henriharmaala1-source/Assembly-grapher/airframe/README.md

# Kipinä 485: twin-boom micro FPV pusher

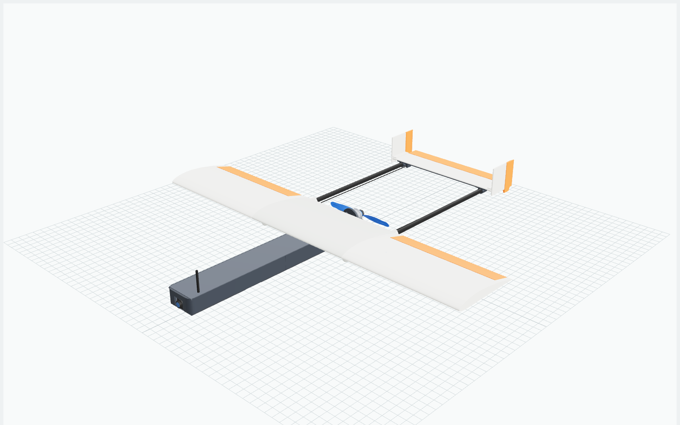
[picture p1: airframe/preview/hero.png]
Kipinä 485


A 3D-printed twin-boom pusher. A short pod carries the FPV camera in its nose,
the flight controller, battery and ESC behind it, and the motor on its back
wall. Two plain round carbon tubes, 140 mm apart, run from sockets under the
wing centre back to an H-tail, and the 4" prop turns between them. The camera
therefore has a clear view ahead, with no prop disc in front of it. It is a
hobby FPV airframe only. There is no payload bay or release mechanism, just a
pod for the flight battery and the FPV electronics.

The plane started as a Molniya-style twin-tube tractor, with the two tubes
40 mm apart under the pod and the motor on the nose. That put the camera
behind the prop. The tubes are now spread into tail booms far enough apart for
the prop to turn between them. See [Why a pusher](#why-a-pusher).

Four **SG90** servos give full three-axis control: one per aileron, one for the
elevator and one for the twin rudders. The brief was "as small as possible",
so the size comes from a sweep, not a guess. See [Why 485 mm](#why-485-mm).

| | |
|---|---|
| Wingspan | 485 mm, chord 97 mm, NACA 4412 at 2° incidence |
| Length | 504 mm (nose to elevator trailing edge) |
| Tail booms | 2 × carbon tube 6×5 mm, 298 mm long, 140 mm apart |
| Prop clearance | 16.2 mm from the blade tips to each boom, 10.7 mm to each pushrod |
| Controls | ailerons, elevator, twin rudders: 4 × SG90 |
| Flight controller, ESC | Matek F405-WMN (12 outputs, 2–6S), Hobbywing XRotor Micro 30A (2–4S) |
| All-up weight | ~223 g (printed parts ~98 g) |
| Wing loading | 47 g/dm² |
| Stall / cruise | ~8.9 / ~13 m/s |
| Top speed | ~19 m/s (69 km/h) level, estimated; prop pitch speed 86 km/h |
| Endurance | ~10 min on 2S 450 mAh (rough estimate) |
| CG | 199.6 mm behind the nose = 27.2 mm behind the wing LE (28 % chord) |
| Static margin | ~13 % (neutral point at ~41 % chord) |
| Printer | every part fits a Bambu Lab A1 mini (180 × 180 × 180 mm) |

All numbers are first-order estimates from `design.py` and the CAD volumes.
Nothing here has been flight-tested yet. [REPORT.md](REPORT.md) has the full
mass breakdown, the print list, the sizing check and the interference check,
regenerated on every build.

| Prop between the booms | Pod, cut open |
|---|---|
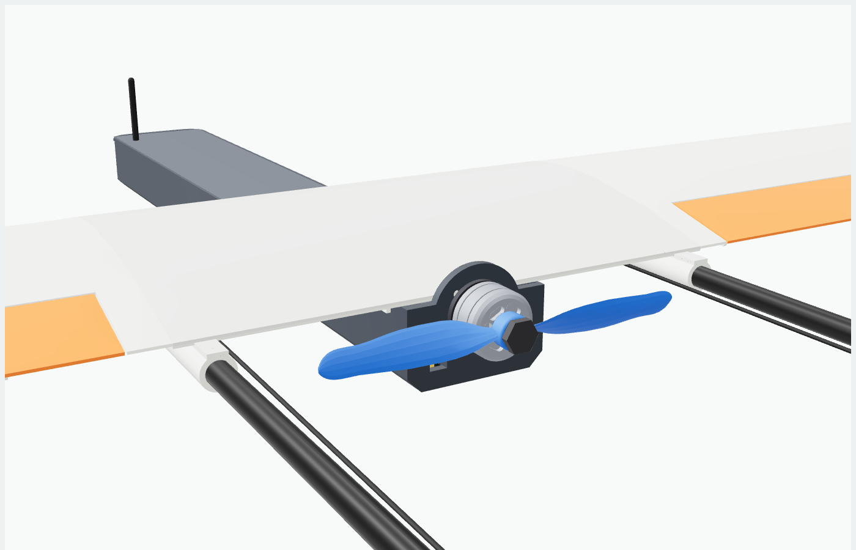
[picture p2: airframe/preview/prop.png]
Prop
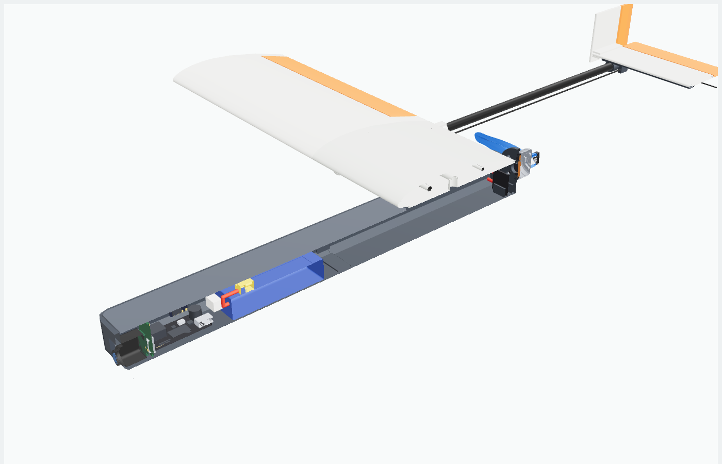
[picture p3: airframe/preview/pod.png]
Pod
|  |  |

| Rudder linkage, from below | Rounded nose with the camera |
|---|---|
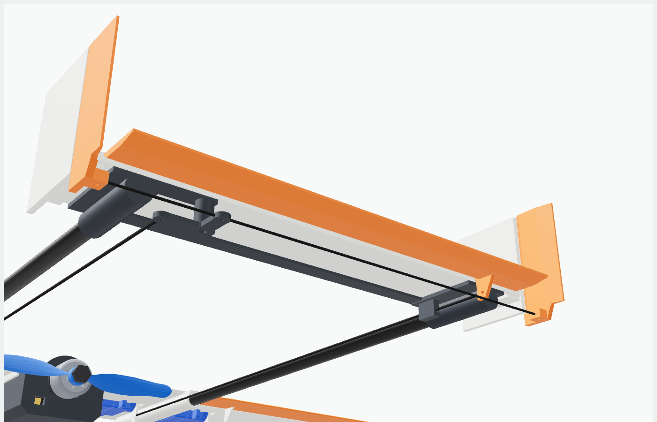
[picture p4: airframe/preview/tail.png]
Tail
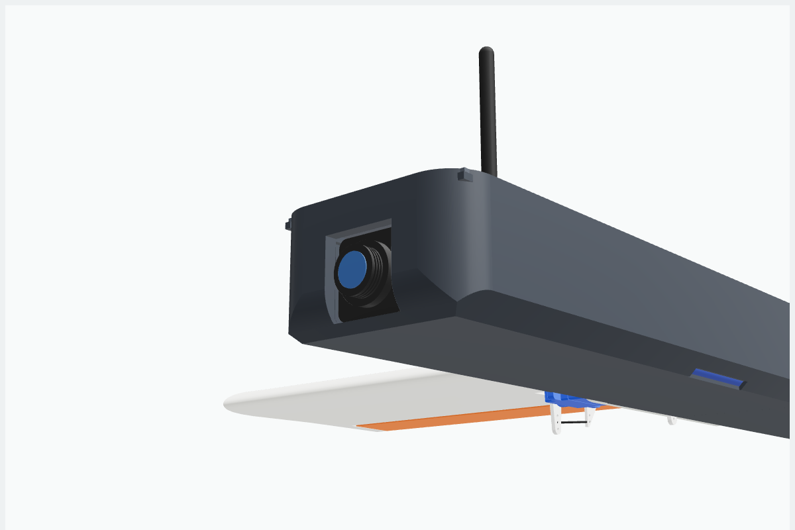
[picture p5: airframe/preview/nose.png]
Nose
|  |  |

| Front bay: camera, VTX, F405-WMN, receiver | ESC by the back wall |
|---|---|
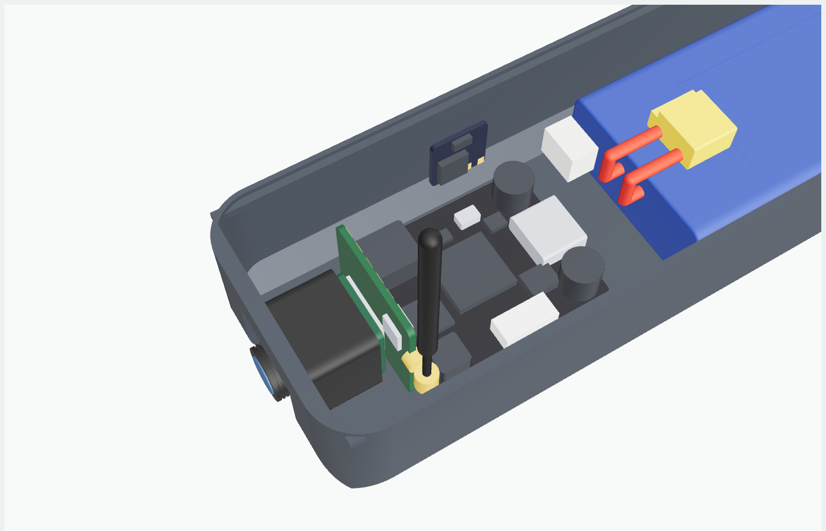
[picture p6: airframe/preview/bay.png]
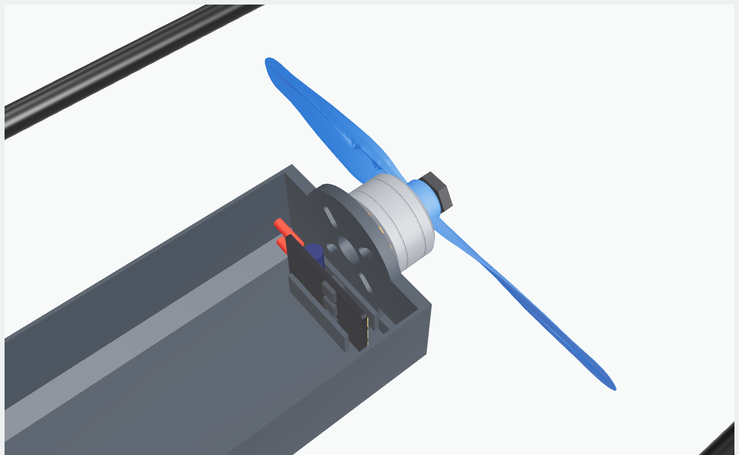
[picture p7: airframe/preview/esc.png]
|  |  |

| Aileron SG90 under the wing | |
|---|---|
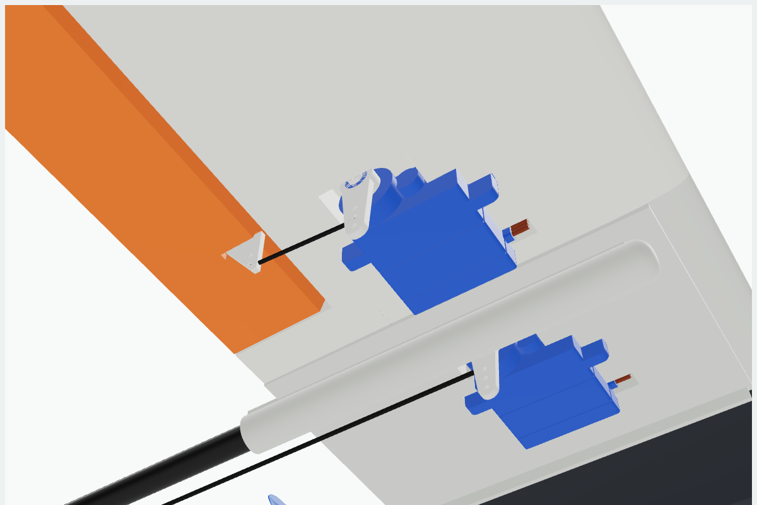
[picture p8: airframe/preview/servo.png]
Aileron servo
|  | |

## Why a pusher

In the tractor layout the camera sat 18 mm from the prop axis, well inside
the 101.6 mm prop disc, so a blade crossed the lens about 18 % of the time.
Moving the prop behind the pod fixes that. The catch is that the prop has to
turn somewhere: the old tubes were 40 mm apart, and a 4" prop is 101.6 mm
across.

So the tubes became tail booms:

- **Booms.** The booms start in two sockets under the wing centre and are
  140 mm apart (±70 mm). The blade tips pass 16.2 mm inside each boom.
- **Motor.** It is turned round and screwed to the pod's back wall, just
  behind the wing's trailing edge. The prop turns 18 mm behind the wing,
  on the boom centre-line.
- **Pushrods.** They run along the inside of the booms, 62 mm from the
  centre-line, 10.7 mm outside the blade tips. Tape them to the booms
  so they cannot bow into the disc.
- **Servos.** The elevator and rudder servos moved out of the pod into the
  wing centre, one on each side of the pod, with their horns on the pushrod
  lines.
- **Pod.** The pod no longer carries the tubes. It hangs under the wing
  centre, with the camera in its nose. The CG still has to sit at 28 % of the
  chord, and the motor now sits behind the wing, so the pod needs about
  170 mm of nose ahead of the wing. That makes it about 272 mm long,
  which is too long for the 180 mm bed. It prints in two halves joined by an
  8 mm tongue.

The cost is weight and span. The pusher is about 17 g heavier than
the tractor was (a longer pod, the boom sockets, a wider tail mount and longer
booms), and to stay under the 9 m/s stall limit the wing grew from 465 mm to
485 mm.

## Build process and DFMA

`process.py` turns the model into a **bill of process** ([BOP.md](BOP.md)) and a
**DFMA analysis** ([DFMA.md](DFMA.md)). The same data drives the viewer's
**Assemble** button and the video [preview/assembly.mp4](preview/assembly.mp4).

- **30 operations** in five groups:
  - 5 print jobs on the A1 mini;
  - 7 prep steps (cut carbon, make linkages, finish prints);
  - 16 assembly steps;
  - 2 setup steps.

  Each has its predecessors, tools, consumables and a time.
- **Print times are real slicer output.** They come from PrusaSlicer 2.7 on an
  A1-mini-like profile (`tools/a1mini.ini`): 8 h 38 min in total and
  97 g of filament. The wing centre takes 2 h 30 min and each wing panel
  1 h 24 min, because LW-PLA prints slowly.
- **Hand times are estimates.** They use Boothroyd–Dewhurst handling and
  insertion values plus shop times for gluing, soldering, taping and bending.
  Hands-on time is 1 h 46 min, including 32 min of INAV setup. Soldering is
  the biggest single item: the F405-WMN's servo, ESC and power connections are
  pads, so a full wiring pass is about 32 joints.
- **Schedule.** One builder works while one printer runs. That gives a lead
  time of **10 h 09 min**, and the critical path runs through the five
  prints in series.

| DFMA | |
|---|---|
| Parts and fasteners | 54 (theoretical minimum 26) |
| Manual assembly time | 42 min (7 min handling and insertion) |
| Design efficiency | 3% (19% counting handling and insertion only) |
| With the redesign suggestions | 46 parts, 32 min, 4% |
| Printability | no part needs support |
| Cost | about 170 EUR per airframe; the whole printed airframe is only 97 g of filament (about 4 EUR), but a first build also buys an LW-PLA and a PETG spool (about 65 EUR), so about 235 EUR up front |

Most of the assembly time goes into joints (solder, epoxy, CA, tape), not into
handling parts. The suggestions that save the most are:

- an FC with a built-in receiver;
- a camera with an integrated VTX;
- printed hinges;
- printing the tail as one piece.

DFMA.md lists each one with its trade-off.

## Why 485 mm

A printed plane does not scale down evenly. The electronics weigh the same at
any size, and a printed skin can't get thinner than one nozzle line. So as the
span drops, the wing loading and the stall speed climb.

`design.py` rebuilds the layout at each span, re-balances it (tail volumes, CG,
battery station) and estimates the weight. A span passes when:

- the stall speed is at most 9 m/s at CLmax 0.95, which keeps hand launches and
  FPV landings comfortable, and
- an SG90's 32.3 mm mounting tabs fit between the two wing spars. That needs a
  chord of at least about 80 mm.

| span | AUW | stall |
|---|---|---|
| 300 mm | 172 g | 12.7 m/s |
| 380 mm | 191 g | 10.6 m/s |
| 440 mm | 207 g | 9.5 m/s |
| 460 mm | 213 g | 9.2 m/s |
| **480 mm** | **219 g** (estimate) | **8.95 m/s (first to pass the quick estimate)** |
| 480 mm | 221 g (CAD) | 9.00 m/s (exactly on the limit) |
| **485 mm** | **223 g (CAD)** | **8.94 m/s (built)** |

The quick estimate is a couple of grams light. With the CAD weights, which
include the printed detail and the wiring, 480 mm lands exactly on the limit,
so the build takes the next 5 mm step, which keeps a little margin.

Yaw control costs about 11 g: a fourth SG90, two printed rudders and the
linkage. Without rudders (`Params.rudders = False`) the sweep lands at
460 mm. The four SG90s are the heaviest part of the kit after the
battery; a 4 g servo such as the Emax ES9051 would bring the span down, but it
needs new pockets. Change `Kit` and `Params` in `design.py` and rerun to try
other parts.

## Yaw control

Each fin carries a rudder aft of the elevator hinge line, about a third of
the fin area, hinged with tape on the outboard face.

- **Servo.** The rudder SG90 lies on its side in the wing centre, left of the
  pod, with its shaft pointing left. Its horn hangs below the wing, 62 mm left
  of the centre-line.
- **Pushrod.** A 1 mm carbon rod runs from the servo horn back along the
  inside of the left boom to the tail.
- **Bellcrank.** A printed 90° bellcrank pivots on an M2 screw under the tail
  mount, 49 mm left of the centre-line. The pushrod drives its outer arm, and
  its rear arm moves side to side.
- **Joiners.** Two 0.8 mm steel wires run from the bellcrank's rear arm to a
  horn tab under each rudder, below the fins and the tail mount, so both
  rudders always move together.

The elevator servo is the mirror image on the right. Its pushrod runs along
the inside of the right boom, through a guide on the tail mount, to the
printed elevator horn.

## Parts

### Printed (`stl/`, already in print orientation)

| file | material | on the bed, mm | orientation |
|---|---|---|---|
| `pod_front.stl` | PLA/PETG | 138 × 41 × 22 | Upright, open top up. 2 walls, 15 % infill |
| `pod_rear.stl` | PLA/PETG | 142 × 41 × 31 | Upright, open top up, tongue forward. 2 walls, 15 % infill |
| `lid.stl` | PLA/PETG | 177 × 39 × 1 | Flat |
| `wing_centre.stl` | LW-PLA | 105 × 22 × 155 | On its side. 0.5 mm walls, 5 % infill |
| `wing_R.stl`, `wing_L.stl` | LW-PLA | 97 × 12 × 165 | Standing on the root rib, brim. 1 wall, 0 % infill |
| `aileron_R.stl`, `aileron_L.stl` | LW-PLA | 24 × 148 × 7 | Flat. 1 wall, 0 % infill |
| `tail_mount.stl` | PLA/PETG | 31 × 156 × 9 | Pads face down |
| `stab.stl` | LW-PLA | 31 × 174 × 2 | Flat. 2 top / 2 bottom layers, 15 % infill |
| `elevator.stl` | LW-PLA | 17 × 163 × 10 | Top face down, horn up |
| `fin_R.stl`, `fin_L.stl` | LW-PLA | 30 × 39 × 9 | Outer face down |
| `rudder_R.stl`, `rudder_L.stl` | PLA/PETG | 17 × 44 × 6 | Outer face down, wire flange up |
| `bellcrank.stl` | PLA/PETG | 16 × 19 × 2 | Flat, solid |

Every wing piece is a printed NACA 4412 section: a closed one-wall LW-PLA shell
with the spar holes, servo pockets and hinge gap built in.

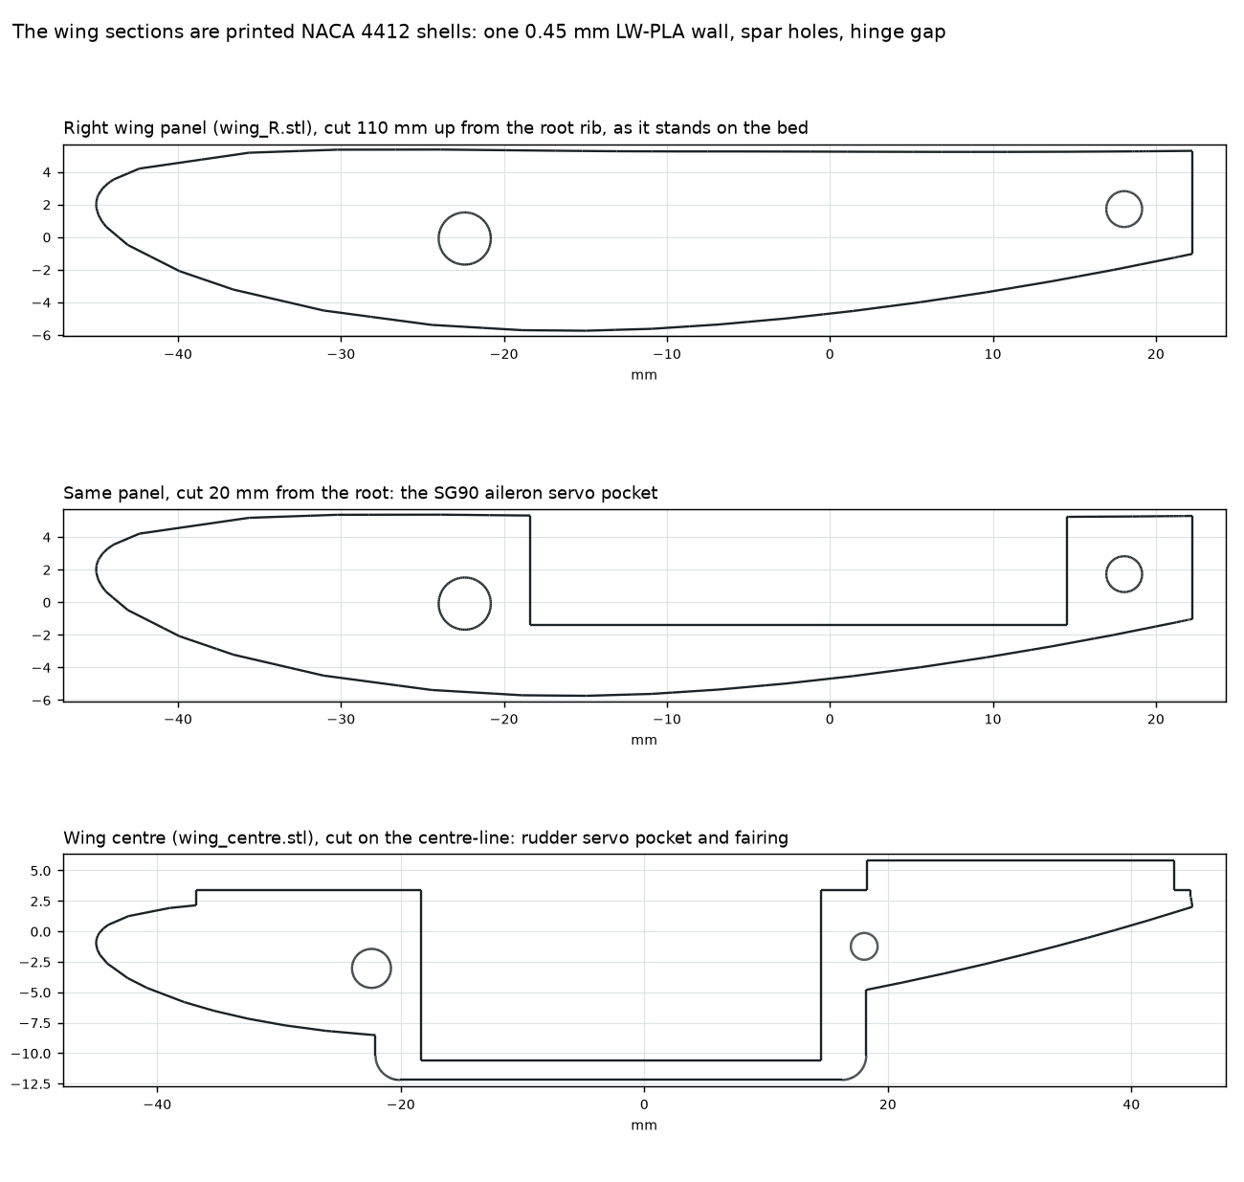
[picture p9: airframe/preview/wing_sections.png]
Wing sections cut from the STLs


The masses assume LW-PLA foamed to about 0.75 g/cm³. Plain PLA works, but it
adds roughly 25 g to the wing and tail. The pod, rudders and bellcrank are
plain PLA or PETG because they take the motor and linkage loads.

### Printing on a Bambu Lab A1 mini

Everything fits the A1 mini's 180 × 180 × 180 mm volume. `Params.bed` holds
the build volume, and the model adapts to it:

- the stabiliser's span is capped at the bed width, with its chord widened to
  keep the same area;
- the pod is split into two halves, each shorter than the bed.

Every build checks each part against the volume (see the print list in
REPORT.md).

Five plates cover the whole airframe:

| plate | parts | material |
|---|---|---|
| 1 | both pod halves, lid, tail mount, both rudders, bellcrank | PETG or PLA |
| 2 | wing centre, both fins | LW-PLA |
| 3 | stabiliser, elevator, both ailerons | LW-PLA |
| 4 | right wing panel | LW-PLA |
| 5 | left wing panel | LW-PLA |

Plates 1, 2 and 3 mix different wall and infill settings, so set them per
object in Bambu Studio.

- **Tall wing panels.** The A1 mini moves its bed front to back, which shakes
  tall, thin parts. Turn each panel so its chord runs front to back, add an
  8–10 mm brim, and print at reduced speed (Silent mode).
- **LW-PLA** is not a Bambu filament, so make a custom filament profile. A
  starting point: about 240 °C with the flow at 55–60 %, little or no
  retraction. Print a test cube, weigh it and adjust the flow until the density
  is near 0.75 g/cm³. The hotend reaches these temperatures without upgrades.
- **Plain PLA** prints with the stock profile if you want to skip LW-PLA for a
  first test airframe.

### Electronics

Everything below is modelled in `cad/airframe.step` (the `electronics` and
`hardware` groups) and in the CG calculation. The pod bays are sized for these
dimensions, so check sizes before substituting parts.

| part | spec | requirements | g |
|---|---|---|---|
| Servos | 4 × Tower Pro SG90: 4.8–6 V, ~1.8 kg·cm, 0.1 s/60° | 22.8 × 12.2 × 22.7 mm body, 32.3 mm across the tabs | 36 |
| Motor | 1404 outrunner, 3000–3800 KV | Rated for 2S; ≥ 223 g static thrust on a 4" prop (1:1). 9×9, 12 or 16 mm mounting | 9 |
| Prop | 4" two-blade, 2.4–2.5" pitch (Gemfan 4024 class) | Hub to match the motor shaft; see the pusher note below | 2 |
| ESC | **Hobbywing XRotor Micro 30A**: BLHeli_S, 2–4S, 30 A continuous / 40 A burst, no BEC | 23.8 × 14.5 × 5.8 mm, 20 AWG input wires, solder tabs for the motor. Full-throttle draw is about 8 A, so it runs at about a quarter of its rating | 6 |
| Flight controller | **Matek F405-WMN**, INAV or ArduPilot | 31 × 26 mm on four 2 mm holes, 22 × 22 mm pattern; the vendor quotes 16.5 mm height, which the pod reserves. 2–6S input, 12 outputs, 5 A servo BEC (5 or 6 V), 1.5 A logic BEC, 132 A current sensor, analog OSD, 5 UARTs, barometer, USB-C. Battery, servo and ESC connections are pads on the underside | 10 |
| Receiver | ExpressLRS 2.4 GHz nano | CRSF to an FC UART | 1.5 |
| Camera | analog nano, 14 mm (Caddx Ant / RunCam Nano class) | 14 × 14 mm body, ≤ 12 mm deep | 3.3 |
| VTX | 5.8 GHz analog, 25–200 mW | ≤ 20 × 19 × 3 mm, MMCX antenna socket; the F405-WMN has no 9 V supply, so it runs from the switched battery output (2S) or the 5 V BEC. Whip antenna coax through the lid | 4.2 |
| Battery | 2S 450 mAh LiPo, ≥ 30C, XT30 | ≤ 58 × 31 × 13 mm | 27 |

**Pusher prop.** The motor faces backwards, so the prop must still push air
aft. Either mount a normal prop with its lettered face towards the nose and
reverse the motor direction in the ESC (or swap two motor wires), or use the
reverse-rotation version of the same prop. Check on the bench, without the
prop first and then with it held down, that the air blows backwards. Use a
nyloc prop nut: a reversed motor can loosen a self-tightening one.

Some electrical numbers from the model (`design.py`), all first-order:

- **Cruise:** about 2.1 A, which gives about 10 minutes on the
  450 mAh pack with 20 % held in reserve.
- **Full throttle:** about 8 A at 1:1 thrust. That is about 18C from the pack
  and a quarter of the ESC's 30 A rating.
- **Servo supply:** four SG90s can together draw well over an amp when they
  stall or buzz. The F405-WMN's 5 A servo supply covers that; leave it at 5 V.

GPS is not included. An M10 module adds about 5 g, which raises the stall
speed by about 0.1 m/s, just past the sizing limit. That is fine once you know
the plane; otherwise build the wing 10 mm wider.

### Electronics that carry over to a bigger wing

The F405-WMN and the XRotor Micro 30A were picked so the same boards can move
to a larger plane later:

| | in this plane | in a bigger wing |
|---|---|---|
| Flight controller | motor + 4 servos, 2S | 12 outputs, 2–6S input, 5 A servo supply: room for 5 or 6 small servos, or 3 or 4 larger ones, plus GPS and a compass on the spare UARTs |
| ESC | about 8 A on 2S | 30 A continuous on 2–4S: fine for a motor that draws up to about 25 A |
| Limit | | The ESC stops at 4S. A 6S plane needs a bigger ESC, and the FC can stay |

### How detailed the bought-part models are

`components.py` builds every bought part as a recognisable solid, in its own
colour group so the viewer and the STEP file can show and move them
separately. The outer sizes come from datasheets or retailer listings. The
detail inside those envelopes is representative, not a copy of a drawing.

- **SG90:** case seams, a label recess, rounded mounting tabs with keyhole
  slots, a lead grommet with three wires, and a horn with a rounded tip and a
  centre screw.
- **Motor 1404:** a black base with the 9 × 9 mm screw holes, a copper 12-tooth
  stator visible in the gap, a chamfered bell with six vent slots and two
  grooves, the shaft and a hex prop nut.
- **Prop 4 × 2.5:** twisted, cambered blades lofted through ten stations. The
  pitch angle follows the local radius and the roots are narrow, so the blades
  clear the motor bell. In the pusher it is the mirror image of the tractor
  prop.
- **Camera:** rounded housing, threaded lens barrel with a glass disc, and a
  PCB with three pads.
- **VTX:** a 20 × 19 mm card with a shield on each side, a row of pads and an
  MMCX socket. The whip's gold plug clips on the socket and its coax passes
  through a 2 mm hole in the lid.
- **Matek F405-WMN:** the F405, IMU, barometer, OSD chip and flash, two BEC
  inductors, two capacitors, a USB-C socket, the DFU button, a JST-SH port and
  the pads on the underside. The vendor's 16.5 mm height is kept as a clearance
  envelope for the interference check; the modelled parts are lower.
- **XRotor Micro 30A:** MOSFETs on both sides, a low-profile capacitor lying
  across the top, battery and motor pads and two short red and black input
  wires. The card stands on edge between two printed ribs.
- **Battery:** a label recess, red and black leads that fold over the top to a
  keyed XT30 with pin holes, and a JST-XH balance plug.

### Also needed

| item | spec | g |
|---|---|---|
| Tail booms | 2 × carbon tube 6×5 mm, cut to 298 mm (6×0.5 aluminium also fits, heavier) | 8.0 |
| Wing spars | carbon rod 3 mm and 2 mm, 475 mm each | 7.5 |
| Pushrods | 2 × 1 mm carbon rod (~265 mm) with wire Z-bend ends: elevator and rudder | 1 |
| Wire | 0.8 mm steel: 2 aileron links, 2 rudder joiners | ~1 |
| Small parts | 2 micro control horns, M2 screws (4 for the motor, 4 for the FC, one for the bellcrank), hinge tape, 10 mm velcro strap | ~2 |

## Assembly

1. **Check the fits.** Boom holes are 6.2 mm and spar holes 3.2/2.2 mm for
   glued joints. Ream any tight hole with a drill bit by hand.
2. **Glue the pod halves.** Slide the rear half's U-shaped tongue 8 mm into
   the front half, check that the floor and top edges line up, and glue with
   CA.
3. **Fit out the pod.**
   - Screw the motor to the back wall with M2 screws from inside the pod. The
     slots take 9×9 mm, 12 mm and 16 mm patterns. The motor wires go straight
     through the slot beside the shaft, so the stock wire length is enough.
   - Glue the camera behind the window in the nose and stand the VTX board
     right behind it. The whip antenna goes up through the hole in the lid.
   - Solder the FC's wires first: its battery, servo and ESC connections are
     pads on the underside. Then screw it to the four posts (22 × 22 mm hole
     pattern, M2 self-tapping screws) with its long edge along the pod. Stick
     the receiver to the right wall, about 3 mm above the floor so it clears
     the belly chamfer.
   - Drop the ESC into the two ribs in front of the back wall, on edge across
     the pod, with its motor tabs to the left and its battery wires to the
     right.
4. **Fit the elevator and rudder SG90s** in the wing centre before it goes on
   the pod.
   - Press each one into its pocket from below: tabs between the spars, shaft
     pointing outboard, the elevator servo on the right and the rudder servo
     on the left.
   - Point each horn straight down, below the wing. The horns are used full
     length; hook the pushrod into the hole about 8 mm from the shaft, which
     keeps the pushrod level with the booms.
5. **Join the frame.** Glue the pod under the wing centre between the two
   locating rails. Push the booms into their sockets from behind until they
   bottom out, and glue everything with epoxy or thick CA.
6. **Build the wing.**
   - Slide the 3 mm and 2 mm rods through the centre section and glue both
     panels on.
   - Each aileron SG90 lies on its side in the pocket under its panel: tabs
     between the spars, shaft pointing at the tip, horn hanging down. About
     3 mm of the servo stands proud of the lower surface.
   - All servo leads run through the wire channel and down into the pod.
7. **Hinge and link the ailerons.**
   - Tape the hinge along the top surface. The bevel under the hinge line gives
     about 25° of up travel.
   - Glue a micro control horn into the slot under each aileron.
   - Link it to the servo horn (11.5 mm hole) with 0.8 mm Z-bend wire.
8. **Build the tail.**
   - Glue the stabiliser onto the tail mount and push the fins' jaws onto the
     stabiliser tips.
   - Hinge the elevator with tape on top.
   - Hinge each rudder to the back of its fin with tape on the outboard face.
     The horn tab goes at the bottom.
   - Screw the bellcrank loosely under the tail mount with an M2 screw, so it
     turns freely.
   - Push the tail mount onto the boom ends. Sight from behind to get it square
     to the wing, then glue.
9. **Fit the pushrods.**
   - Elevator: from the right servo horn, along the inside of the right boom
     and through the tail mount guide, to the printed elevator horn.
   - Rudder: from the left servo horn, along the inside of the left boom, to
     the bellcrank's outer arm.
   - Tape each pushrod loosely to its boom in two places, as a guide. They
     pass only 10.7 mm outside the prop disc and must not bow into it.
   - Bend both joiner wires with an L at each end. Drop one end into the
     bellcrank's rear arm and the other into the flange under each rudder, and
     adjust them so both rudders sit straight with the servo centred.
10. **Balance.** Strap the battery through the floor slots and slide it until
    the plane balances 27.2 mm behind the wing LE (199.6 mm from the nose).
    The nominal battery centre is 91 mm from the nose, and the travel is
    83–99 mm. The XT30 folds back over the top of the pack.

The hatch lid sits flush on two ledges and runs from the nose to just under
the wing's leading edge. Hook its back edge under the wing, press the front
down, and hold it with tape or two 3 mm magnets.

## First flights

- **Throws:** ailerons ±12°, elevator ±15°, rudders ±20° (set with the servo
  endpoints), 30 % expo.
- **INAV setup:** use the Airplane mixer with a rudder output, and fly angle
  mode for the first launch. Set the motor direction as described in the
  pusher note above.
- **Launch:** the prop is behind your hand. Hold the pod ahead of the wing
  from below, keep your fingers well forward of the trailing edge, and throw
  firmly and level at about 70 % throttle. A launch glove is a good idea.
- **Landing:** the prop disc reaches about 33 mm below the pod's belly. Cut the
  throttle before touchdown and land on grass, or use a prop saver.
- **Rudder:** use it to coordinate turns and hold heading in crosswinds. Check
  the rudder direction on the bench, and reverse the servo in INAV if needed.

## Regenerating

```sh
pip install cadquery trimesh
python3 airframe/design.py      # sizing sweep and layout, no CAD needed
python3 airframe/build.py       # STLs, STEP, GLB, REPORT.md, sizing + interference checks
python3 airframe/build.py --variant optimized   # the optimized variant in variants/optimized/ (--step for its STEP)
python3 airframe/build.py --variant single-boom # the single-boom variant in variants/single-boom/
python3 aero/extreme.py                         # the extreme-aero design study (aero/study/EXTREME.md)
python3 airframe/build.py --variant extreme     # what it picks, in variants/extreme/
python3 airframe/mini.py                        # the 1:2 desk model of the single boom, in variants/single-boom-mini/

python3 airframe/process.py     # BOP.md, DFMA.md, viewer/process.json (slices with prusa-slicer if installed)
python3 airframe/process.py --variant single-boom   # the same for variants/single-boom/
python3 airframe/tools/make_single_viewer.py         # variants/single-boom/viewer/index.html from the twin's page
python3 airframe/tools/make_single_viewer.py --variant extreme   # and variants/extreme/viewer/index.html

# optional: PNG previews and the assembly video from the three.js viewer (headless Chromium)
npm install three@0.169.0 playwright
node airframe/tools/render.mjs
node airframe/tools/render.mjs --video --ffmpeg /path/to/ffmpeg
node airframe/tools/render.mjs --variant single-boom [--video]   # into variants/single-boom/preview/
node airframe/tools/render.mjs --variant extreme                  # into variants/extreme/preview/
node airframe/tools/render.mjs --variant single-boom-mini         # the desk model's previews
node airframe/tools/shoot-variants.mjs   # the comparison page's figures (after aero/variants.py)
```

The code is split into four files:

- `design.py` holds every dimension (`Params`), the electronics (`Kit`) and the
  SG90 datasheet dimensions (`Servo`).
- `build.py` makes the printed parts.
- `components.py` models the bought parts in detail (see above).
- `geom.py` holds the shared solid helpers.

Each build:

- moves the wing along the pod until the battery balances the plane in the
  middle of its travel, using the CAD masses,
- checks the stall speed with the CAD weight,
- checks every bought part against every other body for overlaps, and
- checks every printed part against the printer's build volume.

- `cad/airframe.step` is the full assembly in flight position, in three groups:
  `printed`, `hardware` and `electronics`. Open it in Fusion, FreeCAD or
  SolidWorks.
- `viewer/index.html` is an interactive 3D viewer. Serve the `viewer/` folder
  over HTTP, for example with `npx http-server airframe/viewer`.

The coordinates are millimetres. x runs aft from the pod's nose, y towards the
right wing tip and z up, with z = 0 on the boom centre-line.

## Drag

[`aero/`](../aero/README.md) has a simple air-resistance optimizer that runs on
this design (`python3 aero/optimize.py airframe`). With the span held at the
brief's smallest passing size, the rest of the sizing is pinned by the stall
limit, the SG90 tabs and the bed. It finds about 20 % less drag from small
changes to the details: a rounded top front edge on the pod, sleeves on the
rudder joiners, horn fairings, a tapered pod rear and a laid-back antenna.
See [aero/REPORT_airframe.md](../aero/REPORT_airframe.md).

The efficiency study (`python3 aero/efficiency.py`) goes further on the wing.
It reshapes the NACA 4412 with NeuralFoil for the plane's own lift and
Reynolds numbers, keeping the spars, the servo, the printable trailing edge
and the stall. That cuts the wing's profile drag by about 20 % at cruise.
Together with the detail changes, the flight time at 13 m/s rises from 13.3
to 16.9 min at the same weight. The charts are in
[aero/study/index.html](../aero/study/index.html) and the airfoil in
[aero/study/kipina-opt.dat](../aero/study/kipina-opt.dat).

## The optimized variant

`python3 airframe/build.py --variant optimized` builds the plane with the
study's airfoil and every detail change, into `variants/optimized/` (STLs,
GLB, REPORT.md). Each change is drawn as a part you can print:

| Change | In the CAD | Weight |
|---|---|---|
| Airfoil | kipina-opt (11.1 % thick) instead of the NACA 4412 (12.2 %). The spars, servos and hinge still fit | −1.1 g |
| Hood | an 8 mm radius on the pod's top front edge, over the camera. The lid starts behind it | −0.3 g |
| Tapered pod tail | the last 30 mm step in at 12° on the sides and 9° under the belly (the motor boss sets the belly). The ESC bay moves 30 mm forward | −1.1 g |
| Antenna | the VTX whip bent back 60° where it leaves the lid | 0 |
| Servo fairings | single-wall blisters over the four servo horns (cut short) and the aileron servo bumps. They print on the bed and glue on | +3.8 g |
| Joiner sleeves | streamlined sleeves glued on the two rudder joiner wires under the tail. They slide with the wire | +1.2 g |

The optimized plane weighs 225.8 g against 223.2 g. The ESC moves forward
and the fairings sit behind the centre of gravity, so the balance puts the
wing 3 mm further aft. The build's interference check passes for both.

`python3 aero/variants.py` flies the planes at their CAD weights. The 2.6 g
cost 0.06 W at cruise, against the 2.56 W the aerodynamics save, and the
flight time at 13 m/s goes from 13.3 to 16.8 min. The stall stays under the
9 m/s limit. The page [variants/index.html](variants/index.html) shows any
two of the three builds side by side, with each change highlighted, next to
the weight and flight charts. Serve `airframe/` over HTTP and open
`/variants/index.html`. The numbers are in
[variants/COMPARE.md](variants/COMPARE.md).

Each picture has the as-built plane on the left and the optimized one on the
right:

| Three-quarter view | Side view |
|---|---|
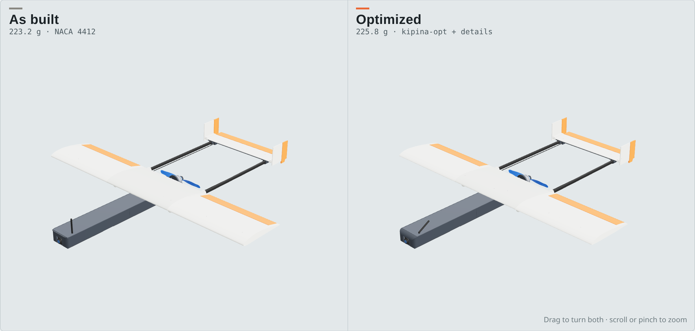
[picture p10: airframe/variants/figures/models.png]
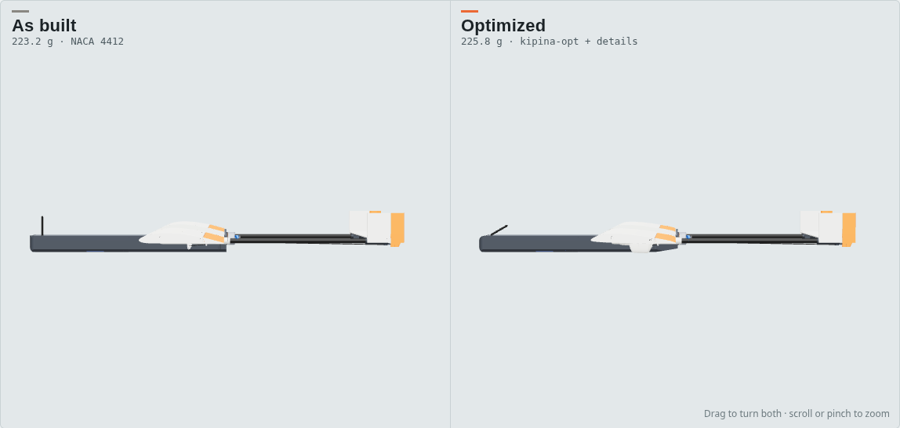
[picture p11: airframe/variants/figures/models-side.png]
Side view
|  |  |
| **Tapered pod tail** | **Servo fairings, from below** |
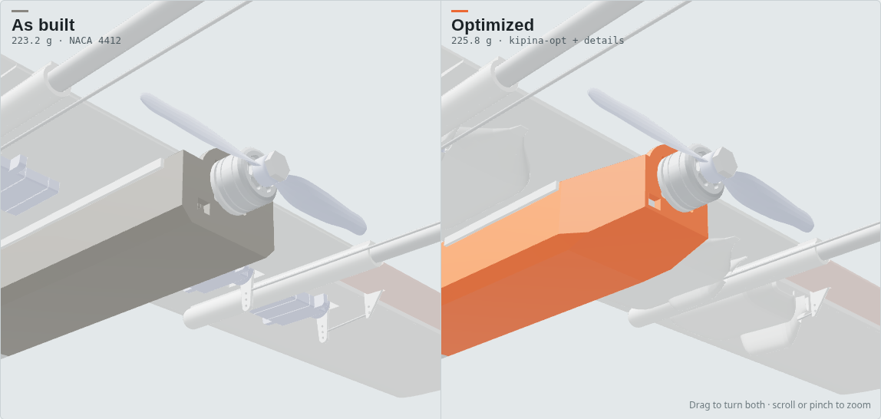
[picture p12: airframe/variants/figures/models-boattail.png]
Tapered tail
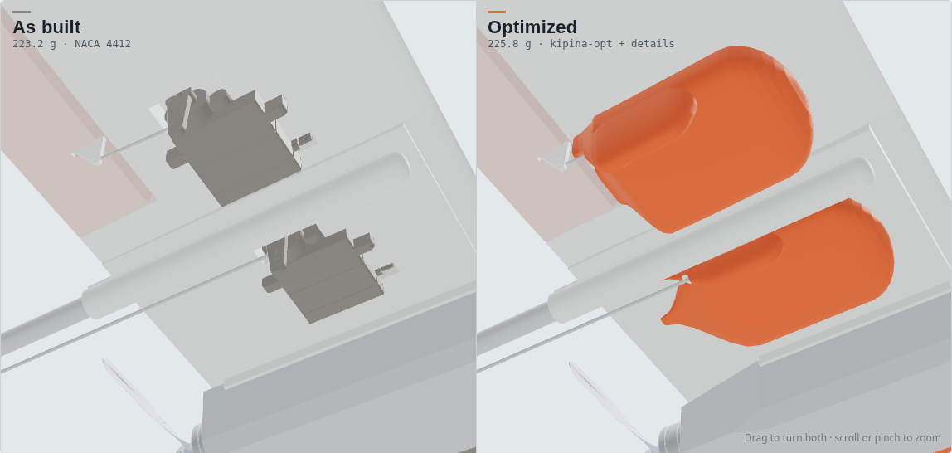
[picture p13: airframe/variants/figures/models-fairings.png]
Fairings
|  |  |

## The single-boom variant

`python3 airframe/build.py --variant single-boom` rebuilds the optimized plane
round one carbon tube, into `variants/single-boom/` (STLs, GLB, REPORT.md).
It keeps the optimized airfoil, the nose hood, the laid-back antenna and the
aileron servo fairings. Everything behind the battery changes:

| Change | In the CAD |
|---|---|
| One boom | a 10 x 9 mm roll-wrapped carbon tube, 320 mm long. It starts in the fuselage behind the servos and ends behind the tail. 79 mm of it sits in a socket along the fuselage's top |
| Fuselage | 38.4 mm wide, with a flat top and its top edges rounded to 8 mm. The section comes from `aero/section.py` (below). A 48 mm cone narrows the tail onto the boom; there is no blunt back wall |
| Lid | it wraps round the rounded edges. It covers the nose to the servo bay and is held by tape or two magnets |
| Servos | the elevator and rudder SG90s lie on their sides in the fuselage behind the battery, screwed to posts. Their pushrods run in PTFE sleeves inside the boom and leave it just ahead of the tail |
| Wing centre | no boom sockets and no servo pockets. It is 135 mm wide (the narrowest that still lets a panel stand on the bed); the panels are 10 mm longer each |
| Tail | one 79 mm fin with the area of both twin fins, in a socket on the tail mount. The stabiliser hangs on two wedge-nosed pylons, its top 11.7 mm under the boom's centre-line, so the elevator can swing 20 degrees up past the boom. No bellcrank, joiner wires or sleeves |
| Motor | on a printed cap at the boom's end, 3 mm behind the tail's trailing edge. A 16 degree cone runs from the boom up to the motor plate. The ESC lies flat under the boom's mouth and the motor wires run inside the boom |

The build's interference check passes, with every wire run modelled too (see [Wiring](#wiring)), and every part fits the A1 mini.

**The boom.** One tube carries the tail, the motor and the prop: 27 g on its
end, 246 mm from the socket. The aim was to keep the first bending mode near
the twin booms' (about 49 Hz with the tail alone) and far below the motor's
377 rev/s. The 10 x 9 mm tube does that for less weight than the two
booms it replaces (REPORT.md has the table):

| tube, mm | g | first bending mode | end bends in a 30 g landing |
|---|---|---|---|
| 8 x 7 | 5.9 | 32 Hz | 6.8 mm |
| **10 x 9** | **7.5** | **46 Hz** | **3.4 mm** |
| 10 x 8 | 14.1 | 59 Hz | 2.0 mm |
| 12 x 11 | 9.0 | 61 Hz | 1.9 mm |
| twin booms, 2 x 6 x 5 | 8.0 | about 49 Hz | |

Use roll-wrapped carbon. A pultruded tube is stiffer in bending, but weak in
twist (the fin and the prop's torque twist the boom) and it splits in a
crash. Running the tube on to the nose would add about 4 g and block the
battery and FC bays, so it stops behind the servos.

**The fuselage section.** `python3 aero/section.py` writes
[variants/single-boom/SECTION.md](variants/single-boom/SECTION.md). It finds the
smallest outline of each shape family that holds what goes inside: the
battery with its strap slots, the FC, both servos on their sides, the boom
socket and the ESC. Skin friction follows the perimeter:

| Outline | Perimeter | Frontal area | Flat top for the wing |
|---|---|---|---|
| Flat-topped box, top edges rounded | 114 mm | 8.7 cm² | 19 mm |
| Superellipse, n 4 | 120 mm (+6 %) | 10.7 cm² | 20 mm |
| Ellipse | 120 mm (+6 %) | 11.4 cm² | 7 mm |
| Circle | 122 mm (+8 %) | 11.9 cm² | 7 mm |

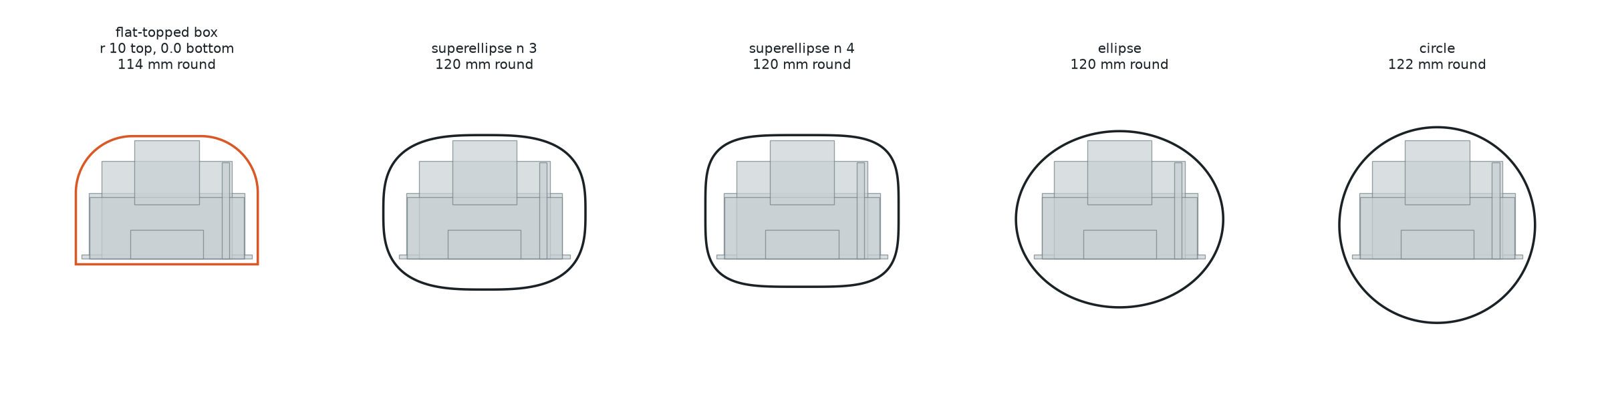
[picture p14: airframe/variants/single-boom/section.png]
Section outlines


Round is the worst fit, because the contents are flat boxes. The best
section rounds off the top corners, which the boom socket and the FC leave
empty. A square-cornered box would be as poor as round. The whole difference
is worth about 1 % of the plane's drag. The flat top also gives the wing a
seat without a saddle. In side view the tail cone matters more than the
section: it removes the blunt base.

**Weight.** 227.3 g against 225.8 g for the optimized twin-boom:

- **Heavier:** the fuselage and lid (+5.7 g), because they carry the boom socket and close their own top. The pushrods in their sleeves add 1.9 g, the motor wires the length of the boom 1.5 g, and the motor mount 2.5 g.
- **Lighter:** the wing centre (−5.5 g), the boom (−0.5 g) and the tail mount (−1.0 g). The fairings, sleeves, joiners and bellcrank that are no longer needed save another 3.8 g.

The motor moves 249 mm aft. The servos move 76 mm (elevator) and 41 mm
(rudder) forward. So the balance puts the wing 13 mm further aft than on the
optimized plane. The tail moves with
the wing, so the tail arm and the tail volumes stay the same.

**Flight.** From `aero/variants.py`, at 13 m/s:

| | Optimized | Single boom |
|---|---|---|
| Weight | 225.8 g | 227.3 g |
| Drag | 0.247 N | 0.232 N (−6.4 %) |
| Power | 9.53 W | 9.02 W |
| Flight time | 16.8 min | 17.7 min |
| Best glide ratio | 9.2 | 9.7 |
| Stall | 8.92 m/s | 8.95 m/s |

Three things account for nearly all the saving:

- no blunt pod base;
- one boom instead of two, with no boom sockets;
- no bellcrank, joiner wires or horns on the elevator and rudder servos.

The tail mount's pylons give some back. The extra 1.5 g costs 0.03 W.
The single boom could weigh 247 g before it needed the optimized plane's
power, but the 9 m/s stall limit stops it at 230 g first.

**What the numbers leave out:**
- **Launch:** the tail is no longer in the prop's slipstream, so the elevator
  and rudder have less grip at the start of a hand launch. Throw it a little
  harder and level.
- **Motor on the boom:** the motor and prop sit on the end of a 246 mm tube.
  Balance the prop well, and check the tail for buzz at full throttle.
- **Landing:** the prop reaches 33 mm below the belly, as on the twin booms,
  but at the tail it touches first in a nose-high landing. Cut the throttle,
  or use a folding prop.
- **Prop efficiency:** the prop works in cleaner air than behind the pod and
  wing. The model holds the efficiency the same, so this gain is not counted.

| Optimized (left) and single boom (right) | Side view |
|---|---|
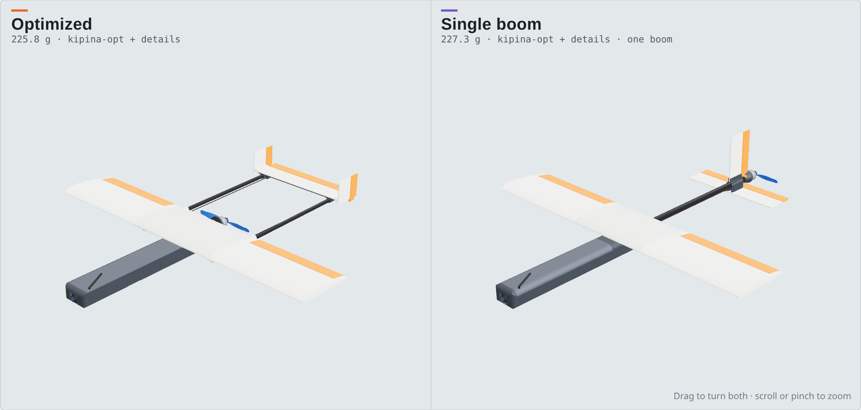
[picture p15: airframe/variants/figures/single-models.png]
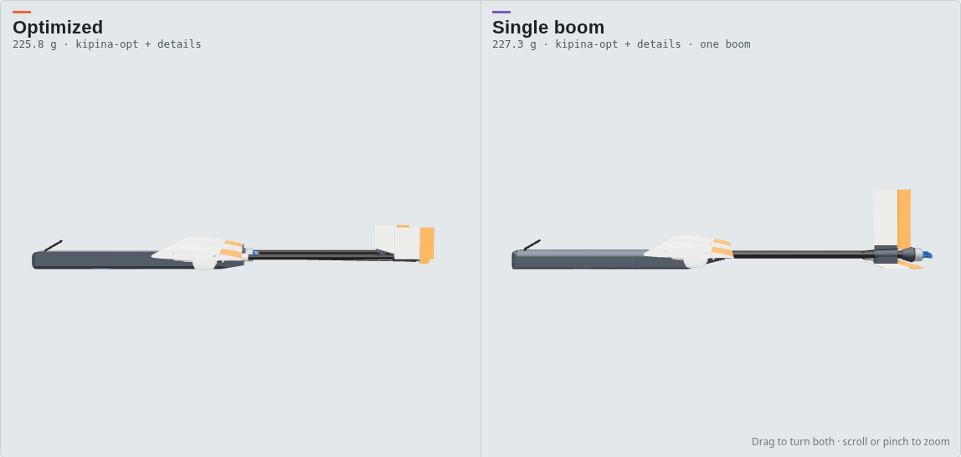
[picture p16: airframe/variants/figures/single-models-side.png]
Side view
|  |  |
| **Servos and pushrods inside, from above** | **The tail** |
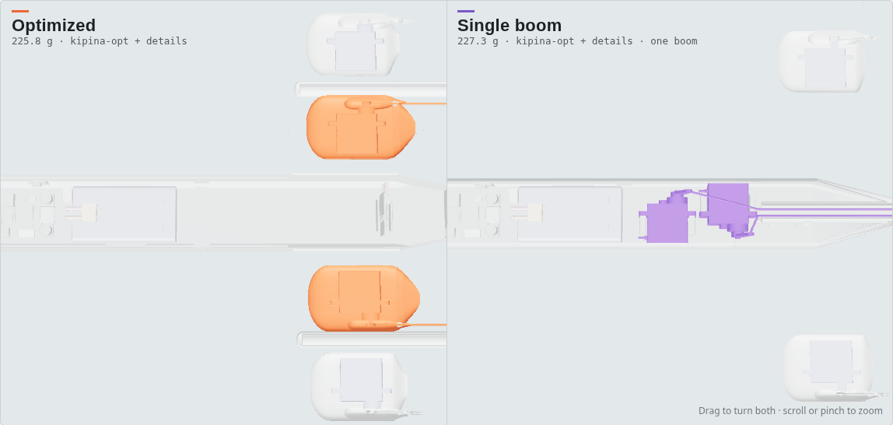
[picture p17: airframe/variants/figures/single-models-servos.png]
Servos
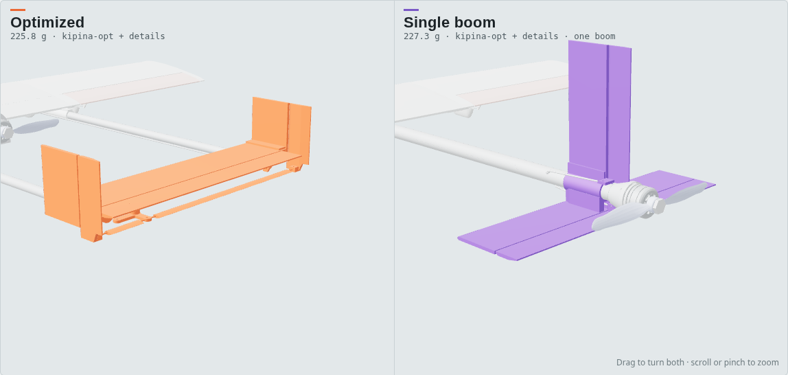
[picture p18: airframe/variants/figures/single-models-tail.png]
Tail
|  |  |

### Building the single boom

`python3 airframe/process.py --variant single-boom` writes its bill of process
([variants/single-boom/BOP.md](variants/single-boom/BOP.md)) and DFMA analysis
([variants/single-boom/DFMA.md](variants/single-boom/DFMA.md)). It slices every
part with the same PrusaSlicer profile as the twin. The operations are in
`process_single.py`. The viewer, [variants/single-boom/viewer/](variants/single-boom/viewer/index.html),
has the same **Assemble** button, and the video is
[variants/single-boom/preview/assembly.mp4](variants/single-boom/preview/assembly.mp4).

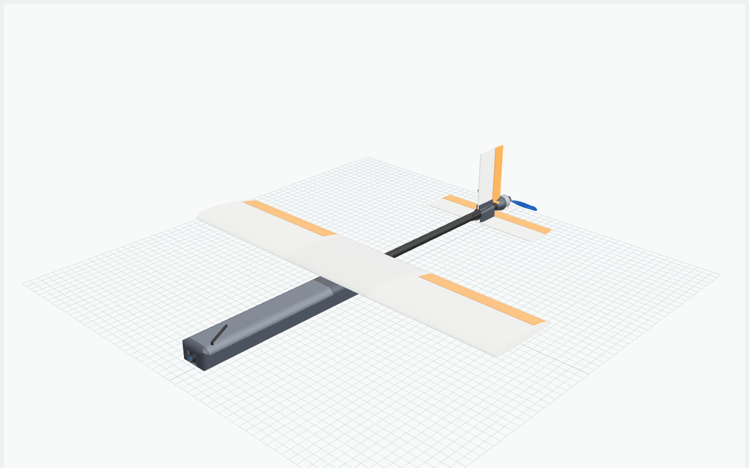
[picture p19: airframe/variants/single-boom/preview/hero.png]
Single boom


The build order changes behind the battery:

1. The tail servos screw to their posts in the fuselage before anything closes it in.
2. The tail is glued up off the plane: stabiliser under the pylons, fin in its
   socket, then the elevator and rudder hinged.
3. It slides onto the boom and is squared and glued. The boom was already
   drilled for the pushrod exits and threaded with the two PTFE sleeves and
   the motor wires.
4. The motor cap goes on the boom's end, with the motor on the cap.
5. The whole boom slides into the fuselage socket and is squared to it, and
   the pushrods go in through their sleeves.
6. The wing is built separately and glued onto the fuselage's flat top.

| | Twin boom | Single boom |
|---|---|---|
| Parts and fasteners | 54 (minimum 26) | 50 (minimum 23) |
| Manual assembly time | 42 min | 48 min |
| Design efficiency | 3 % | 2.4 % |
| Printing | 8 h 38 min, 97 g | 9 h 53 min, 100 g |
| Hands-on | 1 h 46 min | 2 h 01 min |
| Epoxy cure waits | 45 min | 1 h 15 min |
| Lead time | 10 h 09 min | 11 h 26 min |
| Cost per airframe | about 170 EUR | about 177 EUR |

- **Fewer parts, more joints.** The single boom drops the bellcrank, the
  joiner wires, one boom and a fin. But it adds five epoxy joints: the tail on
  the boom, the motor cap, the boom in the fuselage, the wing panels and the
  wing on the fuselage. It also adds boom preparation (exit holes, sleeves,
  motor wires).
- **Lead time.** The prints still set it: the five plates run in series, and
  the standing fuselage rear makes plate 1 longer (1 h 29 min on its own). The
  critical path ends in the wing, which can only go on once the last panel has
  printed.
- **Two parts need support.** The lid and the aileron servo fairings each have
  a 32 mm overhang. The lid's lips wrap round the fuselage's rounded top edges;
  the fairing closes a shallow dome. The twin boom has neither problem. A
  flatter lid lip, and a fairing printed into the wing panel (one of the
  redesign suggestions), would remove both.
- **Redesign suggestions** (DFMA.md has each one's trade-off):
  - print the tail mount, fin and motor cap as one PETG part;
  - print the servo fairings into the wing panels;
  - key the boom so the tail squares itself.

  Together with the twin's suggestions (printed horns, an FC with a built-in
  receiver, a camera with an integrated VTX, printed hinges), they bring it to
  42 parts.

### Wiring

Every wire run in the single boom is modelled as a body along its route:
- both aileron leads;
- the elevator and rudder servo leads;
- the motor wires;
- the ESC's battery wires.

The build's interference check covers these runs like any other part, so a
route that's blocked shows up as an overlap. The only contacts allowed are a
wire at its own two ends, and wires against wires, since they bundle. The
check passes, and REPORT.md lists each run's length:

| Run | Route | Length | Note |
|---|---|---:|---|
| Aileron leads | out of the servo into the pocket's lead slot, inboard through the panel and the wing centre, down beside the boom socket into the fuselage's open top, forward over the servos and battery to the FC | 263 mm | needs about 303 mm with slack: **extend each SG90 lead by about 55 mm** |
| Elevator, rudder leads | up from the servo, forward over the battery to the FC | 128, 162 mm | the SG90's 250 mm lead is enough |
| Motor wires | from the ESC's motor tabs up through a 3.2 mm hole under the boom, along the upper right of the bore (clear of both pushrod exits), out through the motor cap's slot | 328 mm | three silicone wires, about 370 mm each |
| ESC power | aft past the ESC, up beside the boom socket, forward over the servos to the battery's XT30 | 165 mm | |

Getting the runs through needed three changes to the CAD:
- **Aileron lead channel.** It now runs at the servo pocket's lead slot,
  where the SG90's lead leaves the case. Before, it ran at 45 % chord, where
  the servo itself was in the way.
- **Lead drop holes.** They now go down each side of the boom socket, into
  the fuselage's open top. The old single hole landed on the closed top of the
  tail cone, on the boom's axis.
- **Motor-wire entry.** There's a new hole through the bottom of the boom
  socket and the tube, right over the ESC's motor tabs. Before, the wires'
  only way into the boom was a 2 mm gap between the rudder servo's tabs and
  the socket.

The servo plugs come off: the F405-WMN has solder pads. The bill of process now
has a step for extending the aileron leads (F4). It also solders the aileron
leads only once the wing is on (A16), and drills the boom's third hole in F3.

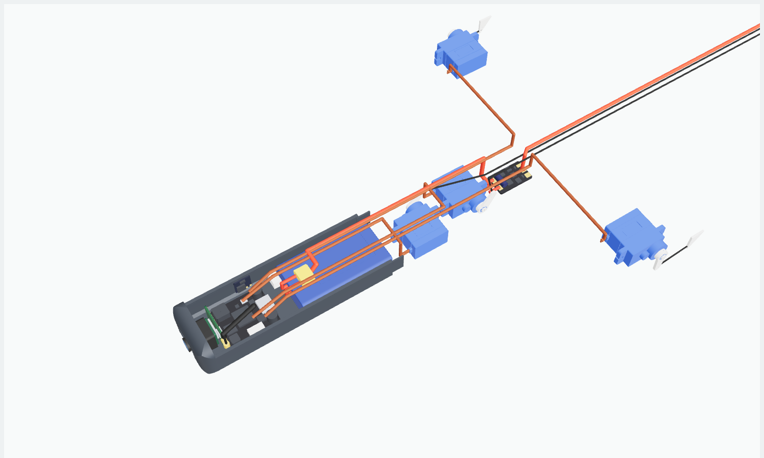
[picture p20: airframe/variants/single-boom/preview/wiring.png]
Wiring


| Fuselage, cut open | Tail servos, lid off | ESC under the boom's mouth |
|---|---|---|
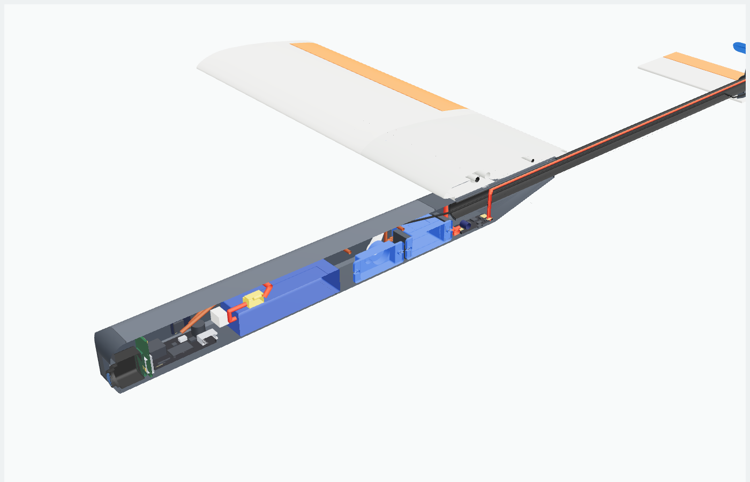
[picture p21: airframe/variants/single-boom/preview/fuselage.png]
Fuselage
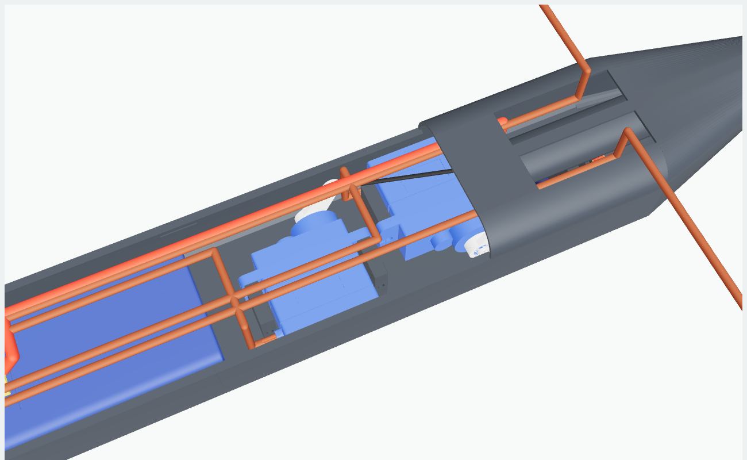
[picture p22: airframe/variants/single-boom/preview/servos.png]
Servos
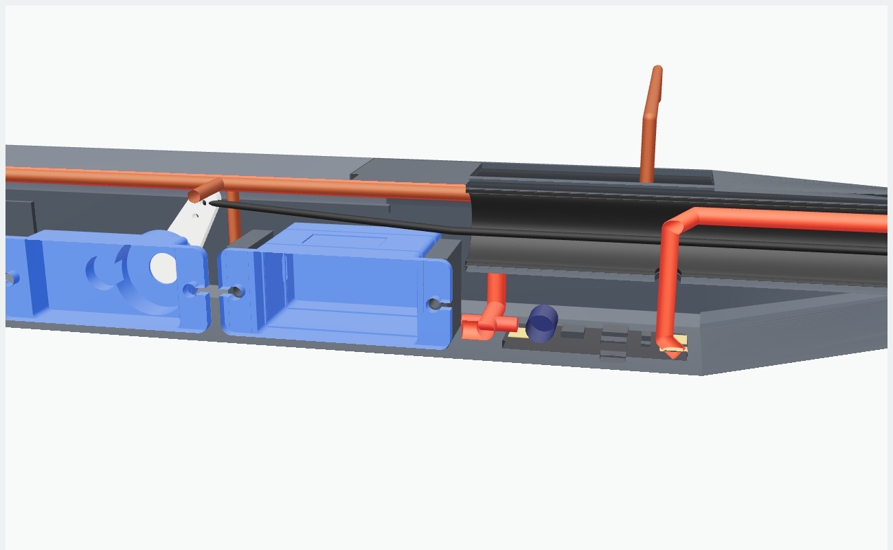
[picture p23: airframe/variants/single-boom/preview/esc.png]
|  |  |  |
| **Tail** | **Motor on the boom** | **Side, cut open** |
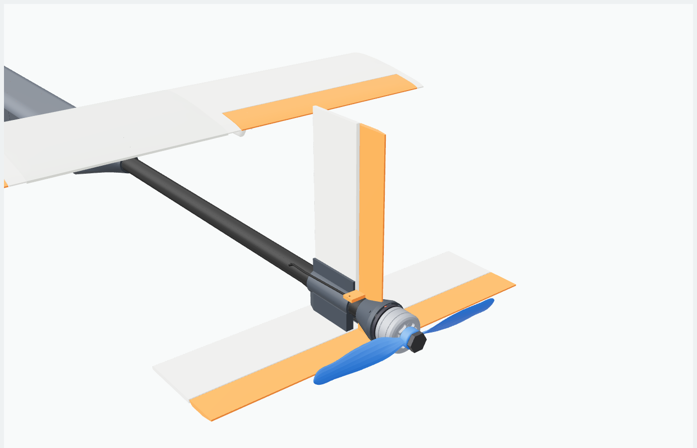
[picture p24: airframe/variants/single-boom/preview/tail.png]
Tail
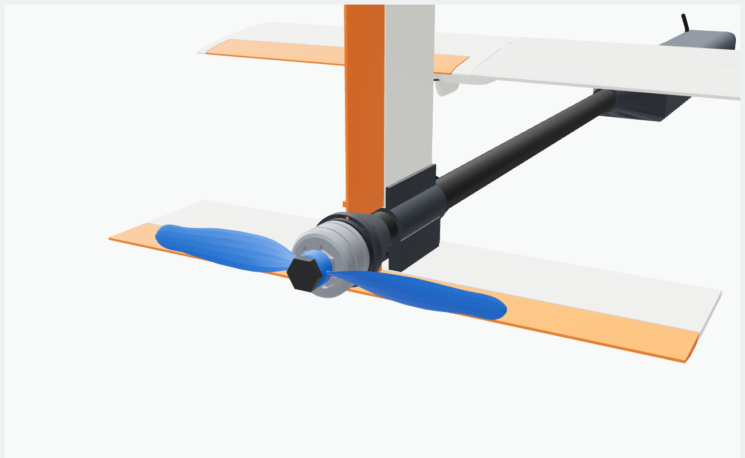
[picture p25: airframe/variants/single-boom/preview/motor.png]
Motor
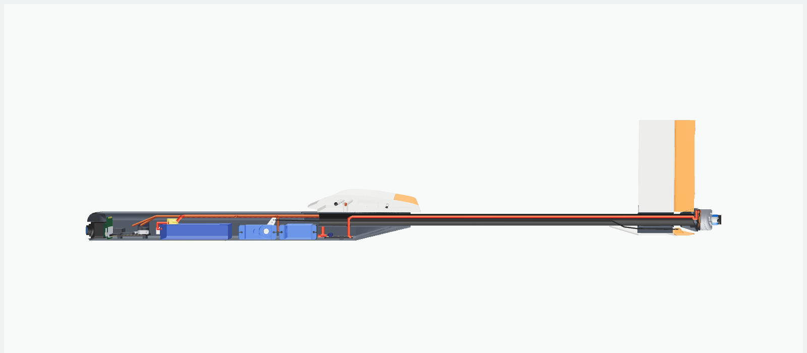
[picture p26: airframe/variants/single-boom/preview/cutaway.png]
Cutaway
|  |  |  |

## The extreme-aero variant

The single boom's drag at 13 m/s is about a third induced drag and a third
the wing's own profile drag. The induced drag depends on the span, not the
area (D_i = W² / (q π e b²)), so a wider wing is the biggest lever left.
`python3 aero/extreme.py` searches for it, and
`python3 airframe/build.py --variant extreme` builds what it picks into
`variants/extreme/` (STLs, GLB, REPORT.md). Everything else stays as on the
single boom: the electronics, motor, prop and battery, the optimized
section, the fuselage, and the printer.

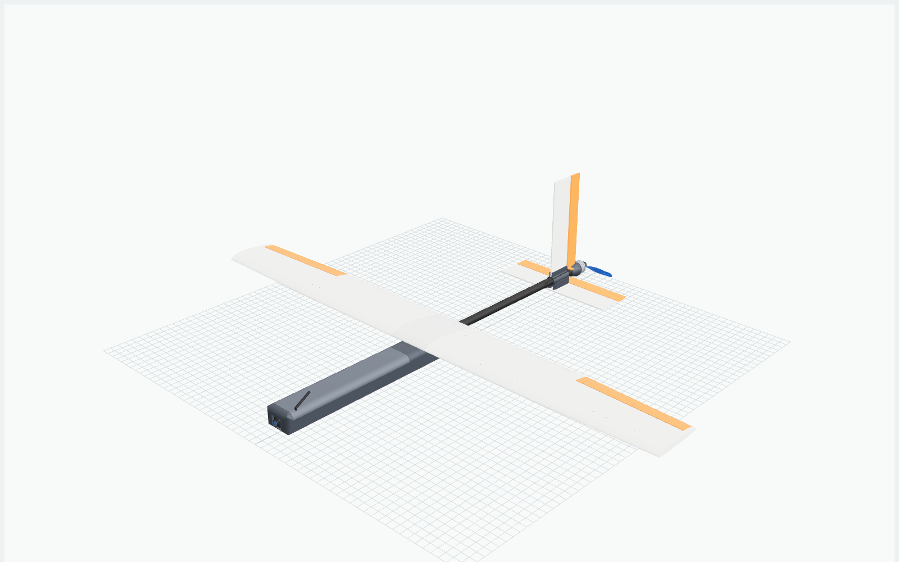
[picture p27: airframe/variants/extreme/preview/hero.png]
Extreme aero


**The search.** [aero/study/EXTREME.md](../aero/study/EXTREME.md) has the
details. It tries span, root chord, taper and tail arm (3,825 designs on a
coarse grid and a fine one) and flies each one at its own weight:

- **Span loading:** a lifting line with the section's own lift slope and the
  twist. An AeroSandbox vortex lattice agrees with it to within 2 % on the
  induced drag.
- **Profile drag:** NeuralFoil strip by strip, at each strip's own lift
  coefficient and Reynolds number.
- **The rest:** the single boom's drag build-up, with the tail, boom and
  fuselage re-sized.
- **Weight:** the single boom's CAD weights re-sized part by part. The wing
  panels are weighed as the CAD weighs them, by wall area, holes included.
  The study's 242.7 g came within 0.1 g of the CAD's 242.8 g.

Each design also has to pass these checks:

| Check | Why |
|---|---|
| Every panel at most 175 mm long | it prints standing on its root rib on the A1 mini |
| Two panels a side, a narrow centre | the inner panels keep the root chord; the outer ones taper and twist |
| The SG90's tabs fit between the spars where the taper has begun | the aileron servo sits at the outer panel's root |
| The lightest carbon spar tube that bends under 1.5 % of the half span at 1 g and fits the tip | this wing on a 3 mm rod would bend about 23 mm at 1 g |
| A boom as stiff as the single boom's (46 Hz first mode with the tail and motor on its end) | a longer tail arm needs a heavier boom |
| The wing still sits down on the fuselage's full section once the plane balances | the bigger tail moves the balance aft; the fuselage can stretch between the servos and the ESC to keep the wing's seat ahead of the tail cone |
| No more power at 13 m/s than the single boom, stall under 9 m/s | it must not get worse where the single boom is good |

It keeps the best glide ratio and, of the designs within 1 % of it, the
lightest. The optimum is flat: the best designs at every span from 680 to
710 mm glide within 1 % of each other. Nothing wider than 710 mm passes. A
stiffer spar no longer fits a tip slim enough to keep the area down, and a
broader tip makes the plane need more power at 13 m/s than the single boom.

| | Single boom | Extreme aero |
|---|---|---|
| Span | 485 mm | **700 mm** |
| Chord | 97 mm, straight | 86 mm root, 69 mm tip; the outer panels taper (0.8) and twist 3° tip-down |
| Wing area, aspect ratio | 4.71 dm², 5.0 | 5.74 dm², 8.5 |
| Panels | 135 mm centre, one 175 mm panel a side | 56 mm centre, two 161 mm panels a side |
| Main spar | 3 mm carbon rod | 5 × 4 mm carbon tube, tip to tip |
| Rear spar | 2 mm rod, tip to tip | 2 mm rod through the centre and inner panels, and one in each outer panel at 70 % of its narrowing chord |
| Ailerons | from the centre section out | on the outer panels; the servo sits at their root, 192 mm out |
| Tail arm | 272 mm | 260 mm (the 10 × 9 mm boom stays as stiff) |
| Stabiliser, fin | 175 × 48 mm, 79 mm tall | 175 × 52 mm, 134 mm tall (the same tail volumes) |
| Fuselage | 277 mm | 282 mm: 5 mm more between the servos and the ESC |

**The twist.** Even untwisted, this wing first reaches its maximum lift at
the root, as the straight wing does. The twist is not needed for a root-first
stall here. It unloads the tips, which costs a little maximum lift and gains a
little glide. The study keeps the 3° that glides best, as long as the stall
still starts inboard of the ailerons.

**In the CAD.** The outer panels are lofted from the root section at the
break to the smaller tip section. Each section is scaled and turned about the
main spar's axis, so the tube runs straight through every panel. Towards the
tip the trailing edge is thickened back to the printable 0.8 mm. The aileron
hinge, the bevel and the rear spar follow the taper. The SG90 pocket checks its
tabs against the section where they sit, and its top against the thinner
section at the pocket's outboard end. The interference check passes with
every wire run modelled, and every part fits the A1 mini. The fuselage's
front half (208 mm) prints across the bed's diagonal. Its halves now meet just
behind the servo bay, in the stretch.

**Weight.** 242.8 g against 227.4 g:

- **Heavier:**
  - the four wing panels (+19.0 g);
  - the spars (+3.5 g);
  - the bigger tail (+3.8 g);
  - the fuselage stretch (+0.8 g).
- **Lighter:**
  - the wing centre (−9.8 g), the only wing part printed with infill;
  - the smaller ailerons (−1.6 g).

The balance puts the wing 9.6 mm further aft. The static margin is 16 %
(13 % on the single boom).

**Flight.** From `aero/variants.py`, at their CAD weights:

| | Single boom | Extreme aero | change |
|---|---|---|---|
| Best glide ratio | 9.7 at 12.2 m/s | **11.6** at 10.2 m/s | +19 % |
| Least sink, motor off | 1.10 m/s | **0.79 m/s** | −28 % |
| Longest flight | 21.0 min at 9.2 m/s | **25.7 min** at 8.8 m/s | +4.7 min |
| Furthest flight | 13.8 km | 14.7 km | +0.8 km |
| Power at 13 m/s | 9.02 W | 8.98 W | the same |
| Stall | 8.95 m/s | 8.41 m/s | −0.54 m/s |
| Best climb | 4.68 m/s | 4.51 m/s | −0.17 m/s (the weight) |
| Top speed | 20.0 m/s | 19.5 m/s | −0.5 m/s |
| Tightest level turn at 13 m/s | 9.3 m | 7.9 m | the lower wing loading |

It is built to fly slow and long. At its best-glide speed, 10.25 m/s, the
induced drag halves (0.069 N against 0.131 N). The wing's extra area gives back
about a quarter of that (0.073 N of profile drag against 0.058 N). At
13 m/s the two planes need the same power. Above that the single boom is
better: 9.9 W against 10.2 W at 14 m/s.

**What the numbers leave out:**

- **Roll:**
  - The ailerons sit further out, but the longer wing also damps the roll more.
  - Expect a slower roll than the single boom's. Give them more throw.
- **Aileron leads:** the servos sit 192 mm out, so each SG90 lead needs about
  180 mm of extension instead of 55.
- **Flex:**
  - The 5 × 4 mm tube is sized to bend 1.5 % of the half span at 1 g, which
    is about 5 mm.
  - The printed shell and the rear spar add stiffness the sizing leaves out.
  - Pull up gently the first time.
- **The fin:**
  - It is 134 mm tall, on a 2 mm plate.
  - It is stiff enough for the loads, but check it for flutter at full speed.
  - A taller fin is also easier to break in a landing.
- **Transport:**
  - The main spar is one 690 mm tube, so the wing does not come apart.
  - Glue only the inner panels to the centre if you want the outer panels to
    slide off the spar.
- **Not built yet:** there is no bill of process, DFMA analysis or assembly
  video for this variant yet. They would follow the single boom's, with two
  more panels and a longer lead extension.

| Top | The wing, from above |
|---|---|
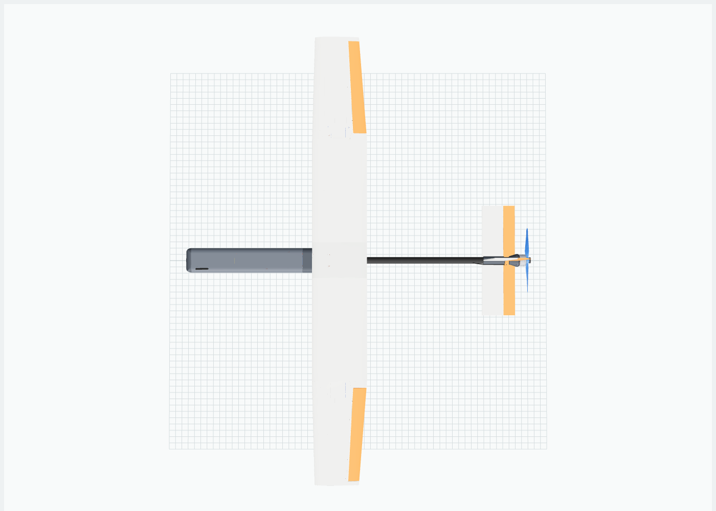
[picture p28: airframe/variants/extreme/preview/top.png]
Top
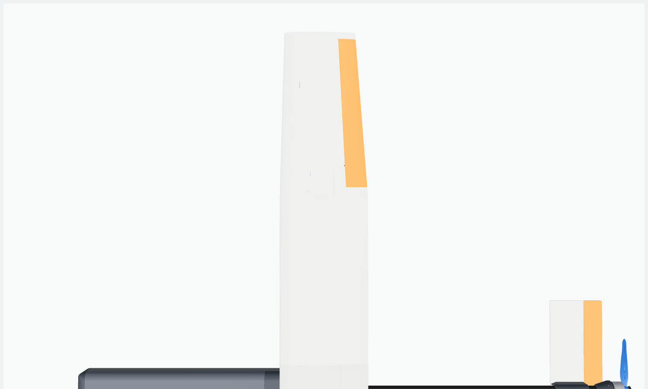
[picture p29: airframe/variants/extreme/preview/wing.png]
Wing
|  |  |
| **Side** | **Aileron servo at the outer panel's root** |
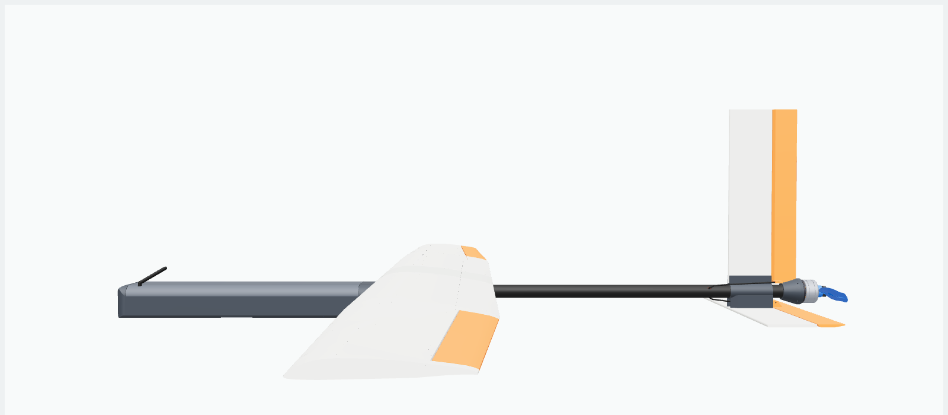
[picture p30: airframe/variants/extreme/preview/side.png]
Side
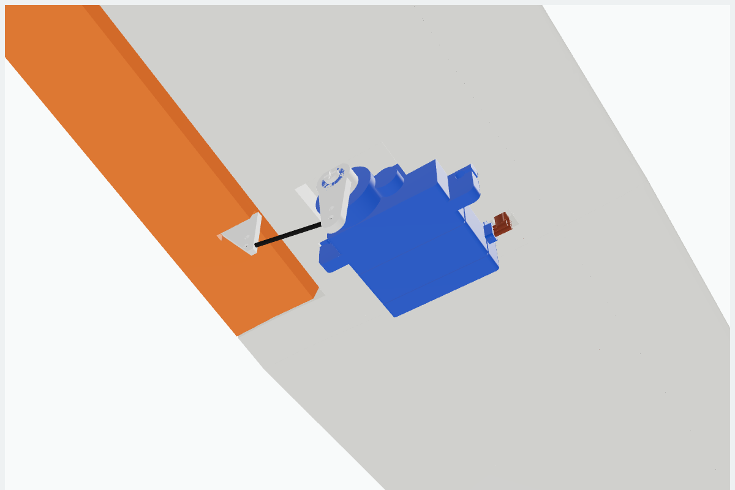
[picture p31: airframe/variants/extreme/preview/aileron.png]
Aileron
|  |  |

The comparison page, [variants/index.html](variants/index.html), shows it
against any of the other three builds.

| Single boom (left) and extreme aero (right) | From above |
|---|---|
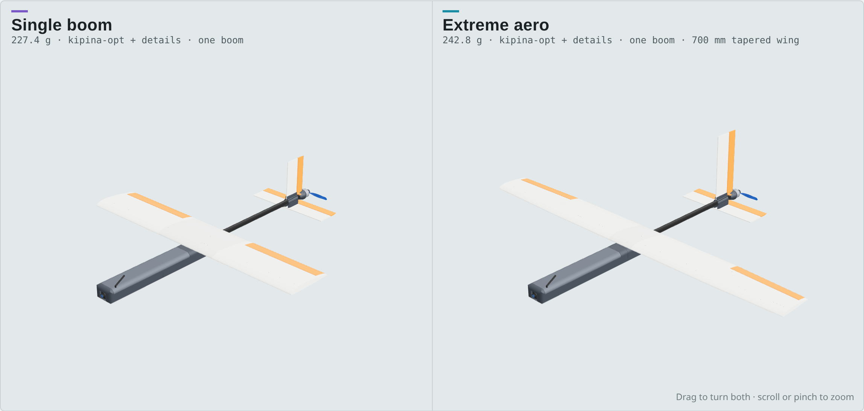
[picture p32: airframe/variants/figures/extreme-models.png]
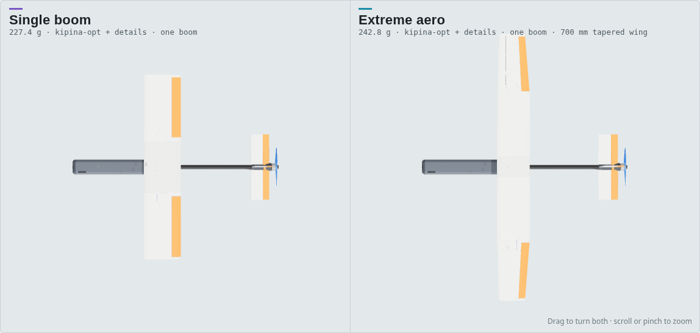
[picture p33: airframe/variants/figures/extreme-models-top.png]
From above
|  |  |

## The 1:2 desk model

`python3 airframe/mini.py` makes a half-size single boom to print, every part
of it on the A1 mini: to check how the parts go together before printing the
full-size plane, and to show it. It doesn't fly. It writes
`variants/single-boom-mini/`: STLs, a STEP and GLB of the model on its stand,
[REPORT.md](variants/single-boom-mini/REPORT.md) and a viewer page with an
exploded view.

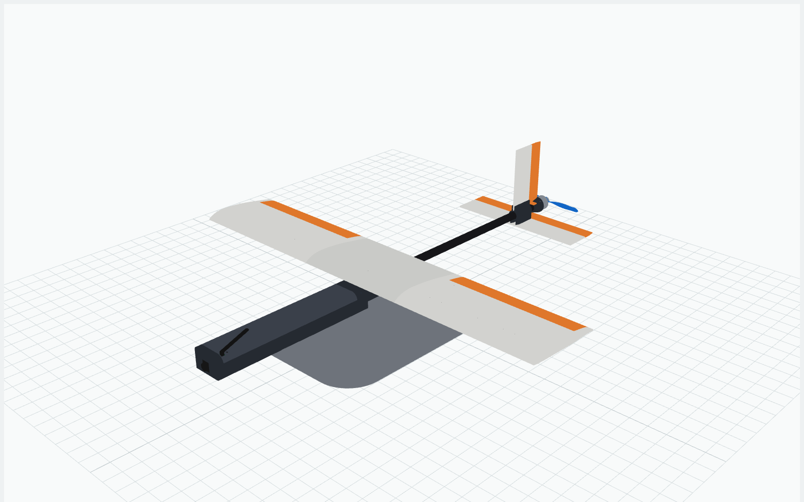
[picture p34: airframe/variants/single-boom-mini/preview/hero.png]
Desk model


- **Same parts, same split.** The 16 printed parts are the full-size plane's,
  scaled. The wing and the battery stay where the full-size plane has them.
- **Thick enough to print.** At half size the thin features would be 0.2 to
  0.6 mm. So before scaling, these are rebuilt to 0.8 mm (two lines) at half
  size:
  - inwards: the fuselage walls, the trailing edges and the servo fairings'
    shells;
  - outwards: the boom sleeves and the tail mount's collar and fin socket.

  The tail plates come out at 1 mm. Sliced solid in PrusaSlicer, every part
  fills at least 98 % of its volume, so nothing is too thin to print.
- **Printed rods.** The carbon boom and spars are printed too, solid, lying on
  a small flat:

  | Rod | Full size | Model | Hole | Thinnest wall round it |
  |---|---|---|---|---|
  | Boom | 10 x 9 mm carbon tube | 4.8 mm, 161 mm long | 5.1 mm | 0.80 mm |
  | Main spar | 3 mm carbon rod | 3.0 mm, two 119 mm halves | 3.3 mm | 1.06 mm |
  | Rear spar | 2 mm carbon rod | 1.8 mm, two 119 mm halves | 2.1 mm | 0.88 mm |

  The spars are as thick as the wing allows with 0.8 mm of wall round the hole,
  so they are stiffer than the scaled carbon would be. Each is two halves that
  meet inside the wing centre, so each half fits the bed. `--stock-rods` uses
  bought 5 mm, 1.5 mm and 1 mm rods instead.
- **Fits cut again for printing.** Scaling halves every full-size clearance,
  so each fit is re-cut for a printed part going into a printed part:
  - rods in their holes: 0.3 mm on the diameter, every hole vertical on the
    bed so it prints round;
  - the lid, the fin and the fuselage halves' joint: 0.25 mm a side;
  - the dummies in their pockets: 0.25 mm a side;
  - the glued joints touch, and nothing overlaps.
- **Print `stl/fit_test.stl` first.** It has each rod's hole at 0.1 mm tighter
  and looser, slots for the tail plates likewise, and a stub of each rod to
  try. If the stubs only go into the loose holes, run
  `python3 airframe/mini.py --fit 0.4 --gap 0.35`.
- **Printed dummies for the bought parts.** The four servos, the motor, prop,
  FC, ESC, receiver, VTX, camera, antenna and battery are one solid each, made
  from the detailed models without their wires and pads, and trimmed to clear
  their pockets. The prop and the antenna are 1.6 times thicker so they print.
- **A stand.** A base, a post and a cradle cut to the fuselage's belly, under
  the balance point, with the name engraved in the base.

Making it found three overlaps in the full-size CAD, fixed now in every
variant, and `build.py` now checks printed parts against each other:
- the single boom's rudder ran into the motor cap's cone; it is notched round
  it;
- the aileron servo fairings ran into the wing centre's flat underside; they
  are cut clear of it;
- the twin's lid corners ran into the pod's rounded nose; they are rounded to
  match.

The 36 files print in about 10 h 35 min (0.12 mm layers, 116 g of PLA), the fit
test included (33 min).
Left off: the wiring, the pushrods and the hinges (glue the control surfaces
at neutral, or hinge them with tape).

| Exploded | Inside the fuselage, lid off |
|---|---|
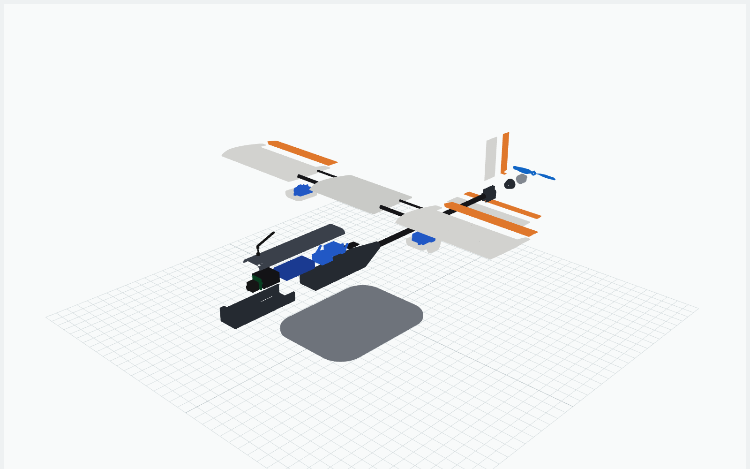
[picture p35: airframe/variants/single-boom-mini/preview/exploded.png]
Exploded
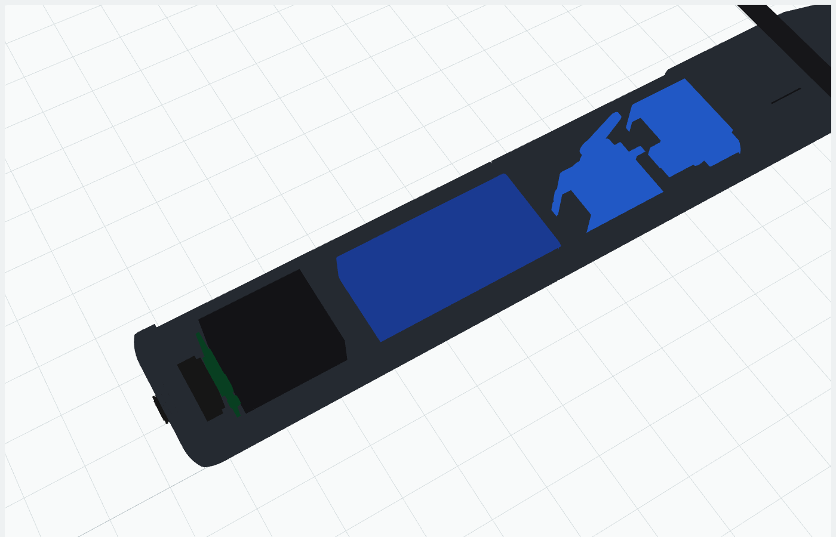
[picture p36: airframe/variants/single-boom-mini/preview/bay.png]
|  |  |
| **On the stand** | **The tail** |
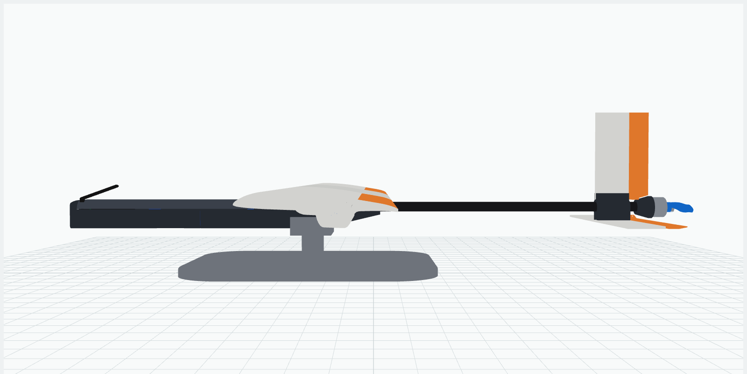
[picture p37: airframe/variants/single-boom-mini/preview/side.png]
Side
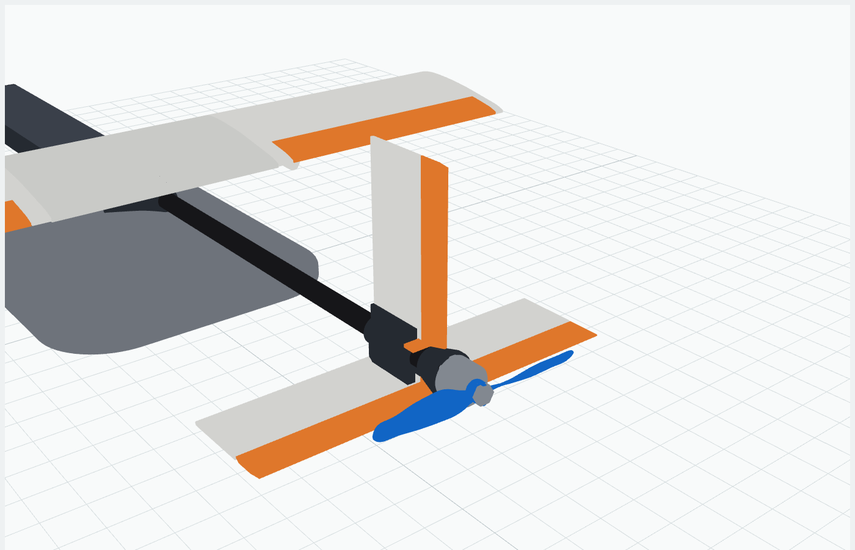
[picture p38: airframe/variants/single-boom-mini/preview/tail.png]
Tail
|  |  |

`--scale`, `--fit`, `--gap`, `--stock-rods` and the rod sizes (`--boom`,
`--spar`, `--rear-spar`) are options.

## Known limitations

- The weights are estimates. LW-PLA density depends heavily on print
  temperature and flow. Weigh your parts and put the real numbers in
  `build.py` (`PRINT`) before trusting the CG.
- The aerodynamics are first-order: Helmbold lift slope, a Gilruth-style pod
  term and CLmax 0.95. Expect to trim.
- The prop works in the wake of the pod and the wing. That usually costs a
  pusher a few percent of thrust and makes it a little louder. The model
  ignores it.
- The SG90 model uses datasheet dimensions. Clones vary by a few tenths of a
  millimetre, so test-fit a servo in the pocket before gluing.
- The drag build-up (top speed, the nose's benefit) uses handbook drag
  coefficients for the pod front. At this size (Reynolds number around 40 000)
  they could be off by ±50 %; the comparison between options is more
  reliable than the absolute numbers.
- The FC and ESC outer sizes come from retailer listings, because the
  makers' drawings were not reachable. Check the FC's 22 × 22 mm hole pattern,
  its height and the pad positions against your board before printing the
  pod. The camera, VTX and receiver sizes are generic.
- The booms are only held by their glued sockets under the wing centre and
  the tail mount. That is enough for the loads of a 200 g plane, but a hard
  cartwheel will load the sockets; check them after crashes.
