henriharmaala1-source/Assembly-grapher/airframe/REPORT.md

# Twin-boom micro FPV pusher: build report

Generated by `build.py` from the CAD volumes. Do not edit by hand.

## Key numbers

| | |
|---|---|
| Wingspan | 485 mm |
| Chord | 97 mm (NACA 4412, 2 deg incidence) |
| Wing area | 4.70 dm^2 (aspect ratio 5.0) |
| Length (nose to elevator TE) | 504 mm |
| Tail booms | 2 x 6x5 mm, 298 mm long, 140 mm apart |
| Prop clearance | 16.2 mm to each boom, 10.7 mm to each pushrod |
| Stabiliser | 175 x 48.0 mm (elevator 17.3 mm) |
| Fins | 2 x 48.0 x 39 mm |
| All-up weight | **223 g** (printed parts 98 g) |
| Wing loading | 47.4 g/dm^2 |
| Stall / cruise | 8.94 / 13.0 m/s |
| Top speed (level, estimate) | 19.1 m/s = 69 km/h (pitch speed 86 km/h, CdA 18.4 cm^2) |
| Endurance (rough) | ~10 min on 2S 450 mAh |
| Current (rough) | cruise ~2.1 A (16 W), full throttle at 1:1 thrust ~9 A |
| Thrust target | >= 223 g static (1:1) |
| Tail volumes | Vh 0.50, Vv 0.045 |
| CG target | 28 % of the chord = **199.6 mm** from the nose (27.2 mm behind the wing's root LE) |
| CG (computed) | x 199.6 mm, z 0.5 mm |
| Neutral point | 41 % chord -> static margin 13 % |
| Battery centre | **91 mm** from the nose (travel 83-99 mm) |

Sizing check with CAD weights: stall 8.94 m/s against the 9.0 m/s limit: **passes**.

Interference check (printed parts against each other, bought parts and wire runs against everything; pushrods in their horns, wires at their own ends and wires against wires excluded): no overlaps.

Analytic structure estimate for comparison: 113 g (CAD printed + rods/tubes: 114 g).

## Mass breakdown

| item | g | x mm |
|---|---|---|
| camera | 3.3 | 8 |
| vtx | 2.7 | 17 |
| antenna | 1.5 | 17 |
| fc | 10.0 | 34 |
| receiver | 1.5 | 42 |
| pod_front | 12.6 | 62 |
| battery | 27.0 | 91 |
| lid | 6.8 | 91 |
| wiring | 6.0 | 136 |
| spar_main | 5.2 | 197 |
| wing_R | 10.8 | 211 |
| wing_L | 10.8 | 211 |
| pod_rear | 14.3 | 215 |
| wing_centre | 21.9 | 215 |
| servo_elev | 9.0 | 219 |
| servo_rud | 9.0 | 219 |
| servo_ail_R | 9.0 | 219 |
| servo_ail_L | 9.0 | 219 |
| pushrod_ail_R | 0.2 | 236 |
| pushrod_ail_L | 0.2 | 236 |
| spar_rear | 2.3 | 240 |
| horn_ail_R | 0.3 | 249 |
| horn_ail_L | 0.3 | 249 |
| hardware | 2.0 | 251 |
| aileron_R | 2.8 | 255 |
| aileron_L | 2.8 | 255 |
| esc | 6.0 | 264 |
| motor | 9.0 | 279 |
| prop | 2.0 | 287 |
| tube_L | 4.0 | 336 |
| tube_R | 4.0 | 336 |
| pushrod_rud | 0.3 | 355 |
| pushrod_elev | 0.3 | 357 |
| tail_mount | 4.9 | 470 |
| fin_L | 1.2 | 472 |
| fin_R | 1.2 | 472 |
| stab | 4.1 | 472 |
| bellcrank | 0.2 | 487 |
| rudder_R | 0.9 | 495 |
| rudder_L | 0.9 | 495 |
| joiner_R | 0.3 | 495 |
| joiner_L | 0.3 | 495 |
| elevator | 2.0 | 495 |

## Bought electronics

Outer sizes are from datasheets or retailer listings; the detail inside them (chips, connectors, wire lengths) is representative.

| part | model | size, mm | g |
|---|---|---|---|
| Servos, 4 | Tower Pro SG90 | 22.8 x 12.2 x 22.7 body, 32.3 over the tabs | 36 |
| Motor | 1404, 3800 KV | 18 dia x 12.2 long (bell) | 9 |
| Prop | 4 x 2.5 two-blade | 101.6 dia | 2 |
| ESC | Hobbywing XRotor Micro 30A (BLHeli_S, 2-4S, 30 A, no BEC) | 23.8 x 14.5 x 5.8 | 6.0 |
| Flight controller | Matek F405-WMN (INAV / ArduPilot, 2-6S, 12 outputs, 5 A servo BEC) | 31 x 26 x 16.5, 22 mm hole pattern | 10 |
| Receiver | ELRS 2.4 GHz nano | 10 x 10 x 3 | 1.5 |
| Camera + VTX | 14 mm nano camera, 5.8 GHz AIO VTX | 14 x 14 x 12 ; 20 x 19 x 3 | 6 |
| Antenna | 5.8 GHz whip | 38 long | 1.5 |
| Battery | 2S 450 mAh LiPo, XT30 | 58 x 31 x 13 | 27 |

## Print list

Build volume checked: 180 x 180 x 180 mm (Bambu Lab A1 mini).

| file | material | est. g | on the bed, mm | fits | orientation |
|---|---|---|---|---|---|
| stl/wing_centre.stl | LW-PLA | 21.9 | 105 x 22 x 155 | yes | On its side, spar holes vertical. 0.5 mm walls, 5 % infill. |
| stl/wing_R.stl | LW-PLA | 10.8 | 97 x 12 x 165 | yes | Standing on the root rib, brim. 1 wall, 0 % infill. |
| stl/wing_L.stl | LW-PLA | 10.8 | 97 x 12 x 165 | yes | Standing on the root rib, brim. 1 wall, 0 % infill. |
| stl/aileron_R.stl | LW-PLA | 2.8 | 24 x 148 x 7 | yes | Flat on the lower surface. 1 wall, 0 % infill. |
| stl/aileron_L.stl | LW-PLA | 2.8 | 24 x 148 x 7 | yes | Flat on the lower surface. 1 wall, 0 % infill. |
| stl/tail_mount.stl | PLA/PETG | 4.9 | 31 x 156 x 9 | yes | Pads face down. |
| stl/stab.stl | LW-PLA | 4.1 | 31 x 174 x 2 | yes | Flat. 2 top / 2 bottom layers, 15 % infill. |
| stl/elevator.stl | LW-PLA | 2.0 | 17 x 163 x 10 | yes | Top face down, horn up. |
| stl/fin_R.stl | LW-PLA | 1.2 | 30 x 39 x 9 | yes | Outer face down, jaws up. |
| stl/fin_L.stl | LW-PLA | 1.2 | 30 x 39 x 9 | yes | Outer face down, jaws up. |
| stl/rudder_R.stl | PLA/PETG | 0.9 | 17 x 44 x 6 | yes | Outer face down, wire flange up. 2 top / 2 bottom layers, 15 % infill. |
| stl/rudder_L.stl | PLA/PETG | 0.9 | 17 x 44 x 6 | yes | Outer face down, wire flange up. 2 top / 2 bottom layers, 15 % infill. |
| stl/bellcrank.stl | PLA/PETG | 0.2 | 16 x 19 x 2 | yes | Flat. Solid. |
| stl/lid.stl | PLA/PETG | 6.8 | 177 x 39 x 1 | yes | Flat. |
| stl/pod_front.stl | PLA/PETG | 12.6 | 138 x 41 x 22 | yes | Upright, open top up. 2 walls, 15 % infill. |
| stl/pod_rear.stl | PLA/PETG | 14.3 | 142 x 41 x 31 | yes | Upright, open top up, tongue forward. 2 walls, 15 % infill. |

## Span sweep (analytic mass model)

Criteria: stall speed <= 9.0 m/s at CLmax 0.95 (comfortable hand launch, FPV-flyable), and the SG90 aileron servo's mounting tabs fit between the spars.

| span mm | chord mm | AUW g | loading g/dm^2 | WCL | stall m/s | servo room mm | Re at stall |
|---|---|---|---|---|---|---|---|
| 300 | 60 | 172 | 95.6 | 71.2 | 12.70 | -8.6 | 52k |
| 320 | 64 | 177 | 86.2 | 60.2 | 12.06 | -6.8 | 53k |
| 340 | 68 | 181 | 78.4 | 51.5 | 11.50 | -5.0 | 54k |
| 360 | 72 | 186 | 71.8 | 44.5 | 11.00 | -3.2 | 54k |
| 380 | 76 | 191 | 66.2 | 38.9 | 10.56 | -1.4 | 55k |
| 400 | 80 | 196 | 61.3 | 34.3 | 10.17 | +0.4 | 56k |
| 420 | 84 | 202 | 57.1 | 30.4 | 9.82 | +2.2 | 56k |
| 440 | 88 | 207 | 53.5 | 27.2 | 9.50 | +4.0 | 57k |
| 460 | 92 | 213 | 50.3 | 24.4 | 9.21 | +5.8 | 58k |
| **480** | 96 | 219 | 47.5 | 22.1 | **8.95** | +7.6 | 59k |
| **500** | 100 | 225 | 45.0 | 20.1 | **8.71** | +9.4 | 60k |
| **520** | 104 | 233 | 43.0 | 18.5 | **8.51** | +11.2 | 61k |
| **540** | 108 | 241 | 41.3 | 17.1 | **8.34** | +13.0 | 62k |
| **560** | 112 | 249 | 39.7 | 15.8 | **8.18** | +14.8 | 63k |

Smallest span meeting the criterion: **480 mm** (design uses 485 mm).
