henriharmaala1-source/Assembly-grapher/aero/REPORT_quad.md

# Optimizer: Typical 5-inch FPV quad, aerodynamics

Generated by `aero/optimize.py quad`. Do not edit by hand.

Objective: **power at cruise**, lower is better, at **60 km/h cruise**. 7 of 7 parameters free, 512 evaluations. The stock quad: 5-inch freestyle frame, 2306 1750 KV, 5.1 x 4.3 x 3 props, 55 A 4-in-1, 6S 1100 mAh LiPo, analog video, 504 g. Every aerodynamic change ends up in this power: the body's drag, the prop wash on the arms and the weight of any printed part. The propulsion stays stock, and the model does not look at top speed.

## Result

| | typical build | optimised | change |
|---|---|---|---|
| Power at cruise | 146.1 W | **128.5 W** | -12.0 % |
| Drag area CdA | 96.07 cm² | 51.12 cm² | -46.8 % |
| Body drag at cruise | 1.63 N | 0.87 N | |
| Flight time at cruise | 8.0 min | 9.1 min | |
| Cruise attitude | discs 18° nose down, body +18° | discs 10° nose down, body -0° | |
| Thrust used at cruise | 13% of full thrust | 13% of full thrust | |
| Prop wash on the arms | 4.5 % of thrust in a hover, 1.9 % at cruise | 2.8 % of thrust in a hover, 0.8 % at cruise | |
| All-up weight | 504 g | 517 g | |
| Hover power / flight time | 121 W / 9.7 min | 122 W / 9.6 min | |
| Thrust-to-weight | 7.8 | 7.8 | |

## Changes in the optimum

| parameter | typical build | optimised | what it is | kind |
|---|---|---|---|---|
| `arm_width` | 14 mm | **13 mm** | arm width | frame choice |
| `arm_sleeves` | none | **fitted** | streamlined printed sleeves on the arms | printed part |
| `motor_tilt` | 0 ° | **10 °** | motors tilted forward on printed wedges | printed part |
| `antenna` | upright lollipop | **stubby** | VTX antenna | part choice |

## One change at a time

Each parameter alone, moved to its best allowed value, everything else typical build. The gains do not simply add up: the combined optimum is above.

| change | from | to | power at cruise | change |
|---|---|---|---|---|
| motors tilted forward on printed wedges | 0 ° | 12 ° | 131.1 W | -10.3 % |
| streamlined printed sleeves on the arms | none | fitted | 140.7 W | -3.7 % |
| body | open frame | full fairing over stack and battery | 140.7 W | -3.7 % |
| arm width | 14 mm | 13 mm | 144.3 W | -1.2 % |
| VTX antenna | upright lollipop | lollipop laid back 45° | 144.5 W | -1.1 % |

No single move of these improves the result by 0.20 % or more without breaking a limit: `battery_mount` (on top), `arm_thickness` (5.0 mm).

## Drag build-up

Drag of the body, arms, motors and antennas at the cruise attitude. The props' own drag is part of the rotor power.

| item | typical build, cm² | share | optimised, cm² | note |
|---|---|---|---|---|
| stack and camera, front | 9.40 | 10 % | 9.90 | open standoffs and camera cage |
| battery, front | 9.27 | 10 % | 9.76 | 35 x 31 mm, on top |
| body, top or bottom face | 13.04 | 14 % | 0.22 | flow reaches it because the body is tilted |
| arms | 27.90 | 29 % | 6.53 | 14 x 5.0 mm → 13 x 5.0 mm, sleeved |
| motors | 21.50 | 22 % | 16.22 | 28 mm bells |
| antennas | 6.22 | 6 % | 3.85 | upright lollipop and receiver → stubby and receiver |
| junctions (10 %) | 8.73 | 9 % | 4.65 |  |

## Parameters and limits

| parameter | range | step | limit | free |
|---|---|---|---|---|
| `body` | open frame to full fairing over stack and battery | - | canopy +10 g; full fairing +35 g, and it has to open for battery changes | yes |
| `battery_mount` | on top to underneath | - | - | yes |
| `arm_width` | 10 mm to 18 mm | 1 mm | arm stiffness up and down and sideways at least 80 % of the stock 14 x 5 mm arms | yes |
| `arm_thickness` | 4.0 mm to 6.0 mm | 0.5 mm | as for the width | yes |
| `arm_sleeves` | none to fitted | - | +12 g | yes |
| `motor_tilt` | 0 ° to 15 ° | 1 ° | the camera's uptilt drops by the same angle; the quad hovers nose-up by it, and 15° keeps that sane | yes |
| `antenna` | upright lollipop to stubby | - | - | yes |

## Method and limits

* **Scope.** The airframe's aerodynamics only. The motors, props and battery stay
  stock (5-inch freestyle frame, 2306 1750 KV, 5.1 x 4.3 x 3 props, 55 A 4-in-1, 6S 1100 mAh LiPo, analog video), so the quad keeps its thrust-to-weight, which must stay
  between 5 and 12 (the band this class flies with), and
  a cruise may use at most 70% of full thrust. The objective is the
  power at a steady cruise. There is no speed or acceleration objective and no
  top-speed estimate.
* **Body drag**: each part's frontal area (times the cosine of the body's
  pitch) and its top or bottom face (times the sine), with handbook drag
  coefficients: open stack and camera cage 1.1, canopy 0.5, battery 0.9,
  flat arms 1.2 (0.6 edge-on with sleeves), motor bells 0.8, a rounded full
  fairing 0.25, antennas as rods. The nose-down pitch comes from the drag
  itself: the rotor discs tilt until thrust balances weight and drag, and
  forward-tilted motors take that much off the body's pitch. 10 % more for
  the junctions.
* **Prop wash on the arms**: the part of each arm under the prop pushes down
  against the wash, about 4.5 % of the thrust for the stock
  14 mm flat arms in a hover, less with sleeves. In forward flight
  the wake sweeps back and misses most of it.
* **Power**: the stock props' rotor power in forward flight (momentum theory
  with Glauert's inflow, the work against drag, profile power growing with the
  advance ratio), motor winding and iron losses, a 95% ESC,
  7 W of avionics and the pack's sag.
* **Arms** must keep at least 80 % of the stock 14 x 5 mm
  arms' stiffness both up and down (width x thickness³) and sideways
  (thickness x width³). Printed parts add their weight: canopy
  10 g, full fairing 35 g, arm sleeves
  12 g, motor wedges 4 g.
* These are handbook numbers, not a wind-tunnel test: perhaps ±30 % on the
  drag of each part. The ranking of changes is more reliable than the totals.
