henriharmaala1-source/Assembly-grapher/aero/REPORT_quad7.md

# Optimizer: Typical 7-inch long-range FPV quad, aerodynamics

Generated by `aero/optimize.py quad7`. Do not edit by hand.

Objective: **power at cruise**, lower is better, at **100 km/h cruise**. 7 of 7 parameters free, 480 evaluations. The stock quad: 7-inch frame with 6 mm arms, 2806.5 1300 KV, 7 x 4 x 3 props, 6S 3000 mAh LiPo, GPS, analog video, 980 g. Every aerodynamic change ends up in this power: the body's drag, the prop wash on the arms and the weight of any printed part. The propulsion stays stock, and the model does not look at top speed.

## Result

| | typical build | optimised | change |
|---|---|---|---|
| Power at cruise | 648.5 W | **300.6 W** | -53.6 % |
| Drag area CdA | 217.12 cm² | 56.78 cm² | -73.8 % |
| Body drag at cruise | 10.26 N | 2.68 N | |
| Flight time at cruise | 4.9 min | 10.6 min | |
| Cruise attitude | discs 47° nose down, body +47° | discs 14° nose down, body -1° | |
| Thrust used at cruise | 23% of full thrust | 17% of full thrust | |
| Prop wash on the arms | 3.7 % of thrust in a hover, 2.9 % at cruise | 2.3 % of thrust in a hover, 0.7 % at cruise | |
| All-up weight | 980 g | 1060 g | |
| Hover power / flight time | 201 W / 15.9 min | 220 W / 14.5 min | |
| Thrust-to-weight | 6.3 | 5.9 | |

## Changes in the optimum

| parameter | typical build | optimised | what it is | kind |
|---|---|---|---|---|
| `body` | open frame | **full fairing over stack and battery** | body | printed part |
| `arm_width` | 16 mm | **15 mm** | arm width | frame choice |
| `arm_sleeves` | none | **fitted** | streamlined printed sleeves on the arms | printed part |
| `motor_tilt` | 0 ° | **15 °** | motors tilted forward on printed wedges | printed part |
| `antenna` | upright lollipop | **stubby** | VTX antenna | part choice |

## One change at a time

Each parameter alone, moved to its best allowed value, everything else typical build. The gains do not simply add up: the combined optimum is above.

| change | from | to | power at cruise | change |
|---|---|---|---|---|
| body | open frame | full fairing over stack and battery | 502.0 W | -22.6 % |
| motors tilted forward on printed wedges | 0 ° | 15 ° | 537.1 W | -17.2 % |
| streamlined printed sleeves on the arms | none | fitted | 554.9 W | -14.4 % |
| arm width | 16 mm | 15 mm | 631.8 W | -2.6 % |
| VTX antenna | upright lollipop | lollipop laid back 45° | 640.8 W | -1.2 % |

No single move of these improves the result by 0.20 % or more without breaking a limit: `battery_mount` (on top), `arm_thickness` (6.0 mm).

## Drag build-up

Drag of the body, arms, motors and antennas at the cruise attitude. The props' own drag is part of the rotor power.

| item | typical build, cm² | share | optimised, cm² | note |
|---|---|---|---|---|
| stack and camera, front | 9.21 | 4 % | 0.00 | open standoffs and camera cage |
| battery, front | 11.37 | 5 % | 0.00 | 44 x 42 mm, on top |
| body, top or bottom face | 49.22 | 23 % | 0.00 | flow reaches it because the body is tilted |
| arms | 83.96 | 39 % | 12.82 | 16 x 6.0 mm → 15 x 6.0 mm, sleeved |
| motors | 34.41 | 16 % | 21.38 | 33 mm bells |
| antennas | 6.22 | 3 % | 3.85 | upright lollipop and receiver → stubby and receiver |
| GPS on a mast | 2.99 | 1 % | 2.99 |  |
| junctions (10 %) | 19.74 | 9 % | 5.16 |  |
| body fairing (stack and battery) | - | - | 10.58 | rounded pod 175 x 51 x 81 mm |

## Parameters and limits

| parameter | range | step | limit | free |
|---|---|---|---|---|
| `body` | open frame to full fairing over stack and battery | - | canopy +15 g; full fairing +60 g, and it has to open for battery changes | yes |
| `battery_mount` | on top to underneath | - | - | yes |
| `arm_width` | 12 mm to 22 mm | 1 mm | arm stiffness up and down and sideways at least 80 % of the stock 16 x 6 mm arms | yes |
| `arm_thickness` | 5.0 mm to 7.0 mm | 0.5 mm | as for the width | yes |
| `arm_sleeves` | none to fitted | - | +20 g | yes |
| `motor_tilt` | 0 ° to 15 ° | 1 ° | the camera's uptilt drops by the same angle; the quad hovers nose-up by it, and 15° keeps that sane | yes |
| `antenna` | upright lollipop to stubby | - | - | yes |

## Method and limits

* **Scope.** The airframe's aerodynamics only. The motors, props and battery stay
  stock (7-inch frame with 6 mm arms, 2806.5 1300 KV, 7 x 4 x 3 props, 6S 3000 mAh LiPo, GPS, analog video), so the quad keeps its thrust-to-weight, which must stay
  between 3 and 8 (the band this class flies with), and
  a cruise may use at most 70% of full thrust. The objective is the
  power at a steady cruise. There is no speed or acceleration objective and no
  top-speed estimate.
* **Body drag**: each part's frontal area (times the cosine of the body's
  pitch) and its top or bottom face (times the sine), with handbook drag
  coefficients: open stack and camera cage 1.1, canopy 0.5, battery 0.9,
  flat arms 1.2 (0.6 edge-on with sleeves), motor bells 0.8, a rounded full
  fairing 0.25, antennas as rods. The nose-down pitch comes from the drag
  itself: the rotor discs tilt until thrust balances weight and drag, and
  forward-tilted motors take that much off the body's pitch. 10 % more for
  the junctions.
* **Prop wash on the arms**: the part of each arm under the prop pushes down
  against the wash, about 3.7 % of the thrust for the stock
  16 mm flat arms in a hover, less with sleeves. In forward flight
  the wake sweeps back and misses most of it.
* **Power**: the stock props' rotor power in forward flight (momentum theory
  with Glauert's inflow, the work against drag, profile power growing with the
  advance ratio), motor winding and iron losses, a 95% ESC,
  8 W of avionics and the pack's sag.
* **Arms** must keep at least 80 % of the stock 16 x 6 mm
  arms' stiffness both up and down (width x thickness³) and sideways
  (thickness x width³). Printed parts add their weight: canopy
  15 g, full fairing 60 g, arm sleeves
  20 g, motor wedges 6 g.
* These are handbook numbers, not a wind-tunnel test: perhaps ±30 % on the
  drag of each part. The ranking of changes is more reliable than the totals.
