henriharmaala1-source/Assembly-grapher/aero/study/REPORT.md

# Drag and efficiency study: Kipinä, baseline against optimized

Generated by `aero/efficiency.py` (NeuralFoil 0.3.3 (large), n_crit 7). Do not edit by hand. The charts are in [index.html](index.html).

## The wing section

| | loiter 10.7 m/s (cl 0.66, Re 71k) | cruise 13 m/s (cl 0.45, Re 86k) | fast 18 m/s (cl 0.23, Re 120k) |
|---|---|---|---|
| NACA 4412 cd | 0.0217 | 0.0178 | 0.0167 |
| Optimized cd | 0.0178 | 0.0143 | 0.0126 |
| change | -18 % | -20 % | -25 % |

| limit | needs | NACA 4412 | optimized |
|---|---|---|---|
| main spar depth, mm | ≥ 4.6 | 11.70 | 10.69 |
| rear spar depth, mm | ≥ 3.6 | 7.50 | 7.19 |
| aileron hinge depth, mm | ≥ 3.0 | 6.56 | 6.17 |
| servo bump below the wing, mm | ≤ 5.16 | 4.91 | 5.16 |
| maximum lift (Re at 9 m/s) | ≥ 1.407 | 1.42 | 1.44 |
| lowest lift past the stall, 9-16° | ≥ 1.220 | 1.25 | 1.22 |
| maximum thickness | ≤ 15% | 12.2% | 11.1% |
| pitching moment at cruise | ≥ -0.124 | -0.104 | -0.085 |

Optimizer starts:

- from NACA4412: weighted cd 0.01499, meets every limit
- from SD7062: weighted cd 0.01499, meets every limit
- from SD7037: weighted cd 0.01499, meets every limit
- from E387: weighted cd 0.01499, meets every limit

Known airfoils against the same limits (cruise cd):

| airfoil | cruise cd | max lift | thickness | servo bump, mm | limits |
|---|---|---|---|---|---|
| NACA4412 | 0.0178 | 1.42 | 12.2% | 4.9 | all met |
| SD7062 | 0.0176 | 1.47 | 14.2% | 4.9 | gentle stall |
| SD7037 | 0.0156 | 1.35 | 9.4% | 7.1 | servo bump, maximum lift, gentle stall |
| E387 | 0.0155 | 1.30 | 9.3% | 7.5 | servo bump, maximum lift, gentle stall |
| S7075 | 0.0181 | 1.38 | 9.3% | 6.7 | servo bump, maximum lift, gentle stall |
| Optimized | 0.0143 | 1.44 | 11.1% | 5.2 | all met |

Cruise cd against transition sensitivity (n_crit 5 rough, 9 smooth): baseline: 5 → 0.0158, 7 → 0.0178, 9 → 0.0214; optimized: 5 → 0.0142, 7 → 0.0143, 9 → 0.0151.

## The whole plane

| | As built | Optimized airfoil | Optimized airfoil + details |
|---|---|---|---|
| Drag at cruise, N | 0.324 | 0.306 | 0.245 |
| Power at cruise, W | 12.0 | 11.4 | 9.5 |
| Flight time at cruise, min | 13.3 | 14.0 | 16.9 |
| Best L/D | 7.4 | 7.7 | 9.2 |
| ... at, m/s | 10.2 | 10.8 | 11.8 |
| Least power, W | 8.4 | 8.3 | 7.6 |
| ... at, m/s | 9.0 | 9.0 | 9.0 |
| Longest flight time, min | 18.9 | 19.3 | 20.9 |
| Stall, m/s | 8.94 | 8.94 | 8.94 |
| Top speed, m/s | 18.2 | 18.5 | 19.5 |
| Weight, g | 223 | 223 | 223 |

The details (from the drag optimizer, `aero/optimize.py airframe`): `nose_top_r` = 8, `boattail` = 30, `antenna_lean` = 60, `fairings` = 1, `joiners_hidden` = 1.
