henriharmaala1-source/Assembly-grapher/airframe/variants/single-boom-mini/REPORT.md

# Kipinä single boom, 1:2 desk model: build report

Generated by `mini.py --scale 0.5 --fit 0.3 --gap 0.25` from the single boom's CAD. Do not edit by hand.

A scale model to print: to check how the parts go together before printing the full-size plane, and to show it. It doesn't fly. The parts are the full-size plane's, split the same way and scaled; the bought parts are printed dummies, and the carbon boom and spars are printed rods.

## Key numbers

| | full size | model |
|---|---|---|
| Scale | 1:1 | **1:2** |
| Wingspan | 485 mm | 242.5 mm |
| Length (nose to prop) | 545 mm | 272.5 mm |
| Height | 104 mm | 51.9 mm (on the stand 71 mm) |
| Fuselage walls | 0.8 mm | 0.80 mm (thickened inwards before scaling) |
| Servo fairing shells | 0.45 mm | 0.80 mm |
| Trailing edges | 0.8 mm | 0.80 mm |
| Tail plates | 2.0 mm | 1.00 mm |
| Tail mount collar and fin socket cheeks | 1.2 mm | 0.80 mm |
| Files to print | | 36: 16 airframe parts, 5 rods, 13 dummies, the stand and the fit test |
| Print time, all of it | | **10 h 35 min**, 116 g of PLA (PrusaSlicer, A1 mini profile) |

The wing sits where it does on the full-size plane (leading edge 188.7 mm from the nose, 94.3 mm on the model) and the battery at its full-size station (91.2 mm, 45.6 mm). The walls, the trailing edges and the servo fairings' shells are thicker inwards, so the outside is the full-size plane's shape; the tail mount's collar and fin socket and the boom sleeves are thicker outwards (0.80 mm instead of 0.65 mm), which lifts the wing seat 0.15 mm.

## Fits and tolerances

Scaling halves every clearance the full-size plane has, and a printed part fits a printed part less well than a carbon rod fits a printed hole. So every fit is cut again for the model:

| fit | where | clearance | how |
|---|---|---|---|
| Rod in its hole | boom in the fuselage, tail mount and motor cap; spars in the wing | **0.3 mm** on the diameter | holes drilled for the rod + 0.3 mm; every hole is vertical on the bed, so it prints round |
| Slip fit | lid in the fuselage, fin in the tail mount, the fuselage halves' joint | **0.25 mm** a side (at least 0.17 mm at edges and corners) | the inner part trimmed where it came closer to the outer one |
| Dummy in its pocket | servos, FC, ESC, receiver, VTX, camera, battery | **0.25 mm** a side (measured: at least 0.14 mm) | each dummy trimmed where it came closer to a printed part |
| Fuselage in the stand's cradle | under the balance point | 0.25 mm | the cradle cut by the fuselage's section grown by the gap |
| Glued joints | wing panels on the centre, stabiliser under the tail mount, wing on the fuselage, fairings under the wing | 0 (faces touch) | as designed; nothing overlaps |

**Print `stl/fit_test.stl` first** (33 min, with the same settings as the model). It has a hole for each rod at 0.2, 0.3 and 0.4 mm (one, two and three dots), slots for the 1 mm tail plates at 0.15, 0.25 and 0.35 mm a side, and a stub of each rod and a tail-plate tab to try in them:

- The stubs and the tab slide into the two-dot holes and slots by hand, without play: print the model as it is.
- They only go into the three-dot ones: run `python3 airframe/mini.py --fit 0.4 --gap 0.35`.
- They are loose even in the one-dot ones: `--fit 0.2 --gap 0.15`.

## Rods

Printed in black PLA, solid, lying flat on a flat 10 % of their diameter deep. The spars are as thick as the wing allows with 0.8 mm of wall round the hole, thicker than the scaled carbon so they hold their shape; each is two halves that meet at the centre line, inside the wing centre, so each half fits the bed. The boom fills its socket's scaled bore less the fit clearance.

| rod | full size | model | files | length | hole | through (thinnest wall round the hole) |
|---|---|---|---|---|---|---|
| Boom | 10 x 9 mm carbon tube | **4.8 mm** printed | `rod_boom.stl` | 161 mm | 5.1 mm | tail_mount (0.80 mm), motor_mount (0.96 mm), fuselage_rear (0.80 mm) |
| Main spar | 3 mm carbon rod | **3 mm** printed | `rod_spar_main_R.stl`, `rod_spar_main_L.stl` | 238 mm | 3.3 mm | wing_centre (1.06 mm), wing_R (1.07 mm), wing_L (1.07 mm) |
| Rear spar | 2 mm carbon rod | **1.8 mm** printed | `rod_spar_rear_R.stl`, `rod_spar_rear_L.stl` | 238 mm | 2.1 mm | wing_centre (0.88 mm), wing_R (0.88 mm), wing_L (0.88 mm) |

Thinnest wall round any rod hole: **0.80 mm** (rays from each rod's axis across its hole's wall, at nine stations along each part and every 15 degrees).

The pushrods, the control horns' screws, the hinge tape and the wiring are left off; glue the control surfaces at neutral, or hinge them with tape.

## Print list

Build volume checked: 180 x 180 x 180 mm (Bambu Lab A1 mini). PLA, 0.4 mm nozzle, 0.12 mm layers, 2 walls, 15 % infill, 5 top and 4 bottom layers; the rods solid; the dummies with supports where the slicer wants them. Leave the slicer's X-Y hole and contour compensation at 0: the fit test sets the clearances.

| file | colour | on the bed, mm | fits | time | g | orientation |
|---|---|---|---|---|---|---|
| stl/wing_centre.stl | white | 48 x 6 x 68 | yes | 1 h 49 min | 18.4 | On its side, spar holes vertical. |
| stl/wing_R.stl | white | 48 x 6 x 88 | yes | 1 h 51 min | 17.0 | Standing on the root rib, brim. |
| stl/wing_L.stl | white | 48 x 6 x 88 | yes | 1 h 48 min | 17.0 | Standing on the root rib, brim. |
| stl/aileron_R.stl | orange | 12 x 79 x 3 | yes | 4 min | 1.9 | Flat on the lower surface. |
| stl/aileron_L.stl | orange | 12 x 79 x 3 | yes | 4 min | 1.9 | Flat on the lower surface. |
| stl/tail_mount.stl | dark grey | 12 x 7 x 15 | yes | 11 min | 0.6 | Front face down. |
| stl/stab.stl | white | 15 x 87 x 1 | yes | 4 min | 1.8 | Flat. |
| stl/elevator.stl | orange | 8 x 87 x 3 | yes | 3 min | 0.9 | Flat. |
| stl/fin.stl | white | 15 x 40 x 1 | yes | 2 min | 0.8 | Flat. |
| stl/rudder.stl | orange | 8 x 39 x 5 | yes | 2 min | 0.4 | Flat, horn up. |
| stl/motor_mount.stl | dark grey | 10 x 10 x 7 | yes | 6 min | 0.3 | Plate down. |
| stl/fairing_ail_R.stl | white | 27 x 19 x 11 | yes | 8 min | 0.9 | Rim down. |
| stl/fairing_ail_L.stl | white | 27 x 19 x 11 | yes | 8 min | 0.9 | Rim down. |
| stl/fuselage_front.stl | dark grey | 59 x 19 x 12 | yes | 11 min | 2.2 | Upright, open top up. |
| stl/fuselage_rear.stl | dark grey | 12 x 19 x 80 | yes | 1 h 02 min | 4.2 | Standing on its front face. |
| stl/lid.stl | grey | 87 x 19 x 4 | yes | 5 min | 2.2 | Flat. |
| stl/rod_boom.stl | black | 161 x 5 x 4 | yes | 10 min | 3.8 | Lying flat on its flat, brim. 100 % infill. |
| stl/rod_spar_main_R.stl | black | 119 x 3 x 3 | yes | 4 min | 1.2 | Lying flat on its flat, brim. 100 % infill. |
| stl/rod_spar_main_L.stl | black | 119 x 3 x 3 | yes | 4 min | 1.2 | Lying flat on its flat, brim. 100 % infill. |
| stl/rod_spar_rear_R.stl | black | 119 x 2 x 2 | yes | 2 min | 0.6 | Lying flat on its flat, brim. 100 % infill. |
| stl/rod_spar_rear_L.stl | black | 119 x 2 x 2 | yes | 2 min | 0.6 | Lying flat on its flat, brim. 100 % infill. |
| stl/dummy_servo_ail_R.stl | as you like | 16 x 15 x 10 | yes | 8 min | 1.2 | Thinnest side down, supports where needed. |
| stl/dummy_servo_ail_L.stl | as you like | 16 x 15 x 10 | yes | 8 min | 1.2 | Thinnest side down, supports where needed. |
| stl/dummy_servo_elev.stl | as you like | 16 x 15 x 9 | yes | 6 min | 0.8 | Thinnest side down, supports where needed. |
| stl/dummy_servo_rud.stl | as you like | 16 x 15 x 9 | yes | 6 min | 0.8 | Thinnest side down, supports where needed. |
| stl/dummy_motor.stl | as you like | 10 x 9 x 9 | yes | 8 min | 0.7 | Thinnest side down, supports where needed. |
| stl/dummy_prop.stl | as you like | 5 x 51 x 4 | yes | 4 min | 0.5 | Thinnest side down, supports where needed. |
| stl/dummy_camera.stl | as you like | 8 x 7 x 7 | yes | 6 min | 0.5 | Thinnest side down, supports where needed. |
| stl/dummy_vtx.stl | as you like | 9 x 11 x 2 | yes | 1 min | 0.1 | Thinnest side down, supports where needed. |
| stl/dummy_antenna.stl | as you like | 18 x 14 x 3 | yes | 2 min | 0.2 | Thinnest side down, supports where needed. |
| stl/dummy_fc.stl | as you like | 16 x 13 x 8 | yes | 6 min | 1.0 | Thinnest side down, supports where needed. |
| stl/dummy_receiver.stl | as you like | 5 x 5 x 1 | yes | 1 min | 0.0 | Thinnest side down, supports where needed. |
| stl/dummy_esc.stl | as you like | 12 x 7 x 1 | yes | 1 min | 0.1 | Thinnest side down, supports where needed. |
| stl/dummy_battery.stl | as you like | 29 x 16 x 9 | yes | 7 min | 1.6 | Thinnest side down, supports where needed. |
| stl/stand.stl | grey | 110 x 84 x 24 | yes | 58 min | 23.1 | Base down. |
| stl/fit_test.stl | any | 80 x 47 x 5 | yes | 33 min | 5.2 | Flat. Print it first. |

## Dummies

One solid each, from the full-size models without their wires and solder pads, scaled, then trimmed wherever it comes within 0.25 mm of a printed part (cut by the part's material near it, moved 0.25 mm in 26 directions), so it drops into its pocket without forcing. The prop is 1.6 times thicker along the shaft (aft of its hub, with a recess for the prop nut) and the antenna 1.6 times thicker (the lid's hole is opened up for it), so they print. A gap of 0 is a face the dummy rests or is glued on, like the motor on its mount.

| dummy | full-size part, mm | trimmed off | gap to the nearest printed part |
|---|---|---|---|
| dummy_servo_ail_R | 32.3 x 30.8 x 20.1 | 5.8 % | 0.14 mm |
| dummy_servo_ail_L | 32.3 x 30.8 x 20.1 | 5.8 % | 0.14 mm |
| dummy_servo_elev | 32.3 x 30.8 x 17.5 | 1.8 % | 0.18 mm |
| dummy_servo_rud | 32.3 x 30.8 x 17.5 | 1.8 % | 0.18 mm |
| dummy_motor | 19.8 x 18 x 18 | 2.9 % | 0.00 mm |
| dummy_prop | 5.6 x 101.6 x 10.6 | 0 % | - |
| dummy_camera | 16.2 x 14 x 14 | 0.5 % | 0.25 mm |
| dummy_vtx | 3 x 21.6 x 19 | 0.3 % | 0.25 mm |
| dummy_antenna | 22.1 x 3.4 x 27 | 0 % | 0.20 mm |
| dummy_fc | 32 x 26 x 16.5 | 0.2 % | 0.17 mm |
| dummy_receiver | 10 x 2.6 x 10 | 0.6 % | 0.18 mm |
| dummy_esc | 23.8 x 14.5 x 2.9 | 2.1 % | 0.25 mm |
| dummy_battery | 58 x 31 x 18 | 2.8 % | 0.18 mm |

## Checks

Interference: no two printed parts overlap, and the dummies, the rods and the stand overlap none of them.

Thin features: printed solid, every part fills at least 98 % of its volume in PrusaSlicer (the lowest is tail_mount), so nothing is too thin to print. Over 100 % is the slicer's lines overlapping a little.

| part | solid fill |
|---|---|
| wing_centre | 106 % |
| wing_R | 111 % |
| wing_L | 111 % |
| aileron_R | 111 % |
| aileron_L | 111 % |
| tail_mount | 98 % |
| stab | 107 % |
| elevator | 119 % |
| fin | 109 % |
| rudder | 119 % |
| motor_mount | 104 % |
| fairing_ail_R | 116 % |
| fairing_ail_L | 116 % |
| fuselage_front | 101 % |
| fuselage_rear | 99 % |
| lid | 117 % |
| rod_boom | 105 % |
| rod_spar_main_R | 108 % |
| rod_spar_main_L | 108 % |
| rod_spar_rear_R | 106 % |
| rod_spar_rear_L | 106 % |

Every file fits the build volume: yes.

## Assembly

In the full-size plane's order ([BOP.md](../single-boom/BOP.md)), with glue in place of the screws and velcro:

1. Glue the two fuselage halves. Slide the boom into its socket and glue it; glue the motor mount on its end and the motor dummy on the mount, then the prop.
2. Slide the tail mount on the boom and glue the stabiliser under it and the fin into its socket. Glue the elevator and the rudder at neutral.
3. Drop the servo, ESC, FC, receiver, VTX and camera dummies into their places in the fuselage; the battery sits in its bay; put on the lid and the antenna.
4. Push the main and rear spar halves in from each wing tip, through the panel into the wing centre, until they meet in the middle. Put the aileron servo dummies in their pockets, glue the fairings over them and the ailerons on.
5. Seat the wing on the fuselage and stand the plane in the stand's cradle.

What it shows: every printed part's fit against its neighbours, the spar and boom paths, the pockets and bays for the bought parts, and the plane's look. What it can't show: the wiring (left off), the pushrods' travel, the full-size print tolerances (the clearances here are re-cut for the model), and the strength.
