henriharmaala1-source/Assembly-grapher/airframe/variants/extreme/REPORT.md

# Single-boom micro FPV pusher: build report (extreme variant)

Generated by `build.py --variant extreme` from the CAD volumes. Do not edit by hand.

## Key numbers

| | |
|---|---|
| Wingspan | 700 mm |
| Chord | 86 mm at the root, 69 mm at the tip, mean 82.4 mm (kipina-opt, 2 deg incidence) |
| Wing | centre 56 mm, then 2 panels of 161 mm a side; the outer ones taper from 189 mm out and twist 3 deg tip-down |
| Spars | main: 5x4 mm carbon tube, tip to tip; rear: 2 mm rod, one through the centre and inner panels, one in each outer panel |
| Wing area | 5.74 dm^2 (aspect ratio 8.5) |
| Length (nose to prop) | 540 mm |
| Boom | 1 x 10x9 mm roll-wrapped carbon, 321 mm long, 84 mm of it in the fuselage's socket |
| Prop clearance | prop 17.8 mm behind the tail's trailing edge |
| Stabiliser | 175 x 52.0 mm (elevator 18.7 mm), 12.2 mm under the boom's axis |
| Fin | 1 x 52.0 x 134 mm on the boom |
| All-up weight | **243 g** (printed parts 112 g) |
| Wing loading | 42.3 g/dm^2 |
| Stall / cruise | 8.41 / 12.2 m/s |
| Top speed (level, estimate) | 19.5 m/s = 70 km/h (pitch speed 86 km/h, CdA 17.8 cm^2) |
| Endurance (rough) | ~10 min on 2S 450 mAh |
| Current (rough) | cruise ~2.2 A (16 W), full throttle at 1:1 thrust ~11 A |
| Thrust target | >= 243 g static (1:1) |
| Tail volumes | Vh 0.50, Vv 0.045 |
| CG target | 28 % of the mean chord = **222.3 mm** from the nose (24.0 mm behind the wing's root LE) |
| CG (computed) | x 222.3 mm, z 0.8 mm |
| Neutral point | 44 % mean chord -> static margin 16 % |
| Battery centre | **91 mm** from the nose (travel 83-99 mm) |

Sizing check with CAD weights: stall 8.41 m/s against the 9.0 m/s limit: **passes**.

Interference check (printed parts against each other, bought parts and wire runs against everything; pushrods in their horns, wires at their own ends and wires against wires excluded): no overlaps.

Analytic structure estimate for comparison: 132 g (CAD printed + rods/tubes: 123 g).

## Mass breakdown

| item | g | x mm |
|---|---|---|
| camera | 3.3 | 8 |
| vtx | 2.7 | 17 |
| antenna | 1.5 | 25 |
| fc | 10.0 | 34 |
| receiver | 1.5 | 42 |
| battery | 27.0 | 91 |
| lid | 8.0 | 96 |
| fuselage_front | 18.3 | 105 |
| wiring | 6.0 | 141 |
| servo_elev | 9.0 | 146 |
| servo_rud | 9.0 | 181 |
| spar_main | 7.6 | 220 |
| esc | 6.0 | 220 |
| wing_outer_L | 8.8 | 231 |
| wing_outer_R | 8.8 | 231 |
| wing_centre | 6.1 | 237 |
| fairing_ail_R | 1.0 | 237 |
| fairing_ail_L | 1.0 | 237 |
| wing_L | 11.9 | 239 |
| wing_R | 11.9 | 239 |
| servo_ail_R | 9.0 | 240 |
| servo_ail_L | 9.0 | 240 |
| fuselage_rear | 12.5 | 243 |
| pushrod_ail_R | 0.2 | 254 |
| pushrod_ail_L | 0.2 | 254 |
| spar_rear_R | 0.8 | 255 |
| spar_rear_L | 0.8 | 255 |
| hardware | 2.0 | 257 |
| spar_rear | 1.8 | 259 |
| horn_ail_R | 0.3 | 265 |
| horn_ail_L | 0.3 | 265 |
| aileron_R | 2.1 | 267 |
| aileron_L | 2.1 | 267 |
| pushrod_elev | 1.3 | 331 |
| pushrod_rud | 1.2 | 345 |
| boom | 7.4 | 359 |
| motor_wires | 1.5 | 365 |
| fin | 3.4 | 483 |
| stab | 4.4 | 484 |
| tail_mount | 4.3 | 484 |
| rudder | 3.0 | 509 |
| elevator | 2.3 | 509 |
| motor_mount | 2.5 | 516 |
| motor | 9.0 | 529 |
| prop | 2.0 | 537 |

## Bought electronics

Outer sizes are from datasheets or retailer listings; the detail inside them (chips, connectors, wire lengths) is representative.

| part | model | size, mm | g |
|---|---|---|---|
| Servos, 4 | Tower Pro SG90 | 22.8 x 12.2 x 22.7 body, 32.3 over the tabs | 36 |
| Motor | 1404, 3800 KV | 18 dia x 12.2 long (bell) | 9 |
| Prop | 4 x 2.5 two-blade | 101.6 dia | 2 |
| ESC | Hobbywing XRotor Micro 30A (BLHeli_S, 2-4S, 30 A, no BEC) | 23.8 x 14.5 x 5.8 | 6.0 |
| Flight controller | Matek F405-WMN (INAV / ArduPilot, 2-6S, 12 outputs, 5 A servo BEC) | 31 x 26 x 16.5, 22 mm hole pattern | 10 |
| Receiver | ELRS 2.4 GHz nano | 10 x 10 x 3 | 1.5 |
| Camera + VTX | 14 mm nano camera, 5.8 GHz AIO VTX | 14 x 14 x 12 ; 20 x 19 x 3 | 6 |
| Antenna | 5.8 GHz whip | 38 long | 1.5 |
| Battery | 2S 450 mAh LiPo, XT30 | 58 x 31 x 13 | 27 |

## Print list

Build volume checked: 180 x 180 x 180 mm (Bambu Lab A1 mini).

| file | material | est. g | on the bed, mm | fits | orientation |
|---|---|---|---|---|---|
| stl/wing_centre.stl | LW-PLA | 6.1 | 86 x 11 x 56 | yes | On its side, spar holes vertical. 0.5 mm walls, 5 % infill. |
| stl/wing_R.stl | LW-PLA | 11.9 | 86 x 11 x 161 | yes | Standing on the root rib, brim. 1 wall, 0 % infill. |
| stl/wing_L.stl | LW-PLA | 11.9 | 86 x 11 x 161 | yes | Standing on the root rib, brim. 1 wall, 0 % infill. |
| stl/wing_outer_R.stl | LW-PLA | 8.8 | 86 x 11 x 161 | yes | Standing on the root rib, brim. 1 wall, 0 % infill. |
| stl/wing_outer_L.stl | LW-PLA | 8.8 | 86 x 11 x 161 | yes | Standing on the root rib, brim. 1 wall, 0 % infill. |
| stl/aileron_R.stl | LW-PLA | 2.1 | 29 x 144 x 7 | yes | Flat on the lower surface. 1 wall, 0 % infill. |
| stl/aileron_L.stl | LW-PLA | 2.1 | 29 x 144 x 7 | yes | Flat on the lower surface. 1 wall, 0 % infill. |
| stl/tail_mount.stl | PLA/PETG | 4.3 | 25 x 13 x 32 | yes | Pads face down. |
| stl/stab.stl | LW-PLA | 4.4 | 33 x 174 x 2 | yes | Flat. 2 top / 2 bottom layers, 15 % infill. |
| stl/elevator.stl | LW-PLA | 2.3 | 18 x 174 x 7 | yes | Top face down, horn up. |
| stl/fin.stl | LW-PLA | 3.4 | 33 x 134 x 2 | yes | Flat. 2 top / 2 bottom layers, 15 % infill. Root into the tail mount's socket. |
| stl/rudder.stl | PLA/PETG | 3.0 | 18 x 133 x 10 | yes | Flat, horn up. 2 top / 2 bottom layers, 15 % infill. |
| stl/motor_mount.stl | PLA/PETG | 2.5 | 20 x 20 x 14 | yes | Plate down. 4 walls, 40 % infill. Glue on the boom's end. |
| stl/fairing_ail_R.stl | LW-PLA | 1.0 | 50 x 36 x 22 | yes | Rim down on the bed, brim. 1 wall, 0 % infill. Glue under the wing over the servo. |
| stl/fairing_ail_L.stl | LW-PLA | 1.0 | 50 x 36 x 22 | yes | Rim down on the bed, brim. 1 wall, 0 % infill. Glue under the wing over the servo. |
| stl/fuselage_front.stl | PLA/PETG | 18.3 | 208 x 38 x 24 | yes | Upright, open top up, wall strips aft. 2 walls, 15 % infill. Across the bed's diagonal. |
| stl/fuselage_rear.stl | PLA/PETG | 12.5 | 24 x 38 x 82 | yes | Standing on its front face. 2 walls, 15 % infill. |
| stl/lid.stl | PLA/PETG | 8.0 | 175 x 38 x 8 | yes | Flat. |

## The boom

One carbon tube carries the tail, the motor and the prop (31 g on its end), 240 mm out from the fuselage's socket. The first bending mode should stay near the twin booms' (about 49 Hz with the tail alone) and far below the motor (377 rev/s at full throttle). Roll-wrapped carbon (E 70 GPa); a pultruded tube is stiffer in bending but weak in twist and splits in a crash.

| tube, mm | g | EI, N m^2 | first bending mode | end bends in a 30 g landing |
|---|---|---|---|---|
| 6x5 | 4.3 | 2.3 | 20 Hz | 18.1 mm |
| 8x7 | 5.9 | 5.8 | 32 Hz | 7.2 mm |
| 8x6 | 10.9 | 9.6 | 40 Hz | 4.3 mm |
| **10x9** | 7.4 | 11.8 | 45 Hz | 3.5 mm |
| 10x8 | 14.1 | 20.3 | 58 Hz | 2.1 mm |
| 12x11 | 9.0 | 20.9 | 60 Hz | 2.0 mm |

## Span sweep (analytic mass model)

Criteria: stall speed <= 9.0 m/s at CLmax 0.957 (comfortable hand launch, FPV-flyable), and the SG90 aileron servo's mounting tabs fit between the spars.

| span mm | chord mm | AUW g | loading g/dm^2 | WCL | stall m/s | servo room mm | Re at stall |
|---|---|---|---|---|---|---|---|
| 300 | 86 | 197 | 79.7 | 50.6 | 11.55 | +2.1 | 68k |
| 320 | 86 | 199 | 75.5 | 46.4 | 11.24 | +2.1 | 66k |
| 340 | 86 | 201 | 71.8 | 42.9 | 10.97 | +2.1 | 65k |
| 360 | 86 | 203 | 68.6 | 39.8 | 10.71 | +2.1 | 63k |
| 380 | 86 | 205 | 65.7 | 37.1 | 10.48 | +2.1 | 62k |
| 400 | 86 | 208 | 63.1 | 34.7 | 10.27 | +2.1 | 61k |
| 420 | 86 | 210 | 60.7 | 32.6 | 10.08 | +2.1 | 59k |
| 440 | 86 | 212 | 58.5 | 30.7 | 9.90 | +2.1 | 58k |
| 460 | 86 | 214 | 56.6 | 29.1 | 9.73 | +2.1 | 57k |
| 480 | 86 | 216 | 54.8 | 27.5 | 9.57 | +2.1 | 56k |
| 500 | 86 | 218 | 53.1 | 26.2 | 9.43 | +2.1 | 56k |
| 520 | 86 | 221 | 51.6 | 24.9 | 9.29 | +2.1 | 55k |
| 540 | 86 | 223 | 50.2 | 23.8 | 9.17 | +2.1 | 54k |
| 560 | 86 | 225 | 48.9 | 22.8 | 9.05 | +2.1 | 53k |

Smallest span meeting the criterion: **570 mm** (design uses 700 mm).

## Wiring

Every wire run is modelled as a body along its route and goes through the interference check above, so a run that is blocked shows up there. Lengths are along the route, plus 20 mm at each end for slack and soldering. An SG90's own lead is about 250 mm.

| Run | Route length | Needs | Extension |
|---|---:|---:|---|
| aileron servo R to FC | 389 mm | 429 mm | 179 mm |
| aileron servo L to FC | 389 mm | 429 mm | 179 mm |
| elevator servo to FC | 128 mm | 168 mm | none |
| rudder servo to FC | 162 mm | 202 mm | none |
| ESC to motor, inside the boom | 322 mm | 362 mm | own wire |
| ESC to battery XT30 | 165 mm | 205 mm | own wire |
