henriharmaala1-source/Assembly-grapher/airframe/variants/optimized/REPORT.md

# Twin-boom micro FPV pusher: build report (optimized variant)

Generated by `build.py --variant optimized` from the CAD volumes. Do not edit by hand.

## Key numbers

| | |
|---|---|
| Wingspan | 485 mm |
| Chord | 97 mm (kipina-opt, 2 deg incidence) |
| Wing area | 4.70 dm^2 (aspect ratio 5.0) |
| Length (nose to elevator TE) | 507 mm |
| Tail booms | 2 x 6x5 mm, 298 mm long, 140 mm apart |
| Prop clearance | 16.2 mm to each boom, 10.7 mm to each pushrod |
| Stabiliser | 175 x 48.0 mm (elevator 17.3 mm) |
| Fins | 2 x 48.0 x 39 mm |
| All-up weight | **226 g** (printed parts 101 g) |
| Wing loading | 48.0 g/dm^2 |
| Stall / cruise | 8.92 / 12.9 m/s |
| Top speed (level, estimate) | 19.1 m/s = 69 km/h (pitch speed 86 km/h, CdA 18.4 cm^2) |
| Endurance (rough) | ~10 min on 2S 450 mAh |
| Current (rough) | cruise ~2.1 A (16 W), full throttle at 1:1 thrust ~10 A |
| Thrust target | >= 226 g static (1:1) |
| Tail volumes | Vh 0.50, Vv 0.045 |
| CG target | 28 % of the chord = **202.5 mm** from the nose (27.2 mm behind the wing's root LE) |
| CG (computed) | x 202.5 mm, z 0.2 mm |
| Neutral point | 41 % chord -> static margin 13 % |
| Battery centre | **91 mm** from the nose (travel 83-99 mm) |

Sizing check with CAD weights: stall 8.92 m/s against the 9.0 m/s limit: **passes**.

Interference check (printed parts against each other, bought parts and wire runs against everything; pushrods in their horns, wires at their own ends and wires against wires excluded): no overlaps.

Analytic structure estimate for comparison: 114 g (CAD printed + rods/tubes: 116 g).

## Mass breakdown

| item | g | x mm |
|---|---|---|
| camera | 3.3 | 8 |
| vtx | 2.7 | 17 |
| antenna | 1.5 | 27 |
| fc | 10.0 | 34 |
| receiver | 1.5 | 42 |
| pod_front | 12.4 | 63 |
| battery | 27.0 | 91 |
| lid | 6.7 | 95 |
| wiring | 6.0 | 138 |
| spar_main | 5.2 | 200 |
| pod_rear | 13.2 | 210 |
| wing_R | 10.6 | 214 |
| wing_L | 10.6 | 214 |
| wing_centre | 21.4 | 219 |
| fairing_ail_R | 1.0 | 221 |
| fairing_ail_L | 1.0 | 221 |
| servo_ail_R | 9.0 | 222 |
| servo_ail_L | 9.0 | 222 |
| servo_elev | 9.0 | 222 |
| servo_rud | 9.0 | 222 |
| fairing_elev | 0.9 | 223 |
| fairing_rud | 0.9 | 223 |
| esc | 6.0 | 237 |
| pushrod_ail_R | 0.2 | 239 |
| pushrod_ail_L | 0.2 | 239 |
| spar_rear | 2.3 | 243 |
| horn_ail_R | 0.3 | 252 |
| horn_ail_L | 0.3 | 252 |
| hardware | 2.0 | 253 |
| aileron_R | 2.7 | 258 |
| aileron_L | 2.7 | 258 |
| motor | 9.0 | 282 |
| prop | 2.0 | 290 |
| tube_L | 4.0 | 339 |
| tube_R | 4.0 | 339 |
| pushrod_rud | 0.3 | 358 |
| pushrod_elev | 0.3 | 360 |
| tail_mount | 4.9 | 473 |
| fin_R | 1.2 | 474 |
| fin_L | 1.2 | 474 |
| stab | 4.1 | 475 |
| bellcrank | 0.2 | 490 |
| rudder_L | 0.9 | 498 |
| rudder_R | 0.9 | 498 |
| joiner_L | 0.3 | 498 |
| joiner_R | 0.3 | 498 |
| elevator | 2.0 | 498 |
| sleeve_R | 1.0 | 499 |
| sleeve_L | 0.2 | 499 |

## Bought electronics

Outer sizes are from datasheets or retailer listings; the detail inside them (chips, connectors, wire lengths) is representative.

| part | model | size, mm | g |
|---|---|---|---|
| Servos, 4 | Tower Pro SG90 | 22.8 x 12.2 x 22.7 body, 32.3 over the tabs | 36 |
| Motor | 1404, 3800 KV | 18 dia x 12.2 long (bell) | 9 |
| Prop | 4 x 2.5 two-blade | 101.6 dia | 2 |
| ESC | Hobbywing XRotor Micro 30A (BLHeli_S, 2-4S, 30 A, no BEC) | 23.8 x 14.5 x 5.8 | 6.0 |
| Flight controller | Matek F405-WMN (INAV / ArduPilot, 2-6S, 12 outputs, 5 A servo BEC) | 31 x 26 x 16.5, 22 mm hole pattern | 10 |
| Receiver | ELRS 2.4 GHz nano | 10 x 10 x 3 | 1.5 |
| Camera + VTX | 14 mm nano camera, 5.8 GHz AIO VTX | 14 x 14 x 12 ; 20 x 19 x 3 | 6 |
| Antenna | 5.8 GHz whip | 38 long | 1.5 |
| Battery | 2S 450 mAh LiPo, XT30 | 58 x 31 x 13 | 27 |

## Print list

Build volume checked: 180 x 180 x 180 mm (Bambu Lab A1 mini).

| file | material | est. g | on the bed, mm | fits | orientation |
|---|---|---|---|---|---|
| stl/wing_centre.stl | LW-PLA | 21.4 | 105 x 21 x 155 | yes | On its side, spar holes vertical. 0.5 mm walls, 5 % infill. |
| stl/wing_R.stl | LW-PLA | 10.6 | 97 x 12 x 165 | yes | Standing on the root rib, brim. 1 wall, 0 % infill. |
| stl/wing_L.stl | LW-PLA | 10.6 | 97 x 12 x 165 | yes | Standing on the root rib, brim. 1 wall, 0 % infill. |
| stl/aileron_R.stl | LW-PLA | 2.7 | 24 x 148 x 6 | yes | Flat on the lower surface. 1 wall, 0 % infill. |
| stl/aileron_L.stl | LW-PLA | 2.7 | 24 x 148 x 6 | yes | Flat on the lower surface. 1 wall, 0 % infill. |
| stl/tail_mount.stl | PLA/PETG | 4.9 | 31 x 156 x 9 | yes | Pads face down. |
| stl/stab.stl | LW-PLA | 4.1 | 31 x 174 x 2 | yes | Flat. 2 top / 2 bottom layers, 15 % infill. |
| stl/elevator.stl | LW-PLA | 2.0 | 17 x 163 x 10 | yes | Top face down, horn up. |
| stl/fin_R.stl | LW-PLA | 1.2 | 30 x 39 x 9 | yes | Outer face down, jaws up. |
| stl/fin_L.stl | LW-PLA | 1.2 | 30 x 39 x 9 | yes | Outer face down, jaws up. |
| stl/rudder_R.stl | PLA/PETG | 0.9 | 17 x 44 x 6 | yes | Outer face down, wire flange up. 2 top / 2 bottom layers, 15 % infill. |
| stl/rudder_L.stl | PLA/PETG | 0.9 | 17 x 44 x 6 | yes | Outer face down, wire flange up. 2 top / 2 bottom layers, 15 % infill. |
| stl/bellcrank.stl | PLA/PETG | 0.2 | 16 x 19 x 2 | yes | Flat. Solid. |
| stl/lid.stl | PLA/PETG | 6.7 | 174 x 39 x 1 | yes | Flat. |
| stl/fairing_ail_R.stl | LW-PLA | 1.0 | 54 x 36 x 20 | yes | Rim down on the bed, brim. 1 wall, 0 % infill. Glue under the wing over the servo. |
| stl/fairing_ail_L.stl | LW-PLA | 1.0 | 54 x 36 x 20 | yes | Rim down on the bed, brim. 1 wall, 0 % infill. Glue under the wing over the servo. |
| stl/fairing_elev.stl | LW-PLA | 0.9 | 68 x 36 x 12 | yes | Rim down on the bed. 1 wall, 0 % infill. Glue under the wing centre. |
| stl/fairing_rud.stl | LW-PLA | 0.9 | 68 x 36 x 12 | yes | Rim down on the bed. 1 wall, 0 % infill. Glue under the wing centre. |
| stl/sleeve_R.stl | PLA/PETG | 1.0 | 6 x 122 x 2 | yes | Flat. Slide on the joiner wire before the Z-bends and glue. |
| stl/sleeve_L.stl | PLA/PETG | 0.2 | 6 x 24 x 2 | yes | Flat. Slide on the joiner wire before the Z-bends and glue. |
| stl/pod_front.stl | PLA/PETG | 12.4 | 138 x 41 x 22 | yes | Upright, open top up. 2 walls, 15 % infill. |
| stl/pod_rear.stl | PLA/PETG | 13.2 | 145 x 41 x 31 | yes | Upright, open top up, tongue forward. 2 walls, 15 % infill. |

## Span sweep (analytic mass model)

Criteria: stall speed <= 9.0 m/s at CLmax 0.967 (comfortable hand launch, FPV-flyable), and the SG90 aileron servo's mounting tabs fit between the spars.

| span mm | chord mm | AUW g | loading g/dm^2 | WCL | stall m/s | servo room mm | Re at stall |
|---|---|---|---|---|---|---|---|
| 300 | 60 | 171 | 95.3 | 70.9 | 12.56 | -8.6 | 52k |
| 320 | 64 | 176 | 86.0 | 60.1 | 11.94 | -6.8 | 52k |
| 340 | 68 | 181 | 78.2 | 51.4 | 11.38 | -5.0 | 53k |
| 360 | 72 | 186 | 71.7 | 44.5 | 10.89 | -3.2 | 54k |
| 380 | 76 | 191 | 66.1 | 38.8 | 10.46 | -1.4 | 54k |
| 400 | 80 | 196 | 61.2 | 34.2 | 10.07 | +0.4 | 55k |
| 420 | 84 | 201 | 57.1 | 30.3 | 9.72 | +2.2 | 56k |
| 440 | 88 | 207 | 53.4 | 27.1 | 9.41 | +4.0 | 57k |
| 460 | 92 | 213 | 50.2 | 24.4 | 9.12 | +5.8 | 57k |
| **480** | 96 | 219 | 47.4 | 22.1 | **8.86** | +7.6 | 58k |
| **500** | 100 | 225 | 45.0 | 20.1 | **8.63** | +9.4 | 59k |
| **520** | 104 | 232 | 42.9 | 18.4 | **8.43** | +11.2 | 60k |
| **540** | 108 | 240 | 41.2 | 17.0 | **8.26** | +13.0 | 61k |
| **560** | 112 | 249 | 39.7 | 15.8 | **8.10** | +14.8 | 62k |

Smallest span meeting the criterion: **470 mm** (design uses 485 mm).
