henriharmaala1-source/Assembly-grapher/airframe/variants/single-boom/REPORT.md

# Single-boom micro FPV pusher: build report (single-boom variant)

Generated by `build.py --variant single-boom` from the CAD volumes. Do not edit by hand.

## Key numbers

| | |
|---|---|
| Wingspan | 485 mm |
| Chord | 97 mm (kipina-opt, 2 deg incidence) |
| Wing area | 4.70 dm^2 (aspect ratio 5.0) |
| Length (nose to prop) | 541 mm |
| Boom | 1 x 10x9 mm roll-wrapped carbon, 323 mm long, 79 mm of it in the fuselage's socket |
| Prop clearance | prop 17.8 mm behind the tail's trailing edge |
| Stabiliser | 175 x 48.0 mm (elevator 17.3 mm), 11.7 mm under the boom's axis |
| Fin | 1 x 48.0 x 79 mm on the boom |
| All-up weight | **227 g** (printed parts 100 g) |
| Wing loading | 48.3 g/dm^2 |
| Stall / cruise | 8.95 / 13.0 m/s |
| Top speed (level, estimate) | 19.7 m/s = 71 km/h (pitch speed 86 km/h, CdA 15.2 cm^2) |
| Endurance (rough) | ~10 min on 2S 450 mAh |
| Current (rough) | cruise ~2.2 A (16 W), full throttle at 1:1 thrust ~10 A |
| Thrust target | >= 227 g static (1:1) |
| Tail volumes | Vh 0.50, Vv 0.045 |
| CG target | 28 % of the chord = **215.9 mm** from the nose (27.2 mm behind the wing's root LE) |
| CG (computed) | x 215.9 mm, z -0.9 mm |
| Neutral point | 41 % chord -> static margin 13 % |
| Battery centre | **91 mm** from the nose (travel 83-99 mm) |

Sizing check with CAD weights: stall 8.95 m/s against the 9.0 m/s limit: **passes**.

Interference check (printed parts against each other, bought parts and wire runs against everything; pushrods in their horns, wires at their own ends and wires against wires excluded): no overlaps.

Analytic structure estimate for comparison: 119 g (CAD printed + rods/tubes: 108 g).

## Mass breakdown

| item | g | x mm |
|---|---|---|
| camera | 3.3 | 8 |
| vtx | 2.7 | 17 |
| antenna | 1.5 | 25 |
| fc | 10.0 | 34 |
| receiver | 1.5 | 42 |
| fuselage_front | 9.8 | 53 |
| battery | 27.0 | 91 |
| lid | 8.0 | 96 |
| wiring | 6.0 | 139 |
| servo_elev | 9.0 | 146 |
| servo_rud | 9.0 | 181 |
| fuselage_rear | 20.2 | 208 |
| spar_main | 5.2 | 213 |
| esc | 6.0 | 215 |
| wing_R | 11.2 | 228 |
| wing_L | 11.2 | 228 |
| wing_centre | 15.9 | 232 |
| fairing_ail_R | 1.0 | 234 |
| fairing_ail_L | 1.0 | 234 |
| servo_ail_R | 9.0 | 235 |
| servo_ail_L | 9.0 | 235 |
| pushrod_ail_L | 0.2 | 252 |
| pushrod_ail_R | 0.2 | 252 |
| spar_rear | 2.3 | 257 |
| hardware | 2.0 | 260 |
| horn_ail_R | 0.3 | 265 |
| horn_ail_L | 0.3 | 265 |
| aileron_R | 2.9 | 272 |
| aileron_L | 2.9 | 272 |
| pushrod_elev | 1.3 | 332 |
| pushrod_rud | 1.2 | 347 |
| boom | 7.5 | 360 |
| motor_wires | 1.5 | 363 |
| fin | 1.9 | 488 |
| stab | 4.1 | 488 |
| tail_mount | 3.9 | 488 |
| rudder | 1.7 | 511 |
| elevator | 2.1 | 512 |
| motor_mount | 2.5 | 518 |
| motor | 9.0 | 531 |
| prop | 2.0 | 538 |

## Bought electronics

Outer sizes are from datasheets or retailer listings; the detail inside them (chips, connectors, wire lengths) is representative.

| part | model | size, mm | g |
|---|---|---|---|
| Servos, 4 | Tower Pro SG90 | 22.8 x 12.2 x 22.7 body, 32.3 over the tabs | 36 |
| Motor | 1404, 3800 KV | 18 dia x 12.2 long (bell) | 9 |
| Prop | 4 x 2.5 two-blade | 101.6 dia | 2 |
| ESC | Hobbywing XRotor Micro 30A (BLHeli_S, 2-4S, 30 A, no BEC) | 23.8 x 14.5 x 5.8 | 6.0 |
| Flight controller | Matek F405-WMN (INAV / ArduPilot, 2-6S, 12 outputs, 5 A servo BEC) | 31 x 26 x 16.5, 22 mm hole pattern | 10 |
| Receiver | ELRS 2.4 GHz nano | 10 x 10 x 3 | 1.5 |
| Camera + VTX | 14 mm nano camera, 5.8 GHz AIO VTX | 14 x 14 x 12 ; 20 x 19 x 3 | 6 |
| Antenna | 5.8 GHz whip | 38 long | 1.5 |
| Battery | 2S 450 mAh LiPo, XT30 | 58 x 31 x 13 | 27 |

## Print list

Build volume checked: 180 x 180 x 180 mm (Bambu Lab A1 mini).

| file | material | est. g | on the bed, mm | fits | orientation |
|---|---|---|---|---|---|
| stl/wing_centre.stl | LW-PLA | 15.9 | 97 x 12 x 135 | yes | On its side, spar holes vertical. 0.5 mm walls, 5 % infill. |
| stl/wing_R.stl | LW-PLA | 11.2 | 97 x 12 x 175 | yes | Standing on the root rib, brim. 1 wall, 0 % infill. |
| stl/wing_L.stl | LW-PLA | 11.2 | 97 x 12 x 175 | yes | Standing on the root rib, brim. 1 wall, 0 % infill. |
| stl/aileron_R.stl | LW-PLA | 2.9 | 24 x 158 x 6 | yes | Flat on the lower surface. 1 wall, 0 % infill. |
| stl/aileron_L.stl | LW-PLA | 2.9 | 24 x 158 x 6 | yes | Flat on the lower surface. 1 wall, 0 % infill. |
| stl/tail_mount.stl | PLA/PETG | 3.9 | 24 x 13 x 30 | yes | Pads face down. |
| stl/stab.stl | LW-PLA | 4.1 | 31 x 174 x 2 | yes | Flat. 2 top / 2 bottom layers, 15 % infill. |
| stl/elevator.stl | LW-PLA | 2.1 | 17 x 174 x 7 | yes | Top face down, horn up. |
| stl/fin.stl | LW-PLA | 1.9 | 30 x 79 x 2 | yes | Flat. 2 top / 2 bottom layers, 15 % infill. Root into the tail mount's socket. |
| stl/rudder.stl | PLA/PETG | 1.7 | 17 x 78 x 10 | yes | Flat, horn up. 2 top / 2 bottom layers, 15 % infill. |
| stl/motor_mount.stl | PLA/PETG | 2.5 | 20 x 20 x 14 | yes | Plate down. 4 walls, 40 % infill. Glue on the boom's end. |
| stl/fairing_ail_R.stl | LW-PLA | 1.0 | 54 x 36 x 20 | yes | Rim down on the bed, brim. 1 wall, 0 % infill. Glue under the wing over the servo. |
| stl/fairing_ail_L.stl | LW-PLA | 1.0 | 54 x 36 x 20 | yes | Rim down on the bed, brim. 1 wall, 0 % infill. Glue under the wing over the servo. |
| stl/fuselage_front.stl | PLA/PETG | 9.8 | 126 x 38 x 24 | yes | Upright, open top up, wall strips aft. 2 walls, 15 % infill. |
| stl/fuselage_rear.stl | PLA/PETG | 20.2 | 24 x 38 x 159 | yes | Standing on its front face. 2 walls, 15 % infill. |
| stl/lid.stl | PLA/PETG | 8.0 | 175 x 38 x 8 | yes | Flat. |

## The boom

One carbon tube carries the tail, the motor and the prop (27 g on its end), 246 mm out from the fuselage's socket. The first bending mode should stay near the twin booms' (about 49 Hz with the tail alone) and far below the motor (377 rev/s at full throttle). Roll-wrapped carbon (E 70 GPa); a pultruded tube is stiffer in bending but weak in twist and splits in a crash.

| tube, mm | g | EI, N m^2 | first bending mode | end bends in a 30 g landing |
|---|---|---|---|---|
| 6x5 | 4.3 | 2.3 | 20 Hz | 17.3 mm |
| 8x7 | 5.9 | 5.8 | 32 Hz | 6.8 mm |
| 8x6 | 11.0 | 9.6 | 41 Hz | 4.1 mm |
| **10x9** | 7.5 | 11.8 | 46 Hz | 3.4 mm |
| 10x8 | 14.1 | 20.3 | 59 Hz | 2.0 mm |
| 12x11 | 9.0 | 20.9 | 61 Hz | 1.9 mm |

## Span sweep (analytic mass model)

Criteria: stall speed <= 9.0 m/s at CLmax 0.967 (comfortable hand launch, FPV-flyable), and the SG90 aileron servo's mounting tabs fit between the spars.

| span mm | chord mm | AUW g | loading g/dm^2 | WCL | stall m/s | servo room mm | Re at stall |
|---|---|---|---|---|---|---|---|
| 300 | 60 | 184 | 102.3 | 76.2 | 13.02 | -8.6 | 54k |
| 320 | 64 | 188 | 91.7 | 64.0 | 12.32 | -6.8 | 54k |
| 340 | 68 | 192 | 82.8 | 54.4 | 11.71 | -5.0 | 55k |
| 360 | 72 | 195 | 75.4 | 46.8 | 11.17 | -3.2 | 55k |
| 380 | 76 | 199 | 69.1 | 40.6 | 10.69 | -1.4 | 56k |
| 400 | 80 | 204 | 63.6 | 35.5 | 10.27 | +0.4 | 56k |
| 420 | 84 | 209 | 59.2 | 31.5 | 9.90 | +2.2 | 57k |
| 440 | 88 | 214 | 55.4 | 28.1 | 9.58 | +4.0 | 58k |
| 460 | 92 | 221 | 52.1 | 25.3 | 9.29 | +5.8 | 59k |
| 480 | 96 | 227 | 49.2 | 22.9 | 9.03 | +7.6 | 59k |
| **500** | 100 | 233 | 46.7 | 20.9 | **8.79** | +9.4 | 60k |
| **520** | 104 | 240 | 44.5 | 19.1 | **8.58** | +11.2 | 61k |
| **540** | 108 | 248 | 42.5 | 17.6 | **8.39** | +13.0 | 62k |
| **560** | 112 | 255 | 40.7 | 16.2 | **8.21** | +14.8 | 63k |

Smallest span meeting the criterion: **490 mm** (design uses 485 mm).

## Wiring

Every wire run is modelled as a body along its route and goes through the interference check above, so a run that is blocked shows up there. Lengths are along the route, plus 20 mm at each end for slack and soldering. An SG90's own lead is about 250 mm.

| Run | Route length | Needs | Extension |
|---|---:|---:|---|
| aileron servo R to FC | 263 mm | 303 mm | 53 mm |
| aileron servo L to FC | 263 mm | 303 mm | 53 mm |
| elevator servo to FC | 128 mm | 168 mm | none |
| rudder servo to FC | 162 mm | 202 mm | none |
| ESC to motor, inside the boom | 328 mm | 368 mm | own wire |
| ESC to battery XT30 | 166 mm | 206 mm | own wire |
