henriharmaala1-source/Assembly-grapher/airframe/BOP.md

# Kipinä: bill of process

Generated by `process.py` from the CAD model and the slicer. Do not edit by hand.

One builder and one Bambu Lab A1 mini. Print times come from PrusaSlicer 2.7, A1-mini-like profile (tools/a1mini.ini); hand times are Boothroyd-Dewhurst handling and insertion estimates plus shop times for gluing, soldering and bending (see `process.py`).

| | |
|---|---|
| Printer time | 8 h 38 min over 5 plates, 97 g of filament |
| Hands-on time | 1 h 46 min (prep, assembly, setup) |
| Epoxy cure waits | 45 min |
| Lead time | **10 h 09 min** with the builder working while the printer runs |
| Critical path | P1 > P2 > P3 > P4 > P5 > Q5 > A8 > A13 > A14 > A15 > A16 > S1 > S2 |

## Precedence graph

Solid arrows: must finish first. Dashed: the printer queue. Highlighted: critical path.

```mermaid
flowchart TB
  P1["P1 Plate 1 PETG"]
  P2["P2 Plate 2"]
  P3["P3 Plate 3"]
  P4["P4 Plate 4"]
  P5["P5 Plate 5"]
  F1["F1 Cut carbon"]
  F2["F2 Make linkages"]
  Q1["Q1 Finish plate 1"]
  Q2["Q2 Finish plate 2"]
  Q3["Q3 Finish plate 3"]
  Q4["Q4 Finish plate 4"]
  Q5["Q5 Finish plate 5"]
  A1["A1 Pod, motor"]
  A2["A2 Camera, VTX"]
  A3["A3 FC, ESC, RX"]
  A4["A4 Solder"]
  A5["A5 Elevator servo"]
  A6["A6 Rudder servo"]
  A7["A7 Join frame"]
  A8["A8 Wing panels"]
  A9["A9 Aileron servos"]
  A10["A10 Ailerons"]
  A11["A11 Tail glue-up"]
  A12["A12 Tail hinges"]
  A13["A13 Tail on tubes"]
  A14["A14 Linkages"]
  A15["A15 Servo leads"]
  A16["A16 Prop, battery"]
  S1["S1 INAV setup"]
  S2["S2 Balance, checks"]
  P1 --> Q1
  P2 --> Q2
  P3 --> Q3
  P4 --> Q4
  P5 --> Q5
  Q1 --> A1
  A1 --> A2
  A2 --> A3
  A3 --> A4
  Q2 --> A5
  A5 --> A6
  A4 --> A7
  A6 --> A7
  F1 --> A7
  A7 --> A8
  Q4 --> A8
  Q5 --> A8
  F1 --> A8
  A8 --> A9
  A9 --> A10
  Q3 --> A10
  F2 --> A10
  Q1 --> A11
  Q2 --> A11
  Q3 --> A11
  A11 --> A12
  Q1 --> A12
  A12 --> A13
  A8 --> A13
  A13 --> A14
  F2 --> A14
  A14 --> A15
  A10 --> A15
  A9 --> A15
  A15 --> A16
  A16 --> S1
  S1 --> S2
  P1 -. printer queue .-> P2
  P2 -. printer queue .-> P3
  P3 -. printer queue .-> P4
  P4 -. printer queue .-> P5
  classDef crit stroke:#E4601A,stroke-width:2px
  class P1,P2,P3,P4,P5,Q5,A8,A13,A14,A15,A16,S1,S2 crit
```

## Operations

| op | operation | station | resource | time | start | end | needs | tools / consumables |
|---|---|---|---|---|---|---|---|---|
| P1 | Print plate 1: pod halves, lid, tail mount, rudders, bellcrank | Print | printer | 1 h 38 min | 0 min | 1 h 38 min | - |  |
| F1 | Cut the carbon tubes and spars | Prep | builder | 3 min | 0 min | 3 min | - | rotary tool or fine saw, ruler, file |
| F2 | Make the pushrods, aileron links and rudder joiners | Prep | builder | 11 min | 3 min | 14 min | - | wire bender or pliers, cutter, heat gun, CA, heat-shrink |
| P2 | Print plate 2: wing centre, fins | Print | printer | 2 h 51 min | 1 h 38 min | 4 h 34 min | - |  |
| Q1 | Finish plate 1 parts, ream tube and pivot holes | Prep | builder | 3 min | 1 h 38 min | 1 h 41 min | P1 | 6.2 / 1.6 mm drill bits in a pin vice |
| A1 | Glue the pod halves, screw the motor to the back wall | Pod | builder | 1 min | 1 h 41 min | 1 h 42 min | Q1 | 1.5 mm hex driver, CA |
| A2 | Fit the camera and VTX | Pod | builder | 1 min | 1 h 42 min | 1 h 43 min | A1 | CA, foam tape |
| A3 | Screw the FC on its posts, drop the ESC into its ribs, add the receiver | Pod | builder | 1 min | 1 h 43 min | 1 h 44 min | A2 | 1.5 mm hex driver, foam tape |
| A4 | Solder the power, motor, video and receiver wiring | Pod | builder | 17 min | 1 h 44 min | 2 h 01 min | A3 | soldering iron, solder, heat-shrink, silicone wire |
| P3 | Print plate 3: stabiliser, elevator, ailerons | Print | printer | 1 h 18 min | 4 h 34 min | 5 h 52 min | - |  |
| Q2 | Finish the wing centre and fins, ream holes | Prep | builder | 2 min | 4 h 34 min | 4 h 36 min | P2 | 6.2 / 3.2 / 2.2 mm drill bits |
| A5 | Glue the elevator servo into the wing centre, right of the pod | Wing | builder | 1 min | 4 h 36 min | 4 h 37 min | Q2 | hot glue |
| A6 | Glue the rudder servo into the wing centre, left of the pod | Wing | builder | 1 min | 4 h 37 min | 4 h 38 min | A5 | hot glue |
| A7 | Glue the pod under the wing centre, push the booms into their sockets | Frame | builder | 3 min + 15 min cure | 4 h 38 min | 4 h 41 min | A4, A6, F1 | 5-minute epoxy |
| P4 | Print plate 4: right wing panel | Print | printer | 1 h 26 min | 5 h 52 min | 7 h 18 min | - |  |
| Q3 | Finish the tail surfaces and ailerons | Prep | builder | 1 min | 5 h 52 min | 5 h 54 min | P3 |  |
| A11 | Glue the stabiliser to the tail mount and the fins to the tips | Tail | builder | 1 min | 5 h 54 min | 5 h 55 min | Q1, Q2, Q3 | CA |
| A12 | Hinge the elevator and rudders, screw on the bellcrank | Tail | builder | 3 min | 5 h 55 min | 5 h 58 min | A11, Q1 | 1.5 mm hex driver, hinge tape |
| P5 | Print plate 5: left wing panel | Print | printer | 1 h 26 min | 7 h 18 min | 8 h 44 min | - |  |
| Q4 | Remove the brim from the right panel, ream spar holes | Prep | builder | 2 min | 7 h 18 min | 7 h 20 min | P4 |  |
| Q5 | Remove the brim from the left panel, ream spar holes | Prep | builder | 2 min | 8 h 44 min | 8 h 45 min | P5 |  |
| A8 | Slide in the spars and glue on both wing panels | Wing | builder | 2 min + 15 min cure | 8 h 45 min | 8 h 48 min | A7, Q4, Q5, F1 | 5-minute epoxy |
| A9 | Fit the aileron servos and route their leads | Wing | builder | 2 min | 9 h 03 min | 9 h 04 min | A8 | hot glue |
| A10 | Hinge the ailerons, glue the horns, fit the links | Wing | builder | 3 min | 9 h 04 min | 9 h 07 min | A9, Q3, F2 | hinge tape, CA |
| A13 | Slide the tail onto the tubes, square it and glue | Frame | builder | 3 min + 15 min cure | 9 h 07 min | 9 h 10 min | A12, A8 | 5-minute epoxy |
| A14 | Run the pushrods along the booms, connect them and the joiners | Final | builder | 2 min | 9 h 25 min | 9 h 27 min | A13, F2 | tape (pushrod guides on the booms) |
| A15 | Plug in the servo leads and tidy the wiring | Final | builder | 1 min | 9 h 27 min | 9 h 28 min | A14, A10, A9 |  |
| A16 | Fit the prop, battery, antenna and lid | Final | builder | 1 min | 9 h 28 min | 9 h 29 min | A15 | prop wrench |
| S1 | Bind the receiver and set up INAV | Setup | builder | 32 min | 9 h 29 min | 10 h 01 min | A16 | laptop with INAV Configurator |
| S2 | Balance and run the pre-flight checks | Setup | builder | 8 min | 10 h 01 min | 10 h 09 min | S1 | CG balancer or fingertips |

## Parts per operation

- **P1** pod_front, pod_rear, lid, tail_mount, rudder_R, rudder_L, bellcrank
- **P2** wing_centre, fin_R, fin_L
- **P3** stab, elevator, aileron_R, aileron_L
- **P4** wing_R
- **P5** wing_L
- **A1** pod_front, pod_rear, motor, M2 screw (motor)
- **A2** camera, vtx
- **A3** fc, M2 screw (FC), esc, receiver
- **A5** servo_elev, servo horn (elevator), horn screw
- **A6** servo_rud, servo horn (rudder), horn screw
- **A7** wing_centre, tube_L, tube_R
- **A8** spar_main, spar_rear, wing_R, wing_L
- **A9** servo_ail_R, servo_ail_L
- **A10** aileron_R, aileron_L, horn_ail_R, horn_ail_L, pushrod_ail_R, pushrod_ail_L
- **A11** tail_mount, stab, fin_R, fin_L
- **A12** elevator, rudder_R, rudder_L, bellcrank, M2 screw (bellcrank)
- **A13** tail sub-assembly
- **A14** pushrod_elev, pushrod_rud, joiner_R, joiner_L
- **A16** prop, battery, antenna, lid
