henriharmaala1-source/Assembly-grapher/airframe/DFMA.md

# Kipinä: DFMA analysis

Generated by `process.py`. Do not edit by hand.

## Design for assembly (Boothroyd-Dewhurst, manual)

| | |
|---|---|
| Parts and fasteners assembled | 54 |
| Theoretical minimum part count | 26 |
| Handling + insertion time | 408 s |
| Plus separate processes (glue, solder, tape, bend) | 2117 s |
| Total manual assembly time | 2525 s (42 min) |
| Design efficiency, handling + insertion only | 19% |
| Design efficiency, including processes | **3%** |
| After the suggestions below | 46 parts, 1890 s, efficiency 4% |

Design efficiency = 3 s x theoretical minimum parts / actual assembly time. Handling and inserting parts is only a fifth of the assembly time; gluing, soldering, taping and bending take the rest, so the biggest wins remove joints, not just parts.

A part counts toward the theoretical minimum when it moves relative to the parts already assembled, must be a different material, or must be separate for assembly or service.

### Redesign suggestions

| suggestion | parts removed | time saved | trade-off |
|---|---|---|---|
| Print the aileron control horns into the ailerons | 2 | 48 s | PETG ailerons, or a thicker LW-PLA horn; +0.3 g |
| Use an FC with a built-in ELRS receiver | 1 | 147 s | few wing FCs have one (the Matek F405-WTE does, but it is 44 mm long and end-of-life) |
| Use a nano camera with an integrated VTX | 1 | 107 s | fixed VTX power, harder to replace |
| Print the tail mount and fins in one piece with the stabiliser (PETG) | 3 | 75 s | about +3 g in the tail (PETG instead of LW-PLA), needs supports under the fins |
| Replace tape hinges with printed pin hinges | 0 | 100 s | stiffer surfaces, 0.8 mm pins; slightly more drag at the gap |
| Key the tube ends (a flat) so the tail squares itself | 0 | 60 s | a file stroke per tube; no alignment jig needed |
| One U-shaped joiner wire instead of two joiners | 1 | 26 s | must be threaded past the bellcrank |
| Snap-fit tabs for the servos instead of hot glue | 0 | 72 s | SG90 clones vary; needs a test print of the pocket |

### Assembly worksheet

| op | item | qty | handling | insertion | s each | s total | min parts | reason |
|---|---|---|---|---|---|---|---|---|
| A1 | pod_front | 1 | H10 | I00 | 3.00 | 3.00 | 1 | base part |
| A1 | pod_rear | 1 | H10 | I08 | 8.00 | 8.00 | 0 | separate only for the 180 mm bed |
| A1 | motor | 1 | H10 | I06 | 7.00 | 7.00 | 1 | rotates |
| A1 | M2 screw (motor) | 4 | Hs | I38 | 8.50 | 34.00 | 0 | fastener |
| A2 | camera | 1 | H00 | I08 | 7.63 | 7.63 | 1 | separate function, optics |
| A2 | vtx | 1 | H00 | I06 | 6.63 | 6.63 | 0 | could be one camera+VTX module |
| A3 | fc | 1 | H00 | I01 | 3.63 | 3.63 | 1 | separate electronics |
| A3 | M2 screw (FC) | 4 | Hs | I38 | 8.50 | 34.00 | 0 | fastener |
| A3 | esc | 1 | H10 | I01 | 4.00 | 4.00 | 0 | could be integrated in the FC |
| A3 | receiver | 1 | H10 | I06 | 7.00 | 7.00 | 0 | could be integrated in the FC |
| A5 | servo_elev | 1 | H10 | I08 | 8.00 | 8.00 | 1 | moves |
| A5 | servo horn (elevator) | 1 | Hs | I01 | 5.00 | 5.00 | 0 | supplied with the servo |
| A5 | horn screw | 1 | Hs | I38 | 8.50 | 8.50 | 0 | fastener |
| A6 | servo_rud | 1 | H10 | I08 | 8.00 | 8.00 | 1 | moves |
| A6 | servo horn (rudder) | 1 | Hs | I01 | 5.00 | 5.00 | 0 | supplied with the servo |
| A6 | horn screw | 1 | Hs | I38 | 8.50 | 8.50 | 0 | fastener |
| A7 | wing_centre | 1 | H10 | I08 | 8.00 | 8.00 | 1 | different material (LW-PLA) |
| A7 | tube_L | 1 | H2h | I03 | 6.50 | 6.50 | 1 | different material (carbon) |
| A7 | tube_R | 1 | H2h | I03 | 6.50 | 6.50 | 0 | could be one U-frame with tube_L |
| A8 | spar_main | 1 | H2h | I03 | 6.50 | 6.50 | 1 | different material (carbon) |
| A8 | spar_rear | 1 | H2h | I03 | 6.50 | 6.50 | 0 | could merge with the main spar |
| A8 | wing_R | 1 | H2h | I08 | 9.50 | 9.50 | 0 | separate only for the 180 mm bed |
| A8 | wing_L | 1 | H2h | I08 | 9.50 | 9.50 | 0 | separate only for the 180 mm bed |
| A9 | servo_ail_R | 1 | H10 | I08 | 8.00 | 8.00 | 1 | moves |
| A9 | servo_ail_L | 1 | H10 | I08 | 8.00 | 8.00 | 1 | moves |
| A10 | aileron_R | 1 | H10 | I08 | 8.00 | 8.00 | 1 | moves |
| A10 | aileron_L | 1 | H10 | I08 | 8.00 | 8.00 | 1 | moves |
| A10 | horn_ail_R | 1 | Hs | I08 | 9.00 | 9.00 | 0 | could be printed into the aileron |
| A10 | horn_ail_L | 1 | Hs | I08 | 9.00 | 9.00 | 0 | could be printed into the aileron |
| A10 | pushrod_ail_R | 1 | Hf | I03 | 7.50 | 7.50 | 1 | moves |
| A10 | pushrod_ail_L | 1 | Hf | I03 | 7.50 | 7.50 | 1 | moves |
| A11 | tail_mount | 1 | H10 | I00 | 3.00 | 3.00 | 0 | could be printed with the stabiliser |
| A11 | stab | 1 | H10 | I08 | 8.00 | 8.00 | 1 | different material (LW-PLA) |
| A11 | fin_R | 1 | H00 | I31 | 6.13 | 6.13 | 0 | could be printed with the stabiliser |
| A11 | fin_L | 1 | H00 | I31 | 6.13 | 6.13 | 0 | could be printed with the stabiliser |
| A12 | elevator | 1 | H10 | I08 | 8.00 | 8.00 | 1 | moves |
| A12 | rudder_R | 1 | H00 | I08 | 7.63 | 7.63 | 1 | moves |
| A12 | rudder_L | 1 | H00 | I08 | 7.63 | 7.63 | 1 | moves |
| A12 | bellcrank | 1 | Hs | I01 | 5.00 | 5.00 | 1 | moves |
| A12 | M2 screw (bellcrank) | 1 | Hs | I39 | 10.50 | 10.50 | 0 | fastener |
| A13 | tail sub-assembly | 1 | H2h | I08 | 9.50 | 9.50 | 0 | sub-assembly, already counted |
| A14 | pushrod_elev | 1 | Hf | I03 | 7.50 | 7.50 | 1 | moves |
| A14 | pushrod_rud | 1 | Hf | I03 | 7.50 | 7.50 | 1 | moves |
| A14 | joiner_R | 1 | Hf | I08 | 10.50 | 10.50 | 1 | moves |
| A14 | joiner_L | 1 | Hf | I08 | 10.50 | 10.50 | 0 | could be one wire with joiner_R |
| A16 | prop | 1 | H10 | I38 | 7.50 | 7.50 | 1 | rotates, replaced after crashes |
| A16 | battery | 1 | H10 | I06 | 7.00 | 7.00 | 1 | removed for charging |
| A16 | antenna | 1 | Hf | I01 | 6.50 | 6.50 | 0 | part of the VTX |
| A16 | lid | 1 | H00 | I30 | 3.13 | 3.13 | 1 | opened for battery changes |

Handling classes: H00 1.13 s (one hand, easy to grasp, symmetric (alpha+beta < 360 deg)); H10 1.5 s (one hand, alpha+beta 360-540 deg); H20 1.8 s (one hand, alpha+beta 540-720 deg); Hs 2.5 s (small part, fingertips or tweezers (M2 screw, horn)); Hf 4.0 s (flexible or tangles (wire, lead, pushrod)); H2h 3.0 s (long or large, two hands (tube, spar, wing panel)).

Insertion classes: I00 1.5 s (placed, no holding, easy to align); I01 2.5 s (placed, not easy to align); I03 3.5 s (placed, hard to align, resistance); I06 5.5 s (held during the next step, easy to align); I08 6.5 s (held during the next step, hard to align); I30 2.0 s (snap or press fit, easy); I31 5.0 s (press fit with resistance); I38 6.0 s (screwed in immediately, easy); I39 8.0 s (screwed in immediately, awkward access).

Process times: ca 15 s (CA glue joint: apply and hold); epoxy_mix 60 s (mix a batch of 5-minute epoxy); epoxy 20 s (epoxy joint); hotglue 20 s (hot-glue a servo in its pocket); solder 25 s (solder joint, tinned); shrink 15 s (heat-shrink sleeve); tape 10 s (double-sided tape pad); tape_hinge 40 s (tape hinge, top and bottom); strap 20 s (velcro strap); cut_tube 60 s (mark, cut and deburr a carbon tube); cut_rod 30 s (cut a carbon rod or wire); z_bend 30 s (Z-bend in 0.8 mm wire); l_bend 20 s (L-bend in 0.8 mm wire); rod_end 40 s (glue a wire end into a carbon rod, shrink); trim_horn 30 s (trim a servo horn); ream 15 s (ream a hole with a hand drill); unplate 20 s (take a part off the plate, clean edges); brim 60 s (remove a brim); route 30 s (route a servo lead); hook 15 s (hook a pushrod end into a horn); square 60 s (sight and square the tail to the wing); plug 8 s (plug a lead into the FC); plate_swap 120 s (clear the plate, start the next job); bind 120 s (bind the receiver); config 1800 s (INAV setup: mixer, servo directions, endpoints, OSD); balance 180 s (set the battery position for the CG); checks 300 s (control directions, throws, failsafe, range check).

## Design for manufacture (3D printing)

Sliced with PrusaSlicer 2.7, A1-mini-like profile (tools/a1mini.ini). Overhangs: down-facing surfaces steeper than 45 deg from vertical, above the first layer. Regions narrower than 10 mm (hole tops, chamfers) print without support; flat ceilings up to 30 mm are bridges.

| part | material | print time | filament | cost | overhang area | support | notes |
|---|---|---|---|---|---|---|---|
| wing_centre | LW-PLA | 150 min | 22.7 g | 1.25 EUR | 3505 mm^2 | none | tall and thin (height/width 7); brim and slow Y moves on a bed-slinger |
| wing_R | LW-PLA | 84 min | 9.3 g | 0.51 EUR | 408 mm^2 | none | tall and thin (height/width 13); brim and slow Y moves on a bed-slinger |
| wing_L | LW-PLA | 84 min | 9.3 g | 0.51 EUR | 408 mm^2 | none | tall and thin (height/width 13); brim and slow Y moves on a bed-slinger |
| aileron_R | LW-PLA | 17 min | 2.5 g | 0.14 EUR | 12 mm^2 | none | small bed contact (125 mm^2); use a brim or glue stick |
| aileron_L | LW-PLA | 17 min | 2.5 g | 0.14 EUR | 12 mm^2 | none | small bed contact (125 mm^2); use a brim or glue stick |
| tail_mount | PLA/PETG | 14 min | 5.1 g | 0.10 EUR | 277 mm^2 | none | - |
| stab | LW-PLA | 27 min | 4.0 g | 0.22 EUR | 0 mm^2 | none | - |
| elevator | LW-PLA | 16 min | 2.1 g | 0.11 EUR | 1 mm^2 | none | - |
| fin_R | LW-PLA | 9 min | 1.2 g | 0.07 EUR | 0 mm^2 | none | - |
| fin_L | LW-PLA | 9 min | 1.2 g | 0.07 EUR | 0 mm^2 | none | - |
| rudder_R | PLA/PETG | 4 min | 1.2 g | 0.02 EUR | 3 mm^2 | none | - |
| rudder_L | PLA/PETG | 4 min | 1.1 g | 0.02 EUR | 3 mm^2 | none | - |
| bellcrank | PLA/PETG | 1 min | 0.3 g | 0.01 EUR | 0 mm^2 | none | small bed contact (123 mm^2); use a brim or glue stick |
| lid | PLA/PETG | 14 min | 7.0 g | 0.14 EUR | 0 mm^2 | none | - |
| pod_front | PLA/PETG | 24 min | 12.7 g | 0.25 EUR | 401 mm^2 | none | - |
| pod_rear | PLA/PETG | 36 min | 14.6 g | 0.29 EUR | 426 mm^2 | none | - |

Total: 8 h 38 min of printing, 97 g of filament, about 3.85 EUR of material (PETG 20 EUR/kg, LW-PLA 55 EUR/kg).

## Cost

| item | qty | EUR each | EUR |
|---|---|---|---|
| SG90 servo | 4 | 3.00 | 12.00 |
| 1404 motor, 3000-3800 KV | 1 | 15.00 | 15.00 |
| 4x2.5 prop (pair) | 1 | 1.00 | 1.00 |
| Hobbywing XRotor Micro 30A ESC | 1 | 15.00 | 15.00 |
| Matek F405-WMN wing FC | 1 | 55.00 | 55.00 |
| ELRS nano receiver | 1 | 10.00 | 10.00 |
| nano camera 14 mm | 1 | 15.00 | 15.00 |
| VTX 25-200 mW | 1 | 15.00 | 15.00 |
| 5.8 GHz whip antenna | 1 | 3.00 | 3.00 |
| 2S 450 mAh LiPo | 1 | 8.00 | 8.00 |
| carbon tube 6x5 x 500 mm | 2 | 3.00 | 6.00 |
| carbon rod 3 / 2 mm | 2 | 2.00 | 4.00 |
| pushrod rod, wire, horns | 1 | 3.00 | 3.00 |
| screws, tape, velcro, glue | 1 | 4.00 | 4.00 |
| printed parts: filament actually used (97 g: 55 g LW-PLA, 42 g PETG) | 1 | 3.85 | 3.85 |
| **per airframe** | | | **170** |

The whole printed airframe, wing included, is only 97 g of filament: the wing sections are thin one-wall LW-PLA shells (46 g for the centre, both panels and both ailerons). So the filament per airframe is a few euros, but a first build still has to buy the spools:

| first build | EUR |
|---|---|
| bought parts | 166 |
| LW-PLA spool, 750 g | 45 |
| PETG spool, 1 kg | 20 |
| **first build outlay** | **231** |

Budget some LW-PLA for calibration: test cubes to set the flow, and possibly a failed 1.5-hour wing panel. Later airframes from the same spools cost the bought parts plus a few euros of filament.

Prices are rough street prices for comparison only; the flight controller is the biggest item.
