henriharmaala1-source/Assembly-grapher/research_notes/MK4 Knight 10 inch frame/eastern_europe_sources.md

# MK4 Knight 10-inch FPV frame: Ukrainian, Russian and other Eastern European sources

Method note (applies to every section): research done 2026-10-27 using web search summaries only. All direct page fetches were blocked. curl got HTTP 403 from the session proxy on CONNECT to prom.ua, rozetka.com.ua, olx.ua, allegro.pl and fpvkit.com.ua. WebFetch failed with DNS errors (ENOTFOUND) for fpvkit.com.ua, thebravetech.com and rcsearch.ru. So every figure below comes from search-engine snippets and summaries of the cited pages, not from reading the pages myself. Treat them as unverified seller claims until a page can be opened.

Search terms tried: "рама MK4 Knight 10 дюймів", "MK4 Knight", "Mark4 Knight" frame 10 inch, "рама Лицар 10 FPV", "Лицар" рама дрона 10 дюймів карбон, "рама Рыцарь 10 дюймов квадрокоптер", "Knight" рама 10" prom.ua, "Knight 10" рама дрон, Knight рама 10 дюймів (limited to prom.ua, rozetka, olx, epicentrk, thebravetech, modelistam), "Caddx Knight" 10 рама вес толщина лучей, Caddx Knight 10 колісна база 415 мм, caddxfpv Knight 10 inch frame kit, rama "Knight 10" dron FPV Allegro.

## Which Ukrainian or Eastern European shops list an "MK4 Knight" 10" frame?

### Takeaway
No search found a product called "MK4 Knight", "Mark4 Knight", "Лицар" or "Рыцарь" as a 10-inch frame in Ukrainian, Russian or Polish sources. The only "Knight" 10-inch frame in Eastern European shops is the **CADDX Knight 10" V2 (8mm)**. The Ukrainian shop BraveTech sells it, and the Russian aggregator rcsearch.ru lists it. Russian shops also sell a ready-built Caddx Knight 10 drone. "MK4 Knight" is most likely a mix-up of "Mark4" and "Caddx Knight", or a seller's informal name. I found no evidence for that, though.

### Cited Findings
- A search for "MK4 Knight" returned only unrelated items (a watch, a CS2 skin, a military vehicle) and no drone frame — [search result example: mstrwatches MK4 Moon Knight](https://www.mstrwatches.com/products/am278mv-mk4-moon-knight-silver-watch)
- Searches for "рама MK4 Knight 10 дюймів" returned only plain Mark4 10" frames from Ukrainian shops (FlyTeam, UDC, diyshop, fpvkit, FIBERFORM via Alexandron, Azimyth), none named Knight — [FlyTeam Mark 4 10 v2](https://flyteam.com.ua/frame/mark410v2); [UDC Mark4 10](https://www.udc.net.ua/en/products/udc-mark4-10); [fpvkit Mark4 10" v2](https://fpvkit.com.ua/en/products/frame-kit-mark4-10-v2); [FIBERFORM Mark4 10 at Alexandron](https://alexandron.shop/ukrainska-rama-dlia-drona-marko4-10-diuimiv-fiberform-mark4-10/)
- Searches for "Лицар" and "Рыцарь" with рама/10 дюймів returned no matching product, only other 10" frames (FiberForm 10, Mark4 V2 10 at fx-drones, XL10 V6 at BNBFLY, Pilotix, Pumpkin 10) — [FiberForm 10 at Flash Army](https://flasharmy.com.ua/karbonova-rama-fiberform-10-dyujmiv-dlya-fpv-drona); [fx-drones Mark4 V2 10](https://fx-drones.com/rama-readytosky-mark4-v2-10-427mm-karbonova-rama-10-diuimovoho-fpv-drona/)
- The Ukrainian shop **BraveTech** sells "Рама CADDX Knight 10" V2 (8mm)". The listing says 1250 UAH, marked down from 1450 UAH, with delivery in Ukraine within 5 days — [BraveTech CADDX Knight 10" V2 (8mm)](https://thebravetech.com/product/frame-caddx-knight-10-v2-8mm/)
- BraveTech also lists a smaller sibling, "Рама CADDX Knight 08 V2 (8mm)" — [BraveTech CADDX Knight 08 V2 (8mm)](https://thebravetech.com/product/frame-caddx-knight-08-v2-8mm/); [BraveTech frames category](https://thebravetech.com/product-category/fpv/frames/)
- The Russian price aggregator **rcsearch.ru** has a "Caddx Knight 10" frame kit" page in its 10" frames category. The summary reports two shop offers and a price of about ₽5359. Search summaries disagreed on whether the page gives specs — [rcsearch.ru Caddx Knight 10" frame kit](https://rcsearch.ru/-c50479); [rcsearch.ru 10" frames](https://rcsearch.ru/-c6769)
- Russian shops (detsys.ru, fnsmart.ru, copterparts.ru, zarya-russia.ru) sell a **ready-built "Caddx Knight 10"** drone. They give its dry weight without battery and accessories as 786 g. detsys.ru lists it under a "military drones" (военные) catalog category, so it is marketed for military use. No further details are recorded here — [detsys.ru](https://detsys.ru/catalog/drony_i_kvadrokoptery/dron_fpv_caddx_knight_10_na_opticheskom_volokne/); [fnsmart.ru](https://fnsmart.ru/kvadrokopter-fpv-caddx-knight10-1-2-elrs915/); [copterparts.ru](https://copterparts.ru/product/%D0%BA%D0%B2%D0%B0%D0%B4%D1%80%D0%BE%D0%BA%D0%BE%D0%BF%D1%82%D0%B5%D1%80-fpv-caddx-knight-10-vtx-1-2-elrs-915/); [zarya-russia.ru](https://zarya-russia.ru/snabzhenie/bpla/fpv/drone/tproduct/1157356966-803438114552-caddx-knight-10-vtx-12-elrs-915-nochnaya)
- The Ukrainian shop modelistam.com.ua lists a "Квадрокоптер Caddx 10" PNP (without battery)", but I could not get its specs — [modelistam Caddx 10" PNP](https://modelistam.com.ua/ua/kvadrokopter-caddx-pnp-without-battery-p-48065/)
- A search of the CaddxFPV brand found no official Caddx product or spec page for a "Knight 10" frame — [search found only a Pinterest pin and the rcsearch listing](https://in.pinterest.com/pin/caddxfpv-10inch-frame-kit-replacement-for-racing-drone-carbon-fiber-x-7-inches-frame-for-fpv--4592545847708200960/)
- Searches limited to Prom.ua, Rozetka, OLX and Epicentr for "Knight рама 10 дюймів" turned up only the BraveTech Caddx Knight page and unrelated 10" frames: Diatone KN-104 (Prom), Mark4 V2 10 (Rozetka), Axis Flying Manta X 10 at 457 mm (Rozetka) and a textolite 10" frame (Epicentr) — [Prom Diatone KN-104](https://prom.ua/ua/p2246243771-rama-dlya-drona.html); [Rozetka Mark4 V2 10](https://rozetka.com.ua/ua/419120838/p419120838/); [Epicentr textolite 10" frame](https://epicentrk.ua/ua/shop/rama-tekstolitova-dlia-fpv-dronu-10-diuimiv.html)
- An Allegro/Polish-language search found no "Knight 10" frame — [rcdrone.top PL 10" category (only near match)](https://rcdrone.top/pl/collections/10-inch-fpv-frame)
- Not to be confused with **BETAFPV X-Knight**, a 3"/4"/5" toothpick frame (140/160/200 mm wheelbase). It is not a 10" frame — [BETAFPV X-Knight](https://betafpv.com/products/x-knight-4inch-fpv-racing-carbon-fiber-frame-kit)
- **Diatone KN-104** ("KN") is a different 10" frame: about 440 mm diagonal, 2 mm top plate, 1.5 mm bottom plate, 23x25x150 mm carbon beam arms, 19x19 M3 motor holes, 30.5x30.5 stack, 615 g, about 3203–3209 UAH. No source called it "Knight" — [FlyTeam KN-104](https://flyteam.com.ua/frameand/Diatone_KN104); [flymod KN-104](https://flymod.net/en/item/diatone_kn104_frame_kit)

### Inferences
- The user's "MK4 Knight" is probably the CADDX Knight 10" V2 (8 mm arms). It is the only "Knight" 10" frame in Eastern European retail, and its 8 mm arm matches what the user suspects. The "MK4" part may come from its Mark4-like X layout or from a seller's listing title. This is inference, not confirmed.
- The "V2 (8mm)" in the name suggests an earlier V1 with a different arm thickness may exist. No source confirmed one.
- OLX, Prom and Rozetka index poorly in the search tool, so a private OLX listing using "MK4 Knight" cannot be ruled out.

### Gaps
- I could not open any Prom.ua, Rozetka, OLX, Allegro, Epicentr, fpvkit or BraveTech page (proxy 403 or DNS failure), so I could not check listings directly or search inside those sites.
- No Telegram channel mirrors mentioning "MK4 Knight" or "Knight 10" turned up in search results.
- I found no Polish, Baltic or other Eastern European listing for any Knight 10" frame.
- I found no official Caddx product page, so the maker attribution relies on the shop's title "CADDX Knight".

## What arm thickness and material are stated?

### Takeaway
The CADDX Knight 10" V2 is listed with **8 mm carbon-fibre (вуглепластик) arms**. No fibreglass/склотекстоліт version was found. Plain Mark4 10" V2 clones sold in Ukraine use 7.5 mm carbon arms.

### Cited Findings
- CADDX Knight 10" V2 (8mm) specs, as given in search summaries of the listing:
  - frame type X-Type, wheelbase 415 mm, material carbon fibre (вуглепластик)
  - top plate 2 mm, bottom plate 3 mm, arms 8 mm
  - stack mounting 20x20 mm and 30.5x30.5 mm, motor mounting Ф16–19 mm
  - internal height 35 mm, aimed at long-range builds

  [BraveTech](https://thebravetech.com/product/frame-caddx-knight-10-v2-8mm/)
- One search summary said the BraveTech listing was about 224 days old at search time — [BraveTech](https://thebravetech.com/product/frame-caddx-knight-10-v2-8mm/)
- For comparison, the Mark4 10" V2 sold by fpvkit.com.ua is listed as X-type, 427 mm wheelbase, 268.18 x 332.07 mm, 3 mm bottom and middle plates, 2 mm top plate and 7.5 mm arms — [fpvkit Mark4 10" v2](https://fpvkit.com.ua/en/products/frame-kit-mark4-10-v2)
- Other Mark4 V2 10" listings also give 7.5 mm arms and a 427 mm wheelbase — [AliExpress Mark4 V2](https://www.aliexpress.com/item/1005005897270664.html); [Rotorama Readytosky Mark4 10 V2](https://www.rotorama.com/product/readytosky-mark4-10-v2)
- Caddx's different X10 frame is listed with 6 mm arms and 338 x 299 x 34 mm. It is not the Knight — [hobbypark.by Caddx X10](https://hobbypark.by/catalog/kvadrokoptery_professionalnye/kvadrokopter_caddx_x10_komplektatsiya_ir/)

### Inferences
- If the user's frame is the Caddx Knight 10 V2, the suspected 8 mm arm matches the listing.
- No middle-plate thickness was given for the Knight. Its 2 mm top and 3 mm bottom plates fit a two-plate stack with a 35 mm internal height, rather than the three-plate Mark4 V2 (3/3/2 mm). This is inferred from the spec list only.

### Gaps
- Arm width, arm length, arm-bolt count and spacing, and standoff count, diameter and spacing are not given in any snippet found.
- I found no bare-frame weight for the Knight 10 V2. The 786 g figure is for the complete drone without battery.
- I found no camera-mount width or VTX hole pattern for the Knight.

## What wheelbase and outline are stated, and is it a GEPRC-style or V2-style Mark4 derivative?

### Takeaway
The Knight 10" V2 is listed at **415 mm** wheelbase. That fits neither the GEPRC Mark4 10 (428 mm, 303 x 376 mm) nor the Mark4 V2 10 (427 mm, 268 x 332 mm). I found no outline dimensions for it.

### Cited Findings
- Knight 10" V2 wheelbase is 415 mm. BraveTech's catalog has two frames listed at 415 mm, so identify the frame by model name, not wheelbase — [BraveTech Knight 10 V2](https://thebravetech.com/product/frame-caddx-knight-10-v2-8mm/); [BraveTech frames category](https://thebravetech.com/product-category/fpv/frames/)
- GEPRC Mark4 10" reference: 376 x 303 mm, 428 mm motor-to-motor (one listing says 429 mm), 270 g — [RMRC GEPRC Mark4 10](https://www.readymaderc.com/products/details/86588-geprc-mark4-10-multirotor-frame); [TBS GEPRC Mark4 10](https://www.team-blacksheep.com/products/product:7652)
- Mark4 V2 10" reference: 427 mm, 268.18 x 332.07 mm, 7.5 mm arms — [fpvkit Mark4 10" v2](https://fpvkit.com.ua/en/products/frame-kit-mark4-10-v2); [UDC Mark4 10](https://www.udc.net.ua/en/products/udc-mark4-10)
- Readytosky Mark4 10" V2 listing gives conflicting diagonals (473 mm and 427 mm) — [Rotorama](https://www.rotorama.com/product/readytosky-mark4-10-v2)
- Other 10" frames near 415 mm in the region: HGLRC MY10 at 415 mm with 7 mm arms, iFlight Nazgul XL10 V6 at 420 mm with 7 mm arms (8 mm in some clone listings), Pilotix PT10 V2 at 425 mm with 7 mm arms — [fpv24 HGLRC MY10](https://www.fpv24.com/en/hglrc/hglrc-my10-10-inch-heavy-lift-long-range-fpv-frame); [openelab Nazgul XL10 V6 (PL)](https://openelab.io/pl/products/iflight-nazgul-xl10-v6-10); [Amazon XL10 V6 8 mm clone](https://www.amazon.com/BayDe-10inch-Compatible-System-Replacement/dp/B0CPL9PHMS); [Rotorama Pilotix PT10 V2](https://www.rotorama.com/product/pilotix-frame-pilotix-pt10-v2)

### Inferences
- A 415 mm wheelbase points to a separate design, or a shortened X derivative, not a direct copy of either Mark4 variant. Its 415 mm and 8 mm arms are closer to long-range frames like the HGLRC MY10 (415 mm) and the XL10 V6 8 mm clones (420 mm). Whether it is a Mark4 derivative at all is unconfirmed.
- If the user's frame measures about 427–428 mm motor-to-motor, it is probably a Mark4 V2 or GEPRC clone sold under a "Knight" name, not the Caddx Knight 10 V2. A measured motor-to-motor diagonal would settle this.

### Gaps
- I found no outline (length x width) or height-over-plates for the Knight 10 V2.
- I found no published standoff or arm-bolt spacing for any "Knight" 10" frame.

## Are drawings, DXF/STEP files or measured photos available?

### Takeaway
I found no drawings, DXF or STEP files for the Caddx Knight 10 or any "MK4 Knight" in any Eastern European source. Generic Mark4 10" STEP CAD files are available, which helps if the frame turns out to be a Mark4 clone.

### Cited Findings
- A generic "Frame Mark 4 10 inch (.STEP CAD Files)" model is on Cults3D — [Cults3D Mark 4 10 STEP](https://cults3d.com/en/3d-model/gadget/frame-mark-4-10-inch-step-cad-files)
- The BraveTech Knight listing summaries mention only a spec list. No drawings or CAD files were reported — [BraveTech](https://thebravetech.com/product/frame-caddx-knight-10-v2-8mm/)
- A Ukrainian seller warns that Mark4 10 clones sometimes come with holes not fully drilled through — [diyshop Mark4 10](https://diyshop.com.ua/ua/rama-dlya-kvadrokoptera-mark4-10-frame-fpv-karbon-horoshaya-model-dlya-sborki-long-range)

### Inferences
- For CAD work on a Knight 10 V2, measure the user's own frame: plate outlines, standoff positions, and arm-bolt and motor hole positions. The only published figures to check against are the 415 mm wheelbase, 8 mm arms, 2 mm and 3 mm plates, 35 mm internal height, 20x20 and 30.5x30.5 stacks, and 16–19 mm motor holes.

### Gaps
- I could not view product photos, because page fetches were blocked. The listings presumably have photos, but I could not judge whether they show measurements.
- I found no Caddx manual or exploded-view PDF for the Knight 10.
