henriharmaala1-source/Assembly-grapher/research_notes/MK4 Knight 10 inch frame/chinese_sources.md

# MK4 Knight 10-inch FPV frame: Chinese and Asian manufacturer sources

Method note: about 13 web searches in English, Simplified Chinese, Russian and Ukrainian, covering "MK4 Knight", "Mark4 Knight", "骑士 MK4 10寸 机架", "MK4骑士 / 骑士MK4 / Mark4骑士", "骑士 穿越机 机架 10寸", "Knight 10 FPV frame", "MK4 10寸 机架 8mm 机臂 1688", "Knight 10 aliexpress mark4", and Alibaba / Made-in-China OEM queries. Every page fetch failed at DNS (`getaddrinfo ENOTFOUND`) through the proxy: tarotrc.com, aliexpress.com and tyi-model.en.made-in-china.com. So the figures below come from search-engine summaries and snippets, not from pages I read myself. Treat each number as "stated by the listing per search summary" and check it on the live page. Taobao, 1688 product pages and 5iMX threads did not show up as specific results for any "Knight" query.

## Q1. Is there a Chinese or Asian factory or store selling an "MK4 Knight" / "Mark4 Knight" / "骑士 MK4" 10-inch frame, possibly the OEM behind resold versions?

### Takeaway
No Chinese or Asian source turned up that sells a 10-inch frame named "MK4 Knight", "Mark4 Knight" or "骑士" in any language I searched. The name looks like a reseller or regional trade name, not a factory model name. The nearest factory-direct products are generic "Mark4 V2 10寸 427mm" clones. These come from several Chinese CNC shops (Tarot / 温州飞越, Xianning Tyi Model, Shenzhen Jinquanjiu, Readytosky, RJXHobby, Boscam, and others) plus the original GEPRC Mark4 10. Any of them could be the OEM behind a "Knight"-branded resale, but I found nothing that ties a specific factory to the name.

### Cited Findings
- An exact-phrase search for "MK4 Knight" frame returned only unrelated items (Factory Five Mk4 roadster, Code Geass "Knightmare Frame", Ruger Mark IV and others). It returned no FPV frame. — [Factory Five MK4 design](https://www.factoryfive.com/roadster/mk4/design/)
- The Chinese searches "骑士 MK4 10寸 机架" and "MK4骑士 / 骑士MK4 / Mark4骑士 机架" returned only generic MARK4 10寸 listings (1688 picture index, Tarot TL1613, a GEPRC Mark4 build guide). None used the 骑士 name. — [1688 picture index](https://tw.1688.com/pic/-3134BBFABCDCCDBCC6AC.html); [Zhihu GEPRC Mark4 build guide](https://zhuanlan.zhihu.com/p/138535933)
- The only "骑士 / Knight" FPV frames in Chinese results are small and unrelated: 虫骑士 (Bug Knight), an open-source 2-inch frame with about 96.5 mm wheelbase on MakerWorld China, and the "X Knight 猎食者" 3-inch toothpick. — [MakerWorld 虫骑士](https://makerworld.com.cn/zh/models/1279667-chong-qi-shi-chuan-yue-ji-ji-cang?from=search); [17fpv X Knight](https://www.17fpv.com/992.html)
- BetaFPV's "X-Knight" line comes only in 3, 4 and 5 inches (140/160/200 mm wheelbase, T700 carbon). It has no 10-inch model, and its "8 mm" figure is frame height, not arm thickness. — [BetaFPV X-Knight](https://betafpv.com/products/x-knight-4inch-fpv-racing-carbon-fiber-frame-kit); [BetaFPV X-Knight 5" V2](https://betafpv.com/products/x-knight-carbon-fiber-5-frame-v2-kit)
- AliExpress results for "Knight 10 mark4" were all plain "Mark4 V2" listings, none named Knight. For example: "Mark4 V2 ... 8inch 367mm 9inch 387mm with 6mm Arm / 10inch 427mm w/ 7.5mm Arm". — [AliExpress 1005005897270664](https://www.aliexpress.com/item/1005005897270664.html); [AliExpress Mark4 V2 PRO 7/8/9/10](https://www.aliexpress.us/item/3256810165795102.html?gatewayAdapt=glo2usa4itemAdapt)
- Ukrainian and Russian queries ("рама Knight 10", "рама Лицар 10 дюймів") found only generic Mark4 V2 10" listings (Prom.ua, OLX, dron-shop, fpvkit, flyteam). No "Knight" or "Лицар" brand appeared. — [Prom.ua 10" frames](https://prom.ua/ua/Rama-10-dyujmov.html); [dron-shop Mark4 V2 10](https://dron-shop.com.ua/fpv/frame/frame-mark4-v210inch-427mm)
- Chinese factory-direct Mark4 10" makers found:
  - Tarot / 温州飞越航空科技 "MARK4-10 TL1613" — [Tarot TL1613](http://www.tarotrc.com/Product/Detail.aspx?Lang=zh&Id=56801373-f309-4c85-b175-436961af57b2)
  - Xianning Tyi Model Technology (Hubei) on Made-in-China, which lists 5000 pcs/year capacity and 11–50 staff — [Made-in-China Tyi](https://tyi-model.en.made-in-china.com/product/qxvRtirPgwpX/China-Mark4-10-Inch-Fpv-Drone-Frame-Carbon-Fiber-Uav-Frame-Kit-Drone-RC-Arm-Thickness-7mm-Accessory.html)
  - Shenzhen Jinquanjiu Electronics on Alibaba (OEM-branded Mark4 V2 10") — [Alibaba Mark4 V2 10 guide](https://electronics.alibaba.com/product/mark-4-v2-10-inch-quadcopter-frame)
- An accio.ai (Alibaba sourcing) page lists Mark4 V2 10" 427 mm kits from several Chinese suppliers, with MOQ 1–10 pcs and prices of about US$8.91–12.70 to US$23. I could not confirm which suppliers these are. — [accio.ai drone frame kit](https://www.accio.ai/find-product/drone-frame-kit-empty)
- 飞雄科技 (airv3.com) sells an "FPV-10 / MK4-10". The summary gives 396 mm wheelbase, H-type quick-release, 680 g empty, 5 kg max load, and T300 carbon. The maker's marketing describes it with military-grade strength wording. I recorded frame data only. — [飞雄科技 FPV-10](https://airv3.com/FPV-10/)

### Inferences
- "MK4 Knight" is probably a name given by a reseller or regional distributor (possibly Ukrainian or European), not a Chinese factory SKU. That would explain why no Chinese-language listing uses 骑士 for a 10" frame. It could also be a shop's own name for a private-label Mark4 V2 cut by one of the CNC shops above.
- The most common OEM base for 10" "Mark4" resales is the 427 mm Mark4 V2 pattern. The suspected 8 mm arm points away from the stock 7.5 mm Mark4 V2 and toward a reinforced variant or a custom cut.

### Gaps
- No primary listing for "MK4 Knight" was found anywhere. To pin down the OEM, I would need the user's own seller link, the packaging or plate engravings, or a photo.
- Taobao, 1688 product pages, Global Sources and 5iMX did not return specific results for any Knight or 骑士 query, and their pages could not be fetched.

## Q2. What arm thickness (8 mm suspected), wheelbase and plate thicknesses do Chinese sources state for MK4 10" frames?

### Takeaway
No Chinese MK4 10" listing in the results states an 8 mm arm. Chinese sources state 7–7.5 mm arms, a 427–429 mm wheelbase (some listings 450–473 mm), 2–3 mm top plates and 2.5–3 mm bottom plates. The 10" kits weigh about 227–270 g.

### Cited Findings
- Tarot MARK4-10 TL1613 (温州飞越) per search summaries:
  - 3K twill carbon, H-type, 427 mm wheelbase, 331×269 mm outline, 238 g
  - 7.5 mm arms, 3 mm bottom plate, 3 mm top plate
  - FC/VTX holes 30.5 mm and 20 mm
  - Price ¥205 RMB (data about three years old)

  — [Tarot TL1613](http://www.tarotrc.com/Product/Detail.aspx?Lang=zh&Id=56801373-f309-4c85-b175-436961af57b2)
- Xianning Tyi Model (Made-in-China) per summary: titled "Arm Thickness 7mm", roof (top) 2 mm, floor (bottom) 2.5 mm. — [Made-in-China Tyi](https://tyi-model.en.made-in-china.com/product/qxvRtirPgwpX/China-Mark4-10-Inch-Fpv-Drone-Frame-Carbon-Fiber-Uav-Frame-Kit-Drone-RC-Arm-Thickness-7mm-Accessory.html)
- Shenzhen Jinquanjiu (Alibaba) per summary: 7.5 mm arms, 3 mm bottom plate, 427 mm wheelbase. — [Alibaba Mark4 V2 10 guide](https://electronics.alibaba.com/product/mark-4-v2-10-inch-quadcopter-frame)
- Readytosky Mark4 10" V2: 427 mm motor diagonal, 270 g, 7.5 mm arm (Rotorama, in Russian). Another listing gives 473 mm diagonal. — [Rotorama Readytosky Mark4 10 V2](https://www.rotorama.com/product/readytosky-mark4-10-v2); [Flyteam Mark4 10 HD](https://flyteam.com.ua/index.php?path=103&product_id=141&route=product%2Fproduct)
- CaptainRC Mark4 V2 10": about 227 g, 3 mm bottom, 2 mm top, and a "6 mm" arm figure (the summary is ambiguous about whether this means the camera plates or the arms). — [CaptainRC Mark4 V2](https://captainrc.com/products/3k-carbon-fiber-frame-mark4-v2-8inch-367mm-9inch-387mm-10inch-427mm-wheelbase-rc-fpv-freestyle-racing-drone-frame-kit)
- GEPRC GEP-Mark4-10 (Shenzhen brand): 7 mm arm plate, 2.5 mm side plate, 3 mm base plate, 270 g, about 428–429 mm motor-to-motor, 30.5×30.5 mm M3 FC mount. TBS's text also mentions a "3.7 mm arm structure", which is inconsistent. — [RMRC GEPRC Mark4 10](https://www.readymaderc.com/products/details/86588-geprc-mark4-10-multirotor-frame); [GetFPV GEPRC Mark4 10](https://www.getfpv.com/geprc-mark4-10-frame-kit.html); [TBS GEPRC Mark4 10](https://www.team-blacksheep.com/products/product:7652)
- 1688 search summary: the visible MK4 10寸 carbon-frame listings did not show arm thickness in snippets. One generic Mark4 5–8" listing gives 5 mm arms. — [1688 机架 market](https://www.1688.com/market/-BBFABCDC.html)
- The original GEPRC Mark4 (smaller sizes, Chinese review) has a 2 mm top plate, 3 mm bottom plate, 5 mm arms and aluminium standoffs. — [Zhihu Mark4 guide](https://zhuanlan.zhihu.com/p/138535933)
- The Ukrainian retail price for generic Mark4 V2 10" frames is about 975–1395 UAH. — [Prom.ua](https://prom.ua/ua/Rama-10-dyujmov.html); [fpvkit](https://fpvkit.com.ua/en/products/frame-kit-mark4-10-v2)

### Inferences
- If the user's "Knight" frame really has 8 mm arms, it is not stock Mark4 V2 (7.5 mm) or GEPRC (7 mm). A caliper reading of about 7.5 mm on a stock Mark4 V2 arm could be rounded up to "8 mm".

### Gaps
- None of the snippets gave standoff count, height or diameter, the VTX hole pattern, or the motor-mount pattern for these Chinese 10" listings. The usual Mark4 V2 10" motor mount (16×16/19×19 M3 is common for 2810–3115 class motors) could not be confirmed because the pages were blocked.
- No 8 mm arm statement was found in any Chinese source.

## Q3. Does any factory offer custom arm thicknesses (for example 7 or 8 mm) or OEM cutting?

### Takeaway
Yes, in general. Chinese Mark4 10" suppliers advertise OEM branding and a choice of arm thickness, but the stated options are 6.0, 7 and 7.5 mm. None of the sources found explicitly offers an 8 mm option.

### Cited Findings
- The Boscam Mark4 V2 10" is described as having a 427 mm wheelbase with a "customizable arm thickness of 7.5 mm or 6.0 mm". — [rcdrone.top Boscam Mark4 V2](https://rcdrone.top/products/boscam-mark-4-v2-10-inch-427mm-carbon-fiber-fpv-frame-kit)
- Shenzhen Jinquanjiu sells the Mark4 V2 10" as OEM-branded on Alibaba. — [Alibaba Mark4 V2 10 guide](https://electronics.alibaba.com/product/mark-4-v2-10-inch-quadcopter-frame)
- Xianning Tyi Model offers a 7 mm arm version on Made-in-China at a stated capacity of 5000 pcs/year. — [Made-in-China Tyi](https://tyi-model.en.made-in-china.com/product/qxvRtirPgwpX/China-Mark4-10-Inch-Fpv-Drone-Frame-Carbon-Fiber-Uav-Frame-Kit-Drone-RC-Arm-Thickness-7mm-Accessory.html)
- 1688 listings describe MK4 10寸 carbon frames as "CNC加工配件批发" (CNC-machined parts, wholesale). This implies job-shop cutting. — [1688 picture index](https://tw.1688.com/pic/-BBFABCDCBCFECDBCC6AC.html?beginPage=2)

### Inferences
- Chinese carbon CNC shops commonly cut 3K plate in 1 mm steps (often up to 8–10 mm). An 8 mm arm is therefore probably available on request from these OEMs, but this is inference and no source states it.

### Gaps
- I could not confirm explicit 8 mm options, MOQ for custom cuts, or custom-cut pricing, because supplier pages were not fetchable.

## Q4. Are drawings or CAD downloads available?

### Takeaway
No CAD exists for any "Knight" 10" frame. CAD and printable files exist only for the GEPRC Mark4 and its accessories.

### Cited Findings
- Cults3D hosts GEPRC MK4 10in STEP and MK4 V2 10in STL files. — [Cults3D GEPRC MK4 10in](https://cults3d.com/en/3d-model/gadget/geprc-mk4-10in); [Cults3D GEPRC MK4 V2 10in](https://cults3d.com/en/3d-model/gadget/geprc-mk4-v2-10in-fpv-frame)
- MakerWorld China hosts GEPRC Mark4 printed accessories (整机打印件). — [MakerWorld GEPRC Mark4](https://makerworld.com.cn/zh/models/702948-ge-pu-geprc-mark4ji-jia-zheng-ji-da-yin-jian)
- 17fpv.com hosts a GPS long-range Mark4 kit with 3D-print file downloads. — [17fpv Mark4 GPS](https://www.17fpv.com/606.html)
- IndiaMART hosts a seller PDF datasheet for a "MARK4 V2 10 Inch Carbon Fiber Long Range FPV Drone Frame" (not read). — [imimg PDF](https://5.imimg.com/data5/SELLER/Doc/2026/2/580489223/UR/CK/IE/75360989/mark4-10-inch-carbon-fiber-long-range-fpv-drone-frame.pdf)

### Gaps
- No factory DXF or plate drawings for Chinese Mark4 V2 10" clones were found, and none for anything named Knight.
