henriharmaala1-source/Assembly-grapher/research_notes/Mark4 10 inch frames 8mm arms/other_brands.md

# Non-Mark4-branded 10-inch (9-10" long range) FPV frames with 8 mm carbon arms, and how Mark4-like each is

> **Method note (read first).** In this session, direct page fetching (WebFetch/curl) was blocked by the sandbox egress proxy. getfpv.com, hglrc.com, shop.iflight.com, rcdrone.top, oscarliang.com and rotorama.com all failed with "ENOTFOUND" or "CONNECT 403". So every finding below comes from the **WebSearch result summaries and snippets** for the URLs shown, not from a full read of each page. Where a summary quoted spec-line text (for example "Arm Thickness: 8mm"), I give it as quoted. Treat figures as "as listed in search snippets" and check them on the page before relying on them. Prices and stock dates are what the search snippets reported in October 2026.
>
> **Scope.** Only standard hobby FPV frames are covered. No weaponised or payload-drop frames were found or included.

---

## Which 10" frames list 8 mm arms?

### Takeaway
Only a few current non-Mark4 10" quad frames clearly list 8 mm arms:
- **iFlight Helion 10** (418 mm). The 8 mm figure is consistent across sources and matches iFlight's own spec line.
- **HGLRC / Rekon FPV Rekon10 Pro**: V1 is 455 mm, V2 is 474 mm. Both list 8 mm front and rear arms.
- **iFlight XL10 V6** (420 mm). The arm figure is disputed: 8 mm on rcdrone.top, Banggood, ReadyMadeRC and Made-in-China listings, 7 mm on GetFPV, NextFPV and the iFlight shop page.

Most other 10" frames checked list 7 mm arms (Foxeer Aura 10, Axisflying MANTA10, GEPRC Pulsar LR10, DarwinFPV X10, JeeFly XL10 V7, QWinOut LX10 V2) or 6 mm (iFlight Chimera CX10, QWinOut APEX EVO 10). For the other brands searched, no 10" model with 8 mm arms turned up.

### Cited Findings

**Summary table.** "?" means not found. "Layout" is my reading of the listed plate stack (see the Mark4 question below).

| Frame | Arm (as listed) | Wheelbase | Plates (as listed) | Stack / FC mount | Standoffs | Price seen (Oct 2026) | Status |
|---|---|---|---|---|---|---|---|
| iFlight Helion 10 (O4 ver.) | "Arm Thickness: 8mm" | 418 mm | Bottom 4 mm, Upper 4 mm (v1.1; earlier 3 mm) | 30.5×30.5 (M3); max stack 21 mm (O4) / 25 mm (O3) | ? | $299.99 iFlight; $359.99 RDQ | In production |
| HGLRC Rekon10 Pro (V1, Rekon FPV) | 8 mm front and rear arms, "8mm carbon cut plate arms" | 455 mm (476×298 mm) | Top 3 mm, Middle 2 mm, Bottom 3 mm; top–middle space 20 mm | FC 30.5×30.5; camera 20×20 | 2× M3×30, 4× M3×20, 2× M3×18 aluminium | ? | Out of stock at GetFPV and Rekon FPV; effectively replaced by V2 |
| HGLRC Rekon10 Pro V2 (O4) | "Arm Thickness: 8mm" | 474 mm (498×327 mm) | Top 2 mm, Middle 3 mm, Bottom 3 mm | FC 30.5×30.5 M3 / 20×20 M3; VTX 25.5/20/30.5 | ? | $109.99 HGLRC (out of stock); $129.49 RDQ; €121.90 fpv24 | Current |
| iFlight XL10 V6 / "Nazgul XL10 V6" | **Disputed: 8 mm vs 7 mm** | 420 mm (297×297×35 mm) | Top 3, Upper 3, Bottom 3 mm; side plates 1.5 mm | 30.5×30.5 and 20×20; max stack 19 mm | 4× 25 mm + 4× 35 mm | $143.89 rcdrone.top (sold out) | Sold out at some resellers; no discontinuation notice found |
| Generic "Helion10-fit" clone (EcDwk on Amazon) | "8mm Arm" in title | ? | ? | ? | ? | ? | Marketplace clone |
| iFlight Taurus X8 V3 / X8 Pro | "Arm Thickness: 8mm" | 400 mm (also listed as 320 or 450 mm) | 3 mm plates | ? | ? | ? | **8" X8 cinelifter, not a 10" quad. Out of scope; listed only because it came up.** |

**iFlight Helion 10**
- Spec line "Arm Thickness: 8mm". Wheelbase 418 mm. Frame L324×W264×H63 mm. Motor mount 19×19 mm (Φ3). Weight 540±20 g. Max flight stack height 25 mm (O3 ver.) / 21 mm (O4 ver.). VTX mount 25.5×25.5. iFlight states a ±0.2 mm thickness tolerance. — [iFlight shop](https://shop.iflight.com/Helion-10-10inch-Frame-Kit-Pro2093); [GetFPV](https://www.getfpv.com/iflight-helion-10-frame-kit.html); [MyFPV](https://www.myfpvstore.com/quadcopter-frames/iflight-helion-10-o4-pro-10-frame-kit/)
- Changelog: in July 2024 the bottom plate, upper plate, screw package and CNC camera side plate went to v1.1, and the bottom and upper plates got thicker (most listings now say 4 mm). In April 2025 the kit was "upgraded from O3 version to O4 version". — [iFlight shop](https://shop.iflight.com/Helion-10-10inch-Frame-Kit-Pro2093)
- Defiance RC lists 3 mm bottom and upper plates, probably the pre-v1.1 figure. The yourfpv.co.uk spare-parts listing is titled "3mm Upper/Bottom Plate, 8mm Arm". — [Defiance RC](https://www.defiancerc.com/products/iflight-and-2raw-helion-10-inch-frame-kit); [yourfpv](https://yourfpv.co.uk/product/helion-10-replacement-parts/)
- Seller listings give FC mount "30.5×30.5 mm with a 3 mm hole". One retailer describes an "A-Frame design" that "minimises vibrations as well as torsion". — [RaceDayQuads](https://www.racedayquads.com/products/iflight-helion-10-frame-kit); [Amazon listing](https://www.amazon.com/Helion-Unit-Frame-10inch-Parts/dp/B0GW5N4G9G)
- Price: $299.99 on the iFlight shop (in stock) and $359.99 at RaceDayQuads (in stock). The Helion **Pro** kit is a different, higher-end product ($579.99 at Kiwiquads, out of stock). — [iFlight shop](https://shop.iflight.com/Helion-10-10inch-Frame-Kit-Pro2093); [RaceDayQuads](https://www.racedayquads.com/products/iflight-helion-10-frame-kit); [Kiwiquads](https://kiwiquads.co.nz/product/iflight-helion-pro-10-frame-kit/)

**HGLRC / Rekon FPV Rekon10 Pro (V1)**
- Wheelbase 455 mm, size 476×298 mm, 8 mm front and rear arms. Plates: top 3 mm, middle 2 mm, bottom 3 mm. "Top and middle plate space: 20mm". Weight about 396.7 g. FC 30.5×30.5. Camera 20×20. Motor 19×19. — [GetFPV](https://www.getfpv.com/rekon-fpv-rekon10-pro-long-range-frame-kit-10.html); [Rising Sun FPV](https://risingsunfpv.com/products/rekon10-pro-long-range-frame-kit-10-inch-for-fpv-racing-drone); [NextFPV](https://www.nextfpv.com/products/hglrc-rekon10-pro-10-inch-long-range-frame-kit-1)
- Arm wording on retailer pages: arms "considerably beefed-up" and "cut out of 8mm carbon plates". Another listing: "8mm carbon fiber arms are reinforced with bracelets on both sides". — [GetFPV](https://www.getfpv.com/rekon-fpv-rekon10-pro-long-range-frame-kit-10.html); [hobbygoat](https://hobbygoat.com/products/hglrc-rekon10-pro-long-range-frame-kit)
- Standoff hardware in the kit: "2x M3x30mm black mesh aluminum column, 4x M3x20mm black mesh aluminum column, 2x M3x18mm black mesh aluminum pillar". That is 8 standoffs of mixed heights. — [search summary of retailer listings, e.g. Rising Sun FPV](https://risingsunfpv.com/products/rekon10-pro-long-range-frame-kit-10-inch-for-fpv-racing-drone)
- One listing says the frame "can accommodate 20x20mm flight stacks", which conflicts with the 30.5 FC spec. — [diyfpv](https://www.diyfpv.com/catalog/rekon-fpv-rekon10-pro-long-range-frame-kit-10)
- Status: the Rekon FPV-store version (455 mm) shows as out of stock. — [GetFPV](https://www.getfpv.com/rekon-fpv-rekon10-pro-long-range-frame-kit-10.html); [Rekon FPV](https://rekonfpv.com/)

**HGLRC Rekon10 Pro V2 (O4-ready)**
- "Top Plate Thickness: 2mm, Middle Plate Thickness: 3mm, Bottom Plate Thickness: 3mm, Arm Thickness: 8mm, Wheelbase: 474mm". Overall 498×327 mm. FC holes "30.5mm x 30.5mm, M3 / 20mm x 20mm, M3". VTX holes "25.5mm x 25.5mm, M2 / 20mm x 20mm, M2 / 30.5mm x 30.5mm, M3". HGLRC describes a "unique triangular reinforcement structure". — [HGLRC](https://www.hglrc.com/products/hglrc-rekon10-pro-v2-10-inch-long-range-frame-compatible-with-o4); [fpv24](https://www.fpv24.com/en/hglrc/hglrc-rekon10-pro-v2-long-range-frame-10-inch-o4-ready); [RaceDayQuads](https://www.racedayquads.com/products/hglrc-rekon10-pro-v2-10-lr-frame-kit-o4)
- Separate front and rear V2 spare arms are sold, so the arms are discrete parts, not a unibody. — [RDQ front arm V2](https://www.racedayquads.com/products/hglrc-rekon10-pro-front-arm-v2); [RDQ rear arm V2](https://www.racedayquads.com/products/hglrc-rekon10-pro-rear-arm-v2)
- Prices: $109.99 at HGLRC (out of stock), $129.49 at RaceDayQuads (in stock), €121.90 at fpv24 (in stock), €199 at Fruugo NL, ₹9,499 at Quadkart. — [HGLRC](https://www.hglrc.com/products/hglrc-rekon10-pro-v2-10-inch-long-range-frame-compatible-with-o4); [RDQ](https://www.racedayquads.com/products/hglrc-rekon10-pro-v2-10-lr-frame-kit-o4); [fpv24](https://www.fpv24.com/en/hglrc/hglrc-rekon10-pro-v2-long-range-frame-10-inch-o4-ready); [Fruugo](https://www.fruugo.nl/hglrc-rekon10-pro-v2-474mm-wheelbase-3k-carbon-fiber-10-inch-long-range-frame-kit-for-rc-fpv-drone/p-334029138-736261596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); [Quadkart](https://www.quadkart.in/rekon10-pro-long-range-10-frame-kit/)

**iFlight XL10 V6 (sold as "XL10 V6" and "Nazgul XL10 V6")**
- Arms listed as **8 mm**: rcdrone.top ("iFlight XL10 V6 420mm 10 inch FPV Frame Kit with 8mm arm"), Banggood SEA ("IFlight XL10 V6 420mm Wheelbase 8mm Arm Thickness Full 3K Carbon Fiber 10 Inch Frame Kit Support DJI O3 Air Unit…"), ReadyMadeRC, and a Made-in-China listing ("Iflight XL10 V6 Fpv Frame with 8mm Arm"). — [rcdrone.top](https://rcdrone.top/products/iflight-xl10-v6-420mm-10inch-fpv-frame-kit); [Banggood](https://sea.banggood.com/IFlight-XL10-V6-420mm-Wheelbase-8mm-Arm-Thickness-Full-3K-Carbon-Fiber-10-Inch-Frame-Kit-Support-DJI-O3-Air-Unit-CADDX-Vista-HD-for-RC-Drone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); [ReadyMadeRC](https://www.readymaderc.com/products/details/86869-iflight-nazgul-xl10-v6-10-inch-frame-kit); [Made-in-China](https://m.made-in-china.com/product/Iflight-XL10-V6-Fpv-Frame-with-8mm-Arm-Fpv-System-2011319242.html)
- Arms listed as **7 mm**: GetFPV, NextFPV, and (per the search summary) the iFlight shop page for the "Nazgul XL10 V6". An Amazon clone is titled "XL10 V6 420mm 10inch FPV Frame Kit With 7mm Arm". — [GetFPV](https://www.getfpv.com/iflight-nazgul-xl10-v6-10-frame-kit.html); [NextFPV](https://www.nextfpv.com/products/iflight-nazgul-xl10-v6-10-inch-frame-kit); [iFlight shop](https://shop.iflight.com/xl10-v6-10-inch-fpv-frame-Pro1967); [Amazon](https://www.amazon.com/420mm-10inch-Frame-Drone-Parts/dp/B0H69QVB27)
- Specs the sources agree on: wheelbase 420 mm; 297×297×35 mm; **top, upper and bottom plates 3 mm**; 30.5×30.5 and 20×20 stack; max flight-stack height 19 mm; max VTX height 29 mm; motor 16×16 / 19×19; True-X; about 343–345 g. One source lists 1.5 mm vertical side plates and standoffs "25mm (4pcs) and 35mm (4pcs)". — [GetFPV](https://www.getfpv.com/iflight-nazgul-xl10-v6-10-frame-kit.html); [NextFPV](https://www.nextfpv.com/products/iflight-nazgul-xl10-v6-10-inch-frame-kit); [unmannedtechshop](https://www.unmannedtechshop.co.uk/products/iflight-xl10-v6-10-fpv-frame); [Pyrodrone](https://pyrodrone.com/products/iflight-nazgul-xl10-v6-10-frame-kit)
- iFlight support says XL10 V6 and XL10 V5 frame parts are not compatible. — [iFlight shop](https://shop.iflight.com/xl10-v6-10-inch-fpv-frame-Pro1967)
- Price $143.89 at rcdrone.top (sold out); the Nazgul-labelled listing is $149.39 (sold out). I found no discontinuation notice. — [rcdrone.top](https://rcdrone.top/products/iflight-xl10-v6-420mm-10inch-fpv-frame-kit)

**Candidates checked that do NOT have 8 mm arms (10"/9-10")**
- iFlight Chimera CX10: "Arm Thickness: 6mm", 452 mm. Chimera9 ECO: 6 mm. — [RaceDayQuads CX10](https://www.racedayquads.com/products/iflight-chimera-cx10-10-frame-kit); [iFlight Chimera9 ECO](https://shop.iflight.com/Chimera9-ECO-Frame-Kit-Pro2080)
- Axisflying MANTA10 / MANTA10 Lite (True X): 402 mm (one Alibaba title says 440 mm), 272±5 g, T700. The arm figure is "7mm", and only the Alibaba attribute table gives it; Axisflying's own page snippet shows no arm thickness. — [Axisflying](https://www.axisflying.com/products/axisflying-manta-10-inch-frame-ture-x-frame-kit-for-10inch-fpv-freestyle-quadcopter-drone-diy-part); [Alibaba](https://www.alibaba.com/product-detail/Axisflying-MANTA-10-Lite-10inch-FPV_1601128820465.html)
- Foxeer Aura 10" LR: 440 mm. Its packing list says "7mm arm with 19mm mounting" ×4, with 3 mm top, middle and bottom plates. — [Foxeer](https://www.foxeer.com/foxeer-aura-10-lr-frame-analog-o3-hdzero-vista-g-526); [Pyrodrone](https://pyrodrone.com/products/foxeer-aura-10-long-range-frame-analog-o3-hdzero-vista)
- GEPRC Pulsar LR10: 435 mm. Most sheets say a 7.0 mm arm plate plus a 3 mm arm splint; GetFPV says a "3.7mm thick arm" (conflict). Top and bottom 3 mm. — [GetFPV](https://www.getfpv.com/geprc-pulsar-lr10-frame-kit.html); [rcdrone.top](https://rcdrone.top/products/geprc-gep-pulsar-lr10-435mm-wheelbase-10-inch-fpv-drone-frame)
- DarwinFPV X10 (folding): 410 mm; "reinforced 7mm arms"; top 2, middle 3, bottom 3 mm; 293.9 g. Darwin X9: 6 mm. — [qwinout](https://qwinout.com/products/darwinfpv-fpv-x10-frame-long-range-folding-frame-kit-10-inch-410mm-wheelbase-for-drone-quadcopter-parts); [DarwinFPV X10](https://darwinfpv.com/products/darwinfpv-x10-long-range-fpv-drone-frame); [DarwinFPV X9](https://darwinfpv.com/products/darwin-x9-quadcopter-frame)
- JeeFly XL10 V7 and QWinOut LX10 V2: 7 mm (retailer listings). QWinOut APEX EVO 10: 410 mm, 6 mm arm plate. — [ohiodronellc roundup](https://www.ohiodronellc.com/best-10-inch-fpv-frames-for-cinematic-builds/); [Amazon QWinOut APEX EVO](https://www.amazon.com/QWinOut-Inches-Carbon-Racing-10inch/dp/B0CR1C7Y87)
- TBS Source One: 5" arms 4 mm, 7" arms 6 mm, V5 6 mm. No 10" Source One or "Source LR" was found. — [Oscar Liang S1 V5 review](https://oscarliang.com/source-one-v5/); [GetFPV S1 HD](https://www.getfpv.com/tbs-source-one-hd-5-frame-kit.html)
- SpeedyBee: Mario 8 Fold is 7 mm and Mario 5 / Master 5 V2 are 5–6 mm. No 10" SpeedyBee was found. — [Rotorama Mario 8](https://www.rotorama.com/product/speedy-bee-mario-8-foldable); [Speedybee Mario 5](https://www.speedybee.com/speedybee-mario-5-frame/)
- Diatone Roma: F5 5 mm, F6 6 mm, F7 6 mm. No Roma 10" was found. — [alexnld Roma F7](https://alexnld.com/product/diatone-roma-f7-290mm-wheelbase-7-inch-t300-3k-frame-kit-6mm-frame-arm-30-530-5-2020mm-for-fpv-racing-drone/); [Diatone F6](https://www.diatone.us/products/roma-f6-6-inch-frame-kit)
- Flywoo Explorer: only the 4" Explorer LR exists, with 3 mm arms. No 10" was found. — [Oscar Liang Explorer LR review](https://oscarliang.com/flywoo-explorer-lr/)
- Lumenier: QAV-RXL 2 (8") has 6 mm arms and QAV-X has 4 mm. The 8 mm-arm QAV-S 2 JohnnyFPV SE is a **5"** frame. — [GetFPV QAV-RXL 2](https://www.getfpv.com/lumenier-qav-rxl-2-8-fpv-quadcopter-frame.html); [Pyrodrone 7-inch frames](https://pyrodrone.com/collections/7-inch-frames)
- Shendrones Thicc 2.1: 8 mm carbon arms, but it is a 390 mm 7–8" X8 cinelifter (2.5 mm main plates, 3 mm bottom). Not a 10" quad. — [Pyrodrone (search summary)](https://pyrodrone.com/collections/7-inch-frames)

**Mark4 baseline (for comparison only; these frames are Mark4-branded):** the GEPRC Mark4 10" lists a 7 mm arm plate plus a "3mm Arm Bar" vertical reinforcement. Top 2 mm, bottom 3 mm, mid 3 mm, side 2.5 mm. FC 30.5×30.5 (M3). 30 mm aluminium standoffs. 429 mm diagonal. About 270 g. — [GetFPV](https://www.getfpv.com/geprc-mark4-10-frame-kit.html); [ReadyMadeRC](https://www.readymaderc.com/products/details/86588-geprc-mark4-10-multirotor-frame). A generic "MARK4 V2 10-inch" frame lists "Arm Thickness | 5mm". — [The FPV Project](https://thefpvproject.com/product/mark10-v2-10-inch-carbon-fiber-fpv-frame/)

### Inferences
- If the requirement is a genuine 8 mm-arm 10" frame from a reputable brand that is in stock in 2026, the realistic shortlist is the **Helion 10** and the **Rekon10 Pro V2**. The **XL10 V6** qualifies only if a seller confirms 8 mm. The split on its arm figure (8 mm on "iFlight XL10 V6" listings, 7 mm on "Nazgul XL10 V6" listings) suggests either a mid-life change or a copy-paste error. Measure it or ask the seller.
- The standard thickness for big 10" quads is 7 mm (Mark4 10, Foxeer Aura 10, Pulsar LR10, Manta10, DarwinFPV X10, JeeFly). 8 mm is the heavy-duty exception.

### Gaps
- No full manufacturer page could be read (network block). Exact verbatim spec blocks, manuals and exploded views were not verified directly.
- No 10" model with 8 mm arms turned up for Lumenier, ImpulseRC, Five33, Shendrones, T-Motor, Holybro, Emax, BetaFPV, Hobbywing, JMT, ZMR, XILO, Sub250 or Dalrc. Searches showed their catalogues but no matching spec. This is "not found", not "confirmed none".
- Search found no GEPRC "MOZ" or "Crocodile" 10" frame with 8 mm arms; no MOZ/Crocodile listing appeared.
- X-class frames (giant racing class): no 8 mm-arm X-class spec was found in the searches.

---

## Exact arm-spec wording: maker's page vs resellers

### Takeaway
For the **Helion 10**, iFlight's own spec line ("Arm Thickness: 8mm") and the resellers agree. For the **Rekon10 Pro V2**, HGLRC's page and the resellers agree on "Arm Thickness: 8mm". For the **XL10 V6**, the wording conflicts: only resellers and marketplaces say 8 mm, while the iFlight shop page, GetFPV and NextFPV say 7 mm.

### Cited Findings
- Helion 10: iFlight's shop page lists "Arm Thickness: 8mm" with the ±0.2 mm tolerance note. MyFPV describes the arms as "massive, 8mm thick". eBay and Amazon titles say "Wheelbase 418mm 8mm Arm". — [iFlight](https://shop.iflight.com/Helion-10-10inch-Frame-Kit-Pro2093); [MyFPV](https://www.myfpvstore.com/quadcopter-frames/iflight-helion-10-o4-pro-10-frame-kit/); [eBay](https://www.ebay.com/itm/388714315393)
- Rekon10 Pro V1: Rekon FPV retailer pages say "8mm carbon cut plate arms" and that the arms are "cut out of 8mm carbon plates". hobbygoat says "reinforced with bracelets on both sides". — [GetFPV](https://www.getfpv.com/rekon-fpv-rekon10-pro-long-range-frame-kit-10.html); [hobbygoat](https://hobbygoat.com/products/hglrc-rekon10-pro-long-range-frame-kit)
- Rekon10 Pro V2: "Arm Thickness: 8mm" alongside "Wheelbase: 474mm". — [HGLRC](https://www.hglrc.com/products/hglrc-rekon10-pro-v2-10-inch-long-range-frame-compatible-with-o4); [fpv24](https://www.fpv24.com/en/hglrc/hglrc-rekon10-pro-v2-long-range-frame-10-inch-o4-ready)
- XL10 V6: Banggood's title is "…420mm Wheelbase 8mm Arm Thickness…" and rcdrone.top's title is "…with 8mm arm compatible wi[th DJI O3]…". GetFPV and NextFPV spec lists say 7 mm. The search summary of the iFlight shop page also reports 7 mm. — [Banggood](https://sea.banggood.com/IFlight-XL10-V6-420mm-Wheelbase-8mm-Arm-Thickness-Full-3K-Carbon-Fiber-10-Inch-Frame-Kit-Support-DJI-O3-Air-Unit-CADDX-Vista-HD-for-RC-Drone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); [rcdrone.top](https://rcdrone.top/products/iflight-xl10-v6-420mm-10inch-fpv-frame-kit); [GetFPV](https://www.getfpv.com/iflight-nazgul-xl10-v6-10-frame-kit.html); [NextFPV](https://www.nextfpv.com/products/iflight-nazgul-xl10-v6-10-inch-frame-kit); [iFlight](https://shop.iflight.com/xl10-v6-10-inch-fpv-frame-Pro1967)
- A 2023-era build blog's comparison table lists "iFlight Helion 10 8mm | HGLRC Rekon10 8mm | GEPRC Pulsar LR10 7mm | AOS UL10 V5 3.5mm" and Foxeer Aura 10 as "N/A". — [makerme.blog](https://makerme.blog/posts/10inch-long-range/)

### Inferences
- The XL10 V6 7-vs-8 mm conflict cannot be settled from listings. The manufacturer-side evidence (iFlight shop, per the search summary) leans to 7 mm. The 8 mm claim is mostly on Chinese marketplace and reseller titles.

### Gaps
- I could not open the iFlight XL10 V6 page directly to confirm its exact spec line, and I found no caliper measurement or teardown.

---

## Which have a Mark4-like layout vs a different one?

### Takeaway
None of the 8 mm candidates is a straight Mark4 copy, but **Rekon10 Pro (V1/V2)** and **XL10 V6** are the closest structurally. Both are listed with a three-plate stack (bottom, middle/"upper", top) that sandwiches separate arms, use a 30.5×30.5 FC mount, and use eight aluminium standoffs. Their geometry differs: Rekon is stretched (455–474 mm, separate front and rear arm shapes, 20 mm top-to-middle gap), and the XL10 is True-X with 25 mm and 35 mm standoffs. **Helion 10** is the least Mark4-like. It is listed with only bottom and upper plates (4 mm), CNC camera side plates and an "A-Frame" body, so it is a heavier, enclosed design.

### Cited Findings
- Rekon10 Pro V1: three plates (top 3 / middle 2 / bottom 3 mm), "top and middle plate space: 20mm", FC 30.5×30.5, and eight aluminium standoffs (2× 30 mm, 4× 20 mm, 2× 18 mm). — [GetFPV](https://www.getfpv.com/rekon-fpv-rekon10-pro-long-range-frame-kit-10.html); [Rising Sun FPV](https://risingsunfpv.com/products/rekon10-pro-long-range-frame-kit-10-inch-for-fpv-racing-drone)
- Rekon10 Pro V2: three plates (top 2 / middle 3 / bottom 3 mm), separate front and rear V2 arm spares, FC 30.5 or 20×20 M3, and a "triangular reinforcement structure". — [HGLRC](https://www.hglrc.com/products/hglrc-rekon10-pro-v2-10-inch-long-range-frame-compatible-with-o4); [RDQ front arm V2](https://www.racedayquads.com/products/hglrc-rekon10-pro-front-arm-v2)
- XL10 V6: bottom, upper and top plates all 3 mm, 1.5 mm side plates, standoffs 4× 25 mm + 4× 35 mm, 30.5 and 20×20 stack, max stack 19 mm, True-X. — [unmannedtechshop](https://www.unmannedtechshop.co.uk/products/iflight-xl10-v6-10-fpv-frame); [GetFPV](https://www.getfpv.com/iflight-nazgul-xl10-v6-10-frame-kit.html)
- Helion 10: bottom plate and upper plate (4 mm in v1.1), CNC camera side plate, 30.5×30.5 FC, max stack 21–25 mm, frame height 63 mm, 540 g, "A-Frame design". — [iFlight](https://shop.iflight.com/Helion-10-10inch-Frame-Kit-Pro2093); [RaceDayQuads](https://www.racedayquads.com/products/iflight-helion-10-frame-kit)
- Mark4 10 reference: top 2 / mid 3 / bottom 3 mm, 7 mm arms with a 3 mm arm bar, 30 mm aluminium standoffs, FC 30.5. — [GetFPV](https://www.getfpv.com/geprc-mark4-10-frame-kit.html)

**Mark4-likeness rating** (my judgement from the listed plate stacks; arm clamping was not confirmed from drawings):

| Frame | Arm attachment (inferred) | Stack | Standoffs | Mark4-likeness |
|---|---|---|---|---|
| Rekon10 Pro V1 (455 mm) | Separate front and rear arms between bottom and middle plates (three-plate stack) | 30.5 | 8 aluminium, mixed 18/20/30 mm | **High–medium**: same three-plate logic and thickness pattern as Mark4 (3/2-3/2-3), but stretched-X geometry, asymmetric arms and mixed standoff heights |
| Rekon10 Pro V2 (474 mm) | Same idea; separate front and rear arms; triangular bracing | 30.5 or 20 | ? | **Medium**: even longer body; plate thicknesses (2/3/3) match Mark4 10 exactly (top 2, mid 3, bottom 3) |
| iFlight XL10 V6 (420 mm) | Arms between bottom and "upper" plate, with standoffs up to the top plate; side plates | 30.5 / 20 | 8 (4× 25 + 4× 35 mm) | **Medium–high**: closest wheelbase to Mark4 10 (420 vs 429 mm) and True-X like Mark4; the 8 mm arms are unconfirmed |
| iFlight Helion 10 (418 mm) | Arms between bottom and upper plates; CNC side plates, A-frame enclosure | 30.5 | ? | **Low–medium**: similar size, but a heavier enclosed body (540 g, 63 mm tall) and thick 4 mm plates |

### Inferences
- The "three plates + separate arms + 30.5 stack + 8 standoffs" pattern listed for Rekon10 Pro and XL10 V6 matches the Mark4 arm-sandwich concept. This is inferred from plate names and counts, not from an exploded drawing.
- None of the 8 mm frames I found is a unibody or a single-bottom-plate bolt-on design, based on the plate counts and the separate arm spares.

### Gaps
- **Standoff diameter (Ø6 vs Ø5 or smaller) was not found** for any candidate. Listings give lengths only (Rekon V1, XL10 V6).
- Exact standoff positions and spacing (four pairs, as on Mark4) were not confirmed for any candidate. An exploded view or manual is needed.
- Whether each frame's arms are clamped by the bottom plate plus a separate arm/middle plate (Mark4-style), or bolt to the bottom plate with the middle plate higher up, was not confirmed from drawings. Remaining needs: the Rekon10 Pro manual or RotorBuilds photos ([RotorBuilds 33696](https://rotorbuilds.com/build/33696/), [RotorBuilds 33765](https://rotorbuilds.com/build/33765)) and the iFlight Helion 10 and XL10 V6 manuals.
- Standoff counts and lengths for the Helion 10 and Rekon10 Pro V2 were not found.
