henriharmaala1-source/Assembly-grapher/research_notes/Mark4 10 inch frames 8mm arms/community_cad.md

# Mark4 10" frames with 8 mm arms: community knowledge, CAD files and hole-spacing identification

Research method note (applies to every section): WebSearch worked. Every WebFetch and curl attempt failed: WebFetch returned DNS errors (ENOTFOUND) for ecogalactics.cz, cults3d.com, 5.imimg.com, jinjiuyi.net, fpvkit.com.ua, rjxhobby.com and thingiverse.com, and the session egress proxy returned 403 to curl for the same hosts. So everything below comes from search-result snippets and the search engine's summaries of them, not from full page reads. No CAD file could be downloaded or measured. Treat each spec as "what the listing says", and look again wherever a note says so.

## 1. Do forums, reviews or hobby communities mention a Mark4 10" with 8 mm arms?

### Takeaway
None of the English, Russian, Ukrainian or Chinese searches found a forum thread, review or video about a Mark4 10" with 8 mm arms. Two shop listings name 8 mm: a Czech shop's "Mark4 V2 10 inch 8mm arm" frame, and a Ukrainian Rozetka listing for a pair of 8 mm **fiberglass (склотекстоліт)** replacement arms for the "Mark4 10" V2 427 mm". Every other listing for a 10" Mark4 gives 5, 6, 7 or 7.5 mm arms.

### Cited Findings
- A Czech shop (EcoGalactics) has a product titled "Drone frame Mark4 V2 10 inch 8mm arm". The snippet gives a 427 mm motor-to-motor distance. The search engine noted that the page also carries unrelated, spammy text, so the listing is of doubtful reliability. The page could not be fetched (DNS failure). — [ecogalactics.cz](https://www.ecogalactics.cz/en/drone-frame-mark4-v2-10-inch-8mm-arm/)
- Rozetka (Ukraine) lists "Промені до рами FPV Mark4 10 дюймів V2 427мм (склотекстоліт) нефарбовані 2шт" (arms for a Mark4 10" V2 427 mm frame, fiberglass laminate, unpainted, 2 pcs). The snippet gives the arm thickness as 8 mm and the material as склотекстоліт (FR4/G10-type fiberglass, not carbon). — [rozetka.com.ua](https://rozetka.com.ua/ua/459333884/p459333884/)
- Arm thickness given for the "Mark4 V2 10 / 427 mm" frame elsewhere (all from shop snippets):
  - 7.5 mm: AliExpress ("10inch 427mm w/ 7.5mm Arm", with 8"/9" at 6 mm) — [AliExpress](https://www.aliexpress.com/item/1005005897270664.html)
  - 7.5 mm: Readytosky, 427 mm, frame weight 270 g — [Rotorama](https://www.rotorama.com/product/readytosky-mark4-10-v2)
  - 7.5 mm: RJX — [rcdrone.top RJX listing](https://rcdrone.top/ru/products/rjxhobby-mark4-v2-10-inch-fpv-frame-kit-ru)
  - 7.5 mm: Tarot MARK4-10 (TL1613), H-frame, 427 mm, 331 × 269 mm, 238 g, 3 mm bottom and top plates — [tarotrc.com](http://www.tarotrc.com/Product/Detail.aspx?Lang=zh&Id=56801373-f309-4c85-b175-436961af57b2)
  - 7.5 mm: Axisflying-branded "3K MARK4 V2 10", 427 mm — [copterparts.ru](https://copterparts.ru/product/%D1%80%D0%B0%D0%BC%D0%B0-3k-mark4-v2-10/)
  - 7 mm: Zbotic, 424 mm, 235 g, 3.0 mm bottom/middle, 2.0 mm top, 2.5 mm side plates; it says the 10" is the only V2 size with 7 mm arms — [Zbotic](https://zbotic.in/product/mark4-v2-10-inch-carbon-fiber-fpv-frame-424mm-wheelbase/)
  - 7 mm: DRONE-BUD, 427 mm, 227 g — [drone-bud.com.ua](https://drone-bud.com.ua/ru/frames/MARK4-10-V2)
  - 7 mm: Alibaba ("427mm ... with 7mm Arm") — [Alibaba](https://www.alibaba.com/product-detail/MARK4-V2-10inch-427mm-Carbon-Fiber_1601044225730.html)
  - 6 mm: Quadkart ("Arm thickness: 6mm") — [Quadkart](https://www.quadkart.in/mark4-10-v2-frame-kit/)
  - 6 mm: Captain RC ("camera arm" 6 mm, 427 mm) — [Captain RC](https://captainrc.com/products/3k-carbon-fiber-frame-mark4-v2-8inch-367mm-9inch-387mm-10inch-427mm-wheelbase-rc-fpv-freestyle-racing-drone-frame-kit)
  - 6 mm: a T700 carbon version — [Anubis RC](https://anubisrc.com/product/mark4-10inch-v2-frame-kit-t700-toray-cf/)
  - 5 mm: The FPV Project, 450 mm diagonal — [thefpvproject.com](https://thefpvproject.com/product/mark10-v2-10-inch-carbon-fiber-fpv-frame/)
  - Drobonation gives a range of 5.0–7.5 mm arms and 427–473 mm wheelbase across its listings — [drobonation](https://drobonation1.odoo.com/shop/mark4-v2-10-inch-frame-90)
- GEPRC's own GEP-Mark4-10 has a 7 mm arm plate, a 3 mm mid plate (the plate that ties the arms together), a 3 mm base, a 2 mm top, 2.5 mm sides, 428–429 mm motor to motor, 376 × 303 mm overall, 30 mm aluminium standoffs and a 270 g weight. Shops also mention a "vertical-shaped reinforce arm". — [RMRC](https://www.readymaderc.com/products/details/86588-geprc-mark4-10-multirotor-frame); [Team BlackSheep](https://www.team-blacksheep.com/products/product:7652); [MyDrone.ru](https://mydrone.ru/rama-geprc-gep-mark4-10/)
- Ukrainian-made and Ukrainian-market Mark4 10" frames:
  - UDC Mark4 10: 7 mm 3K twill arms, 3 mm bottom plate, plates 2–3 mm, about 305 × 370 mm, about 250 g — [udc.net.ua](https://www.udc.net.ua/en/products/udc-mark4-10)
  - FIBERFORM Mark4 10": advertised as "reinforced" 7 mm arms — [alexandron.shop](https://alexandron.shop/ukrainska-rama-dlia-drona-marko4-10-diuimiv-fiberform-mark4-10/)
  - Readytosky / generic "Mark4 10 473 mm": 5 mm arms, 2.5 mm top and bottom plates — [detali.org.ua](https://detali.org.ua/ru/272588-karbonovaya-rama-mark4-dlya-fpv-drona-10-dyuymov-473-mm.html); [diyshop.com.ua](https://diyshop.com.ua/ua/rama-dlya-kvadrokoptera-mark4-10-frame-fpv-karbon-horoshaya-model-dlya-sborki-long-range)
- Where 8 mm arms do come up in 10" frame roundups, they belong to other frames: the iFlight XL10 V6 (8 mm variant, 420 mm) and an HGLRC 10" (415 mm). — [ohiodronellc roundup](https://www.ohiodronellc.com/best-10-inch-fpv-frames-for-cinematic-builds/)
- The searches found nothing on Reddit, RCGroups or IntoFPV about 8 mm arms on a Mark4 10". An AliExpress "wiki" review of the Mark4 V2 10" kit reads as promotional and gives no arm detail. — [AliExpress article](https://www.aliexpress.com/s/wiki-ssr/article/Mark4-V2-10in-FPV-drone-kit)

### Inferences
- Of the shop listings that give a thickness, the 427 mm "V2" family most often lists 7.5 mm, with 7 mm and 6 mm next. 8 mm is not a mainstream factory option for any Mark4 10" found.
- An 8 mm arm on the user's frame is most likely one of these:
  - a misread 7.5 mm arm (7.5 mm can measure about 7.7–8 mm with the weave and coating);
  - an aftermarket or locally cut arm, such as the 8 mm fiberglass arms on Rozetka;
  - a small-shop variant like the EcoGalactics listing.
- If the arm is a matte or grey-green laminate rather than twill carbon, fiberglass (склотекстоліт, FR4/G10) is plausible. Fiberglass arms are often cut thicker than carbon to make up for lower stiffness.
- The UDC Mark4 10 outline (305 × 370 mm) is close to the GEPRC Mark4 10 outline (303 × 376 mm). That suggests UDC follows the original GEPRC geometry rather than the 427 mm "V2" outline (268 × 332 mm). This is an inference from outline size only.

### Gaps
- The EcoGalactics and Rozetka pages could not be opened, so their full specs could not be read: arm-bolt spacing, whether the arm is one-piece or a pair of plates, and the photos.
- No forum, Discord or YouTube source discussing 8 mm Mark4 10" arms was found in any language searched.

## 2. STEP/DXF/STL files for Mark4 10" variants: what hole spacings and arm thicknesses do they show?

### Takeaway
Several community STEP models of Mark4 10" frames exist, on GrabCAD, Cults3D, CGTrader, Marathon-OS and Thingiverse. One GrabCAD "GEPRC MK4 V2 10in" upload claims better hole placement than an earlier one. GEPRC's own downloads page has no 3D or DXF files for the Mark4 10. No published DXF was found. No hole spacings could be read from these files, because none could be downloaded in this session.

### Cited Findings
- GrabCAD:
  - A "GEPRC Mark 4 Frame" model in 5–10" sizes. Its update note (8-13-24) says 5, 6, 7, 8, 9 and 10" models were added and that each file now holds the whole frame, not just the arms.
  - A separate "GEPRC MK4 V2 10in" model. Its uploader says it is "more accurate when it comes to hole..." placement than an existing upload.
  - Both were seen only via a user's likes page. — [GrabCAD likes page](https://grabcad.com/andy.lo-15/likes)
- Marathon-OS mirrors a "Geprc Mk4 V2 10In" STEP CAD model, with the native file listed as free (probably the same GrabCAD model). — [marathon-os.com](https://marathon-os.com/library/geprc-mk4-v2-10in-standard-mechanical-680dbef84366ea6baf6e9070)
- Cults3D:
  - "Frame Mark 4 10 inch (.STEP CAD Files)" by FlareFly: a ZIP of STEP parts including a "Carbon Fiber" part, 16 downloads at the time of the snippet — [Cults3D](https://cults3d.com/en/3d-model/gadget/frame-mark-4-10-inch-step-cad-files)
  - "FPV frame Mark4 v2 10inch": 3MF and STEP, stated wheelbase 427 mm, size 268.18 × 332.07 mm (matches the RJX/Readytosky V2 outline) — [Cults3D](https://cults3d.com/en/3d-model/gadget/fpv-frame-mark4-v2-10inch-deffinition)
  - "GEPRC MK4 10in" STEP by FPV_Lab — [Cults3D](https://cults3d.com/en/3d-model/gadget/geprc-mk4-10in)
  - "GEPRC Mark 4" clone-frame STEP in 5–10" sizes — [Cults3D](https://cults3d.com/en/3d-model/gadget/geprc-mark-4)
  - A "GEPRC Mark4 V2 10 inch Stack cover" STL — [Cults3D](https://cults3d.com/en/3d-model/gadget/geprc-mark4-v2-10-inch-stack-cover)
  - A "GEPRC mark4 V2 10 inch 7 inch SMA GPS mount" STL — [Cults3D](https://cults3d.com/en/3d-model/gadget/geprc-mark4-v2-10-inch-sma-gps-adaptor)
- CGTrader:
  - An "FPV frame Mark4 v2 10inch" 3D model — [CGTrader](https://www.cgtrader.com/3d-models/aircraft/other/fpv-frame-mark4-v2-10inch)
  - A printable "GEPRC MARK4 V2 10 INCH 7plusMM ARM PROTECTOR CLIP". The title implies the V2 10" arm is over 7 mm thick, which fits a 7.5 mm arm. — [CGTrader](https://www.cgtrader.com/3d-print-models/hobby-diy/robotics/geprc-mark4-v2-10-inch-7plusmm-arm-protector-clip-only-no-bolts)
- Thingiverse:
  - "GEPRC Mark 4 3D CAD model" by Al3x3 — [Thingiverse 4973650](https://www.thingiverse.com/thing:4973650)
  - A "GEPRC MARK4 V2 10 inch drone camera gimble" — [Thingiverse 6915348](https://www.thingiverse.com/thing:6915348)
  - A "GEPRC Mark 4 Arm Guard (16mm x 19mm screw holes)", which shows the arms take both 16 × 16 and 19 × 19 motor patterns — [Thingiverse 5325573](https://www.thingiverse.com/thing:5325573)
- MakerWorld has "Mark 4 V2 10" FPV side plates and mounts" (free) and a "Geprc Mark IV" collection. — [MakerWorld model](https://makerworld.com/en/models/1544024-mark-4-v2-10-fpv-side-plates-and-mounts); [MakerWorld collection](https://makerworld.com/en/collections/8473906-geprc-mark-iv)
- Polyzon indexes Mark 4 V2 10" mounts, including a GrabCAD dual-camera holder by Jan Okénka. It advises confirming hole spacing and arm/plate thickness before attaching parts. — [polyzon.org](https://polyzon.org/en/m/mark-4-v2-10-inch)
- GEPRC's "Mark4 Series" download page holds only flight-controller manuals and firmware text files for the Mark4 HD5, Mark4 and Mark4 Vista, and is marked as under improvement. It has no frame CAD. — [GEPRC Mark4 Series downloads](https://geprc.com/downloads/mark4-series/); [GEPRC Downloads](https://geprc.com/downloads/)
- A seller spec PDF for the "MARK4 V2 10 Inch Carbon Fiber Long Range FPV Drone Frame" is hosted on IndiaMART's image CDN. It could not be fetched. — [imimg.com PDF](https://5.imimg.com/data5/SELLER/Doc/2026/2/580489223/UR/CK/IE/75360989/mark4-10-inch-carbon-fiber-long-range-fpv-drone-frame.pdf)
- vmasshtabe.ru has a page on reworking a Mark4 10" FPV frame to fit a Caddx GM3 gimbal, under its "drawings, 3D models" section. It was not opened. — [vmasshtabe.ru](https://vmasshtabe.ru/diy/rama-fpv-10-dyujmov-dorabotka-pod-ustanovku-podvesa-caddx-gm3.html)
- Common published hole patterns for the 427 mm Mark4 V2 10":
  - flight controller 30.5 × 30.5 or 20 × 20 mm
  - motors 16 × 16 or 19 × 19 mm
  - 19 mm camera
  - 35 mm inner height, with 8 × M3 × 35 × D6 standoffs
  - outline about 268 × 332 mm
  - Sources: [Amazon](https://www.amazon.com/Mark4-8inch-367mm-10inch-Carbon/dp/B0G5GRZ31C); [vegadrones.in](https://vegadrones.in/product/mark4-v2-10-inch-frame/); [Zbotic](https://zbotic.in/product/mark4-v2-10-inch-carbon-fiber-fpv-frame-424mm-wheelbase/)
- Published hole patterns for the GEPRC Mark4 10":
  - flight controller 30.5 × 30.5 mm (M3)
  - VTX 30.5 × 30.5 mm (M3), 25.5 × 25.5 mm (M2) or 20 × 20 mm (M2)
  - camera 19 × 19 mm (M2)
  - motors 19 × 19 mm (M3)
  - Sources: [GEPRC](https://geprc.com/product/gep-mark4-frame/); [Team BlackSheep](https://www.team-blacksheep.com/products/product:7652)

### Inferences
- At least two geometry families have STEP files:
  - the original GEPRC Mark4 10 (about 376 × 303 mm, 428 mm, 7 mm arm plate), via GrabCAD, Cults3D and Thingiverse;
  - the "Mark4 V2" 427 mm family (about 268 × 332 mm, mostly 7.5 mm arms), via the Cults3D V2 model, CGTrader and probably the GrabCAD "GEPRC MK4 V2 10in" upload.

  The "GEPRC" label on V2 models is likely loose naming. Most 427 mm V2 frames are sold under the RJX, Readytosky, HSKRC, Tarot or Axisflying names, and none of the listings found was a GEPRC-branded "V2" 10".
- The fastest way to match the user's frame is to download the GrabCAD "GEPRC MK4 V2 10in" model and the Cults3D "FPV frame Mark4 v2 10inch" model, then measure their standoff pairs and arm-bolt spacing against the user's numbers (19–20 / 20 / wide front, inner arm holes about 24 mm). This could not be done here.

### Gaps
- No standoff-pair or arm-bolt spacings were found as text in any source. They exist only inside the CAD files, which could not be downloaded.
- No manufacturer DXF or dimensioned drawing was found for any Mark4 10".

## 3. Which Mark4 versions have 20 mm-wide middle standoff pairs (like GEPRC) vs 24 mm (like RJX)? Which have 24 mm arm-bolt spacing?

### Takeaway
No source gives standoff-pair or arm-bolt spacings in text. The only measured comparisons are the two STEP files the user already has: GEPRC 7" 31.4 / 20 / 20 / 19 mm with inner arm holes 20 and 36 mm, and RJX V2 10" 31.4 / 24 / 24 / 19 mm. Outline dimensions do let frames be sorted into the GEPRC-geometry family or the 427 mm V2 family, which is a first step.

### Cited Findings
- GEPRC-geometry 10" outline is about 376 × 303 mm with 428 mm motor to motor — [RMRC](https://www.readymaderc.com/products/details/86588-geprc-mark4-10-multirotor-frame). UDC Mark4 10 is about 305 × 370 mm — [udc.net.ua](https://www.udc.net.ua/en/products/udc-mark4-10).
- V2-family 10" outline is about 268 × 332 mm with 427 mm wheelbase. This is shared by RJX — [rjxhobby.com](https://www.rjxhobby.com/rjx-mark4-v2-10inch-427mm-carbon-fiber-twill-matte-frame-kit-for-rc-fpv-racing-drone) — and Tarot at 331 × 269 mm — [tarotrc.com](http://www.tarotrc.com/Product/Detail.aspx?Lang=zh&Id=56801373-f309-4c85-b175-436961af57b2).
- Some listings sell the "473 mm" Mark4 10 as a distinct frame with 5 mm arms — [detali.org.ua](https://detali.org.ua/ru/272588-karbonovaya-rama-mark4-dlya-fpv-drona-10-dyuymov-473-mm.html). Other "473 mm" labels appear on 427 mm V2 listings and look like labelling errors; Anubis RC's 473 mm listing says 427 mm in its key features — [Anubis RC](https://anubisrc.com/product/mark4-10inch-v2-frame-kit-t700-toray-cf/); [dronehub.in.ua](https://dronehub.in.ua/product/mark4-v2-10inch/).
- GEPRC sells replacement arms for the original Mark4 in 7", 8" and 10" — [Rotorama](https://www.rotorama.com/product/geprc-mark4-dily). Some shops list GEPRC Mark4 spares only in 5", 6" and 7" — [Unmanned Tech](https://www.unmannedtechshop.co.uk/fr/products/geprc-mark-4-spare-arm-5-6-7-inch).

### Inferences
- The user's layout has rear pair 19–20 mm, second pair 20 mm and a wide front pair. A 20 mm middle pair matches the GEPRC pattern (…/20/20/19) better than RJX V2 10" (…/24/24/19).
- The 24 mm inner arm-hole spacing matches neither reference: GEPRC 7" has 20 and 36 mm. This points to a third geometry. Candidates are a GEPRC-style 10" (GEPRC Mark4 10, UDC or other Ukrainian clones), whose arm-bolt pattern may differ from the 7" because the 10" arm is wider; a hybrid clone; or an aftermarket arm cut with its own hole pattern.
- Measuring the outline (about 303–305 × 370–376 mm versus 268 × 332 mm) and motor-to-motor distance (428 versus 427 versus 473 mm) should place the frame in a family quickly. Exact standoff matching still needs the GrabCAD or Cults3D STEP files.

### Gaps
- Arm-bolt spacing for the GEPRC Mark4 10", UDC, FIBERFORM, Tarot, HSKRC and Readytosky frames is not published in any source found.
- Without reading the CAD files, it cannot be confirmed which versions use 20 mm and which use 24 mm middle standoff pairs.

## 4. Are there aftermarket 8 mm replacement arms for Mark4 10" frames?

### Takeaway
Yes, but only one was found. A Ukrainian listing on Rozetka sells a pair of unpainted 8 mm fiberglass (склотекстоліт) arms for the "Mark4 10" V2 427 mm". No 8 mm carbon replacement arm for a Mark4 10" was found from GEPRC or any major clone maker.

### Cited Findings
- Rozetka listing: a pair of arms for the Mark4 10" V2 427 mm frame, fiberglass, unpainted, 8 mm thick, in stock at the time of the snippet — [rozetka.com.ua](https://rozetka.com.ua/ua/459333884/p459333884/)
- GEPRC sells original Mark4 replacement arms (7", 8", 10"), but their thickness and hole patterns were not given in the snippet — [Rotorama](https://www.rotorama.com/product/geprc-mark4-dily)
- A Mark4 7" replacement arm is listed at 5 mm thick — [brookealvinston.com listing](https://brookealvinston.com/products/mark4-7inch-arm-thickness-295mm-5mm-replaceable-accessories/216412196/)
- An 8 mm replacement arm does exist for the Kayou Kayouloin 7", which is not a Mark4 — [Pyrodrone](https://pyrodrone.com/products/kayou-frames-kayouloin-7-inches-replacement-arm-99)
- Ukrainian searches for 8 mm carbon Mark4 10" arms ("промені 8мм карбон", "посилені промені 8мм") found only complete frames with 5–7.5 mm arms — [flyteam.com.ua](https://flyteam.com.ua/frame/mark410v2); [fx-drones.com](https://fx-drones.com/rama-readytosky-mark4-v2-10-427mm-karbonova-rama-10-diuimovoho-fpv-drona/); [ukrob.com.ua](https://ukrob.com.ua/catalog/category-e3af6452/mark4_frame_10ichv2/)

### Inferences
- The Rozetka arms are sold for the "V2 427 mm" frame, so they presumably copy the RJX/Readytosky V2 arm-bolt pattern. If the user's frame has 8 mm fiberglass arms, comparing its arm-bolt spacing with the RJX V2 STEP is a reasonable check. The user's 20 mm middle standoff pair does not match the RJX V2's 24 mm, though, so the arms may be on a different body.
- Other local shops in Ukraine and Eastern Europe may sell similar fiberglass or 8 mm arms that the search engine did not index.

### Gaps
- The Rozetka listing could not be opened, so its arm-bolt spacing, arm length, photos and seller name are unknown.
- No 8 mm carbon aftermarket arm for any Mark4 10" was found.
