henriharmaala1-source/Assembly-grapher/research_notes/Mark4 10 inch frames 8mm arms/branded_mark4.md

# Branded Mark4 (MK4) family 10-inch frames: arm thickness, and whether any use 8 mm arms

Research method note: direct page fetches (WebFetch and curl) were refused by this session's egress proxy (`connect_rejected` / DNS failure for getfpv.com, rotorama.com, readymaderc.com, unmannedtechshop.co.uk). Every figure below therefore comes from search-engine result summaries of the cited pages, not from reading the full pages myself. Quotes marked "quoted" are the wording the search summaries attributed to the page. Spot-check the 8 mm listings in a browser before relying on them. As of 2026-10-27.

## Which makers sell a Mark4 / MK4-layout 10" frame, and what do they list?

### Takeaway
No branded true Mark4-layout 10" frame was found that lists 8 mm arms on the maker's own spec sheet or on a mainstream reseller page. GEPRC GEP-Mark4-10, GEPRC Mark4 LR10, Tarot TL1613 and Aocoda list 7 mm. The generic or Readytosky/RJX "Mark4 V2 10" (427 mm) lists 7.5 mm. The only 10" "8 mm arm" listings found are reseller or marketplace listings of the **iFlight XL10 V6**, which is not a Mark4, and iFlight's own shop says 7 mm. The Rekon10 PRO (not a Mark4) also lists 8 mm arms.

### Per-frame table

| Frame (maker) | Arm thickness (quoted) | Wheelbase | Plates | Standoff / internal height | Stack | Price seen | Source of figure | 8 mm? |
|---|---|---|---|---|---|---|---|---|
| GEPRC GEP-Mark4-10 | "Arm plate: 7mm", "Armbar: 3mm"; feature bullet also says "3.7mm Thickness Arm Structure" (inconsistent) | 428 mm (GetFPV), 429 mm (rcdrone.top) | Side 2.5, base 3, top 2, mid 3 mm | 30 mm aluminum standoffs (UAV Garage); one listing says 25 mm stack mounting height | FC 30.5x30.5 M3; VTX 30.5/25.5/20 | $66.43 RMRC (in stock); $76.99 Pyrodrone (out of stock); $95 rcdrone.top; INR 6,499-6,999 | Resellers (GetFPV, RMRC, TBS, Pyrodrone, rcdrone.top). geprc.com page exists but its specs were not retrieved | No |
| GEPRC Mark4 LR10 (BNF / frame) | "Arm thickness: 7mm", "Brace thickness: 3mm" (Rotorama); "Arm thickness: 7mm ... Stiffener bar thickness: 3mm" (rcdrone.top) | not retrieved | not retrieved | not retrieved | not retrieved | not retrieved | Resellers | No |
| Readytosky Mark4 10" V2 | "Arm thickness: 7.5mm" | Key features say "Motor diagonal distance: 427mm"; same page's text says 473 mm (conflict) | Top 2, bottom 3 mm | not retrieved | 30.5x30.5 (generic V2 listings) | not retrieved | Reseller (Rotorama); no official Readytosky spec sheet found | No |
| RJX(HOBBY) Mark4 V2 10" | "arms 7.5 mm thick" (rcdrone.top, Japanese) | 427 mm | not retrieved | not retrieved | not retrieved | not retrieved | Reseller; rjxhobby.com not retrieved | No |
| Generic / unbranded "Mark4 V2 10 inch 427mm" (incl. TCMMRC-style listings on AliExpress, Amazon, Walmart) | 7.5 mm most common; also 7 mm, 6 mm, 5 mm on some listings | 427 mm (most); also 424, 425, 450, 473 mm | Top 2-2.5, bottom 2-3, mid 3 mm | 35 mm internal (fpvdroneframe.com) | 30.5x30.5 M3 and 20x20 M2 | varies | Marketplace listings | No |
| Unmanned Tech "Mark4 10 V2 Long Range - 7.5mm Carbon Beast" | 7.5 mm (in product title/URL) | not retrieved | not retrieved | not retrieved | not retrieved | not retrieved | Reseller | No |
| Anubis RC Mark4 10" V2 T700 Toray | "Arm thickness: 6mm" | 473 mm | not retrieved | not retrieved | not retrieved | not retrieved | Reseller | No |
| The FPV Project Mark4 V2 10" | "Arm Thickness \| 5mm" | 450 mm | not retrieved | not retrieved | not retrieved | not retrieved | Reseller (looks like a different, lighter cut, about 155 g) | No |
| Tarot TL1613 (Mark4-10 copy) | "Arm thickness: 7mm" | not retrieved | Bottom 3, top 3 mm | not retrieved | not retrieved | not retrieved | Reseller (Flying Tech UK); tarot-rc.com lists the product but no specs retrieved | No |
| Aocoda Mark 4 10inch 420mm | "Arm Thickness 7mm" (in title) | 420 mm | not retrieved | not retrieved | not retrieved | not retrieved | Maker's own shop (aocoda-rc.com) | No |
| FlyfishRC Mark4 10" | 7 mm | not retrieved | not retrieved | not retrieved | not retrieved | not retrieved | Reseller (Rotorama) | No |
| iFlight Nazgul XL10 V6 (not Mark4: unibody-style, 420 mm) | Official: "Arm Thickness: 7mm" | 420 mm; frame L297*W297*H35 mm | Top, upper, bottom 3 mm | 35 mm frame height; max stack 19 mm, max VTX 29 mm | 30.5x30.5 and 20x20 | not retrieved | **Maker (shop.iflight.com)** = 7 mm | **8 mm on resellers only** (see below) |
| Rekon FPV Rekon10 PRO (not Mark4) | 8 mm front and rear arms | 455 mm | Top 3, bottom 3 mm | not retrieved | not retrieved | not retrieved | Resellers (GetFPV, Rising Sun FPV) | **Yes** (not a Mark4) |
| DarwinFPV X10 (folding, not Mark4) | 7 mm | 410 mm (title) | Top 2 mm | 35 mm internal | not retrieved | not retrieved | Reseller (QWinOut) | No |

### Cited Findings
- GEPRC Mark4 10 spec list: "Side plate: 2.5mm, Base plate: 3mm, Arm plate: 7mm, Top plate: 2mm, Midplate: 3mm, Armbar: 3mm", plus a feature bullet "Vertical-Shaped Reinforced Arms - 3.7mm Thickness Arm Structure", motor-to-motor 428 mm, 270 g — [GetFPV](https://www.getfpv.com/geprc-mark4-10-frame-kit.html)
- The same frame is listed at a 429 mm wheelbase — [rcdrone.top](https://rcdrone.top/products/geprc-gep-mark4-10-429mm-wheelbase-10-inch-fpv-drone-frame)
- "Arm Plate Thickness: 7mm" and "Vertical Arm Reinforcement: 3mm Arm Bar"; $66.43, in stock — [RMRC](https://www.readymaderc.com/products/details/86588-geprc-mark4-10-multirotor-frame)
- TBS lists a 7 mm arm plate and also repeats the 3.7 mm bullet — [Team BlackSheep](https://www.team-blacksheep.com/products/product:7652)
- 376x303 mm footprint, $76.99, out of stock — [Pyrodrone](https://pyrodrone.com/products/geprc-gep-mark4-10-fpv-10-long-range-frame-kit)
- FC hole 30.5x30.5 M3; VTX 30.5/25.5/20 mm — [DiyFPV](https://www.diyfpv.com/product/geprc-gep-mark4-10-fpv-10-long-range-frame-kit)
- 30 mm aluminum standoffs — [UAV Garage](https://uavgarage.com/shop/geprc-gep-mark4-10-frame-kit-for-fpv-drone/); a "25mm stack mounting height" is claimed on a third-party compatible-parts listing — [Amazon](https://www.amazon.com/Compatible-GEP-Mark4-10-Racing-Quadcopter-Accessories/dp/B0GKZGFV55)
- About 270 g, rated 3 kg payload — [Unmanned Times](https://www.unmannedtimes.com/products/air-frames/geprc/20-11-gep-mark4-10-frame); [Quad Junkie](https://www.quadjunkie.co.nz/product/geprc-mark4-10-inch-frame/)
- GEPRC's own GEP-Mark4 product page exists (specs not retrieved) — [geprc.com](https://geprc.com/product/gep-mark4-frame/)
- GEPRC Mark4 LR10: "Arm thickness: 7mm", "Brace thickness: 3mm" — [Rotorama](https://www.rotorama.com/product/geprc-geprc-mark4-lr10-6s-elrs-915mhz); "Arm thickness: 7mm ... Stiffener bar thickness: 3mm" — [rcdrone.top](https://rcdrone.top/products/geprc-mark4-lr10-5-8g-1-6w-long-range-fpv)
- Readytosky Mark4 10" V2: "Arm thickness: 7.5mm", "Motor diagonal distance: 427mm" (the description text says 473 mm), top 2 mm, bottom 3 mm, 270 g — [Rotorama](https://www.rotorama.com/product/readytosky-mark4-10-v2)
- RJXHOBBY Mark4 V2 10": arms 7.5 mm — [rcdrone.top](https://rcdrone.top/ja/products/rjxhobby-mark4-v2-10-inch-fpv-frame-kit-ja)
- Generic Mark4 V2 10" with a 427 mm wheelbase and a 7.5 mm arm — [AliExpress](https://www.aliexpress.com/item/1005005897270664.html); [fpvdroneframe.com](https://fpvdroneframe.com/product/mark4-v2-10-inch-long-range-fpv-frame/) (also gives 35 mm internal height); [rcshopbd](https://www.rcshopbd.com/product/mark4-v2-10-carbon-fiber-long-range-fpv-frame/); [Amazon CxzHtv](https://www.amazon.com/Mark4-10inch-Carbon-Quadcopter-Freestyle/dp/B0FJFLSK7H); [Amazon](https://www.amazon.com/10inch-427mm-Carbon-Fiber-Frame/dp/B0GWP9SJCN)
- Zbotic says the 10" is the only V2 size with 7 mm arms (other sizes use 6 mm), with a 424 mm wheelbase — [Zbotic](https://zbotic.in/product/mark4-v2-10-inch-carbon-fiber-fpv-frame-424mm-wheelbase/)
- Other variants list 7 mm and 425 mm — [Amazon](https://www.amazon.com/10inch-Carbon-Compatible-Propeller-Freestyle/dp/B0DP7CGFCQ); 6 mm and 473 mm on a T700 kit — [Anubis RC](https://anubisrc.com/product/mark4-10inch-v2-frame-kit-t700-toray-cf/); 6 mm — [Quadkart](https://www.quadkart.in/mark4-10-v2-frame-kit/); 5 mm and 450 mm — [The FPV Project](https://thefpvproject.com/product/mark10-v2-10-inch-carbon-fiber-fpv-frame/)
- "7.5mm Carbon Beast" Mark4 10 V2 — [Unmanned Tech](https://www.unmannedtechshop.co.uk/de/products/mark4-10-v2-long-range-fpv-frame-7-5mm-carbon-beast)
- Tarot TL1613: "Arm thickness: 7mm", bottom 3 mm, top 3 mm — [Flying Tech](https://www.flyingtech.co.uk/product/tarot-10-inch-drone-frame-tl1613/); the product is listed on [tarot-rc.com](https://www.tarot-rc.com/all-products.html)
- "Mark 4 10inch 420mm Arm Thickness 7mm" — [Aocoda-RC](https://www.aocoda-rc.com/products/72)
- FlyfishRC Mark4 10": 7 mm arms — [Rotorama](https://www.rotorama.com/product/flyfish-mark4-10)
- DarwinFPV X10: 7 mm arms, 2 mm top, 35 mm internal height — [QWinOut](https://qwinout.com/products/darwinfpv-fpv-x10-frame-long-range-folding-frame-kit-10-inch-410mm-wheelbase-for-drone-quadcopter-parts)

### Inferences
- The "3.7 mm" GEPRC figure is almost certainly a copy error repeated across resellers, since the same spec lists give a 7 mm arm plate plus a 3 mm vertical arm bar.
- The 7.5 mm figure belongs to the Readytosky/RJX/generic Mark4 V2 10" cut (427 mm), which looks like one factory design sold under many labels.
- The 473 mm figure that appears on Rotorama's Readytosky page and Anubis RC is probably a different (stretched) cut or a typo. It conflicts with the 427 mm figure on the same Rotorama page.

### Gaps
- Fetching pages was blocked, so I could not read full spec tables, manuals or DXF/STEP files. I have no standoff hole spacing or arm-clamp hole pattern for any frame.
- No official manufacturer spec was retrieved for GEPRC (beyond the page's existence), Readytosky, RJX or Tarot.
- Search turned up no 10" Mark4-layout spec data from Axisflying, Foxeer, Diatone, Shendrones, JMT or Lumenier. I could not determine whether these brands sell a true Mark4 10" at all.
- I found no "Mark4 V3" or "Mark 4 V4" 10" listing. One search summary mentioned an 8 mm arm on a generic "Mark4 V3 Pro" 13"/15" frame, which is outside the 10" scope, and no URL was given for it.
- The price and stock status of most entries were not retrieved.

## Does any version list 8 mm arms in the 10" size? Maker or reseller?

### Takeaway
Within the true Mark4 family, no. The 8 mm listings in the 10" class are for the iFlight XL10 V6 and the Rekon10 PRO, neither of which is a Mark4. For the XL10 V6, the 8 mm figure comes **only from resellers and marketplaces**, and iFlight's own shop lists 7 mm. For the Rekon10 PRO, 8 mm comes from resellers (GetFPV, Rising Sun); the maker's page was not checked.

### Cited Findings
- iFlight official XL10 V6: "Wheelbase: 420mm, Frame Dimension: L297*W297*H35mm, Arm Thickness: 7mm", plates 3 mm, 343±5 g; max stack height 19 mm, max VTX 29 mm; XL10 V5 and V6 parts are not compatible — [iFlight shop](https://shop.iflight.com/xl10-v6-10-inch-fpv-frame-Pro1967); [iFlight XL10 V6 parts](https://shop.iflight.com/drone-frame-cat346/XL10-V6-Replacement-Parts-Pro2044)
- 7 mm also on resellers — [Pyrodrone](https://pyrodrone.com/products/iflight-nazgul-xl10-v6-10-frame-kit); [NextFPV](https://www.nextfpv.com/products/iflight-nazgul-xl10-v6-10-inch-frame-kit); [GetFPV](https://www.getfpv.com/iflight-nazgul-xl10-v6-10-frame-kit.html); [Openelab](https://openelab.io/products/iflight-nazgul-xl10-v6-10); [rcdrone.top "with 7mm arm"](https://rcdrone.top/products/iflight-xl10-v6-420mm-10inch-fpv-frame-kit-with-7mm-arm-compatible-with-dji-o3-air-unit-caddx-vista-hd-system-for-fpv-drone)
- **8 mm (reseller) listings:** ReadyMadeRC says "ultra-rigid 8mm carbon fiber arms" and its package list includes "4x 8mm Carbon Fiber Arms" — [RMRC](https://www.readymaderc.com/products/details/86869-iflight-nazgul-xl10-v6-10-inch-frame-kit); "Arm Thickness: 8mm" — [rcdrone.top](https://rcdrone.top/products/iflight-xl10-v6-420mm-10inch-fpv-frame-kit); eBay title "iFlight XL10 V6 10" FPV Frame Kit 420mm, 8mm arm", though its spec table reportedly says 7 mm — [eBay](https://www.ebay.com/itm/176102071321); Made-in-China lists "with 8mm Arm" in one listing and 7 mm/8 mm in conflicting tables in another — [Made-in-China](https://m.made-in-china.com/product/Iflight-XL10-V6-Fpv-Frame-with-8mm-Arm-Fpv-System-2011319242.html); [Made-in-China (Dongying Youjia)](https://dongyingyoujia.en.made-in-china.com/product/pJTRyqrljGYE/China-Iflight-XL10-V6-5-8g-Image-Transmission-10-Inch-Fpv-Drone-Frame.html)
- Rekon10 PRO: 8 mm front and rear arms, 455 mm wheelbase, about 397 g, 3 mm top and bottom plates — [GetFPV](https://www.getfpv.com/rekon-fpv-rekon10-pro-long-range-frame-kit-10.html); [Rising Sun FPV](https://risingsunfpv.com/products/rekon10-pro-long-range-frame-kit-10-inch-for-fpv-racing-drone)
- Clones such as "XL10 V7" (TrueX, 420 mm) and XL10 V6 copies on Amazon list 7 mm arms — [Amazon XL10 V7](https://www.amazon.com/Carbon-Wheelbase-Thickness-10Frame-Accessories/dp/B0GG9L7KFH); [Amazon XL10 V6 clone](https://www.amazon.com/420mm-10inch-Frame-Drone-Parts/dp/B0H69QVB27)

### Inferences
- The XL10 V6 "8 mm" figure is most likely a reseller error that spread across marketplaces, or possibly an unannounced revision. The maker says 7 mm, and RMRC's and rcdrone.top's own sibling listings say 7 mm.
- If the parent project needs a true 8 mm-arm 10" Mark4, it probably does not exist as a catalogue item. The closest options are a 7.5 mm Mark4 V2 10" or a custom 8 mm arm cut.

### Gaps
- I could not view the RMRC XL10 V6 page directly to confirm the exact wording, or check whether RMRC's spec table itself says 8 mm.
- Rekon FPV's own spec page was not checked.
- iFlight XL10 V5 arm thickness was not found.
- No 2024-2026 "reinforced" or "heavy" Mark4 10" edition with 8 mm arms turned up in search. The only "reinforced" 10" found was the LX10 V2 (a folding frame with 7 mm arms) — [Amazon](https://www.amazon.com/Reinforced-Foldable-Carbon-Frame-Wheelbase/dp/B0GPNJPSWB)

## Wheelbase and standoff spacing of each

### Takeaway
Wheelbases: GEPRC Mark4 10 is 428/429 mm, the Mark4 V2 10" is 427 mm (with outliers of 424, 425, 450 and 473 mm), Aocoda is 420 mm, the iFlight XL10 V6 is 420 mm and the Rekon10 PRO is 455 mm. Standoff heights come from sellers only: 30 mm for GEPRC, and 35 mm internal height for the generic V2 and DarwinFPV X10. No source gave standoff hole spacing or a drawing.

### Cited Findings
- GEPRC: 428 mm — [GetFPV](https://www.getfpv.com/geprc-mark4-10-frame-kit.html); 429 mm — [rcdrone.top](https://rcdrone.top/products/geprc-gep-mark4-10-429mm-wheelbase-10-inch-fpv-drone-frame); 30 mm standoffs — [UAV Garage](https://uavgarage.com/shop/geprc-gep-mark4-10-frame-kit-for-fpv-drone/)
- Mark4 V2 10": 427 mm with 35 mm internal height — [fpvdroneframe.com](https://fpvdroneframe.com/product/mark4-v2-10-inch-long-range-fpv-frame/); 427 mm and 473 mm both appear on the same page — [Rotorama](https://www.rotorama.com/product/readytosky-mark4-10-v2)
- iFlight XL10 V6: 420 mm, height 35 mm — [iFlight shop](https://shop.iflight.com/xl10-v6-10-inch-fpv-frame-Pro1967)

### Inferences
- A 427 mm Mark4 V2 10" has 7.5 mm arms and a stack area that carries over from the smaller Mark4 V2 sizes. That makes it the closest catalogue part to an "8 mm Mark4 10"" spec.

### Gaps
- No source gave standoff hole spacing (the X/Y between the Ø6 standoffs) or the arm-clamp bolt pattern for any frame. That needs the makers' DXF/STEP files or manuals, which could not be fetched in this session.
