henriharmaala1-source/Assembly-grapher/research_notes/Mark4 10 inch frames 8mm arms/marketplaces.md

# Marketplace and clone listings: Mark4-style 10" frames with 8 mm arms

Method note (applies to every section): research ran on 2026-10-27 using web-search results only. Direct page fetches (WebFetch and curl) to aliexpress.com, amazon.com, ebay.com, rotorama.com and rcdrone.top all failed in this environment (DNS failure or proxy 403 on CONNECT). So every spec below comes from the search engine's snippet or summary of the listing, not from a page I read myself. Before anyone buys, each figure should be checked against the live page. I could not check stock, sold-out status or current price on any listing. The exceptions are a few prices the search snippets showed. About 15 searches were run, in English and Chinese, covering AliExpress, Amazon, eBay (.com/.de), Banggood, Temu, Walmart, Taobao/1688 and the reseller and store sites they led to.

## Do the general marketplaces (AliExpress, Amazon, Banggood, eBay, Temu, Walmart, Taobao, 1688, JD) list a "Mark4 10 inch 8mm arm" frame?

### Takeaway
I found no marketplace listing for a Mark4-style 10" frame (V2, V3 or V4) that states 8 mm arms, explicitly or by implication. Across all the platforms I could see, the 10" Mark4 clones state 7.5 mm arms (most often), 7 mm (GEPRC original and some clones), 6 mm or 5 mm. In the Mark4 family, 8 mm arms show up only on the larger Readytosky Mark4 V3 Pro 13" (570 mm) and 15" (680 mm) frames. The only 10" frame with 8 mm arms in the results is a non-Mark4 design, the iFlight XL10 V6.

### Cited Findings
**AliExpress**
- "Mark4 V2 Mark 4 8inch 367mm 9inch 387mm with 6mm Arm / 10inch 427mm w/ 7.5mm Arm FPV Racing Drone Quadcopter Freestyle Frame Kit". Item 1005005897270664 (US mirror 3256805710955912). The title says 7.5 mm, so the figure is title-stated, not 8 mm. Store name and price were not visible in the snippets. — [AliExpress](https://www.aliexpress.com/item/1005005897270664.html); [AliExpress US mirror](https://www.aliexpress.us/item/3256805710955912.html?gatewayAdapt=deu2usa4itemAdapt)
- AliExpress category and search pages list other 10" Mark4 kits, such as "MAK4 V2 MARK4 FPV Drone Carbon Fiber Frame KIT 8inch 367mm 9inch 387mm 10inch 427mm" and "Mark4 V2 Mark 4 7inch 295mm / 8inch 367mm / 9inch 387mm / 10inch 427mm 3K Full Carbon Fiber TrueX Frame". The snippets gave no arm thickness, and none said 8 mm. On the same AliExpress search pages, the only 10" frame with 8 mm arms was "IFlight XL10 V6 10' FPV Frame Kit 420mm 8mm Arm", which is not a Mark4 design. — [AliExpress 10 inch frame kit carbon](https://www.aliexpress.com/w/wholesale-10-inch-frame-kit-carbon.html); [AliExpress 10 inch drone frame](https://www.aliexpress.us/w/wholesale-10-inch-drone-frame.html)

**Amazon (US; no other region turned up in search)**
- "Mark4 V2 7/8/9/10-inch Carbon Fiber Drone Frame (8-Inch)", B0F92W1GP1. No arm thickness in the snippet. — [Amazon](https://www.amazon.com/Mark4-10-inch-Carbon-Fiber-8-Inch/dp/B0F92W1GP1)
- "Mark4 V2 3K Carbon Fiber TrueX Frame ... 10 Inch 427mm (Mark4 V2 10inch)", B0DRS9M859. The snippet gives a plate size of "268.18mm*332.07mm" and no arm thickness. — [Amazon](https://www.amazon.com/Carbon-Compatible-Camera-Available-10inch/dp/B0DRS9M859)
- "For MARK4 V2 3K Carbon Fiber Frame 8inch 367mm 9inch 387mm 10inch 427mm WheelBase", B0DZP2KKQW. — [Amazon](https://www.amazon.com/Carbon-10inch-WheelBase-Freestyle-Racing/dp/B0DZP2KKQW)
- "CxzHtv Mark4 10inch V2 427mm 3K Carbon Fiber Frame", B0FJFLSK7H. — [Amazon](https://www.amazon.com/Mark4-10inch-Carbon-Quadcopter-Freestyle/dp/B0FJFLSK7H)
- "Mark4 V2 Carbon Fiber Frame, 7 8 9 10 Inch Drone Kit", B0H865FKZ8. — [Amazon](https://www.amazon.com/Carbon-quadcopter-airframe-freestyle-racing/dp/B0H865FKZ8)
- "CUIPPWRJ MARK4 V2 Drone Frame 8/9/10inch 367/387/427mm", B0DNF9KFQR. No arm thickness per size. — [Amazon](https://www.amazon.com/clp/B0DNF9KFQR)
- "Replacement for MARK4 V2 10inch Frame 425mm 1PC Carbon Fiber Frame ... Compatible with 3115 Motor 1050 Propeller", B0GGMDRL9F. The search summary says this 3TVol-branded listing gives 7.0 mm arms. It is a whole frame (gives a 425 mm wheelbase), not spare arms. — [Amazon](https://www.amazon.com/Replacement-10inch-Freestyle-Compatible-Propeller/dp/B0GGMDRL9F)
- None of the Amazon listings above mentioned 8 mm in any snippet.

**eBay**
- "MARK4 V2 7/8/9/10" Carbon Fiber Drone Frame 6mm Arm for RC FPV Racing Drone", US $34.57, seller given as Chengzhi RC Parts. The arm figure is title-stated: 6 mm. — [eBay 395595061304](https://www.ebay.com/itm/395595061304)
- "MAK4 V2 MARK4 FPV Drone Frame Kit 10inch 427mm Carbon Fiber For Remote PVAF". No arm thickness in the snippet. — [eBay 406077607758](https://www.ebay.com/itm/406077607758)
- eBay.de "Mark4/MAK4 V2 8/9/10 Zoll Kohlefaser Drohnen Rack FPV" (two listings). No arm thickness in the snippets. — [eBay.de 335552173755](https://www.ebay.de/itm/335552173755); [eBay.de 266780320871](https://www.ebay.de/itm/266780320871)

**Banggood**
- The Banggood results were mostly 8" Mark4 frames with 5 mm arms. I found no 10" Mark4 frame with 8 mm arms there. — [Banggood 9 fpv frame](https://www.banggood.com/buy/9-fpv-frame.html)

**Temu / Walmart**
- No Temu result came back. The Walmart results were picture frames, except for a "Drones Frames" category page that showed a Mark4 V2 8" (367 mm) frame with no arm spec. — [Walmart drones frames](https://www.walmart.com/c/kp/drones-frames)

**Taobao / 1688 / JD (Chinese searches: "MK4 10寸 机架 8mm 机臂", "Mark4 十寸 机架 8mm 碳纤维 机臂", "淘宝 MARK4 10寸 机架 机臂厚度 8mm 427轴距")**
- No Taobao, 1688 or JD product page came back in any search. The closest Chinese-language source was the Tarot manufacturer page for "TAROT 穿越机/FPV赛级竞速/10寸碳纤机架/MARK4-10 TL1613". It lists 轴距 427mm, 重量 238g and "机臂厚度：7.5mm", with 3 mm top and bottom plates and an H-frame layout. — [Tarot TL1613 (zh)](http://tarotrc.com/Product/Detail.aspx?Lang=zh-cn&Id=56801373-f309-4c85-b175-436961af57b2); [Tarot TL1613 (es)](http://www.tarotrc.com/Product/Detail.aspx?Lang=es-co&Id=56801373-f309-4c85-b175-436961af57b2)

**Where 8 mm does appear in the Mark4 family (not 10")**
- Readytosky Mark4 13" V3 Pro: "diagonal motor spacing of 570mm and arms made of 8mm thick carbon". — [Rotorama Mark4 V3 Pro 13](https://rotorama.com/product/mark4-v3-pro-13)
- Readytosky Mark4 15" V3 Pro: motor-to-motor diagonal 680 mm, "8mm thick carbon arms". — [Rotorama Mark4 V3 Pro 15](https://www.rotorama.com/product/mark4-v3-pro-15)
- An aggregator also lists a "MARK4 V3 Pro 13inch 570mm carbon fiber frame kit with 8mm arm". — [accio.ai (login-gated aggregator)](https://www.accio.ai/find-product/mark-4-frame-assembly)

### Inferences
- An "8 mm arm Mark4 10-inch" frame looks like it is not a standard catalogue item on the marketplaces I could search. The common 10" clone (427 mm, Tarot/Readytosky-pattern H-frame) is sold with 7.5 mm arms, and the GEPRC-pattern original uses 7 mm.
- If someone has seen an "8 mm" 10" Mark4, it is likely one of three things: a rounded 7.5 mm figure, a V3 Pro 13"/15" arm confused with a 10", or a small custom CNC shop job. I could not confirm any of these.

### Gaps
- I could not open any marketplace page, so I could not verify store names, prices, variant drop-downs, stock or sold-out status, or caliper photos.
- Taobao, 1688 and JD were not reachable through the search engine. These platforms need a logged-in search or a Chinese search engine, so an 8 mm 10" listing there can't be ruled out.
- Amazon regions other than .com (UK, DE, JP and others) did not come back in any search.
- I found no "Mark4 V3 10 inch" or "Mark4 V4 10 inch" listing at all. The V3 name only appeared for the 13" and 15" Pro frames.

## Which stores sell a 10" Mark4 variant, and what wheelbase and specs do they give?

### Takeaway
None of the stores I found gives 8 mm arms for a 10" Mark4. Below are the 10" Mark4 specs the stores state, so the report writer can compare thickness, wheelbase, plates and hole patterns. Wheelbase is usually 427 mm. GEPRC-pattern frames give 428 or 429 mm. Some listings give 450 mm or 473 mm, the last apparently a Readytosky text inconsistency.

### Cited Findings
| Listing / store | Arm thickness (as stated) | Wheelbase | Plates | Hole patterns | Price / status | Source |
|---|---|---|---|---|---|---|
| Readytosky Mark4 10" V2 (via Rotorama) | "Arm thickness: 7.5mm" (explicit spec) | Description says 473 mm diagonal; key features say "Motor diagonal distance: 427mm" (internal conflict) | Top 2 mm, bottom 3 mm | FC/VTX 30.5x30.5 M3 or 20x20 M2; motors 16 mm or 19 mm M3; micro 19 mm camera; weight 270 g | not seen | [Rotorama](https://www.rotorama.com/product/readytosky-mark4-10-v2) |
| FlyfishRC Mark4 10" (via Rotorama) | not given in snippet | not given | not given | weight 240 g | not seen | [Rotorama](https://www.rotorama.com/product/flyfish-mark4-10) |
| Tarot MARK4-10 TL1613 (manufacturer) | "机臂厚度：7.5mm" (explicit) | 427 mm | top and bottom 3 mm | not given | not seen | [Tarot](http://tarotrc.com/Product/Detail.aspx?Lang=zh-cn&Id=56801373-f309-4c85-b175-436961af57b2) |
| GEPRC Mark4 10" (RMRC) | "massive 7mm arm thickness" | not given in snippet | not given | payload rated to 3 kg | not seen | [RMRC](https://www.readymaderc.com/products/details/86588-geprc-mark4-10-multirotor-frame) |
| GEPRC Mark4 10" (GetFPV) | "arm plate: 7mm" | 428 mm motor-to-motor | not given | not given | not seen | [GetFPV](https://www.getfpv.com/geprc-mark4-10-frame-kit.html) |
| GEPRC GEP-Mark4-10 (rcdrone.top) | "3.7mm Thickness Arm Structure"; the Dutch page lists a 7 mm arm plate plus a 3 mm arm bar, so the arm appears to be layered | 429 mm | not given | not given | not seen | [rcdrone.top](https://rcdrone.top/ar/products/geprc-gep-mark4-10-429mm-wheelbase-10-inch-fpv-drone-frame); [NL](https://rcdrone.top/nl/products/geprc-gep-mark4-10-429mm-wheelbase-10-inch-fpv-drone-frame) |
| RJX Mark4 10" (rcdrone.top) | 7.0 mm | not given | not given | not given | $358.39, shown as **sold out** | [rcdrone.top 10 inch collection](https://rcdrone.top/collections/10-inch-fpv-frame) |
| Mark4 V2 10" (AliExpress 1005005897270664) | "10inch 427mm w/ 7.5mm Arm" (title) | 427 mm | not given | not given | not seen | [AliExpress](https://www.aliexpress.com/item/1005005897270664.html) |
| Mark4 V2 10" (fpvdroneframe.com) | "427mm Carbon Fiber (7.5mm Arms)" (title + spec) | 427 mm | not given | not given | not seen | [fpvdroneframe.com](https://fpvdroneframe.com/product/mark4-v2-10-inch-long-range-fpv-frame/) |
| Mark4 V2 10" supplier PDF (IndiaMART-hosted) | "Arm Thickness \| 7.5 mm" | not given | not given | frame weight 220–270 g | not seen | [PDF](https://5.imimg.com/data5/SELLER/Doc/2026/2/580489223/UR/CK/IE/75360989/mark4-10-inch-carbon-fiber-long-range-fpv-drone-frame.pdf) |
| Mark4 V2 10" (CaptainRC) | "Thickness of camera arm: 6mm" (wording ambiguous: may mean camera side plate, not main arm) | 427 mm | bottom plate 3.0 mm, top 2.0 mm | weight about 227 g | not seen | [CaptainRC](https://captainrc.com/products/3k-carbon-fiber-frame-mark4-v2-8inch-367mm-9inch-387mm-10inch-427mm-wheelbase-rc-fpv-freestyle-racing-drone-frame-kit) |
| Mark4 V2 10" (Jinjiuyi factory, CN) | "Camera Arm Thickness: 6mm" | 427 mm | not given | not given | not seen | [Jinjiuyi](https://www.jinjiuyi.net/fpv-drone-frame-cutting/mark4-v2-10inch-427mm-carbon-fiber-drone-frame-kit.html) |
| MARK4 V2 10" (The FPV Project) | "Arm Thickness 5mm" | 450 mm | not given | quick-swap arms | not seen | [The FPV Project](https://thefpvproject.com/product/mark10-v2-10-inch-carbon-fiber-fpv-frame/) |
| Mark4 V2 10" (drobonation odoo shop) | "5.0 mm to 7.5 mm" (range across variants) | "427 mm to 473 mm" | not given | not given | not seen | [drobonation](https://drobonation1.odoo.com/shop/mark4-v2-10-inch-frame-90) |
| Mark4 V2 10" (skelbiu.lt classified, Lithuania) | 7.5 mm | 427 mm | bottom and middle 3 mm | not given | not seen | [skelbiu.lt](https://m.skelbiu.lt/73948655.html) |
| Other 10" Mark4 V2 resellers with no thickness in the snippet: RC Shop BD, carbonfiberglobal.com, RCDrone "Mark4 V2" kit, RJXHobby Mark4 V2 10 | not given | 427 mm where given | not given | not given | not seen | [RC Shop BD](https://www.rcshopbd.com/product/mark4-v2-10-carbon-fiber-long-range-fpv-frame/); [carbonfiberglobal](https://www.carbonfiberglobal.com/FPV-Drone-Frame-Cutting/MARK4-V2-Carbon-Fiber-FPV-Drone-Frame-Kit-8-9-10-inch.html); [RCDrone](https://rcdrone.top/products/rcdrone-mark4-v2-fpv-frame-kit); [RJX JA](https://rcdrone.top/ja/products/rjxhobby-mark4-v2-10-inch-fpv-frame-kit-ja) |

- TCMMRC, FPVKing, Kingkong/LDARC, RCmall, Usmile, Feichao, HSKRC and JHEMCU did not come back in any search for a 10" Mark4 listing, with or without 8 mm. (No source; this is an absence of results across the searches above.)

### Inferences
- 427 mm is the de facto wheelbase of the 10" Mark4 V2 clone (the Tarot/Readytosky pattern), and 428–429 mm is the GEPRC original. A figure of 473 mm on Readytosky's text likely comes from transposed digits, since the same listing also says 427 mm. 435 mm did not appear anywhere.
- The "6 mm camera arm" wording on CaptainRC and Jinjiuyi probably comes from a translated spec template. It may describe a camera side plate rather than the motor arms, so do not treat it as an arm-thickness figure without checking.

### Gaps
- Standoff height did not appear in any snippet for any 10" listing.
- Plate thicknesses were given only for Readytosky (2/3 mm), Tarot (3/3 mm), CaptainRC (2/3 mm) and skelbiu.lt (3 mm).
- I could not confirm a store name or price for most AliExpress and Amazon listings.

## Do any listings offer arm-thickness options (e.g., 7 mm / 8 mm selectable)?

### Takeaway
No. None of the listings I found lets the buyer choose arm thickness for the 10" size. The variant selectors are frame size (7/8/9/10"), and the arm thickness follows from the size. The typical pairing is 6 mm arms for 8" and 9" and 7.5 mm arms for 10".

### Cited Findings
- The AliExpress multi-size listing ties thickness to size: "8inch 367mm 9inch 387mm with 6mm Arm / 10inch 427mm w/ 7.5mm Arm". — [AliExpress](https://www.aliexpress.com/item/1005005897270664.html)
- The eBay multi-size listing "MARK4 V2 7/8/9/10" ... 6mm Arm" offers one thickness across all sizes. — [eBay 395595061304](https://www.ebay.com/itm/395595061304)
- The drobonation listing shows a 5.0–7.5 mm arm range and a 427–473 mm wheelbase range across its variants. It does not offer 8 mm. — [drobonation](https://drobonation1.odoo.com/shop/mark4-v2-10-inch-frame-90)

### Inferences
- Listings sold by size can quietly change arm thickness between sizes. A multi-size listing's headline thickness (for example eBay's "6mm Arm") may not hold for the 10" option.

### Gaps
- I could not inspect the variant drop-downs on AliExpress, Amazon or eBay, because the pages were unreachable.

## Are there replacement 8 mm arms for Mark4 10" frames sold separately?

### Takeaway
I found no 8 mm replacement arm for a 10" Mark4. Separate 10" Mark4 arms do exist, at 7 mm (AOCODA) and as GEPRC Mark4 10" spares (Rotorama). The 8 mm arms I found belong to the 13"/15" V3 Pro frames, which are larger.

### Cited Findings
- AOCODA-RC: "Mark 4 10inch 420mm Arm Thickness 7mm for Mark4 FPV Racing Drone Quadcopter Freestyle Frame Kit", listed in stock. Hole pattern not given in the snippet. — [AOCODA-RC](https://www.aocoda-rc.com/products/72)
- Rotorama: "GEPRC Mark4 - replacement arms" in 7", 8" and 10" sizes, €7.79 per piece, listed in stock. These fit the GEPRC original, which has 7 mm arms. — [Rotorama](https://www.rotorama.com/product/geprc-mark4-dily)
- Pyrodrone: GEP-RC Mark4 replacement 7" arm (1 pc). This is the wrong size for a 10". — [Pyrodrone](https://pyrodrone.com/products/gep-rc-mark4-replacement-7-arm-1-pc)
- A Mark4 7" 295 mm arm, 5 mm thick, is listed as a replaceable accessory (wrong size, and the site is of doubtful standing). — [brookealvinston.com](https://brookealvinston.com/products/mark4-7inch-arm-thickness-295mm-5mm-replaceable-accessories/216412196/)
- The Amazon "Replacement for MARK4 V2 10inch Frame 425mm 1PC" is a complete frame, not separate arms. The search summary gives 7.0 mm arms. — [Amazon B0GGMDRL9F](https://www.amazon.com/Replacement-10inch-Freestyle-Compatible-Propeller/dp/B0GGMDRL9F)

### Inferences
- A builder who wants 8 mm arms on a 10" Mark4 would probably have to get them custom cut from the open Mark4 10" CAD/STEP files, or adapt V3 Pro arms. I found no evidence that either is sold. — CAD reference: [Cults3D Mark 4 10 inch STEP files](https://cults3d.com/en/3d-model/gadget/frame-mark-4-10-inch-step-cad-files)

### Gaps
- No arm-mounting hole pattern was given in any snippet for the 10" replacement arms (AOCODA, Rotorama).
- None of the arm listings' stock status or prices could be checked live.
