henriharmaala1-source/Assembly-grapher/aero/study/EXTREME.md

# Kipinä, extreme aero: the design study

Generated by `aero/extreme.py`. Do not edit by hand. Same electronics, motor, prop and battery as the single boom, the same optimized section (kipina-opt), every part on a 180 mm bed.

## The planform it picks

| | Single boom | Extreme aero |
|---|---|---|
| Span | 485 mm | 700 mm |
| Chord | 97 mm, straight | 86 mm root, 69 mm tip (taper 0.80 on the outer panels) |
| Wing area | 4.71 dm² | 5.74 dm² |
| Aspect ratio | 5.0 | 8.5 |
| Panels | centre 135 mm, one 175 mm panel a side | centre 56 mm, two 161 mm panels a side, the taper from 189 mm out |
| Washout | none | 3° on the outer panels |
| Span efficiency (lifting line) | 0.963 | 0.955 |
| Main spar | 3 mm carbon rod | 5x4 mm carbon tube |
| Tail arm | 272 mm | 260 mm |
| Stabiliser | 175 x 48 mm | 175 x 52 mm |
| Fin | 79 x 48 mm | 134 x 52 mm |
| Boom | 10x9 mm, 323 mm, 46 Hz | 10x9 mm, 317 mm, 46 Hz |

## How it flies (study model)

| | Single boom | Extreme aero | change |
|---|---|---|---|
| Weight, g | 227.4 | 242.7 | +15.3 |
| Maximum lift (3D) | 0.967 | 0.957 | -0.0094 |
| Stall, m/s | 8.95 | 8.41 | -0.541 |
| Drag at 13 m/s, N | 0.234 | 0.230 | -0.0034 |
| Power at 13 m/s, W | 9.09 | 8.98 | -0.112 |
| Flight time at 13 m/s, min | 17.6 | 17.8 | +0.22 |
| Best glide ratio | 9.64 | 11.63 | +2 |
| ... at, m/s | 12.25 | 10.25 | -2 |
| Least power, W | 7.67 | 6.27 | -1.4 |
| ... at, m/s | 9.50 | 9.00 | -0.5 |
| Longest flight, min | 20.8 | 25.5 | +4.67 |
| Least sink, motor off, m/s | 1.107 | 0.801 | -0.306 |
| Top speed, m/s | 19.9 | 19.5 | -0.492 |

Where the weight goes, grams against the single boom:

| | g |
|---|---|
| wing panels | +18.8 |
| wing centre | -10.7 |
| ailerons | -1.5 |
| main spar | +2.4 |
| rear spar | +1.1 |
| tail plates | +3.5 |
| boom | -0.2 |
| pushrods, motor wires | -0.1 |
| fuselage | +0.9 |
| aileron lead extensions | +1.2 |

## Drag, item by item

At 13 m/s and at the extreme plane's best glide (10.25 m/s), newtons.

| | single, 13 m/s | extreme, 13 m/s | single, best glide speed | extreme, best glide speed |
|---|---|---|---|---|
| wing profile | 0.0682 | 0.0937 | 0.0578 | 0.0730 |
| tail plates, skin friction | 0.0221 | 0.0281 | 0.0150 | 0.0191 |
| fuselage front (pressure) | 0.0029 | 0.0029 | 0.0018 | 0.0018 |
| fuselage, skin friction | 0.0187 | 0.0190 | 0.0123 | 0.0125 |
| motor on the boom's end (base) | 0.0037 | 0.0037 | 0.0023 | 0.0023 |
| boom, skin friction | 0.0043 | 0.0040 | 0.0028 | 0.0027 |
| tail mount: collar, stabiliser pylons, fin socket | 0.0075 | 0.0076 | 0.0047 | 0.0047 |
| aileron servo horns and bumps | 0.0034 | 0.0034 | 0.0021 | 0.0021 |
| aileron horns and links | 0.0037 | 0.0037 | 0.0023 | 0.0023 |
| elevator and rudder horns, pushrod ends | 0.0042 | 0.0042 | 0.0026 | 0.0026 |
| VTX antenna | 0.0010 | 0.0010 | 0.0006 | 0.0006 |
| junctions | 0.0127 | 0.0159 | 0.0097 | 0.0116 |
| induced | 0.0813 | 0.0430 | 0.1308 | 0.0693 |
| **total** | **0.2336** | **0.2302** | **0.2448** | **0.2046** |

## The search

2700 designs on a coarse grid (span 560-840 mm, root chord 82-104 mm, taper 0.5-1.0, tail arm 240-420 mm) and 1125 on a fine one round the best. 1627 could be built and were flown; 208 passed. Dropped:

- no spar fits the tip: 1732
- more power at 13 m/s than the single boom: 1419
- the SG90's tabs do not fit between the spars: 406
- no boom keeps the tail as stiff as the single boom's: 37
- fin taller than the bed: 20
- the wing does not balance over the fuselage: 3

The best design at each span:

| span | root chord | taper | tail arm | weight g | stall | power at 13 m/s | best glide | least power W | least sink |
|---|---|---|---|---|---|---|---|---|---|
| 560 | 94 | 0.70 | 300 | 240.5 | 8.88 | 8.90 | 10.65 | 7.18 | 0.963 |
| 580 | 90 | 0.70 | 300 | 240.0 | 8.95 | 8.80 | 10.85 | 7.01 | 0.936 |
| 600 | 90 | 0.70 | 300 | 242.5 | 8.85 | 8.83 | 11.02 | 6.93 | 0.912 |
| 620 | 90 | 0.70 | 300 | 245.2 | 8.75 | 8.88 | 11.18 | 6.81 | 0.883 |
| 640 | 90 | 0.70 | 300 | 247.8 | 8.65 | 8.93 | 11.33 | 6.74 | 0.863 |
| 660 | 90 | 0.70 | 300 | 250.6 | 8.56 | 8.99 | 11.48 | 6.65 | 0.838 |
| 680 | 88 | 0.70 | 300 | 251.3 | 8.56 | 8.98 | 11.63 | 6.56 | 0.820 |
| 690 | 88 | 0.70 | 300 | 252.6 | 8.52 | 9.02 | 11.70 | 6.53 | 0.812 |
| 700 | 88 | 0.70 | 280 | 252.5 | 8.46 | 9.05 | 11.74 | 6.48 | 0.804 |
| 710 | 88 | 0.70 | 260 | 244.1 | 8.25 | 9.00 | 11.72 | 6.19 | 0.784 |

Nothing wider than 710 mm passed. A wider wing needs a stiffer spar, and the stiffer tube no longer fits the depth of a tip that is narrow enough to keep the area down; with a broader tip the area, the weight and the tail grow, and the plane needs more power at 13 m/s than the single boom.

## Washout

The search flies every planform with 2° of twist on the outer panels. The chosen one, at its weight, with the twist from 0 to 4° (tip nose-down), and where along the half span the first section reaches its maximum lift (the outer panels start at 189 mm):

| washout | maximum lift | stall | stall starts at | best glide | power at 13 m/s |
|---|---|---|---|---|---|
| 0° | 0.987 | 8.28 | 0 mm (inboard) | 11.54 | 9.00 |
| 0.5° | 0.982 | 8.30 | 0 mm (inboard) | 11.57 | 8.99 |
| 1° | 0.977 | 8.32 | 0 mm (inboard) | 11.59 | 8.97 |
| 1.5° | 0.972 | 8.34 | 0 mm (inboard) | 11.61 | 8.97 |
| 2° | 0.967 | 8.36 | 0 mm (inboard) | 11.62 | 8.97 |
| 2.5° | 0.962 | 8.39 | 0 mm (inboard) | 11.63 | 8.97 |
| **3°** | 0.957 | 8.41 | 0 mm (inboard) | 11.63 | 8.98 |
| 4° | 0.948 | 8.45 | 0 mm (inboard) | 11.62 | 9.02 |

Even untwisted, this planform reaches its maximum lift first at the root (the inner panels keep the full chord, and the tips fly at a lower Reynolds number, where the section's maximum lift is lower), as the single boom's straight wing does. So the twist is not needed for a root-first stall here; it unloads the tips, which costs a little maximum lift and gains a little glide. The design keeps the twist that glides best while the stall still starts inboard of the ailerons, so they keep working: 3°.

## The lifting line against a vortex lattice

Both wings alone in AeroSandbox's vortex lattice (24 panels across each half, 8 along the chord, the twist included), at each plane's lift coefficient at 13 m/s and at its best glide. Both methods are inviscid, so the induced drag compares like for like:

| | lift coefficient | induced drag, lifting line | vortex lattice | span efficiency, lifting line | vortex lattice |
|---|---|---|---|---|---|
| Single boom, 13 m/s | 0.458 | 0.01387 | 0.01368 | 0.963 | 0.976 |
| Single boom, best glide | 0.516 | 0.01759 | 0.01735 | 0.963 | 0.976 |
| Extreme aero, 13 m/s | 0.400 | 0.00601 | 0.00606 | 0.995 | 0.986 |
| Extreme aero, best glide | 0.644 | 0.01558 | 0.01579 | 0.994 | 0.980 |

The design's induced drag scales these by the same factor for both planes (the 0.8 span efficiency it takes for the straight wing with the fuselage), so what matters is the ratio between them. At 13 m/s the extreme wing has 0.434 of the single boom's induced drag on the lifting line and 0.443 on the vortex lattice: the lifting line is 2 % kinder on the extreme wing, which is 0.0010 N, 0.4 % of its drag.

## Method and limits

- Span loading: Glauert's lifting line, 40 terms, the section's own lift slope (capped at 2π), with the twist. Its span efficiency scales the design's 0.8 at the rectangular AR 5 wing (factor 0.831), so the fuselage's and the viscous share stay as before.
- Profile drag: NeuralFoil on kipina-opt at each of 40 stations' own lift coefficient and Reynolds number (n_crit 7.0).
- Maximum lift: the single boom's 0.967, scaled by the lift the planform carries when its first section reaches its maximum, against the rectangular wing's.
- Everything else: the single boom's drag build-up (aero/models/airframe.py), tail plates and boom re-sized.
- Spar: the lightest carbon tube that keeps the 1 g bending under 1.5 % of the half span (E 70 GPa, even load) and fits the tip's depth with both skins.
- Boom: the lightest roll-wrapped tube whose first bending mode, with the tail, motor and prop on its end, is no lower than the single boom's 46 Hz.
- Weight: the single boom's CAD weight, with each re-sized part at the CAD's own grams per mm² or per mm. `build.py --variant extreme` then builds it and weighs the real parts.
- Handbook uncertainty is the same as the drag optimizer's (perhaps ±30 % on absolute drag); the differences between the two planes are more trustworthy than either number.
