henriharmaala1-source/Assembly-grapher/airframe/variants/COMPARE.md

# Kipinä: four CAD builds compared

Generated by `aero/variants.py` from the four CAD builds (`airframe/viewer/spec.json` and `airframe/variants/{optimized,single-boom,extreme}/viewer/spec.json`). Do not edit by hand.

## The designs

| | As built | Optimized | Single boom | Extreme aero |
|---|---|---|---|---|
| Layout | twin booms, motor behind the pod | twin booms, motor behind the pod | one carbon boom, motor behind the tail | one carbon boom, motor behind the tail |
| Airfoil | NACA 4412 | kipina-opt | kipina-opt | kipina-opt |
| Wing | 485 mm span, 97 mm chord | 485 mm span, 97 mm chord | 485 mm span, 97 mm chord | 700 mm span, 86 mm root to 69 mm tip, 3° washout |
| Wing area, aspect ratio | 4.70 dm², 5.0 | 4.70 dm², 5.0 | 4.70 dm², 5.0 | 5.74 dm², 8.5 |
| Details | none | nose_top_r 8, boattail 30, antenna_lean 60, fairings, joiner_sleeves | nose_top_r 8, antenna_lean 60, fairings | nose_top_r 8, antenna_lean 60, fairings |
| Weight (CAD) | 223.2 g | 225.8 g | 227.4 g | 242.8 g |
| Printed parts | 98 g | 101 g | 100 g | 112 g |
| Wing leading edge from the nose (balanced) | 172.4 mm | 175.4 mm | 188.8 mm | 198.4 mm |
| CG | 199.6 mm | 202.6 mm | 216.0 mm | 222.4 mm |

## Where the weight changed

Parts that differ between the builds, grams.

| part | As built | Optimized | Single boom | Extreme aero |
|---|---|---|---|---|
| wing_centre | 21.9 | 21.4 | 15.9 | 6.1 |
| fuselage_rear | – | – | 20.2 | 12.5 |
| fuselage_front | – | – | 9.8 | 18.3 |
| pod_rear | 14.3 | 13.2 | – | – |
| pod_front | 12.6 | 12.4 | – | – |
| wing_L | 10.8 | 10.6 | 11.2 | 11.9 |
| wing_R | 10.8 | 10.6 | 11.2 | 11.9 |
| wing_outer_L | – | – | – | 8.8 |
| wing_outer_R | – | – | – | 8.8 |
| lid | 6.8 | 6.7 | 8.0 | 8.0 |
| spar_main | 5.2 | 5.2 | 5.2 | 7.6 |
| boom | – | – | 7.5 | 7.4 |
| tail_mount | 4.9 | 4.9 | 3.9 | 4.3 |
| stab | 4.1 | 4.1 | 4.1 | 4.4 |
| tube_R | 4.0 | 4.0 | – | – |
| tube_L | 4.0 | 4.0 | – | – |
| fin | – | – | 1.9 | 3.4 |
| rudder | – | – | 1.7 | 3.1 |
| aileron_R | 2.8 | 2.7 | 2.9 | 2.1 |
| aileron_L | 2.8 | 2.7 | 2.9 | 2.1 |
| motor_mount | – | – | 2.5 | 2.5 |
| spar_rear | 2.3 | 2.3 | 2.3 | 1.8 |
| elevator | 2.0 | 2.0 | 2.1 | 2.3 |
| motor_wires | – | – | 1.5 | 1.5 |
| pushrod_elev | 0.3 | 0.3 | 1.3 | 1.3 |
| fin_R | 1.2 | 1.2 | – | – |
| fin_L | 1.2 | 1.2 | – | – |
| pushrod_rud | 0.3 | 0.3 | 1.2 | 1.2 |
| fairing_ail_L | – | 1.0 | 1.0 | 1.0 |
| fairing_ail_R | – | 1.0 | 1.0 | 1.0 |
| sleeve_R | – | 1.0 | – | – |
| fairing_rud | – | 0.9 | – | – |
| rudder_L | 0.9 | 0.9 | – | – |
| rudder_R | 0.9 | 0.9 | – | – |
| fairing_elev | – | 0.9 | – | – |
| spar_rear_L | – | – | – | 0.8 |
| spar_rear_R | – | – | – | 0.8 |
| joiner_L | 0.3 | 0.3 | – | – |
| joiner_R | 0.3 | 0.3 | – | – |
| sleeve_L | – | 0.2 | – | – |
| bellcrank | 0.2 | 0.2 | – | – |

## How they fly

Thrust: the same motor and prop, 2.19 N static (1:1 for the as-built plane), falling to zero at the 23.9 m/s pitch speed.

| | As built | Optimized | Single boom | Extreme aero |
|---|---|---|---|---|
| Weight, g | 223.2 | 225.8 | 227.4 | 242.8 |
| Wing loading, g/dm² | 47.4 | 48.0 | 48.3 | 42.3 |
| Maximum lift (3D) | 0.950 | 0.967 | 0.967 | 0.957 |
| Stall, m/s | 8.94 | 8.92 | 8.95 | 8.41 |
| Drag at 13 m/s, N | 0.324 | 0.247 | 0.232 | 0.230 |
| Power at 13 m/s, W | 12.03 | 9.53 | 9.02 | 8.98 |
| Current at 13 m/s, A | 1.63 | 1.29 | 1.22 | 1.21 |
| Flight time at 13 m/s, min | 13.3 | 16.8 | 17.7 | 17.8 |
| Distance at 13 m/s, km | 10.4 | 13.1 | 13.8 | 13.9 |
| Longest flight, min | 18.7 | 20.6 | 21.0 | 25.7 |
| ... at, m/s | 9.2 | 9.2 | 9.2 | 8.8 |
| Furthest flight, km | 10.8 | 13.2 | 13.8 | 14.7 |
| ... at, m/s | 11.0 | 12.2 | 12.8 | 11.0 |
| Best glide ratio | 7.36 | 9.16 | 9.74 | 11.63 |
| ... at, m/s | 10.5 | 11.8 | 12.2 | 10.2 |
| Least sink, motor off, m/s | 1.288 | 1.130 | 1.097 | 0.793 |
| Best climb, m/s | 4.47 | 4.66 | 4.68 | 4.51 |
| Top speed, m/s | 18.4 | 19.7 | 20.0 | 19.5 |
| Tightest level turn at 13 m/s, bank ° | 61.8 | 61.9 | 61.7 | 65.3 |
| ... radius, m | 9.30 | 9.20 | 9.30 | 7.90 |

### Optimized against as built: aerodynamics and weight

The middle column is the optimized plane's aerodynamics at the as built weight (223.2 g against 225.8 g).

| | As built | Optimized: its aerodynamics, as built weight | Optimized | change | of which aerodynamics | of which weight |
|---|---|---|---|---|---|---|
| Weight, g | 223.2 | 223.2 | 225.8 | +2.6 | +0 | +2.6 |
| Wing loading, g/dm² | 47.4 | 47.4 | 48.0 | +0.6 | +0 | +0.6 |
| Maximum lift (3D) | 0.950 | 0.967 | 0.967 | +0.017 | +0.017 | +0 |
| Stall, m/s | 8.94 | 8.87 | 8.92 | -0.02 | -0.07 | +0.05 |
| Drag at 13 m/s, N | 0.324 | 0.245 | 0.247 | -0.0769 | -0.0788 | +0.0019 |
| Power at 13 m/s, W | 12.03 | 9.47 | 9.53 | -2.5 | -2.56 | +0.06 |
| Current at 13 m/s, A | 1.63 | 1.28 | 1.29 | -0.34 | -0.35 | +0.01 |
| Flight time at 13 m/s, min | 13.3 | 16.9 | 16.8 | +3.5 | +3.6 | -0.1 |
| Distance at 13 m/s, km | 10.4 | 13.2 | 13.1 | +2.72 | +2.8 | -0.08 |
| Longest flight, min | 18.7 | 20.9 | 20.6 | +1.9 | +2.2 | -0.3 |
| ... at, m/s | 9.2 | 9.2 | 9.2 | +0 | +0 | +0 |
| Furthest flight, km | 10.8 | 13.3 | 13.2 | +2.31 | +2.41 | -0.1 |
| ... at, m/s | 11.0 | 12.2 | 12.2 | +1.25 | +1.25 | +0 |
| Best glide ratio | 7.36 | 9.15 | 9.16 | +1.8 | +1.79 | +0.01 |
| ... at, m/s | 10.5 | 11.8 | 11.8 | +1.25 | +1.25 | +0 |
| Least sink, motor off, m/s | 1.288 | 1.125 | 1.130 | -0.158 | -0.163 | +0.005 |
| Best climb, m/s | 4.47 | 4.73 | 4.66 | +0.19 | +0.26 | -0.07 |
| Top speed, m/s | 18.4 | 19.7 | 19.7 | +1.32 | +1.32 | +0 |
| Tightest level turn at 13 m/s, bank ° | 61.8 | 62.3 | 61.9 | +0.1 | +0.5 | -0.4 |
| ... radius, m | 9.30 | 9.10 | 9.20 | -0.1 | -0.2 | +0.1 |

### Single boom against optimized: aerodynamics and weight

The middle column is the single boom plane's aerodynamics at the optimized weight (225.8 g against 227.4 g).

| | Optimized | Single boom: its aerodynamics, optimized weight | Single boom | change | of which aerodynamics | of which weight |
|---|---|---|---|---|---|---|
| Weight, g | 225.8 | 225.8 | 227.4 | +1.6 | +0 | +1.6 |
| Wing loading, g/dm² | 48.0 | 48.0 | 48.3 | +0.3 | +0 | +0.3 |
| Maximum lift (3D) | 0.967 | 0.967 | 0.967 | +0 | +0 | +0 |
| Stall, m/s | 8.92 | 8.92 | 8.95 | +0.03 | +0 | +0.03 |
| Drag at 13 m/s, N | 0.247 | 0.230 | 0.232 | -0.0157 | -0.0168 | +0.0011 |
| Power at 13 m/s, W | 9.53 | 8.99 | 9.02 | -0.51 | -0.54 | +0.03 |
| Current at 13 m/s, A | 1.29 | 1.21 | 1.22 | -0.07 | -0.08 | +0.01 |
| Flight time at 13 m/s, min | 16.8 | 17.8 | 17.7 | +0.9 | +1 | -0.1 |
| Distance at 13 m/s, km | 13.1 | 13.9 | 13.8 | +0.74 | +0.79 | -0.05 |
| Longest flight, min | 20.6 | 21.1 | 21.0 | +0.4 | +0.5 | -0.1 |
| ... at, m/s | 9.2 | 9.2 | 9.2 | +0 | +0 | +0 |
| Furthest flight, km | 13.2 | 13.9 | 13.8 | +0.67 | +0.73 | -0.06 |
| ... at, m/s | 12.2 | 12.8 | 12.8 | +0.5 | +0.5 | +0 |
| Best glide ratio | 9.16 | 9.73 | 9.74 | +0.58 | +0.57 | +0.01 |
| ... at, m/s | 11.8 | 12.0 | 12.2 | +0.5 | +0.25 | +0.25 |
| Least sink, motor off, m/s | 1.130 | 1.094 | 1.097 | -0.033 | -0.036 | +0.003 |
| Best climb, m/s | 4.66 | 4.72 | 4.68 | +0.02 | +0.06 | -0.04 |
| Top speed, m/s | 19.7 | 20.0 | 20.0 | +0.3 | +0.3 | +0 |
| Tightest level turn at 13 m/s, bank ° | 61.9 | 61.9 | 61.7 | -0.2 | +0 | -0.2 |
| ... radius, m | 9.20 | 9.20 | 9.30 | +0.1 | +0 | +0.1 |

### Single boom against as built: aerodynamics and weight

The middle column is the single boom plane's aerodynamics at the as built weight (223.2 g against 227.4 g).

| | As built | Single boom: its aerodynamics, as built weight | Single boom | change | of which aerodynamics | of which weight |
|---|---|---|---|---|---|---|
| Weight, g | 223.2 | 223.2 | 227.4 | +4.2 | +0 | +4.2 |
| Wing loading, g/dm² | 47.4 | 47.4 | 48.3 | +0.9 | +0 | +0.9 |
| Maximum lift (3D) | 0.950 | 0.967 | 0.967 | +0.017 | +0.017 | +0 |
| Stall, m/s | 8.94 | 8.87 | 8.95 | +0.01 | -0.07 | +0.08 |
| Drag at 13 m/s, N | 0.324 | 0.229 | 0.232 | -0.0926 | -0.0956 | +0.003 |
| Power at 13 m/s, W | 12.03 | 8.93 | 9.02 | -3.01 | -3.1 | +0.09 |
| Current at 13 m/s, A | 1.63 | 1.21 | 1.22 | -0.41 | -0.42 | +0.01 |
| Flight time at 13 m/s, min | 13.3 | 17.9 | 17.7 | +4.4 | +4.6 | -0.2 |
| Distance at 13 m/s, km | 10.4 | 14.0 | 13.8 | +3.46 | +3.61 | -0.15 |
| Longest flight, min | 18.7 | 21.4 | 21.0 | +2.3 | +2.7 | -0.4 |
| ... at, m/s | 9.2 | 9.2 | 9.2 | +0 | +0 | +0 |
| Furthest flight, km | 10.8 | 14.0 | 13.8 | +2.98 | +3.15 | -0.17 |
| ... at, m/s | 11.0 | 12.5 | 12.8 | +1.75 | +1.5 | +0.25 |
| Best glide ratio | 7.36 | 9.72 | 9.74 | +2.38 | +2.36 | +0.02 |
| ... at, m/s | 10.5 | 12.0 | 12.2 | +1.75 | +1.5 | +0.25 |
| Least sink, motor off, m/s | 1.288 | 1.089 | 1.097 | -0.191 | -0.199 | +0.008 |
| Best climb, m/s | 4.47 | 4.79 | 4.68 | +0.21 | +0.32 | -0.11 |
| Top speed, m/s | 18.4 | 20.0 | 20.0 | +1.62 | +1.61 | +0.01 |
| Tightest level turn at 13 m/s, bank ° | 61.8 | 62.3 | 61.7 | -0.1 | +0.5 | -0.6 |
| ... radius, m | 9.30 | 9.10 | 9.30 | +0 | -0.2 | +0.2 |

### Extreme aero against single boom: aerodynamics and weight

The middle column is the extreme aero plane's aerodynamics at the single boom weight (227.4 g against 242.8 g).

| | Single boom | Extreme aero: its aerodynamics, single boom weight | Extreme aero | change | of which aerodynamics | of which weight |
|---|---|---|---|---|---|---|
| Weight, g | 227.4 | 227.4 | 242.8 | +15.4 | +0 | +15.4 |
| Wing loading, g/dm² | 48.3 | 39.6 | 42.3 | -6 | -8.7 | +2.7 |
| Maximum lift (3D) | 0.967 | 0.957 | 0.957 | -0.01 | -0.01 | +0 |
| Stall, m/s | 8.95 | 8.14 | 8.41 | -0.54 | -0.81 | +0.27 |
| Drag at 13 m/s, N | 0.232 | 0.226 | 0.230 | -0.0013 | -0.006 | +0.0047 |
| Power at 13 m/s, W | 9.02 | 8.83 | 8.98 | -0.04 | -0.19 | +0.15 |
| Current at 13 m/s, A | 1.22 | 1.19 | 1.21 | -0.01 | -0.03 | +0.02 |
| Flight time at 13 m/s, min | 17.7 | 18.1 | 17.8 | +0.1 | +0.4 | -0.3 |
| Distance at 13 m/s, km | 13.8 | 14.1 | 13.9 | +0.06 | +0.3 | -0.24 |
| Longest flight, min | 21.0 | 27.4 | 25.7 | +4.7 | +6.4 | -1.7 |
| ... at, m/s | 9.2 | 8.5 | 8.8 | -0.5 | -0.75 | +0.25 |
| Furthest flight, km | 13.8 | 15.2 | 14.7 | +0.83 | +1.37 | -0.54 |
| ... at, m/s | 12.8 | 10.5 | 11.0 | -1.75 | -2.25 | +0.5 |
| Best glide ratio | 9.74 | 11.52 | 11.63 | +1.89 | +1.78 | +0.11 |
| ... at, m/s | 12.2 | 9.8 | 10.2 | -2 | -2.5 | +0.5 |
| Least sink, motor off, m/s | 1.097 | 0.775 | 0.793 | -0.304 | -0.322 | +0.018 |
| Best climb, m/s | 4.68 | 4.87 | 4.51 | -0.17 | +0.19 | -0.36 |
| Top speed, m/s | 20.0 | 19.4 | 19.5 | -0.53 | -0.55 | +0.02 |
| Tightest level turn at 13 m/s, bank ° | 61.7 | 66.9 | 65.3 | +3.6 | +5.2 | -1.6 |
| ... radius, m | 9.30 | 7.30 | 7.90 | -1.4 | -2 | +0.6 |

## Every 10 g

| per +10 g | As built | Optimized | Single boom | Extreme aero |
|---|---|---|---|---|
| stall, m/s | +0.198 | +0.196 | +0.196 | +0.178 |
| power at 13 m/s, W | +0.228 | +0.240 | +0.241 | +0.096 |
| flight time at 13 m/s, min | -0.242 | -0.413 | -0.461 | -0.199 |
| longest flight, min | -0.891 | -1.021 | -1.046 | -1.194 |
| best climb, m/s | -0.245 | -0.258 | -0.259 | -0.241 |
| best glide ratio | +0.047 | +0.042 | +0.048 | +0.076 |
| least sink, m/s | +0.020 | +0.021 | +0.020 | +0.012 |

- The optimized plane could weigh 309 g (+83 g on its CAD weight) before it needs as much power at 13 m/s as the as built one.
- The single boom plane could weigh 324 g (+96 g on its CAD weight) before it needs as much power at 13 m/s as the as built one.
- The single boom plane could weigh 247 g (+20 g on its CAD weight) before it needs as much power at 13 m/s as the optimized one.
- The extreme aero plane could weigh 411 g (+168 g on its CAD weight) before it needs as much power at 13 m/s as the as built one.
- The extreme aero plane could weigh 286 g (+43 g on its CAD weight) before it needs as much power at 13 m/s as the optimized one.
- The extreme aero plane could weigh 246 g (+3 g on its CAD weight) before it needs as much power at 13 m/s as the single boom one.

The 9.0 m/s stall limit allows 226 g as built, 230 g optimized, 230 g single boom, 278 g extreme aero.

The tightest level turn at 13 m/s is set by the stall (the maximum lift), not by the motor, which has thrust to spare at that bank.
