henriharmaala1-source/Assembly-grapher/frames/mark4-v2-10/CHECK.md

# Standoff alignment check

Generated by `build.py` from `source/mark4_v2_10in.step`. Coordinates in mm, x to the right,
y forward, from the model's origin.

Each standoff's axis and the hole on that axis in every horizontal part it
passes through or bolts to. *Off* is how far the hole's centre sits from the
standoff's axis.

| Standoff | Axis x | Axis y | Part | Hole x | Hole y | Hole Ø | Off |
|---|---:|---:|---|---:|---:|---:|---:|
| **S1** | 15.70 | 66.40 | Top plate | 15.70 | 66.40 | 3.00 | 0.00 |
| | | | Lower plate | 15.70 | 66.40 | 3.00 | 0.00 |
| | | | Chin plate | 15.70 | 66.40 | 2.80 | 0.00 |
| **S2** | -15.70 | 66.40 | Top plate | -15.70 | 66.40 | 3.00 | 0.00 |
| | | | Lower plate | -15.70 | 66.40 | 3.00 | 0.00 |
| | | | Chin plate | -15.70 | 66.40 | 2.80 | 0.00 |
| **S3** | 12.00 | 16.97 | Top plate | 12.00 | 16.97 | 3.00 | 0.00 |
| | | | Lower plate | 12.00 | 16.94 | 3.00 | 0.03 |
| | | | Belly plate | 12.00 | 16.90 | 3.00 | 0.07 |
| | | | Arm | 12.01 | 16.92 | 3.20 | 0.05 |
| **S4** | -12.00 | 16.97 | Top plate | -12.00 | 16.97 | 3.00 | 0.00 |
| | | | Lower plate | -12.00 | 16.94 | 3.00 | 0.03 |
| | | | Belly plate | -12.00 | 16.90 | 3.00 | 0.07 |
| | | | Arm | -12.04 | 16.92 | 3.20 | 0.07 |
| **S5** | 12.00 | -55.03 | Top plate | 12.00 | -55.06 | 3.00 | 0.03 |
| | | | Lower plate | 12.00 | -55.06 | 3.00 | 0.03 |
| | | | Belly plate | 12.00 | -55.10 | 3.00 | 0.07 |
| | | | Arm | 12.01 | -55.08 | 3.20 | 0.05 |
| **S6** | -12.00 | -55.03 | Top plate | -12.00 | -55.06 | 3.00 | 0.03 |
| | | | Lower plate | -12.00 | -55.06 | 3.00 | 0.03 |
| | | | Belly plate | -12.00 | -55.10 | 3.00 | 0.07 |
| | | | Arm | -12.04 | -55.08 | 3.20 | 0.07 |
| **S7** | 9.50 | -117.05 | Top plate | 9.50 | -117.04 | 3.00 | 0.01 |
| | | | Lower plate | 9.50 | -117.04 | 3.00 | 0.01 |
| | | | Tail plate | 9.50 | -117.01 | 2.80 | 0.04 |
| **S8** | -9.50 | -117.05 | Top plate | -9.50 | -117.04 | 3.00 | 0.01 |
| | | | Lower plate | -9.50 | -117.04 | 3.00 | 0.01 |
| | | | Tail plate | -9.50 | -117.01 | 2.80 | 0.04 |

Largest offset of any hole from its standoff's axis: **0.07 mm**. Between the
top plate and the lower plate, the two plates the standoffs join, it is **0.03 mm**.
That is far inside what a CNC cutter (about ±0.1 mm) or a printer (about ±0.2 mm)
holds, so the plates line up as modelled. The offsets come from how the parts were
placed in the model's assembly, a few hundredths of a millimetre apart.

## Model quirks worth knowing

- **Lower plate, rear 30.5 mm pattern is not square or centred.** These holes have no mirror partner across the centreline: H14 (15.50, -69.50), H20 (15.50, -99.50). The other side's holes are at (-15.00, -69.00), (-15.00, -99.50). A true 30.5 × 30.5 pattern on the centreline would put them at x ±15.25. They are drawn as modelled; check them against your VTX or plate before you rely on them.
- **Wheelbase.** The motor centres are at x ±173.36, y 119.42 (front) and y -157.59 (rear): 346.7 mm apart side to side, 277.0 mm front to back, **443.8 mm** diagonally. RJX lists its Mark4 V2 10" at 427 mm and GEPRC its Mark4 10" at 428-429 mm, so the arms in this model are longer than either. The centre plates and standoffs don't depend on it.
- **Thicknesses.** The model has arms 7 mm, lower and belly plates 3 mm, top plate 2 mm, braces 2 mm, camera plates 2.5 mm. RJX lists 7.5 mm arms; measure yours.

## Print bed fit

The smallest square bed each part fits, turned to the best angle (outline only, no brim).

| Part | Longest | Smallest square bed | Turned | Fits 180 x 180 |
|---|---:|---:|---:|---|
| Top plate | 201.3 | 158.1 | 45° | yes |
| Lower plate | 205.3 | 161.4 | 45° | yes |
| Belly plate | 89.7 | 83.2 | 0° | yes |
| Chin plate | 40.8 | 35.5 | 45° | yes |
| Tail plate | 29.2 | 24.4 | 45° | yes |
| Arm | 229.3 | 166.7 | 12° | yes |
| Arm brace | 213.2 | 154.5 | 44° | yes |
| Camera plate | 50.6 | 40.8 | 92° | yes |
