henriharmaala1-source/Assembly-grapher/airframe/variants/single-boom/DFMA.md

# Kipinä, single boom: DFMA analysis

Generated by `process.py`. Do not edit by hand.

## Design for assembly (Boothroyd-Dewhurst, manual)

| | |
|---|---|
| Parts and fasteners assembled | 50 |
| Theoretical minimum part count | 23 |
| Handling + insertion time | 396 s |
| Plus separate processes (glue, solder, tape, bend) | 2505 s |
| Total manual assembly time | 2901 s (48 min) |
| Design efficiency, handling + insertion only | 17% |
| Design efficiency, including processes | **2%** |
| After the suggestions below | 42 parts, 2367 s, efficiency 3% |

Design efficiency = 3 s x theoretical minimum parts / actual assembly time. Handling and inserting parts is only a fifth of the assembly time; gluing, soldering, taping and bending take the rest, so the biggest wins remove joints, not just parts.

A part counts toward the theoretical minimum when it moves relative to the parts already assembled, must be a different material, or must be separate for assembly or service.

### Redesign suggestions

| suggestion | parts removed | time saved | trade-off |
|---|---|---|---|
| Print the aileron control horns into the ailerons | 2 | 48 s | PETG ailerons, or a thicker LW-PLA horn; +0.3 g |
| Use an FC with a built-in ELRS receiver | 1 | 147 s | few wing FCs have one (the Matek F405-WTE does, but it is 44 mm long and end-of-life) |
| Use a nano camera with an integrated VTX | 1 | 107 s | fixed VTX power, harder to replace |
| Print the tail mount, fin and motor cap as one PETG part | 2 | 47 s | the tail and the motor then go on together; about +1 g (PETG fin instead of LW-PLA) |
| Print the aileron servo fairings into the wing panels | 2 | 45 s | the servo goes in from the root rib side; the panel needs a support-free blister |
| Replace tape hinges with printed pin hinges | 0 | 80 s | stiffer surfaces, 0.8 mm pins; slightly more drag at the gap |
| Key the boom (a flat at its front end) so the tail squares itself | 0 | 60 s | a file stroke and a matching flat in the socket; no alignment jig |

### Assembly worksheet

| op | item | qty | handling | insertion | s each | s total | min parts | reason |
|---|---|---|---|---|---|---|---|---|
| A1 | fuselage_front | 1 | H10 | I00 | 3.00 | 3.00 | 1 | base part |
| A1 | fuselage_rear | 1 | H10 | I08 | 8.00 | 8.00 | 0 | separate only for the 180 mm bed |
| A2 | camera | 1 | H00 | I08 | 7.63 | 7.63 | 1 | separate function, optics |
| A2 | vtx | 1 | H00 | I06 | 6.63 | 6.63 | 0 | could be one camera+VTX module |
| A3 | fc | 1 | H00 | I01 | 3.63 | 3.63 | 1 | separate electronics |
| A3 | M2 screw (FC) | 4 | Hs | I38 | 8.50 | 34.00 | 0 | fastener |
| A3 | receiver | 1 | H10 | I06 | 7.00 | 7.00 | 0 | could be integrated in the FC |
| A3 | esc | 1 | H10 | I01 | 4.00 | 4.00 | 0 | could be integrated in the FC |
| A4 | servo_elev | 1 | H10 | I06 | 7.00 | 7.00 | 1 | moves |
| A4 | servo_rud | 1 | H10 | I06 | 7.00 | 7.00 | 1 | moves |
| A4 | servo screw | 4 | Hs | I38 | 8.50 | 34.00 | 0 | fastener |
| A5 | tail_mount | 1 | H10 | I00 | 3.00 | 3.00 | 0 | could be printed with the motor cap |
| A5 | stab | 1 | H10 | I08 | 8.00 | 8.00 | 1 | different material (LW-PLA) |
| A5 | fin | 1 | H00 | I31 | 6.13 | 6.13 | 0 | could be printed with the tail mount |
| A6 | elevator | 1 | H10 | I08 | 8.00 | 8.00 | 1 | moves |
| A6 | rudder | 1 | H00 | I08 | 7.63 | 7.63 | 1 | moves |
| A7 | boom | 1 | H2h | I03 | 6.50 | 6.50 | 1 | different material (carbon) |
| A7 | tail sub-assembly | 1 | H2h | I08 | 9.50 | 9.50 | 0 | sub-assembly, already counted |
| A8 | motor_mount | 1 | H00 | I31 | 6.13 | 6.13 | 0 | could be printed with the tail mount |
| A8 | motor | 1 | H10 | I06 | 7.00 | 7.00 | 1 | rotates |
| A8 | M2 screw (motor) | 4 | Hs | I38 | 8.50 | 34.00 | 0 | fastener |
| A9 | boom sub-assembly | 1 | H2h | I08 | 9.50 | 9.50 | 0 | sub-assembly, already counted |
| A10 | pushrod_elev | 1 | Hf | I03 | 7.50 | 7.50 | 1 | moves |
| A10 | pushrod_rud | 1 | Hf | I03 | 7.50 | 7.50 | 1 | moves |
| A12 | wing_centre | 1 | H10 | I08 | 8.00 | 8.00 | 1 | different material (LW-PLA) |
| A12 | spar_main | 1 | H2h | I03 | 6.50 | 6.50 | 1 | different material (carbon) |
| A12 | spar_rear | 1 | H2h | I03 | 6.50 | 6.50 | 0 | could merge with the main spar |
| A12 | wing_R | 1 | H2h | I08 | 9.50 | 9.50 | 0 | separate only for the 180 mm bed |
| A12 | wing_L | 1 | H2h | I08 | 9.50 | 9.50 | 0 | separate only for the 180 mm bed |
| A13 | wing sub-assembly | 1 | H2h | I08 | 9.50 | 9.50 | 0 | sub-assembly, already counted |
| A14 | servo_ail_R | 1 | H10 | I08 | 8.00 | 8.00 | 1 | moves |
| A14 | servo_ail_L | 1 | H10 | I08 | 8.00 | 8.00 | 1 | moves |
| A14 | fairing_ail_R | 1 | H00 | I08 | 7.63 | 7.63 | 0 | could be printed into the wing panel |
| A14 | fairing_ail_L | 1 | H00 | I08 | 7.63 | 7.63 | 0 | could be printed into the wing panel |
| A15 | aileron_R | 1 | H10 | I08 | 8.00 | 8.00 | 1 | moves |
| A15 | aileron_L | 1 | H10 | I08 | 8.00 | 8.00 | 1 | moves |
| A15 | horn_ail_R | 1 | Hs | I08 | 9.00 | 9.00 | 0 | could be printed into the aileron |
| A15 | horn_ail_L | 1 | Hs | I08 | 9.00 | 9.00 | 0 | could be printed into the aileron |
| A15 | pushrod_ail_R | 1 | Hf | I03 | 7.50 | 7.50 | 1 | moves |
| A15 | pushrod_ail_L | 1 | Hf | I03 | 7.50 | 7.50 | 1 | moves |
| A17 | prop | 1 | H10 | I38 | 7.50 | 7.50 | 1 | rotates, replaced after crashes |
| A17 | battery | 1 | H10 | I06 | 7.00 | 7.00 | 1 | removed for charging |
| A17 | antenna | 1 | Hf | I01 | 6.50 | 6.50 | 0 | part of the VTX |
| A17 | lid | 1 | H00 | I30 | 3.13 | 3.13 | 1 | opened for battery changes |

Handling classes: H00 1.13 s (one hand, easy to grasp, symmetric (alpha+beta < 360 deg)); H10 1.5 s (one hand, alpha+beta 360-540 deg); H20 1.8 s (one hand, alpha+beta 540-720 deg); Hs 2.5 s (small part, fingertips or tweezers (M2 screw, horn)); Hf 4.0 s (flexible or tangles (wire, lead, pushrod)); H2h 3.0 s (long or large, two hands (tube, spar, wing panel)).

Insertion classes: I00 1.5 s (placed, no holding, easy to align); I01 2.5 s (placed, not easy to align); I03 3.5 s (placed, hard to align, resistance); I06 5.5 s (held during the next step, easy to align); I08 6.5 s (held during the next step, hard to align); I30 2.0 s (snap or press fit, easy); I31 5.0 s (press fit with resistance); I38 6.0 s (screwed in immediately, easy); I39 8.0 s (screwed in immediately, awkward access).

Process times: ca 15 s (CA glue joint: apply and hold); epoxy_mix 60 s (mix a batch of 5-minute epoxy); epoxy 20 s (epoxy joint); hotglue 20 s (hot-glue a servo in its pocket); solder 25 s (solder joint, tinned); shrink 15 s (heat-shrink sleeve); tape 10 s (double-sided tape pad); tape_hinge 40 s (tape hinge, top and bottom); strap 20 s (velcro strap); cut_tube 60 s (mark, cut and deburr a carbon tube); cut_rod 30 s (cut a carbon rod or wire); z_bend 30 s (Z-bend in 0.8 mm wire); l_bend 20 s (L-bend in 0.8 mm wire); rod_end 40 s (glue a wire end into a carbon rod, shrink); trim_horn 30 s (trim a servo horn); ream 15 s (ream a hole with a hand drill); unplate 20 s (take a part off the plate, clean edges); brim 60 s (remove a brim); route 30 s (route a servo lead); hook 15 s (hook a pushrod end into a horn); square 60 s (sight and square the tail to the wing); plug 8 s (plug a lead into the FC); plate_swap 120 s (clear the plate, start the next job); bind 120 s (bind the receiver); config 1800 s (INAV setup: mixer, servo directions, endpoints, OSD); balance 180 s (set the battery position for the CG); checks 300 s (control directions, throws, failsafe, range check); cut_ptfe 30 s (cut a PTFE sleeve to length); thread 60 s (thread a sleeve or wires through the boom); drill_exit 60 s (mark and drill a pushrod exit hole in the boom).

## Design for manufacture (3D printing)

Sliced with PrusaSlicer 2.7, A1-mini-like profile (tools/a1mini.ini). Overhangs: down-facing surfaces steeper than 45 deg from vertical, above the first layer. Regions narrower than 10 mm (hole tops, chamfers) print without support; flat ceilings up to 30 mm are bridges.

| part | material | print time | filament | cost | overhang area | support | notes |
|---|---|---|---|---|---|---|---|
| wing_centre | LW-PLA | 112 min | 14.4 g | 0.79 EUR | 36 mm^2 | none | tall and thin (height/width 11); brim and slow Y moves on a bed-slinger |
| wing_R | LW-PLA | 87 min | 9.6 g | 0.53 EUR | 372 mm^2 | none | tall and thin (height/width 15); brim and slow Y moves on a bed-slinger |
| wing_L | LW-PLA | 87 min | 9.6 g | 0.53 EUR | 372 mm^2 | none | tall and thin (height/width 15); brim and slow Y moves on a bed-slinger |
| aileron_R | LW-PLA | 22 min | 4.0 g | 0.22 EUR | 2635 mm^2 | bridge 17 mm | small bed contact (0 mm^2); use a brim or glue stick |
| aileron_L | LW-PLA | 22 min | 4.0 g | 0.22 EUR | 2635 mm^2 | bridge 17 mm | small bed contact (0 mm^2); use a brim or glue stick |
| tail_mount | PLA/PETG | 26 min | 4.3 g | 0.09 EUR | 0 mm^2 | none | small bed contact (58 mm^2); use a brim or glue stick |
| stab | LW-PLA | 27 min | 4.0 g | 0.22 EUR | 0 mm^2 | none | - |
| elevator | LW-PLA | 15 min | 2.3 g | 0.13 EUR | 1 mm^2 | none | - |
| fin | LW-PLA | 12 min | 1.8 g | 0.10 EUR | 0 mm^2 | none | - |
| rudder | PLA/PETG | 6 min | 2.1 g | 0.04 EUR | 5 mm^2 | none | - |
| motor_mount | PLA/PETG | 16 min | 2.6 g | 0.05 EUR | 56 mm^2 | none | - |
| fairing_ail_R | LW-PLA | 11 min | 1.0 g | 0.06 EUR | 1444 mm^2 | support | 1 overhang(s) wider than 10 mm; largest 32 mm; small bed contact (1 mm^2); use a brim or glue stick |
| fairing_ail_L | LW-PLA | 11 min | 1.0 g | 0.06 EUR | 1444 mm^2 | support | 1 overhang(s) wider than 10 mm; largest 32 mm; small bed contact (1 mm^2); use a brim or glue stick |
| fuselage_front | PLA/PETG | 26 min | 10.0 g | 0.20 EUR | 747 mm^2 | none | - |
| fuselage_rear | PLA/PETG | 89 min | 20.3 g | 0.41 EUR | 646 mm^2 | bridge 11 mm | tall and thin (height/width 7); brim and slow Y moves on a bed-slinger; small bed contact (57 mm^2); use a brim or glue stick |
| lid | PLA/PETG | 13 min | 8.8 g | 0.18 EUR | 5787 mm^2 | support | 1 overhang(s) wider than 10 mm; largest 32 mm |

Total: 9 h 53 min of printing, 100 g of filament, about 3.83 EUR of material (PETG 20 EUR/kg, LW-PLA 55 EUR/kg).

## Cost

| item | qty | EUR each | EUR |
|---|---|---|---|
| SG90 servo | 4 | 3.00 | 12.00 |
| 1404 motor, 3000-3800 KV | 1 | 15.00 | 15.00 |
| 4x2.5 prop (pair) | 1 | 1.00 | 1.00 |
| Hobbywing XRotor Micro 30A ESC | 1 | 15.00 | 15.00 |
| Matek F405-WMN wing FC | 1 | 55.00 | 55.00 |
| ELRS nano receiver | 1 | 10.00 | 10.00 |
| nano camera 14 mm | 1 | 15.00 | 15.00 |
| VTX 25-200 mW | 1 | 15.00 | 15.00 |
| 5.8 GHz whip antenna | 1 | 3.00 | 3.00 |
| 2S 450 mAh LiPo | 1 | 8.00 | 8.00 |
| roll-wrapped carbon tube 10x9 x 500 mm | 1 | 9.00 | 9.00 |
| carbon rod 3 / 2 mm | 2 | 2.00 | 4.00 |
| PTFE tube 2/1 mm, 1 m | 1 | 2.00 | 2.00 |
| servo extension wire and silicone wire | 1 | 2.00 | 2.00 |
| pushrod rod, wire, horns | 1 | 3.00 | 3.00 |
| screws, tape, velcro, glue | 1 | 4.00 | 4.00 |
| printed parts: filament actually used (100 g: 52 g LW-PLA, 48 g PETG) | 1 | 3.83 | 3.83 |
| **per airframe** | | | **177** |

The whole printed airframe, wing included, is only 100 g of filament: the wing sections are thin one-wall LW-PLA shells (42 g for the centre, both panels and both ailerons). So the filament per airframe is a few euros, but a first build still has to buy the spools:

| first build | EUR |
|---|---|
| bought parts | 173 |
| LW-PLA spool, 750 g | 45 |
| PETG spool, 1 kg | 20 |
| **first build outlay** | **238** |

Budget some LW-PLA for calibration: test cubes to set the flow, and possibly a failed 1.5-hour wing panel. Later airframes from the same spools cost the bought parts plus a few euros of filament.

Prices are rough street prices for comparison only; the flight controller is the biggest item.
