henriharmaala1-source/Assembly-grapher/airframe/variants/single-boom/SECTION.md

# Fuselage cross-section for the single-boom Kipinä

Generated by `aero/section.py`. Do not edit by hand.

The smallest outline of each family that holds the battery with its strap slots, the flight controller on its standoffs, both SG90s lying on their sides, the boom socket and the ESC, with 0.3 mm clearance and a 0.8 mm wall. Skin friction follows the perimeter; the drag column is the skin friction and form drag of a 300 mm fuselage with that section at 13 m/s (the whole plane has about 0.23 N).

| Outline | Outside, mm | Perimeter | Frontal area | Flat top for the wing | Fuselage drag at 13 m/s |
|---|---|---|---|---|---|
| flat-topped box, r 10 top, 0.0 bottom | 36.2 x 25.5 | 114 mm (+0 %) | 8.7 cm² | 19 mm | 21.9 mN (+0.0) |
| superellipse, n 3 | 40.2 x 30.7 | 120 mm (+5 %) | 10.9 cm² | 15 mm | 23.7 mN (+1.8) |
| superellipse, n 4 | 38.4 x 30.2 | 120 mm (+6 %) | 10.7 cm² | 20 mm | 23.7 mN (+1.8) |
| ellipse | 41.2 x 35.1 | 120 mm (+6 %) | 11.4 cm² | 7 mm | 23.9 mN (+2.0) |
| circle | 38.9 x 38.9 | 122 mm (+8 %) | 11.9 cm² | 7 mm | 24.6 mN (+2.6) |

What goes inside, y across and z up from the floor (mm):

| item | y | z |
|---|---|---|
| battery | -15.5 to 15.5 | 0.0 to 13.0 |
| strap slots | -17.0 to 17.0 | 0.0 to 0.8 |
| flight controller | -13.0 to 13.0 | 0.0 to 19.5 |
| servo on its side | -15.4 to 15.4 | 0.0 to 12.2 |
| servo horn swing | 10.9 to 12.4 | 0.0 to 19.2 |
| boom socket | -6.4 to 6.4 | 10.8 to 23.6 |
| ESC, flat | -7.2 to 7.2 | 0.0 to 5.8 |
