henriharmaala1-source/Assembly-grapher/frames/mark4-v2-10/hardware/hardware.pdf

# Hardware stand-ins (printed)

Pins Ø2.7 in Ø2.7 bores, no threads. For test assembly only

### Scale 2:1

Sheet 1 of 1 Mark4 V2 10" frame, from its STEP model. mm. Print at 100 % (actual size) and check the bar.

50 mm on paper

35

Ø6

Ø2.7 through

# Standoff

6

3

Ø5.5

Ø2.7

# Pin, cap head, 6

8

3

Ø5.5

Ø2.7

# Pin, cap head, 8

10

3

Ø5.5

Ø2.7

# Pin, cap head, 10

12

3

Ø5.5

Ø2.7

# Pin, cap head, 12

18

3

Ø5.5

Ø2.7

# Pin, cap head, 18

Ø8 x 0.8

Ø5.9

3

# Press-nut ring

bore Ø2.7

# Parts list

Qty Part | Goes | Print
8 Standoff Ø6 x 35 | S1-S8, lower plate to top plate | stand on end
8 Pin, cap head, 6 | top plate into the standoffs | lying flat
2 Pin, cap head, 8 | S7, S8: tail plate, from below | lying flat
2 Pin, cap head, 10 | S1, S2: chin plate, from below | lying flat
12 Pin, cap head, 12 | arm bolts (4) from below; braces (8) from above | lying flat
4 Pin, cap head, 18 | S3-S6 from below: belly, arm, lower plate | lying flat
12 Press-nut ring | lower plate's arm-bolt holes (4); under the arms at the braces (8) | flange down
1 Fit gauge | print first: bores 2.4-3.0, notches count 0.1 mm steps | flat

Fit: pins Ø2.7 clear the plates' 3.0-3.2 holes and press into Ø2.7 bores. Bores printed standing come

out about 0.1-0.15 undersize, so this grips. Too tight or loose: print the gauge, then rerun hardware.py --bore.

Print pins lying flat (stronger across the layers), in PETG or PA, 100 % infill. Lengths match the real screws,

measured under the head. Chin and tail plate holes are Ø2.8 in the model: open them to 3.2 for the pins to pass.

The STEP countersinks those holes; with plain holes, cap-head pins go there (hardware.py --countersunk for the other).

The brace fasteners are as the RJX manual shows them (M3 x 12, press nuts); pins sit loose in the Ø5 and Ø4 holes.
