henriharmaala1-source/Assembly-grapher/aero/study/CROSSCHECK.md

# Cross-checks of the efficiency study

Generated by `aero/crosscheck.py` from the sections in `study.json` (n_crit 7). Do not edit by hand. The charts are in [index.html](index.html#crosscheck).

## The wing section: drag at the design points

| tool | section | loiter (cl 0.66, Re 71k) | cruise (cl 0.45, Re 86k) | fast (cl 0.23, Re 120k) | weighted change |
|---|---|---|---|---|---|
| NeuralFoil 0.3.3 (large) | NACA 4412 | 0.0217 | 0.0178 | 0.0167 |  |
|  | optimized | 0.0178 | 0.0143 | 0.0126 | -20.0 % |
| | change | -18 % | -20 % | -25 % | |
| NeuralFoil 0.3.3 (xxxlarge) | NACA 4412 | 0.0212 | 0.0177 | 0.0165 |  |
|  | optimized | 0.0177 | 0.0145 | 0.0129 | -18.2 % |
| | change | -16 % | -18 % | -22 % | |
| XFOIL 6.99 | NACA 4412 | 0.0212 | 0.0177 | 0.0166 |  |
|  | optimized | 0.0177 | 0.0145 | 0.0127 | -18.8 % |
| | change | -17 % | -18 % | -24 % | |
| OpenFOAM simpleFoam, k-omega SST + Langtry-Menter | NACA 4412 | 0.0403 | 0.0253 | 0.0202 |  |
|  | optimized | 0.0278 | 0.0207 | 0.0165 | -23.6 % |
| | change | -31 % | -18 % | -19 % | |
| | compared at cl | 0.56 | 0.40 | 0.22 | |

## Maximum lift at 9 m/s (Re 60k)

| tool | NACA 4412 | optimized |
|---|---|---|
| NeuralFoil (large) | 1.38 at 14° | 1.41 at 10.5° |
| NeuralFoil (xxxlarge) | 1.39 at 14.25° | 1.41 at 10.5° |
| XFOIL | 1.40 at 14.25° | 1.42 at 10.25° |

XFOIL cruise cd against n_crit (5 rough, 9 smooth): NACA 4412: 5 → 0.0156, 7 → 0.0177, 9 → 0.0216; optimized: 5 → 0.0145, 7 → 0.0145, 9 → 0.0152.

## The CFD runs

OpenFOAM simpleFoam, k-omega SST + Langtry-Menter, free-stream turbulence 0.161 % (n_crit 7 by Mack's relation), 66960 cells, y+ under 1, a point-vortex far field. Two angles per point and section; the sections are compared at the same lift, inside the range both runs reached.

| point | compared at cl | NACA 4412 cd | optimized cd | change | runs (angle: cl, cd ± half the swing) |
|---|---|---|---|---|---|
| loiter (design 0.66) | 0.562 | 0.0403 | 0.0278 | -31 % | 4412 2.13°: 0.490, 0.0339 ± 0.0024; 4412 3.77°: 0.562, 0.0403 ± 0.0015; opt 2.07°: 0.527, 0.0271 ± 0.0012; opt 3.36°: 0.638, 0.0294 ± 0.0020 |
| cruise (design 0.45) | 0.399 | 0.0253 | 0.0207 | -18 % | 4412 0.15°: 0.392, 0.0235 ± 0.0051; 4412 0.70°: 0.399, 0.0270 ± 0.0023; opt 0.11°: 0.362, 0.0202 ± 0.0054; opt 0.94°: 0.429, 0.0210 ± 0.0013 |
| fast (design 0.23) | 0.222 | 0.0202 | 0.0165 | -19 % | 4412 -1.87°: 0.127, 0.0243 ± 0.0013; 4412 -0.85°: 0.222, 0.0202 ± 0.0019; opt -1.23°: 0.200, 0.0163 ± 0.0036; opt -0.47°: 0.306, 0.0171 ± 0.0055 |

Set-up check (NACA 4412, Re 1e+06, 4°, n_crit 9): CFD cl 0.905, cd 0.00719; XFOIL cl 0.925, cd 0.00744 (-2.2 % lift, -3.4 % drag).

Grid check (NACA 4412 at cruise, same angle): 29920 cells cd 0.02934, cl 0.2917; 66960 cells cd 0.02348, cl 0.3920 (+24.9 % drag on the coarser grid).

## The whole plane

Span efficiency from the vortex lattice: 0.93 (the study assumes 0.8).

| drag, N | 9.5 m/s | 10 m/s | 11 m/s | 12 m/s | 13 m/s | 14 m/s | 15 m/s | 16 m/s | 17 m/s | 18 m/s | 19 m/s |
|---|---|---|---|---|---|---|---|---|---|---|---|
| handbook, as built | 0.302 | 0.298 | 0.299 | 0.308 | 0.324 | 0.346 | 0.375 | 0.410 | 0.450 | 0.492 | 0.536 |
| handbook with the lattice's induced drag, as built | 0.281 | 0.280 | 0.284 | 0.295 | 0.313 | 0.337 | 0.367 | 0.403 | 0.444 | 0.487 | 0.531 |
| AeroBuildup, as built | 0.251 | 0.239 | 0.226 | 0.222 | 0.223 | 0.229 | 0.239 | 0.253 | 0.272 | 0.294 | 0.317 |
| handbook, optimized airfoil | 0.292 | 0.287 | 0.284 | 0.291 | 0.306 | 0.327 | 0.354 | 0.384 | 0.416 | 0.452 | 0.492 |
| handbook with the lattice's induced drag, optimized airfoil | 0.272 | 0.269 | 0.269 | 0.278 | 0.295 | 0.318 | 0.346 | 0.377 | 0.410 | 0.446 | 0.487 |
| AeroBuildup, optimized airfoil | 0.242 | 0.229 | 0.213 | 0.206 | 0.206 | 0.211 | 0.220 | 0.232 | 0.246 | 0.261 | 0.278 |

At 13 m/s, as built, part by part (N):

| part | handbook | AeroBuildup |
|---|---|---|
| Wing profile | 0.0829 | 0.0862 |
| Tail | 0.0220 | 0.0178 |
| Pod | 0.0590 | 0.0345 |
| Booms, sockets, tail mount | 0.0131 | 0.0065 |
| Horns, wires, antenna | 0.0511 | 0.0000 |
| Junctions | 0.0177 | 0.0000 |
| Induced | 0.0782 | 0.0778 |
| total | 0.3239 | 0.2227 |
