henriharmaala1-source/Assembly-grapher/aero/study/figures/xc-cp-base.png

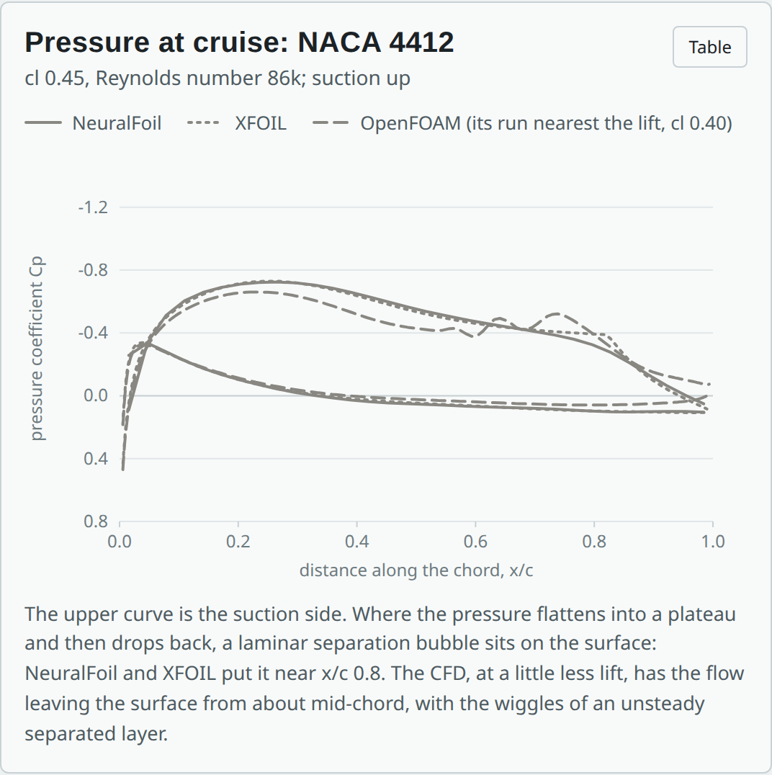
aero/study/figures/xc-cp-base.png
