henriharmaala1-source/Assembly-grapher/aero/study/figures/xc-cp-opt.png

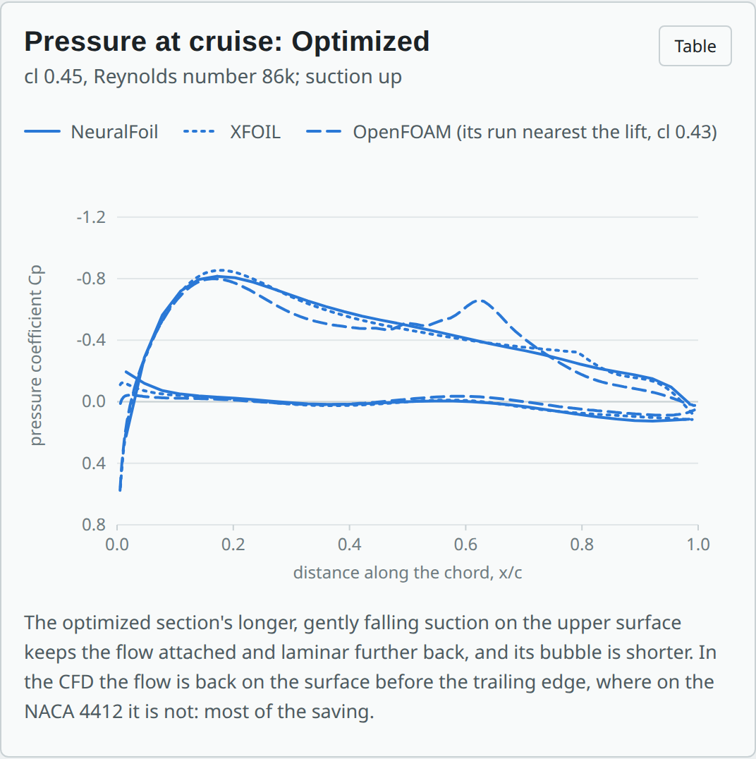
aero/study/figures/xc-cp-opt.png
