henriharmaala1-source/Assembly-grapher/aero/study/figures/xc-ncrit.png

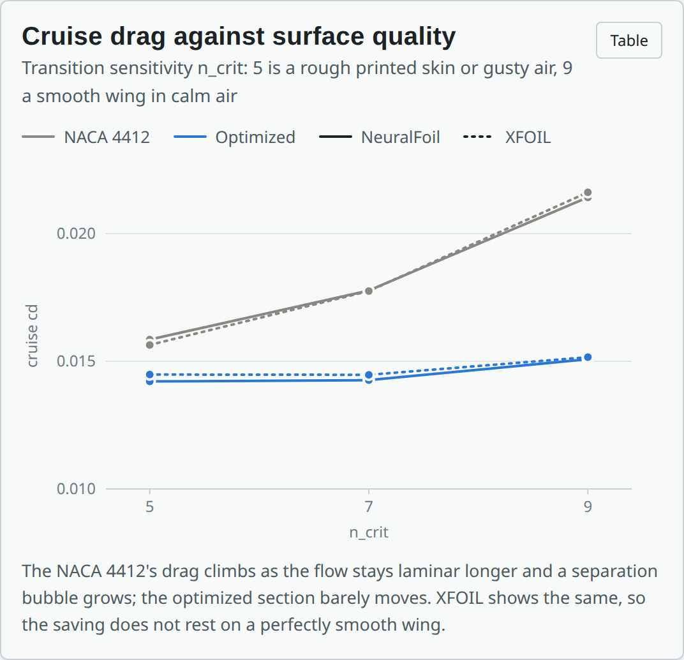
aero/study/figures/xc-ncrit.png
