henriharmaala1-source/Assembly-grapher/aero/study/figures/xc-stall.png

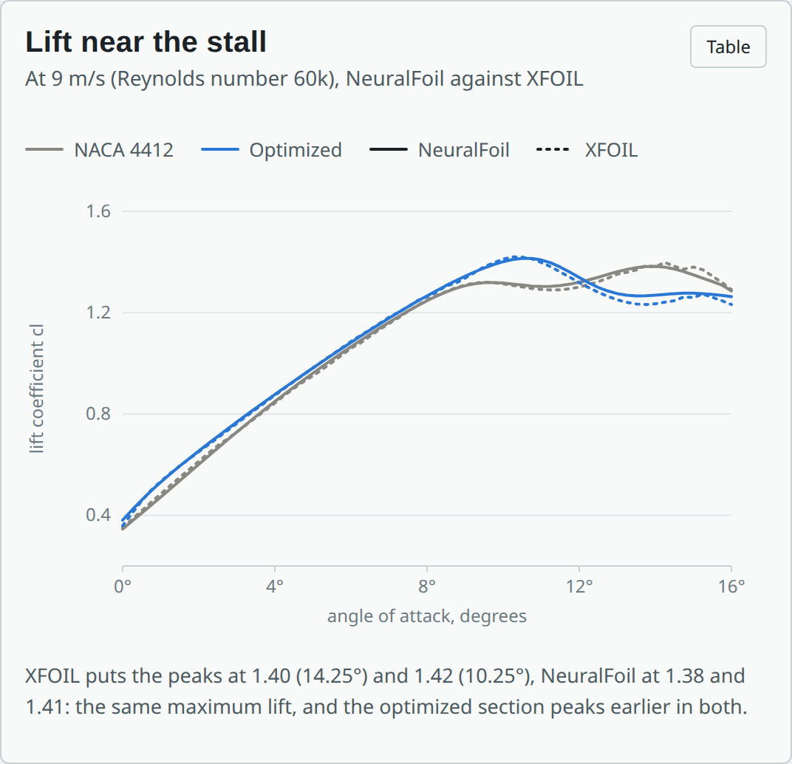
aero/study/figures/xc-stall.png
