henriharmaala1-source/Assembly-grapher/aero/study/figures/xc-tools.png

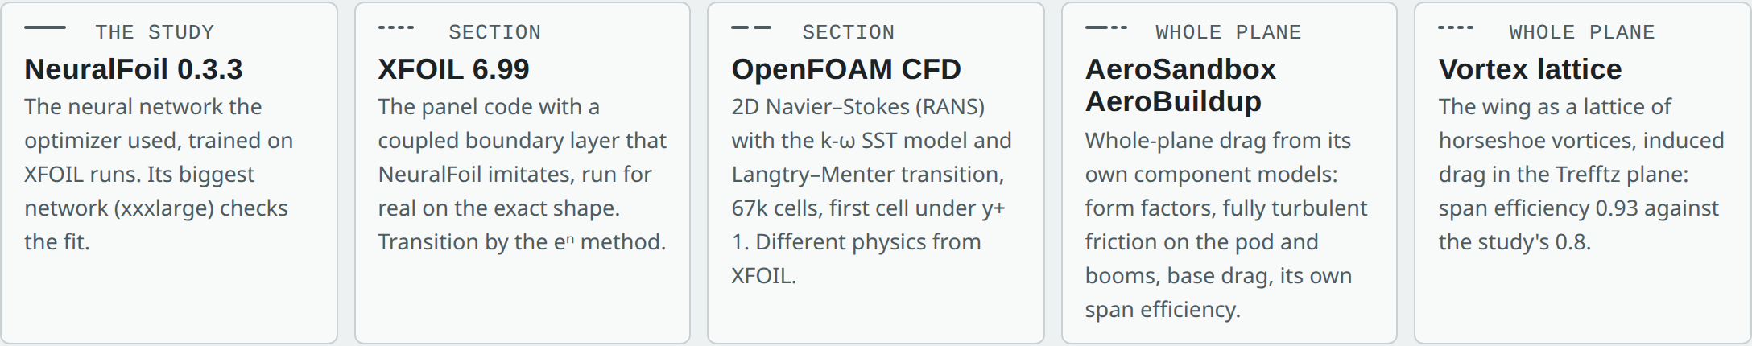
aero/study/figures/xc-tools.png
