henriharmaala1-source/Assembly-grapher/airframe/variants/extreme/preview/cutaway.png

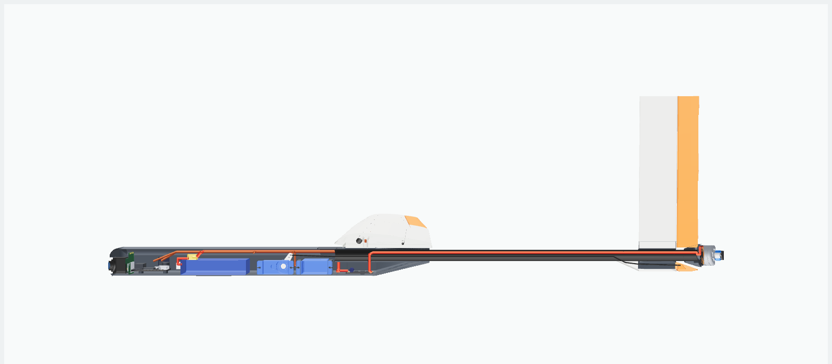
airframe/variants/extreme/preview/cutaway.png
