henriharmaala1-source/Assembly-grapher/airframe/variants/extreme/preview/front.png

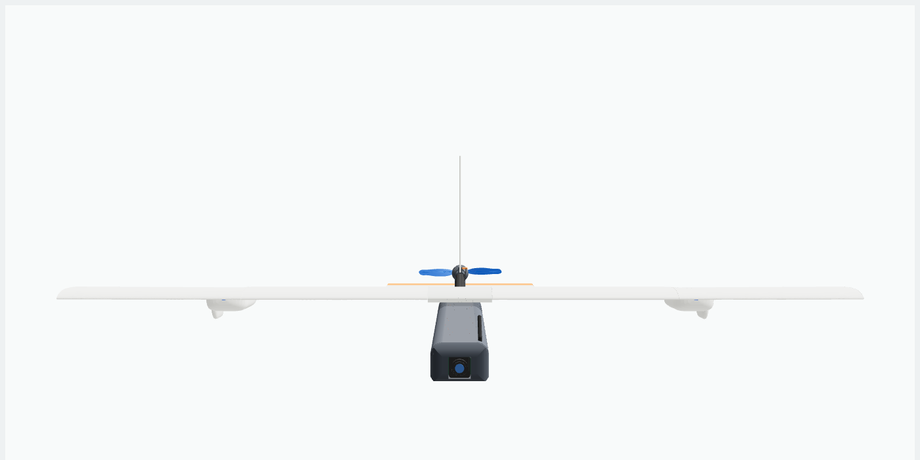
airframe/variants/extreme/preview/front.png
