henriharmaala1-source/Assembly-grapher/airframe/variants/extreme/preview/motor.png

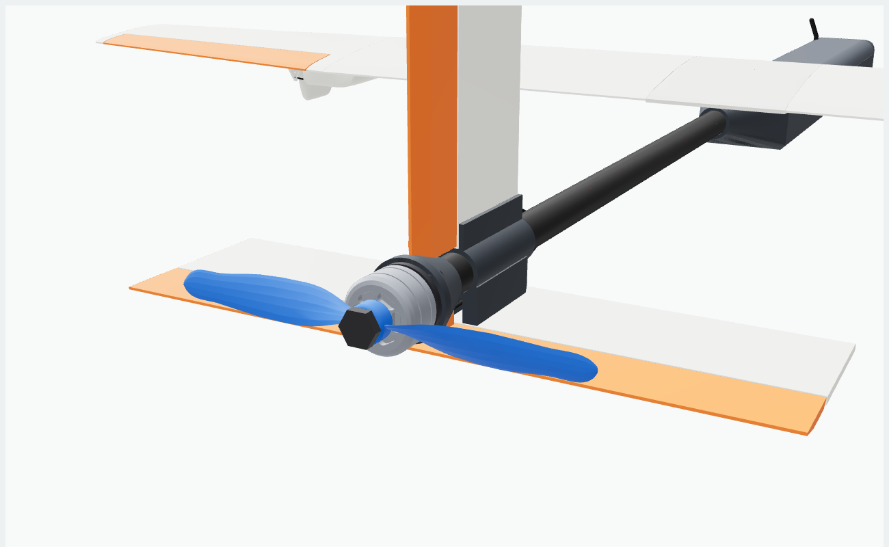
airframe/variants/extreme/preview/motor.png
