henriharmaala1-source/Assembly-grapher/airframe/variants/extreme/preview/nose.png

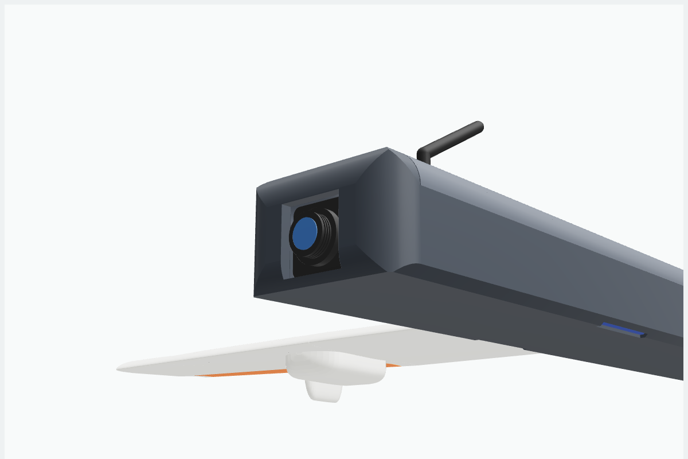
airframe/variants/extreme/preview/nose.png
