henriharmaala1-source/Assembly-grapher/airframe/variants/extreme/preview/servos.png

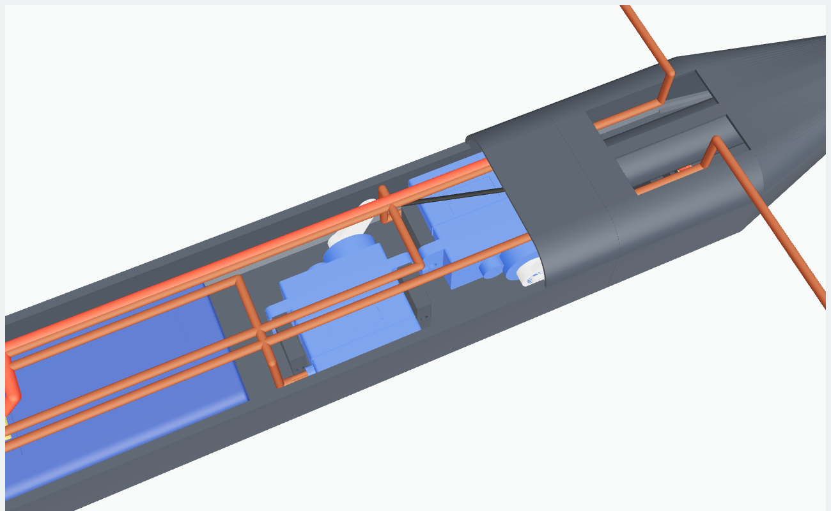
airframe/variants/extreme/preview/servos.png
