henriharmaala1-source/Assembly-grapher/airframe/variants/extreme/preview/tail.png

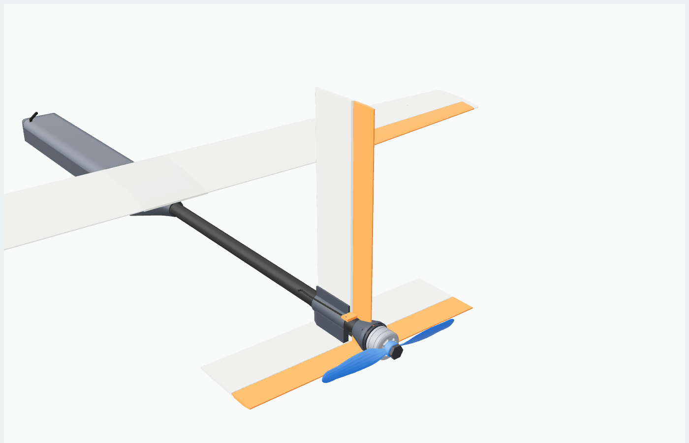
airframe/variants/extreme/preview/tail.png
