henriharmaala1-source/Assembly-grapher/airframe/variants/extreme/preview/under.png

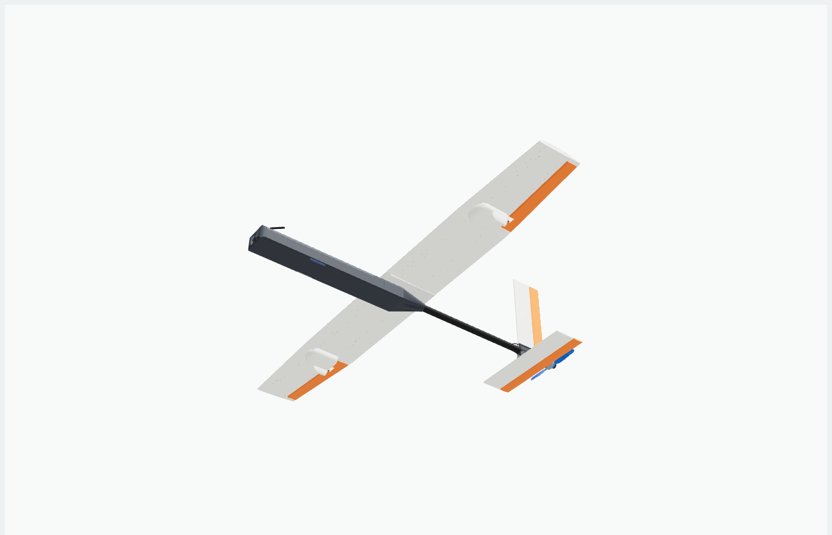
airframe/variants/extreme/preview/under.png
