henriharmaala1-source/Assembly-grapher/airframe/variants/figures/cg.png

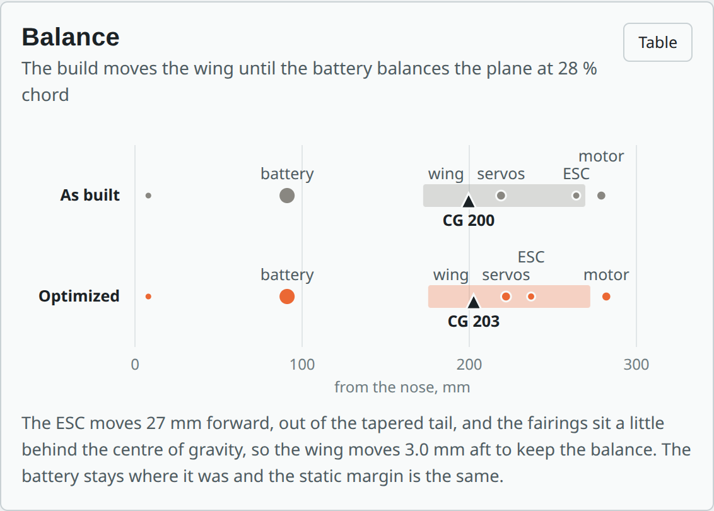
airframe/variants/figures/cg.png
