henriharmaala1-source/Assembly-grapher/airframe/variants/figures/extreme-cg.png

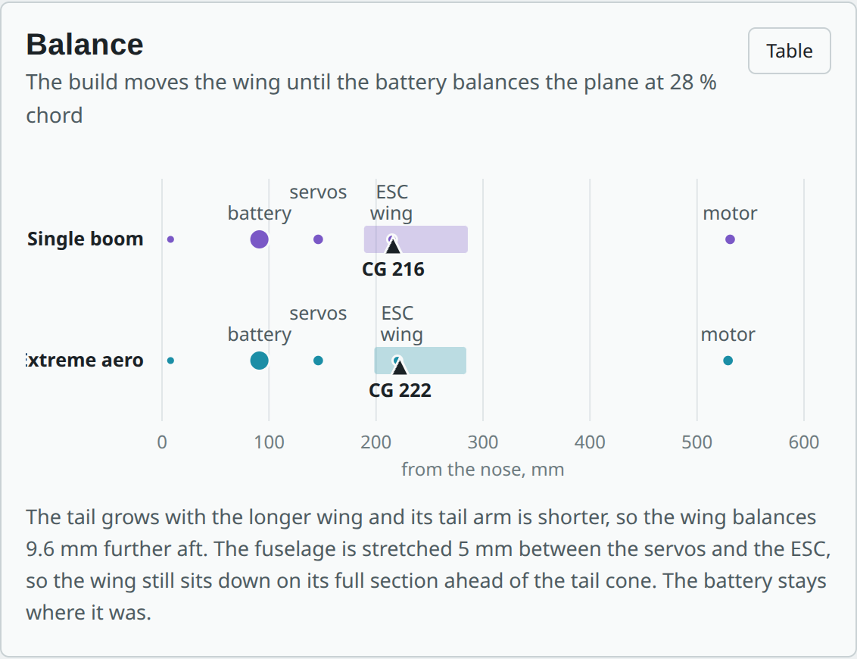
airframe/variants/figures/extreme-cg.png
