henriharmaala1-source/Assembly-grapher/airframe/variants/figures/extreme-mass.png

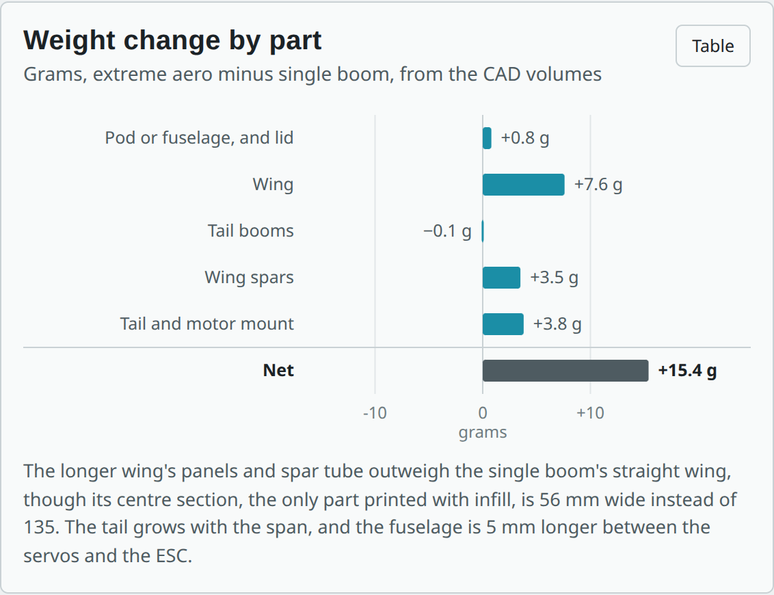
airframe/variants/figures/extreme-mass.png
