henriharmaala1-source/Assembly-grapher/airframe/variants/figures/extreme-models-ailerons.png

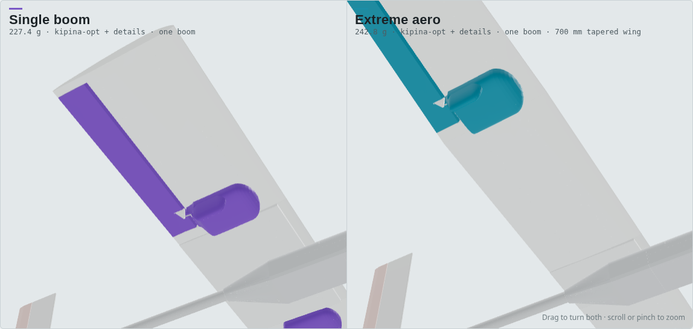
airframe/variants/figures/extreme-models-ailerons.png
