henriharmaala1-source/Assembly-grapher/airframe/variants/figures/extreme-models-fuselage.png

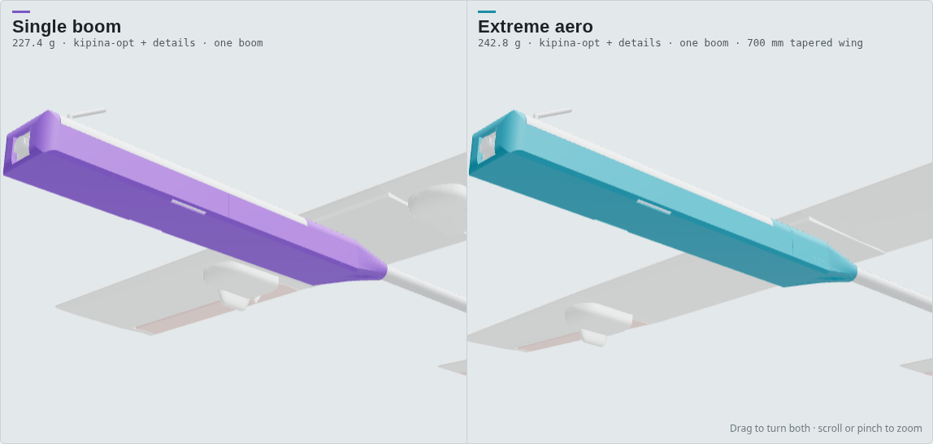
airframe/variants/figures/extreme-models-fuselage.png
