henriharmaala1-source/Assembly-grapher/airframe/variants/figures/extreme-models-side.png

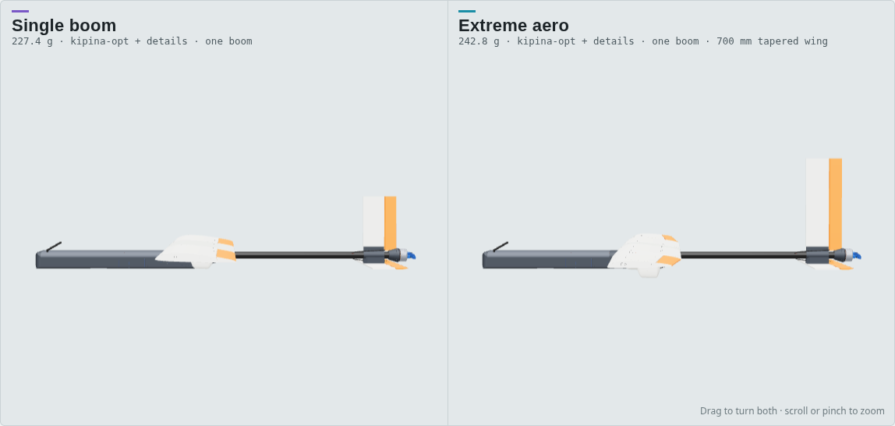
airframe/variants/figures/extreme-models-side.png
