henriharmaala1-source/Assembly-grapher/airframe/variants/figures/extreme-models-spar.png

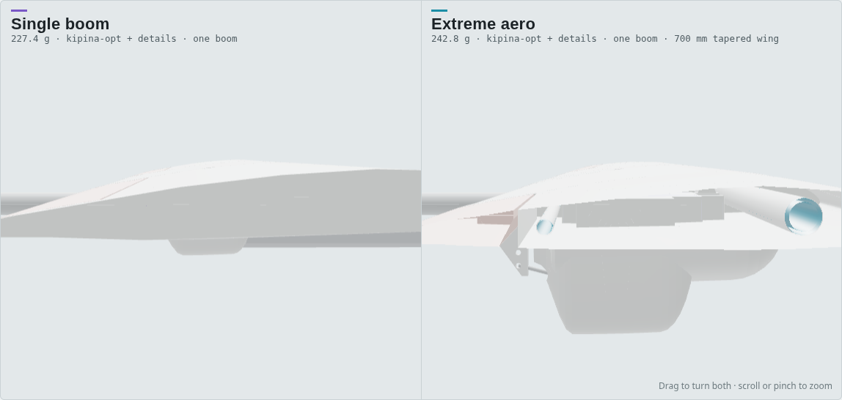
airframe/variants/figures/extreme-models-spar.png
