henriharmaala1-source/Assembly-grapher/airframe/variants/figures/extreme-models-tail.png

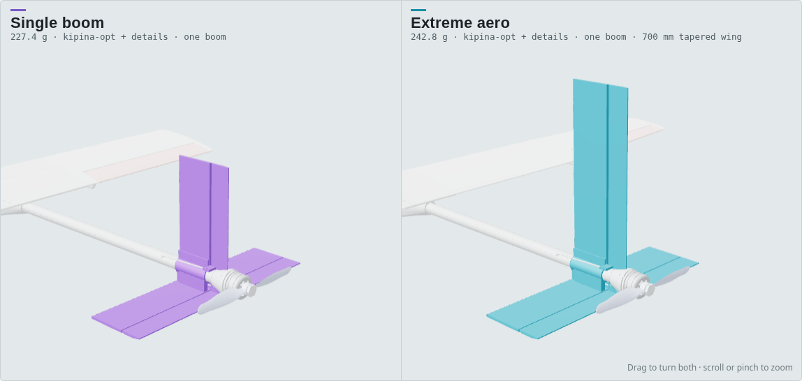
airframe/variants/figures/extreme-models-tail.png
