henriharmaala1-source/Assembly-grapher/airframe/variants/figures/extreme-models-under.png

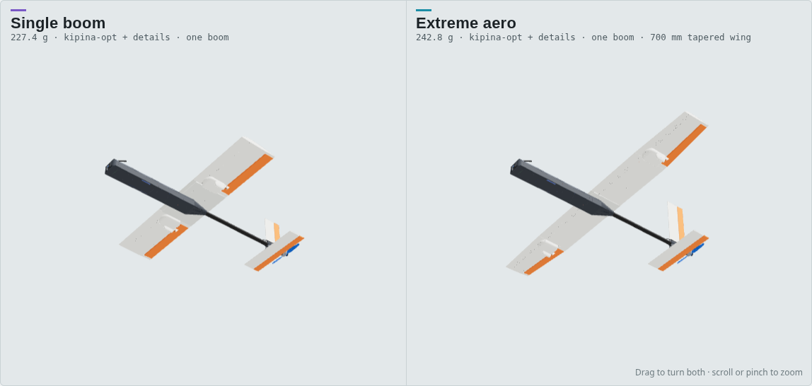
airframe/variants/figures/extreme-models-under.png
