henriharmaala1-source/Assembly-grapher/airframe/variants/figures/extreme-models-wing.png

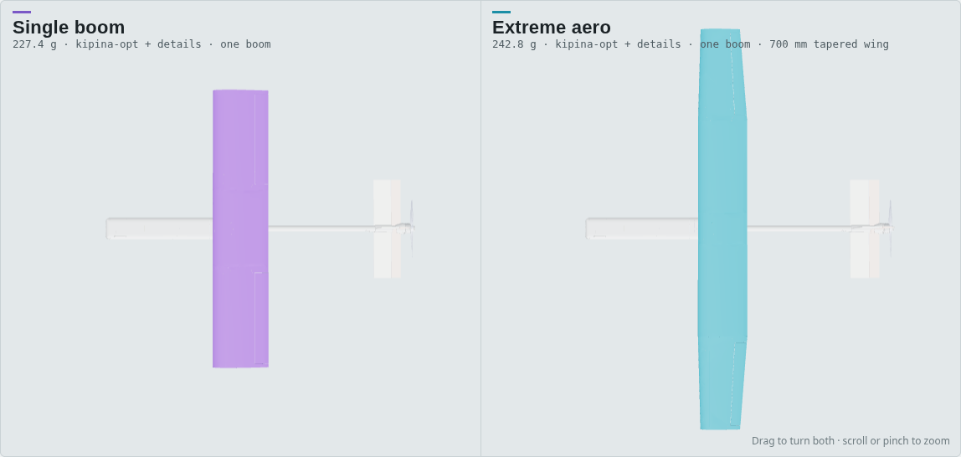
airframe/variants/figures/extreme-models-wing.png
