henriharmaala1-source/Assembly-grapher/airframe/variants/figures/extreme-power.png

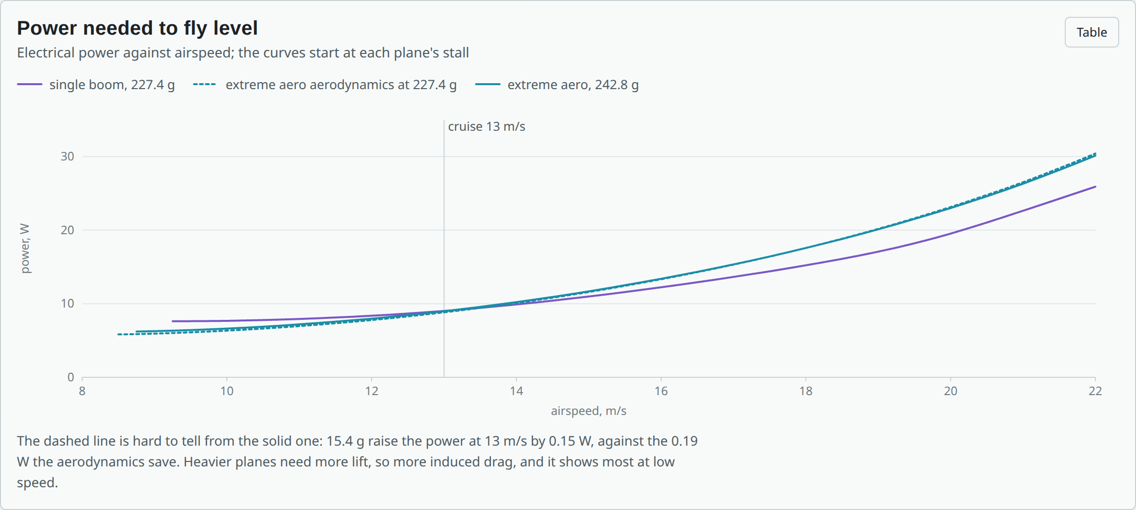
airframe/variants/figures/extreme-power.png
