henriharmaala1-source/Assembly-grapher/airframe/variants/figures/extreme-split.png

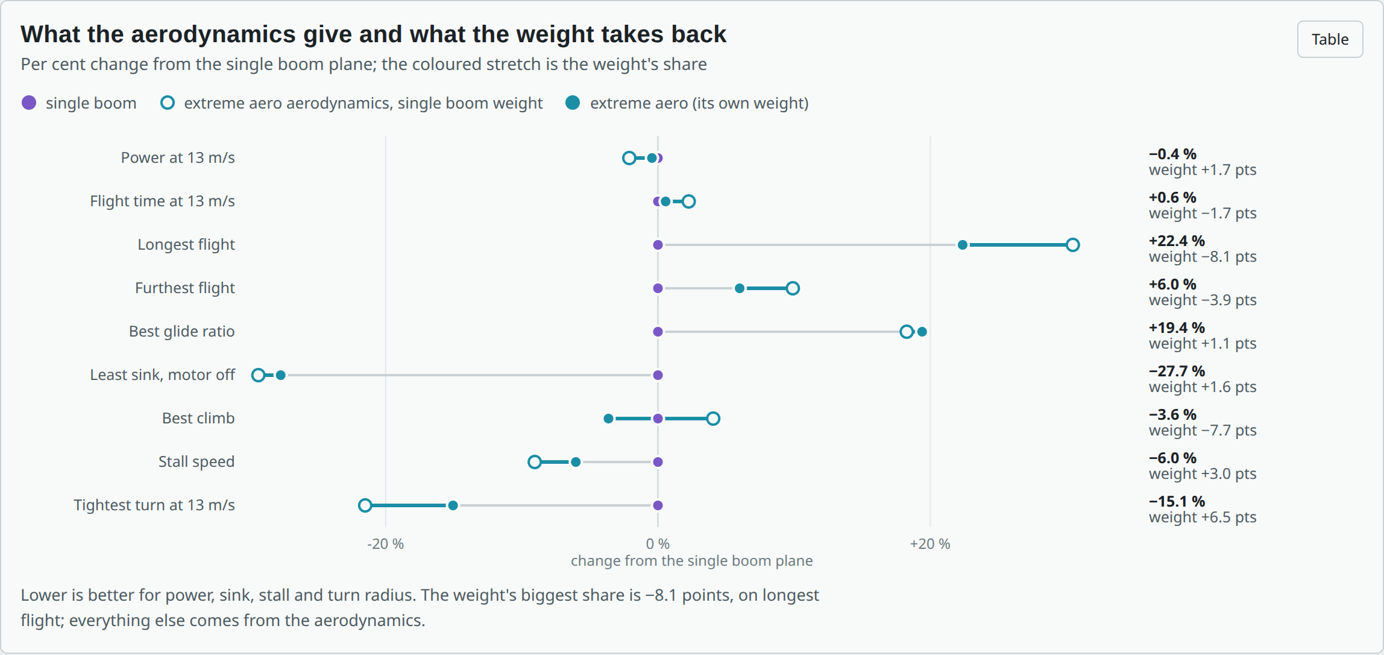
airframe/variants/figures/extreme-split.png
