henriharmaala1-source/Assembly-grapher/airframe/variants/figures/extreme-summary.png

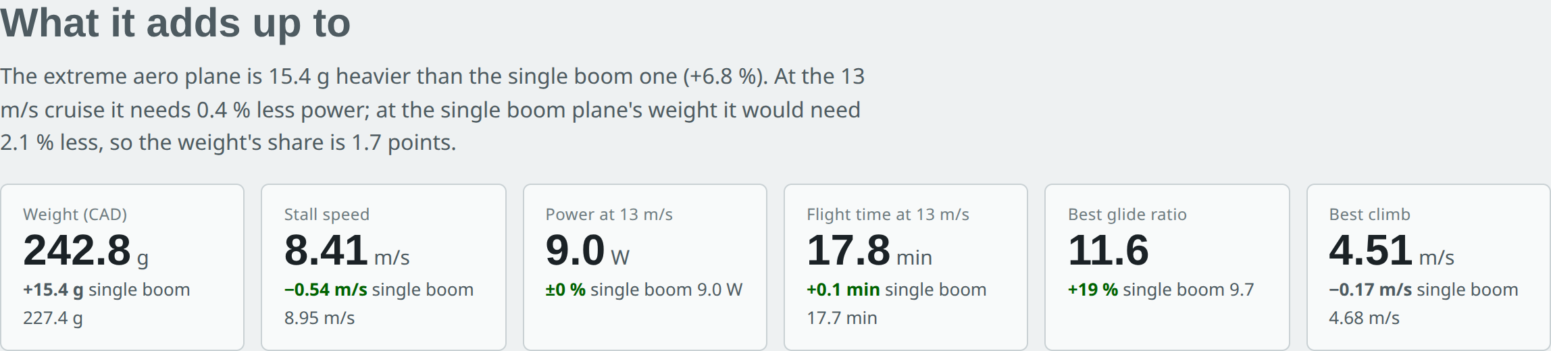
airframe/variants/figures/extreme-summary.png
