henriharmaala1-source/Assembly-grapher/airframe/variants/figures/extreme-sw-climb.png

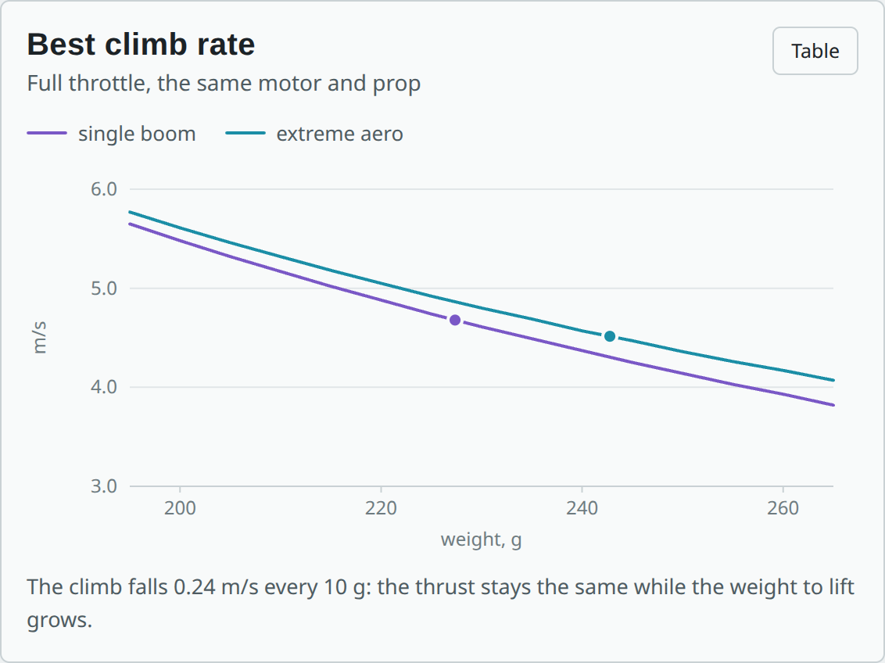
airframe/variants/figures/extreme-sw-climb.png
