henriharmaala1-source/Assembly-grapher/airframe/variants/figures/extreme-sw-long.png

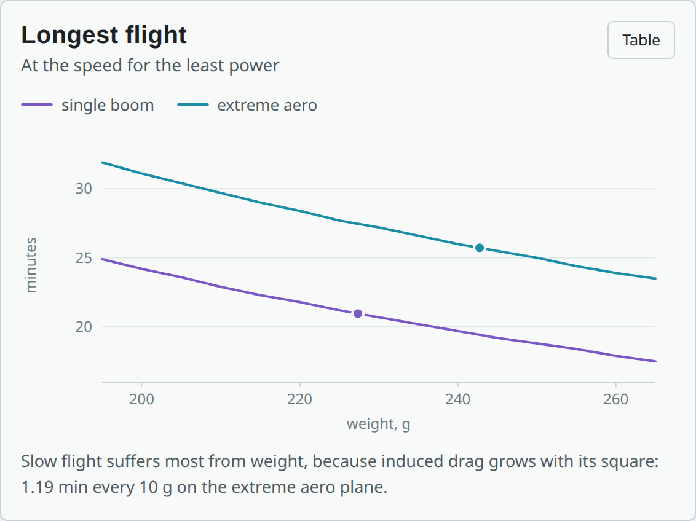
airframe/variants/figures/extreme-sw-long.png
