henriharmaala1-source/Assembly-grapher/airframe/variants/figures/extreme-sw-stall.png

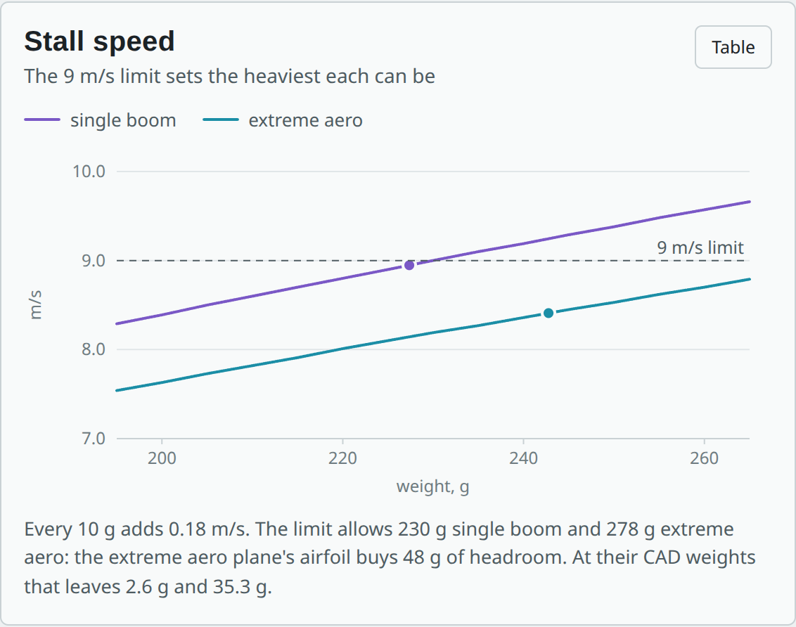
airframe/variants/figures/extreme-sw-stall.png
