henriharmaala1-source/Assembly-grapher/airframe/variants/figures/extreme-sw-time.png

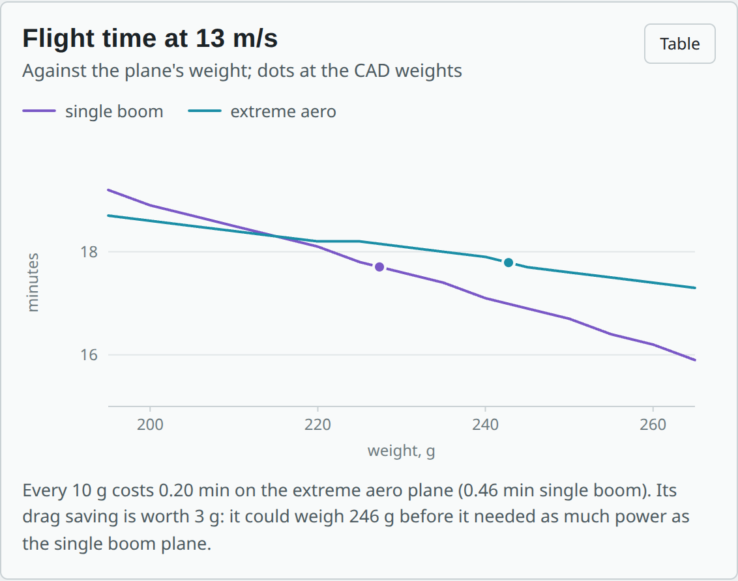
airframe/variants/figures/extreme-sw-time.png
