henriharmaala1-source/Assembly-grapher/airframe/variants/figures/models-airfoil.png

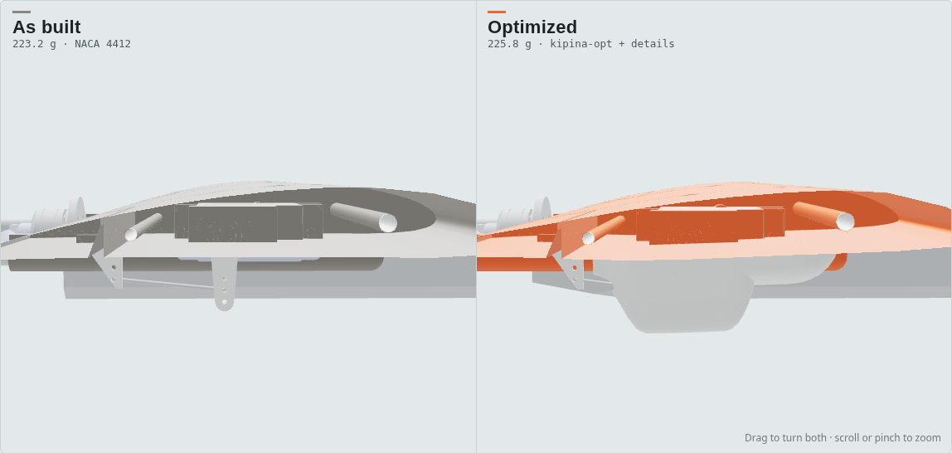
airframe/variants/figures/models-airfoil.png
