henriharmaala1-source/Assembly-grapher/airframe/variants/figures/models-hood.png

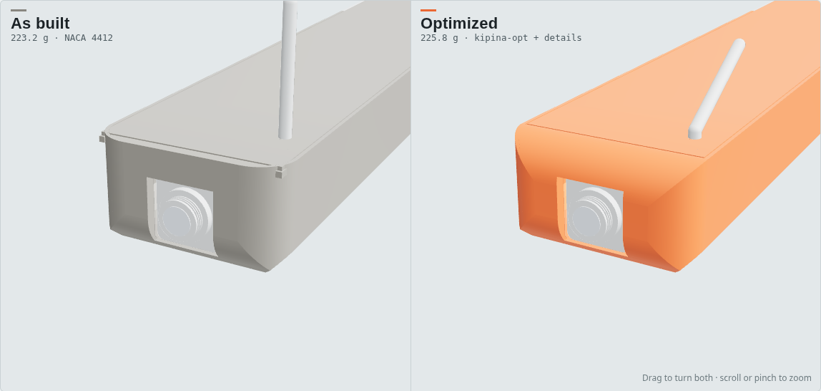
airframe/variants/figures/models-hood.png
