henriharmaala1-source/Assembly-grapher/airframe/variants/figures/models-top.png

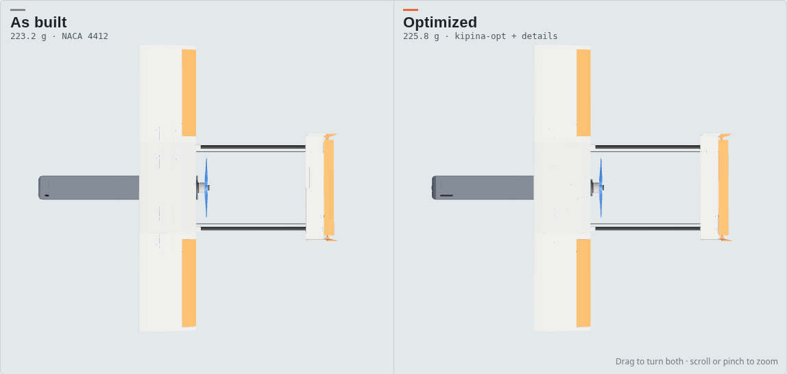
airframe/variants/figures/models-top.png
