henriharmaala1-source/Assembly-grapher/airframe/variants/figures/models-under.png

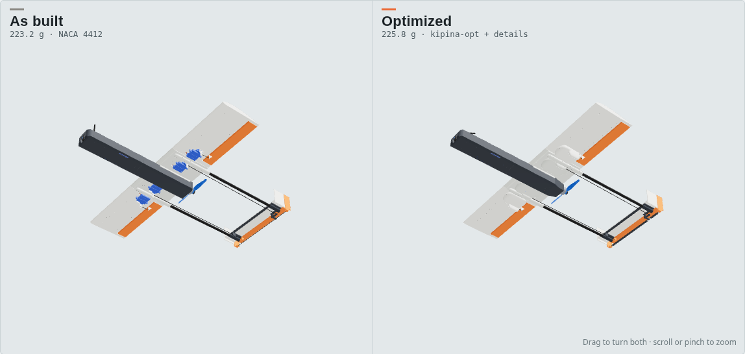
airframe/variants/figures/models-under.png
