henriharmaala1-source/Assembly-grapher/airframe/variants/figures/power.png

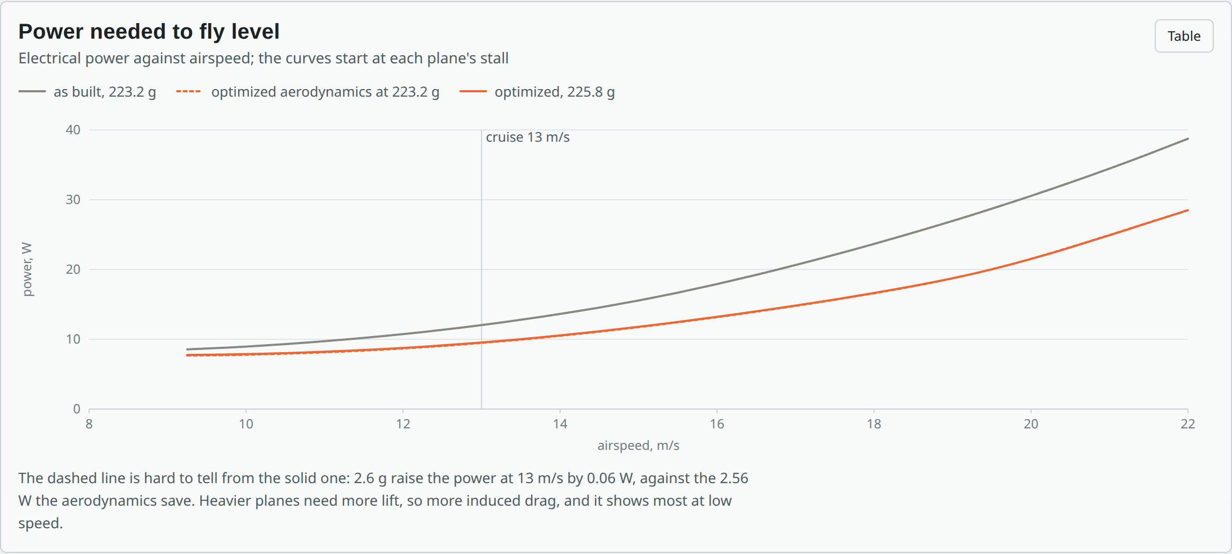
airframe/variants/figures/power.png
