henriharmaala1-source/Assembly-grapher/airframe/variants/figures/single-cg.png

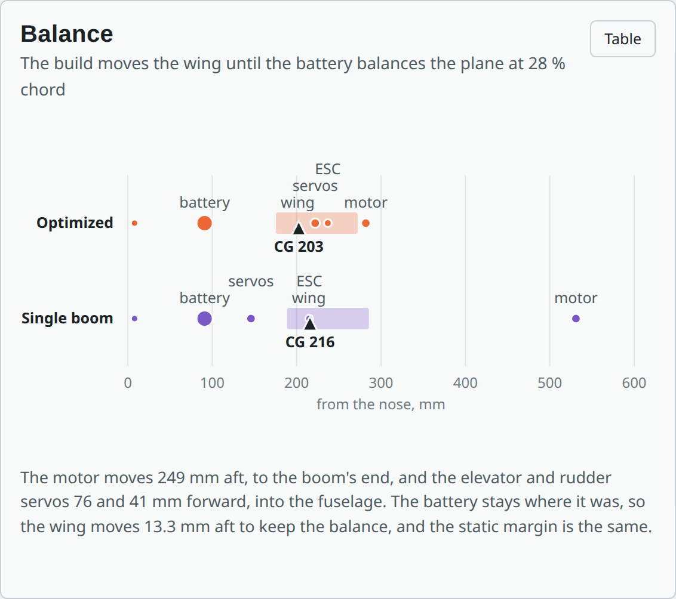
airframe/variants/figures/single-cg.png
