henriharmaala1-source/Assembly-grapher/airframe/variants/figures/single-mass.png

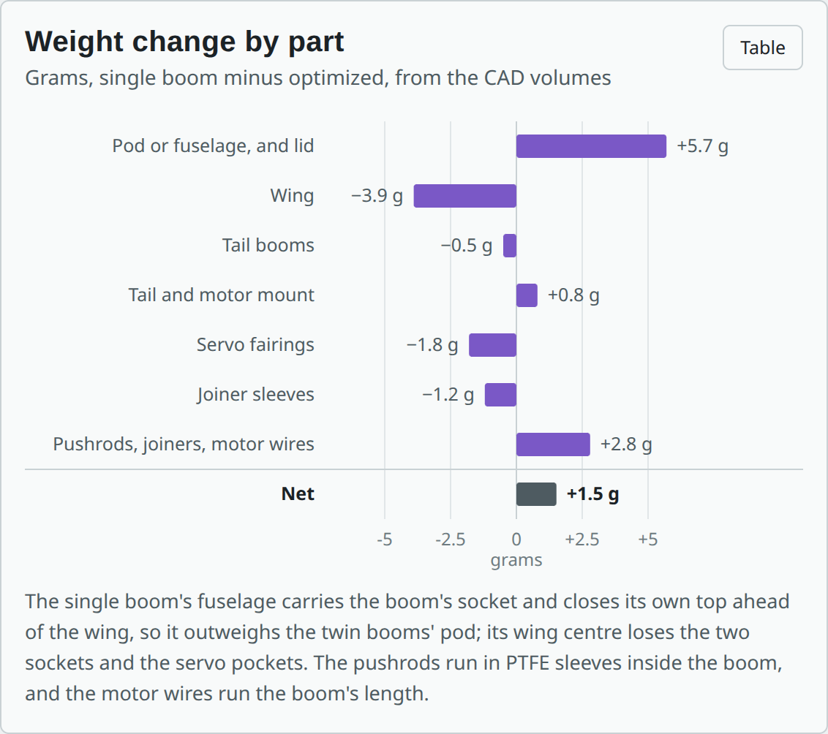
airframe/variants/figures/single-mass.png
