henriharmaala1-source/Assembly-grapher/airframe/variants/figures/single-models-boom.png

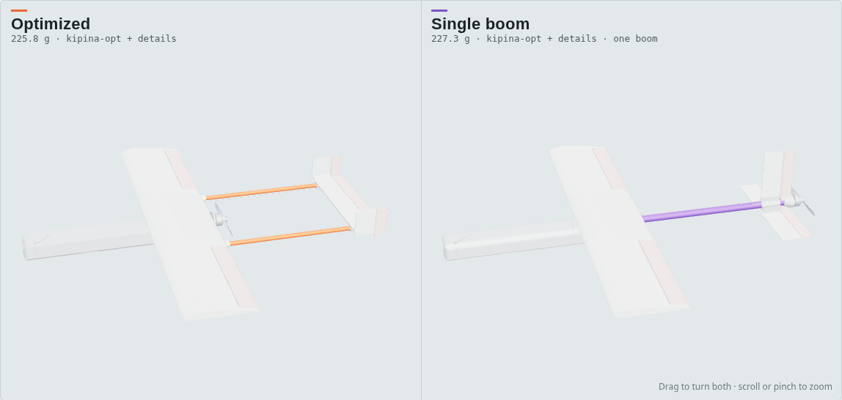
airframe/variants/figures/single-models-boom.png
