henriharmaala1-source/Assembly-grapher/airframe/variants/figures/single-models-centre.png

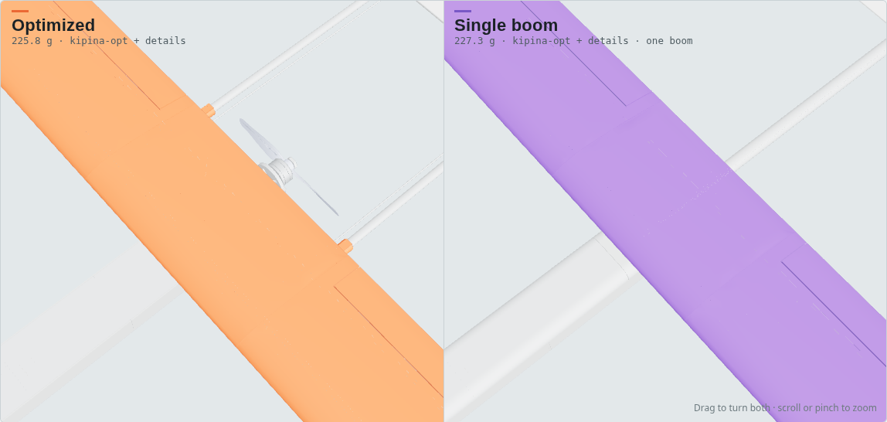
airframe/variants/figures/single-models-centre.png
