henriharmaala1-source/Assembly-grapher/airframe/variants/figures/single-models-fuselage.png

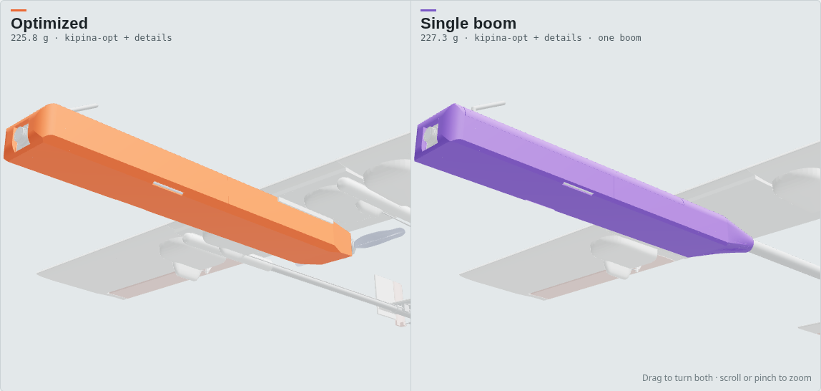
airframe/variants/figures/single-models-fuselage.png
