henriharmaala1-source/Assembly-grapher/airframe/variants/figures/single-models-motor.png

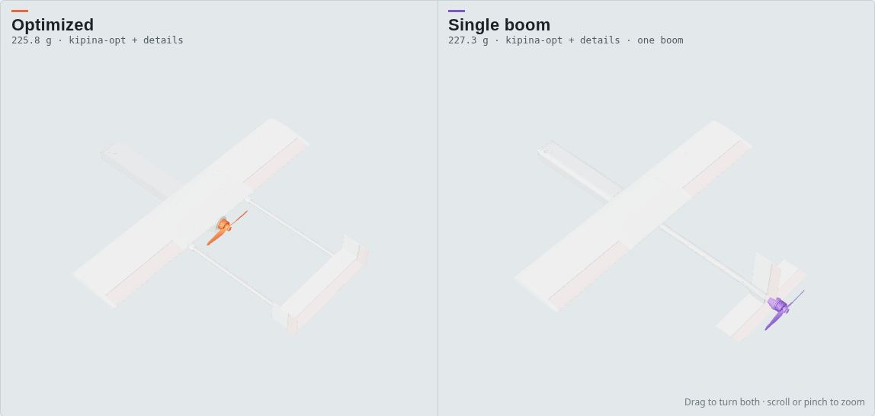
airframe/variants/figures/single-models-motor.png
