henriharmaala1-source/Assembly-grapher/airframe/variants/figures/single-power.png

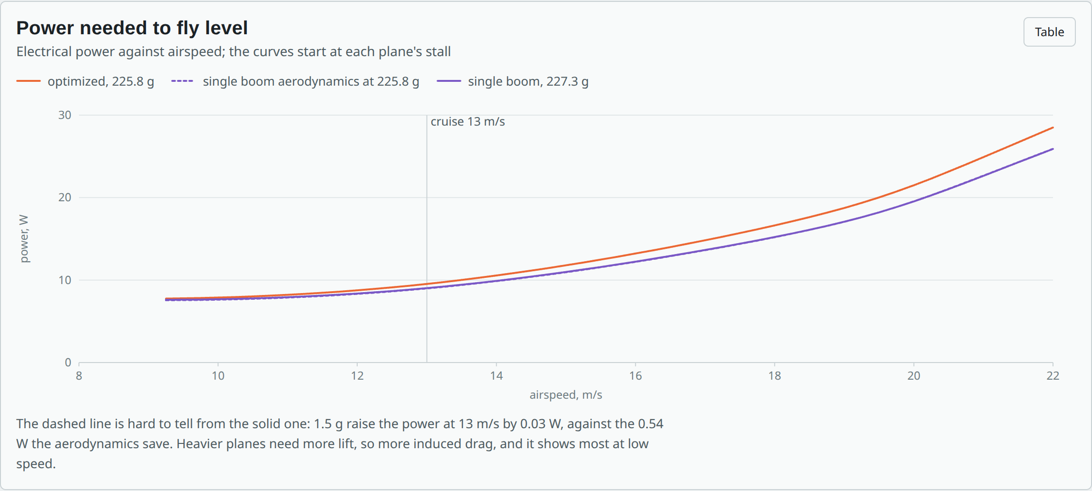
airframe/variants/figures/single-power.png
