henriharmaala1-source/Assembly-grapher/airframe/variants/figures/single-summary.png

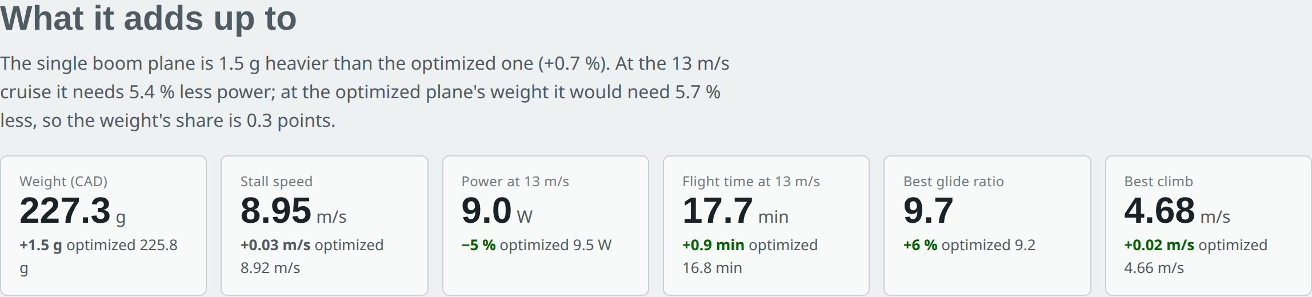
airframe/variants/figures/single-summary.png
