henriharmaala1-source/Assembly-grapher/airframe/variants/figures/single-sw-climb.png

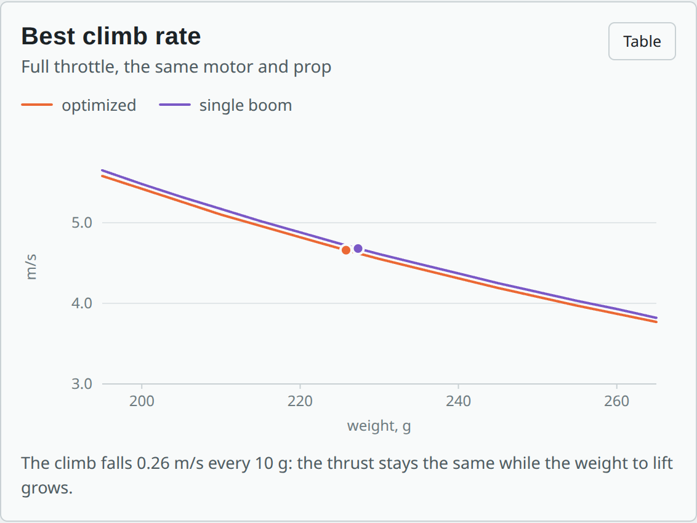
airframe/variants/figures/single-sw-climb.png
