henriharmaala1-source/Assembly-grapher/airframe/variants/figures/single-sw-long.png

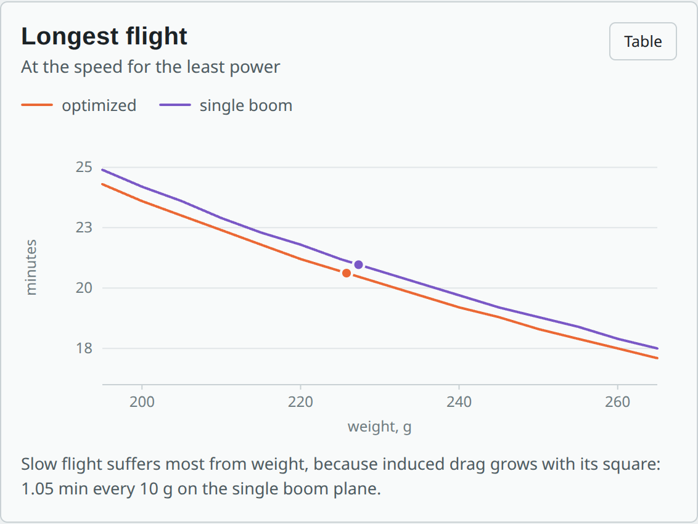
airframe/variants/figures/single-sw-long.png
