henriharmaala1-source/Assembly-grapher/airframe/variants/figures/single-sw-stall.png

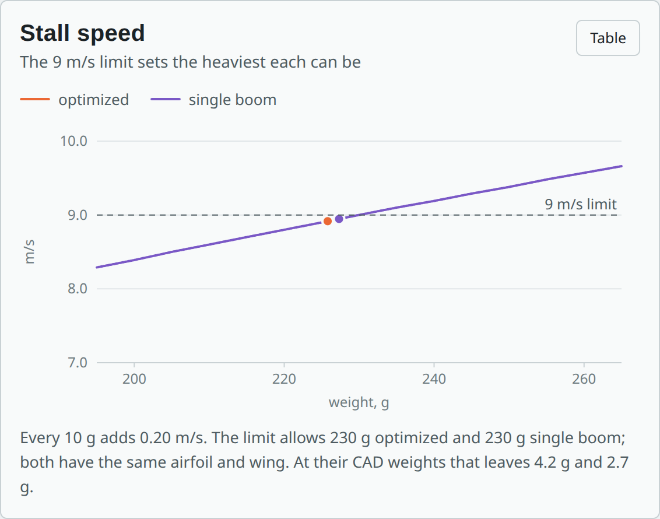
airframe/variants/figures/single-sw-stall.png
