henriharmaala1-source/Assembly-grapher/airframe/variants/figures/single-sw-time.png

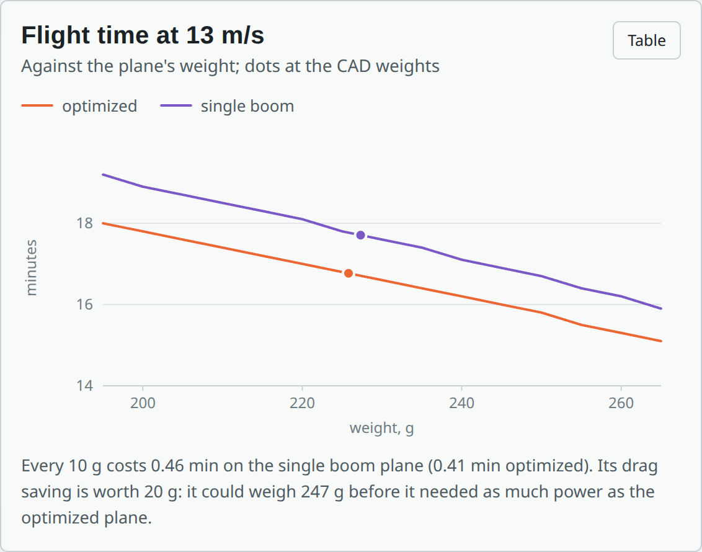
airframe/variants/figures/single-sw-time.png
