henriharmaala1-source/Assembly-grapher/airframe/variants/figures/sw-climb.png

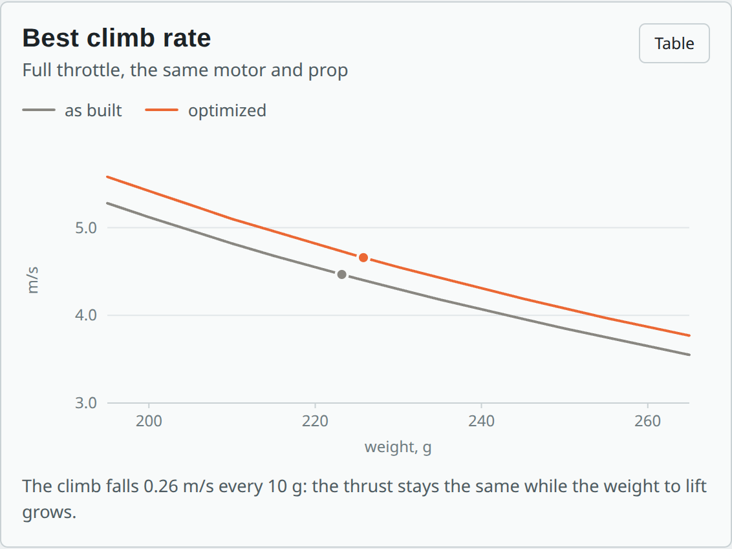
airframe/variants/figures/sw-climb.png
