henriharmaala1-source/Assembly-grapher/airframe/variants/figures/sw-long.png

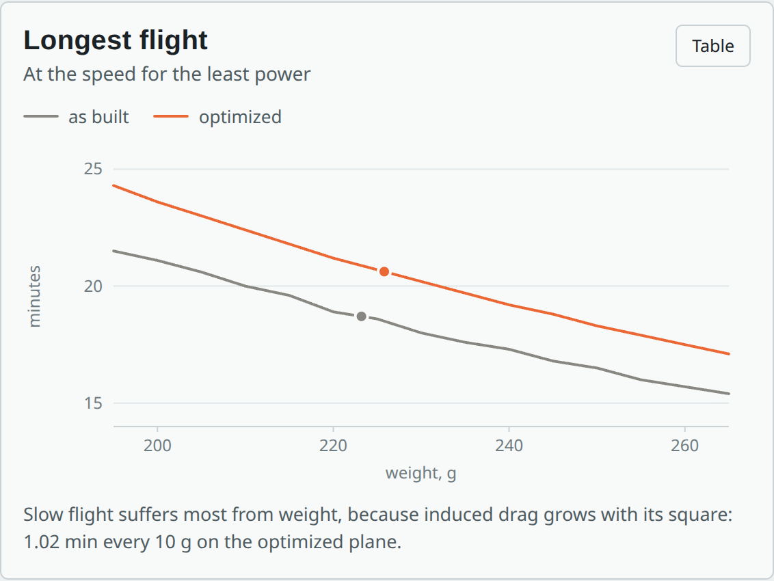
airframe/variants/figures/sw-long.png
