henriharmaala1-source/Assembly-grapher/airframe/variants/figures/sw-stall.png

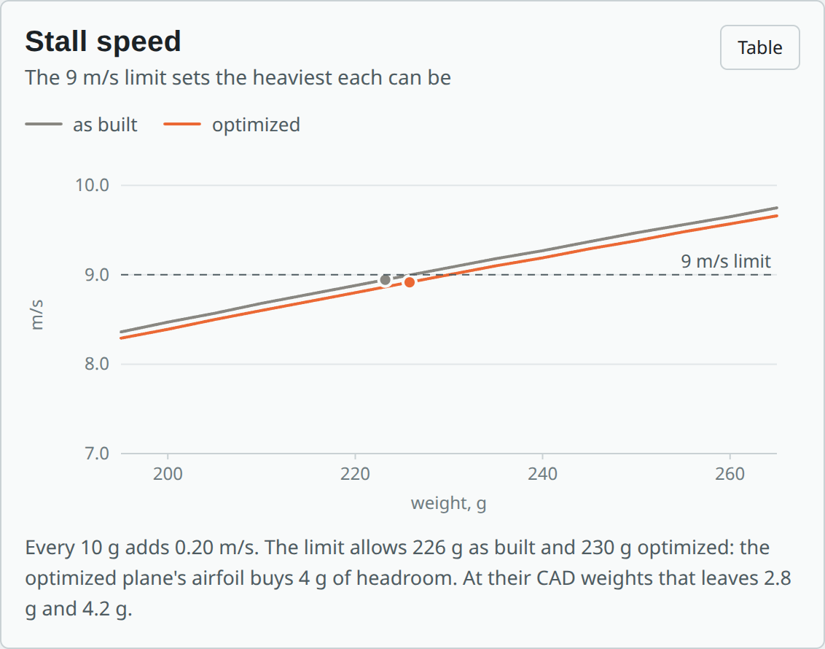
airframe/variants/figures/sw-stall.png
