henriharmaala1-source/Assembly-grapher/airframe/variants/single-boom-mini/preview/top.png

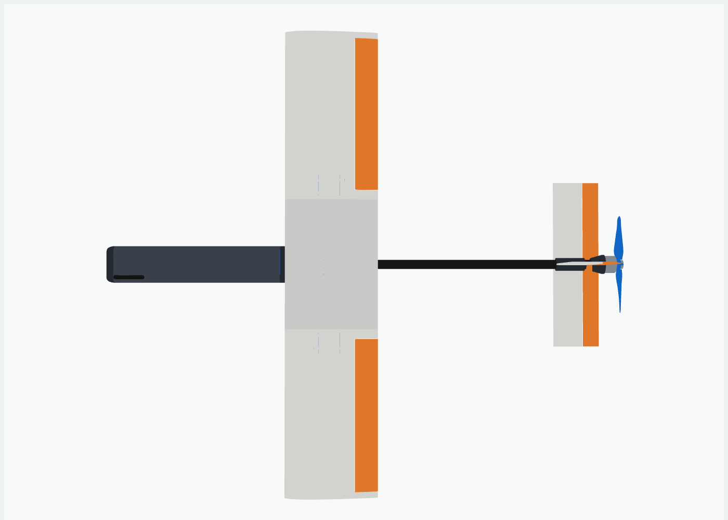
airframe/variants/single-boom-mini/preview/top.png
