henriharmaala1-source/Assembly-grapher/airframe/variants/single-boom-mini/preview/under.png

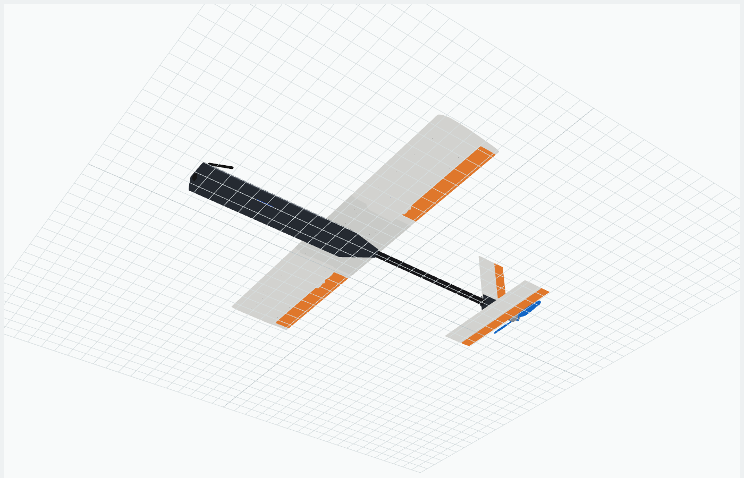
airframe/variants/single-boom-mini/preview/under.png
