henriharmaala1-source/Assembly-grapher/frames/mark4-v2-10/hardware/hardware.png

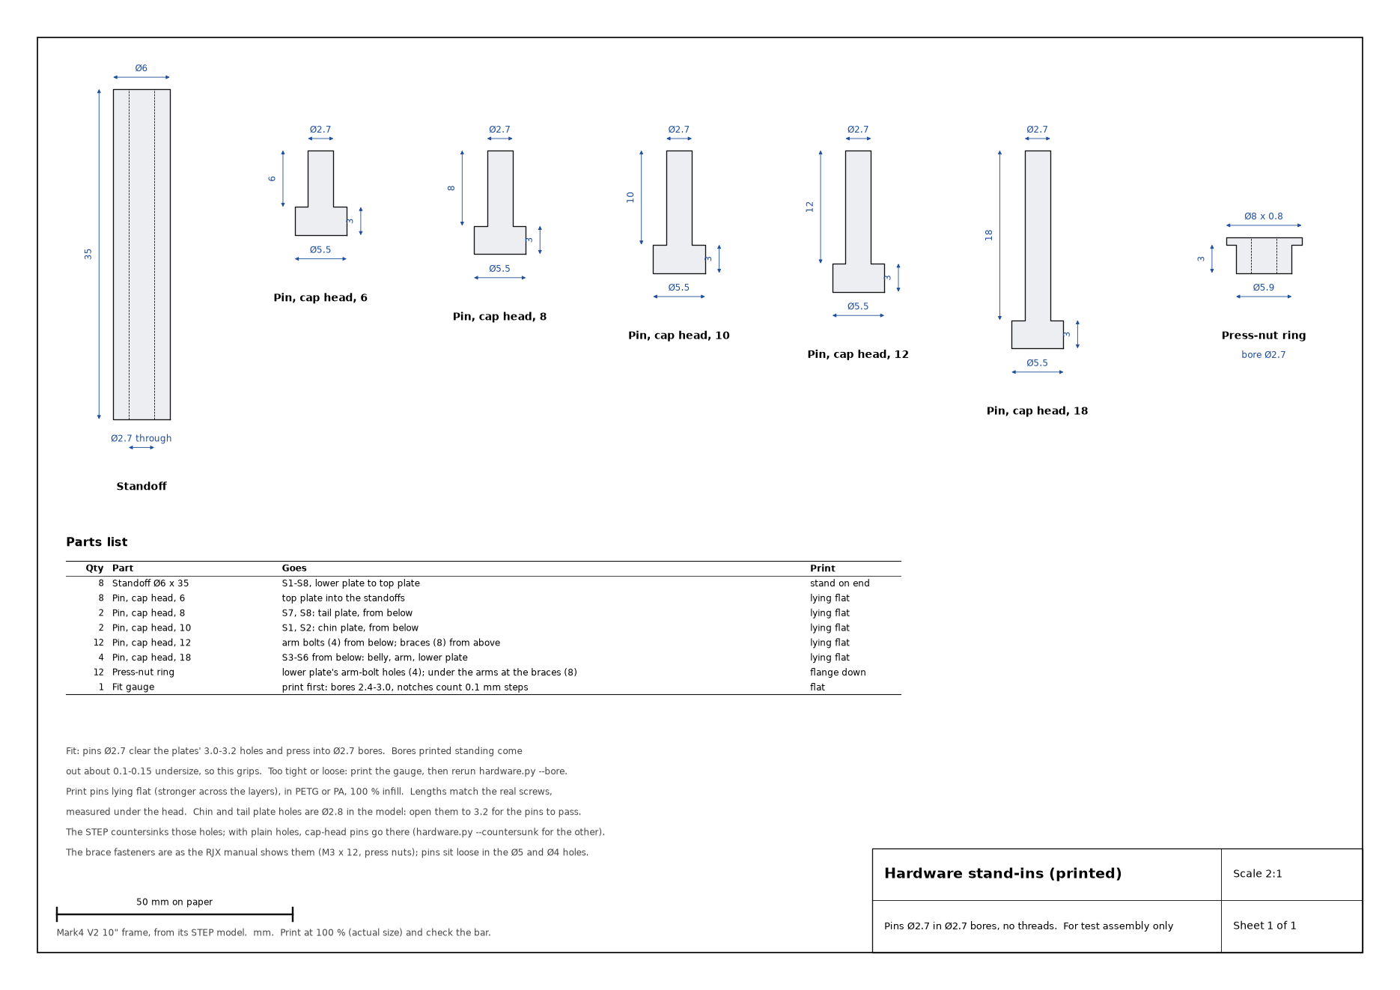
frames/mark4-v2-10/hardware/hardware.png
