henriharmaala1-source/Assembly-grapher/frames/mark4-v2-10/sheets/1_overview.png

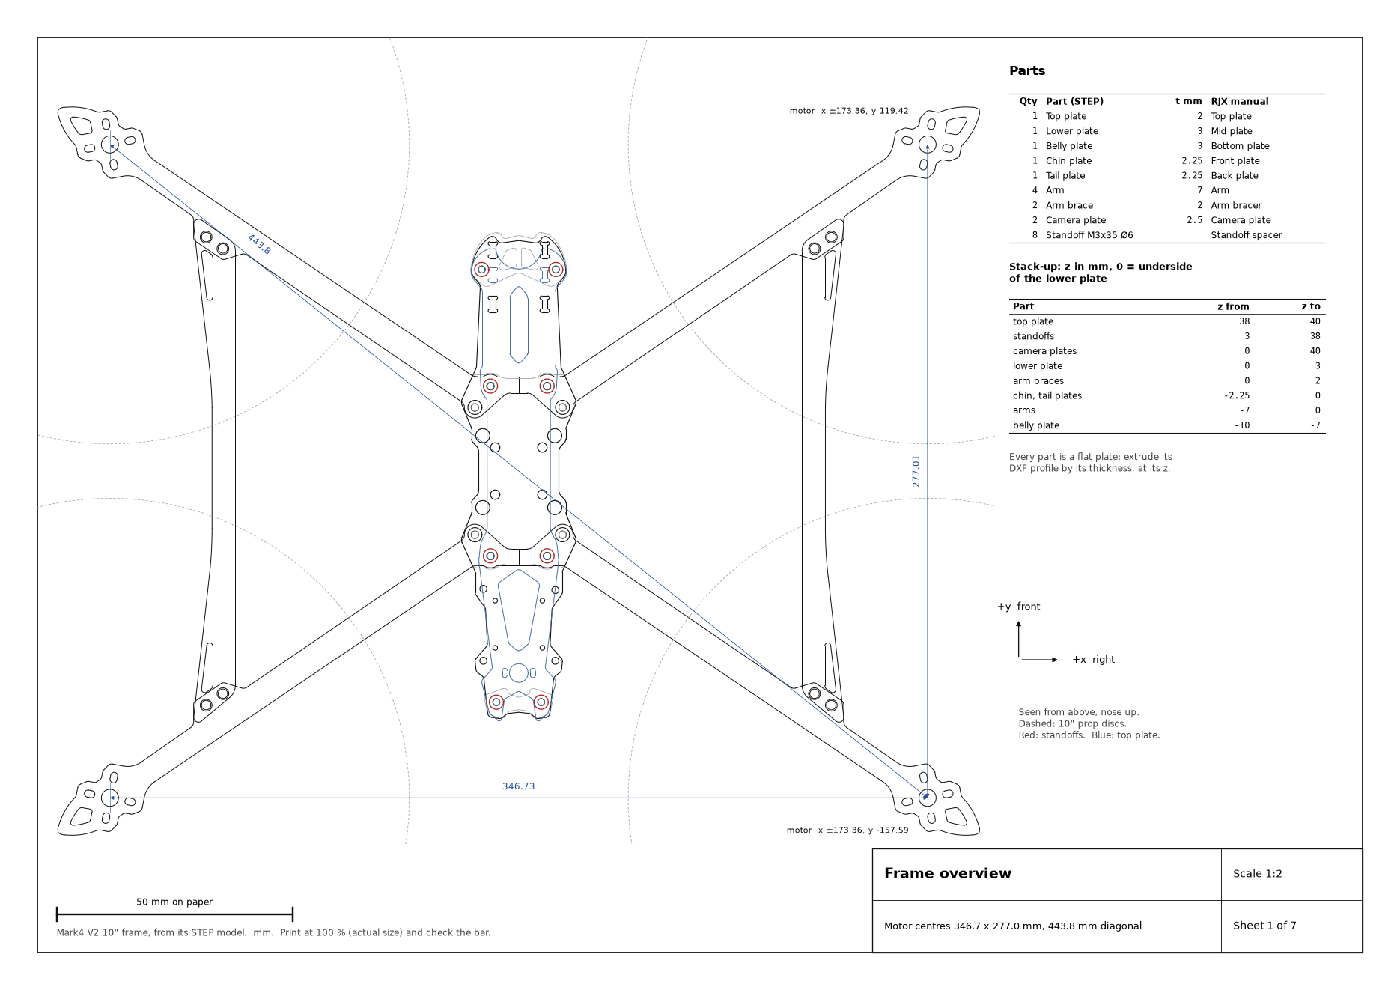
frames/mark4-v2-10/sheets/1_overview.png
