henriharmaala1-source/Assembly-grapher/frames/mark4-v2-10/sheets/3_top_plate.png

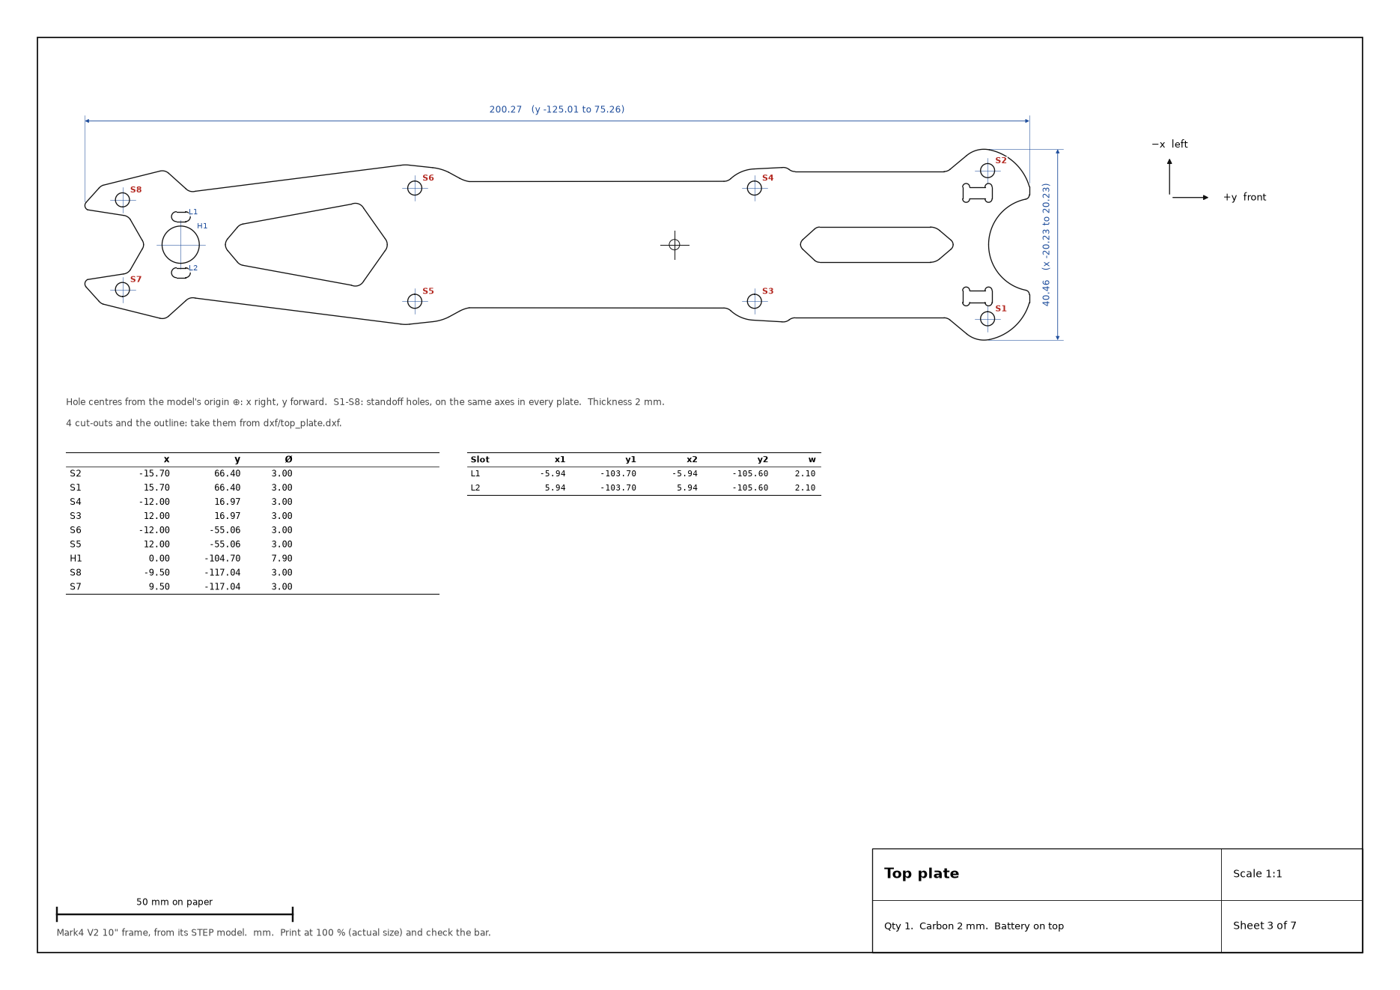
frames/mark4-v2-10/sheets/3_top_plate.png
