henriharmaala1-source/Assembly-grapher/frames/mark4-v2-10/sheets/4_lower_plate.png

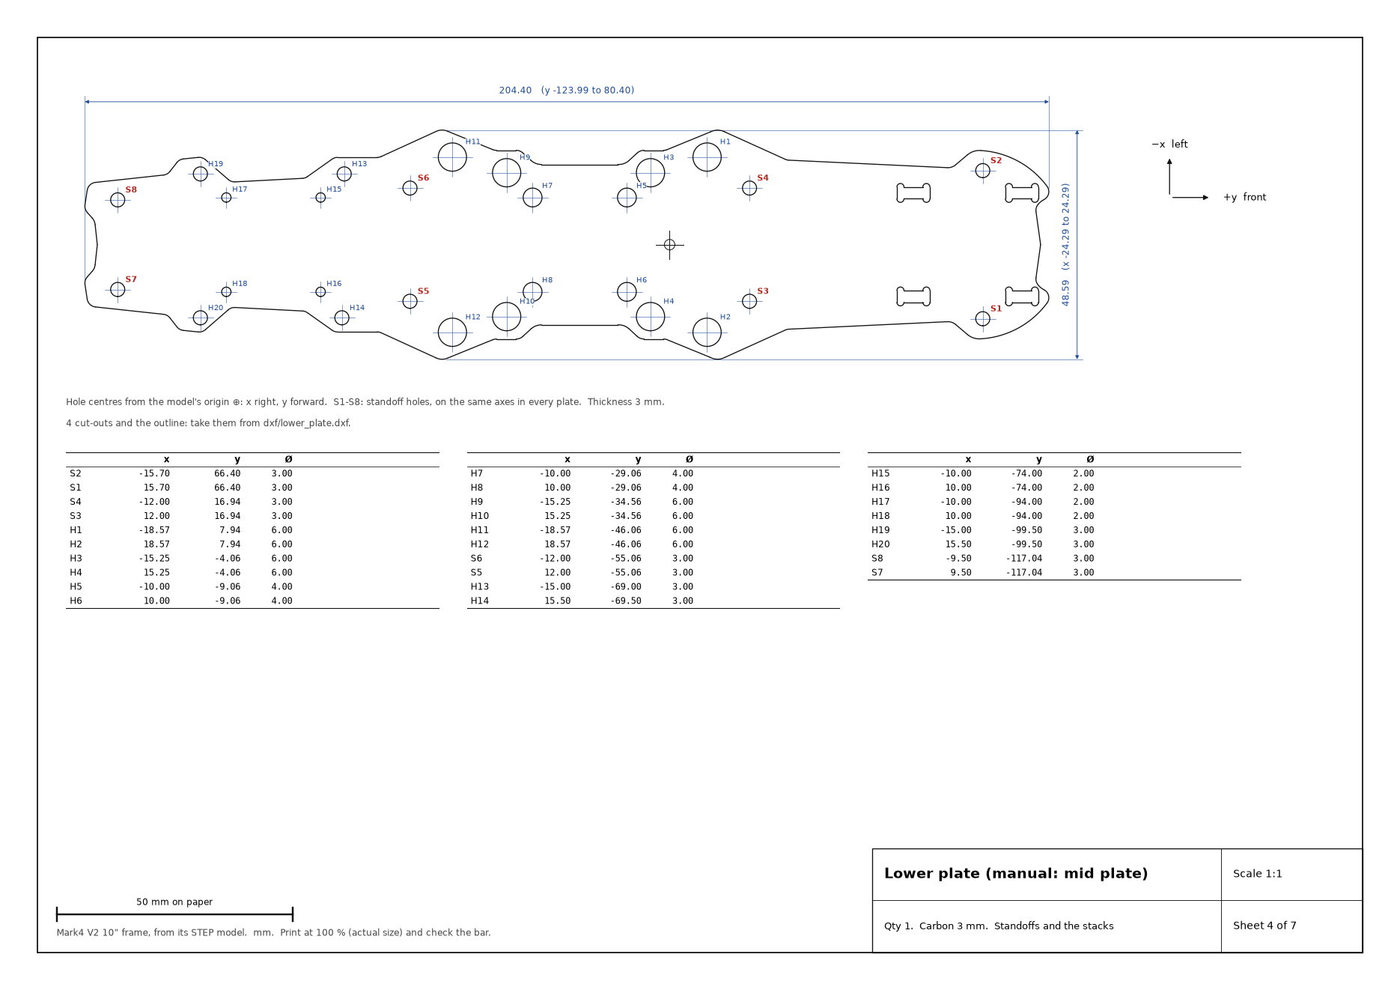
frames/mark4-v2-10/sheets/4_lower_plate.png
