henriharmaala1-source/Assembly-grapher/frames/mark4-v2-10/sheets/5_belly_chin_tail.png

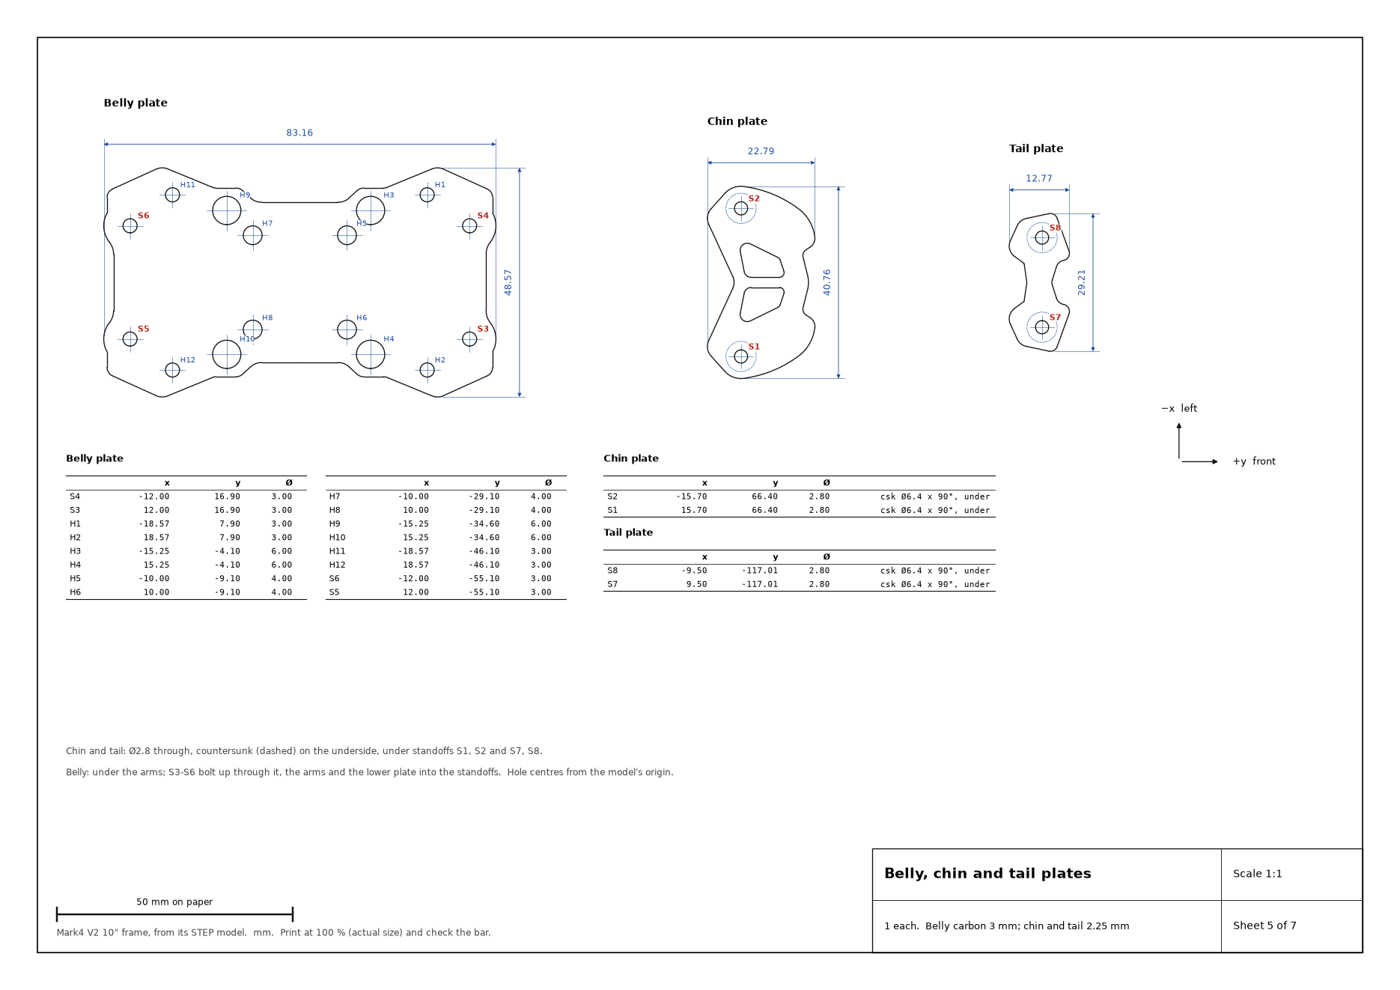
frames/mark4-v2-10/sheets/5_belly_chin_tail.png
