henriharmaala1-source/Assembly-grapher/frames/mark4-v2-10/sheets/6_arm.png

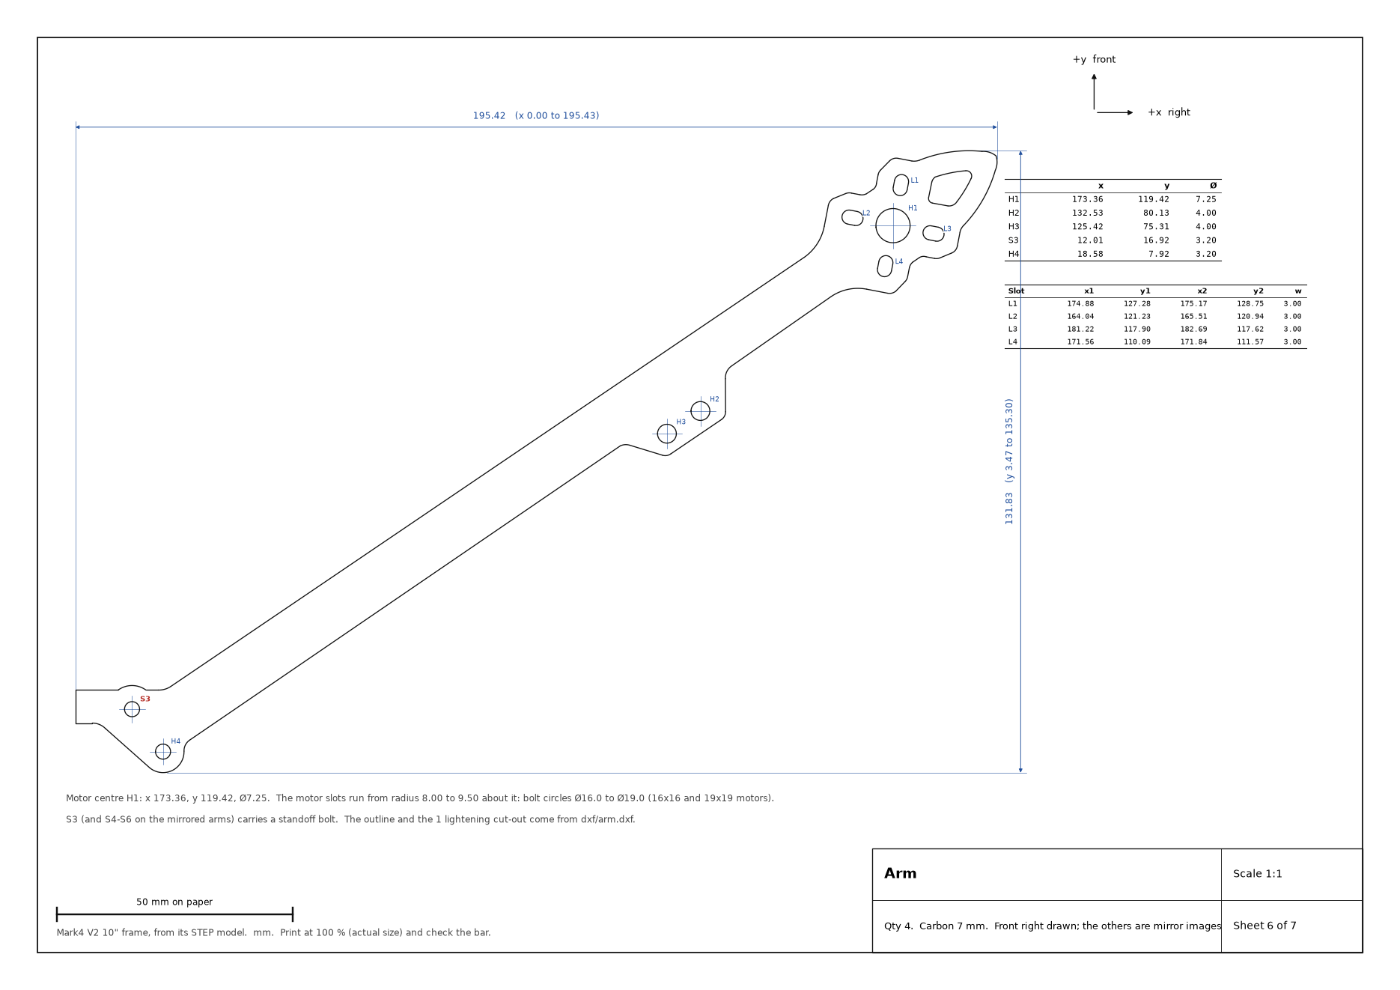
frames/mark4-v2-10/sheets/6_arm.png
