henriharmaala1-source/Assembly-grapher/frames/mark4-v2-10/sheets/7_brace_camera.png

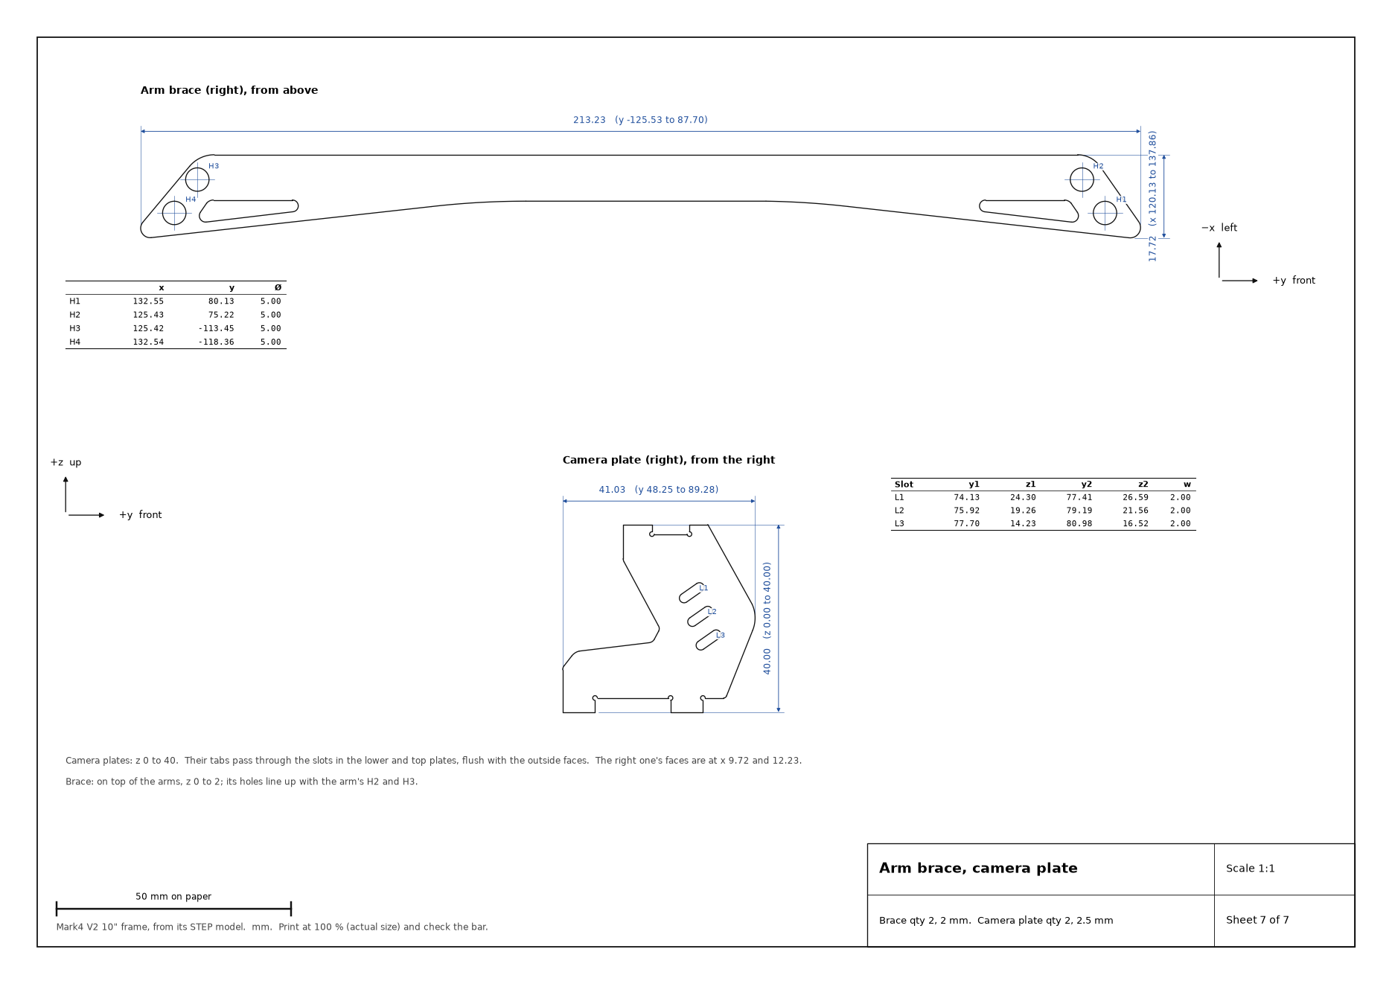
frames/mark4-v2-10/sheets/7_brace_camera.png
