henriharmaala1-source/Assembly-grapher/frames/mark4-v2-10/sketch/modified_arm.png

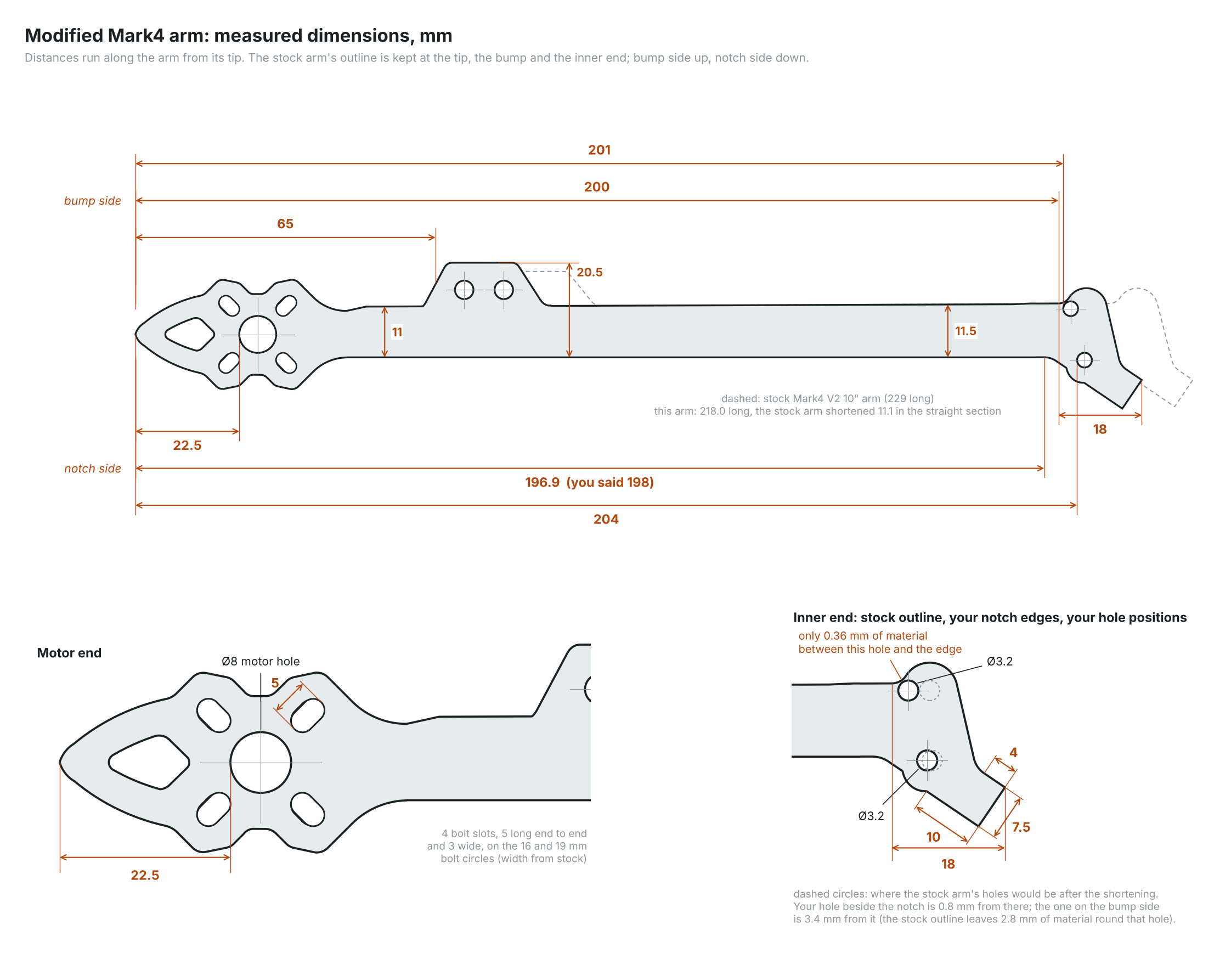
frames/mark4-v2-10/sketch/modified_arm.png
