henriharmaala1-source/Assembly-grapher/frames/mark4-v2-10/trace/arm_brace.png

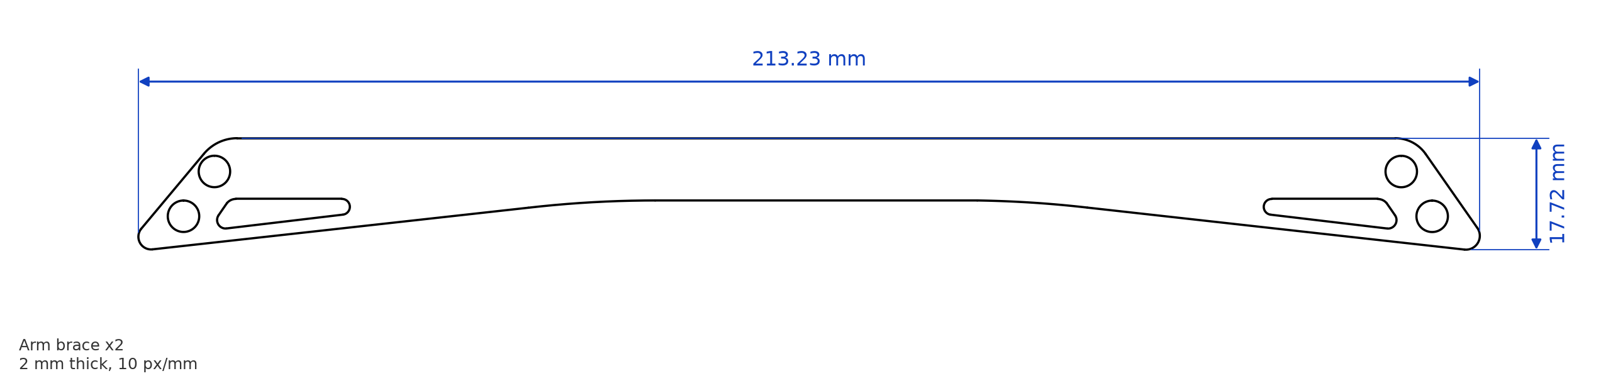
frames/mark4-v2-10/trace/arm_brace.png
