henriharmaala1-source/Assembly-grapher/frames/mark4-v2-10/trace/lower_plate.png

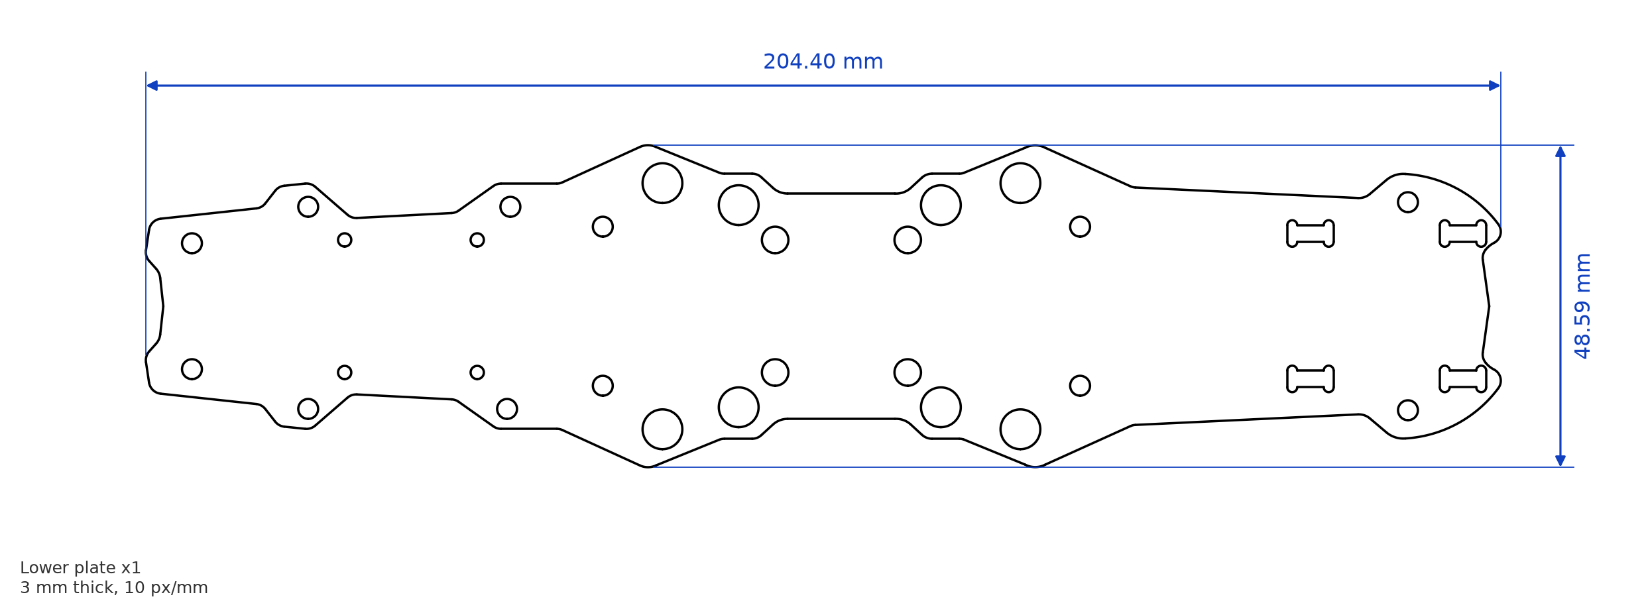
frames/mark4-v2-10/trace/lower_plate.png
