henriharmaala1-source/Assembly-grapher/frames/mark4-v2-10/trace/tail_plate.png

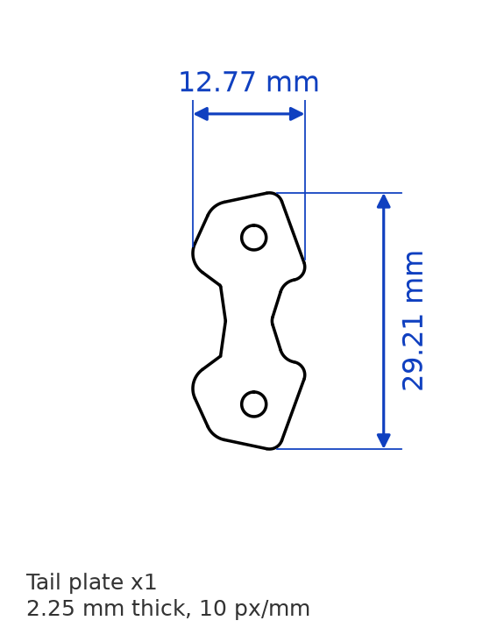
frames/mark4-v2-10/trace/tail_plate.png
