henriharmaala1-source/Assembly-grapher/airframe/variants/single-boom-mini/stl/rod_spar_main_R.stl

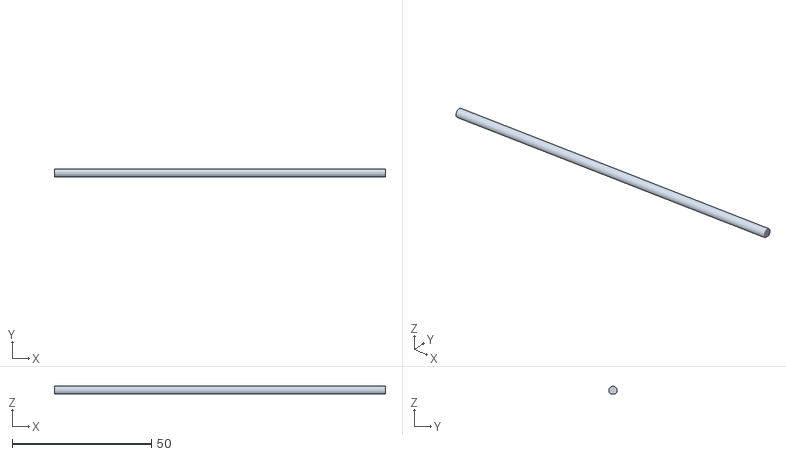
[picture p121: CAD file, 2026-10-25]
airframe/variants/single-boom-mini/stl/rod_spar_main_R.stl
118.7 x 3.00 x 2.70
