henriharmaala1-source/Assembly-grapher/frames/mark4-v2-10/hardware/assembly.step

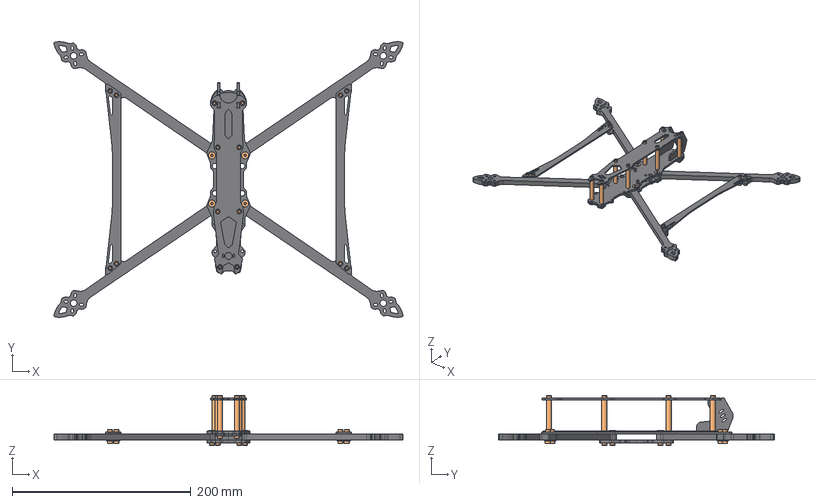
[picture p122: CAD file, 2026-10-09]
frames/mark4-v2-10/hardware/assembly.step
390.9 x 308.8 x 56.0 mm
Top_Plate
Lower_Plate
Tail_Plate
Chin_Plate
Belly_Plate
10in_Arm
10in_Arm001
10in_Arm002
10in_Arm003
Arm_Brace002
Arm_Brace001
Cam_plate
Cam_plate001
standoff_1
pin_cap_m3x6_2
standoff_3
pin_cap_m3x6_4
standoff_5
pin_cap_m3x6_6
standoff_7
pin_cap_m3x6_8
standoff_9
pin_cap_m3x6_10
standoff_11
pin_cap_m3x6_12
standoff_13
pin_cap_m3x6_14
standoff_15
pin_cap_m3x6_16
pin_cap_m3x10_17
pin_cap_m3x10_18
pin_cap_m3x8_19
pin_cap_m3x8_20
pin_cap_m3x18_21
pin_cap_m3x18_22
pin_cap_m3x18_23
pin_cap_m3x18_24
pin_cap_m3x12_25
nut_26
pin_cap_m3x12_27
nut_28
pin_cap_m3x12_29
nut_30
pin_cap_m3x12_31
nut_32
pin_cap_m3x12_33
nut_34
pin_cap_m3x12_35
nut_36
pin_cap_m3x12_37
nut_38
pin_cap_m3x12_39
nut_40
pin_cap_m3x12_41
nut_42
pin_cap_m3x12_43
nut_44
pin_cap_m3x12_45
nut_46
pin_cap_m3x12_47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
