henriharmaala1-source/Assembly-grapher/frames/mark4-v2-10/dxf/assembly_top.dxf

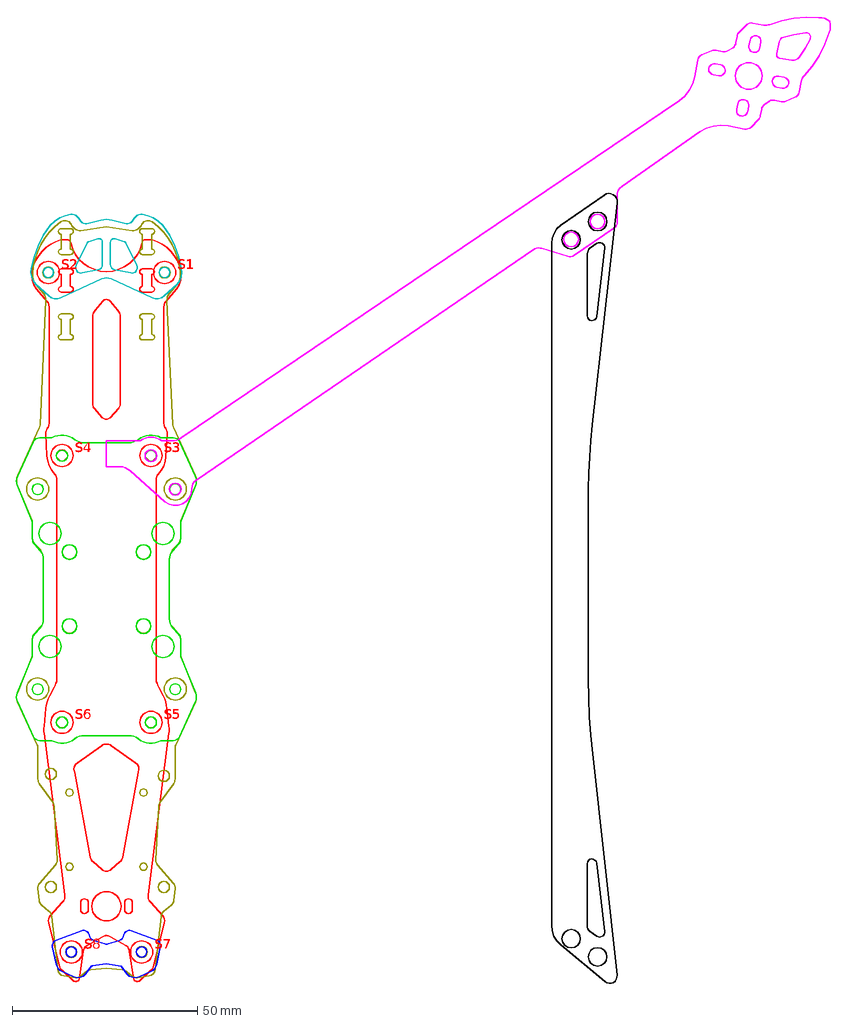
[picture p123: CAD file, 2026-10-09]
frames/mark4-v2-10/dxf/assembly_top.dxf
S1
S2
S3
S4
S5
S6
S7
S8
