henriharmaala1-source/Assembly-grapher/airframe/cad/airframe.step

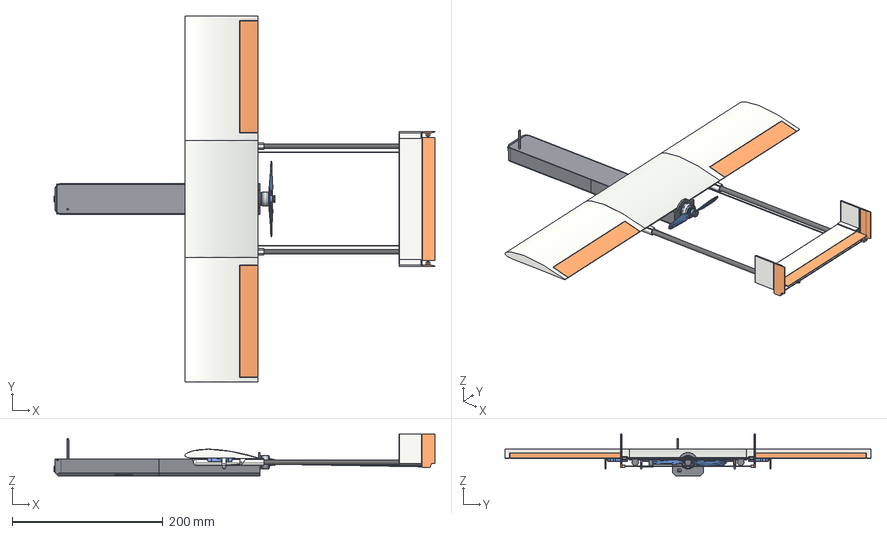
[picture p124: CAD file, 2026-10-25]
airframe/cad/airframe.step
505.5 x 485.0 x 55.3 mm
wing_centre
wing_R
wing_L
aileron_R
aileron_L
tail_mount
stab
elevator
fin_R
fin_L
rudder_R
rudder_L
bellcrank
lid
pod_front
pod_rear
tube_L
tube_R
spar_main
spar_rear
pushrod_elev
pushrod_rud
joiner_R
joiner_L
horn_ail_R
pushrod_ail_R
horn_ail_L
pushrod_ail_L
motor
motor_base
motor_coil
motor_shaft
motor_nut
prop
camera
camera_lens
camera_pcb
camera_pads
vtx
vtx_chips
vtx_pads
vtx_conn
antenna
antenna_conn
fc
fc_chips
fc_metal
fc_jst
fc_pads
receiver
receiver_chips
receiver_pads
esc
esc_chips
esc_conn
esc_pads
esc_wires
battery
battery_leads
battery_xt30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
