henriharmaala1-source/Assembly-grapher/airframe/stl/lid.stl

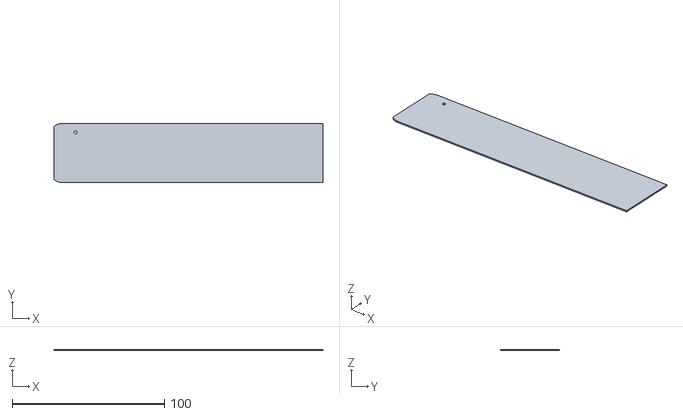
[picture p125: CAD file, 2026-10-25]
airframe/stl/lid.stl
176.8 x 38.8 x 0.8
