henriharmaala1-source/Assembly-grapher/airframe/variants/optimized/stl/aileron_L.stl

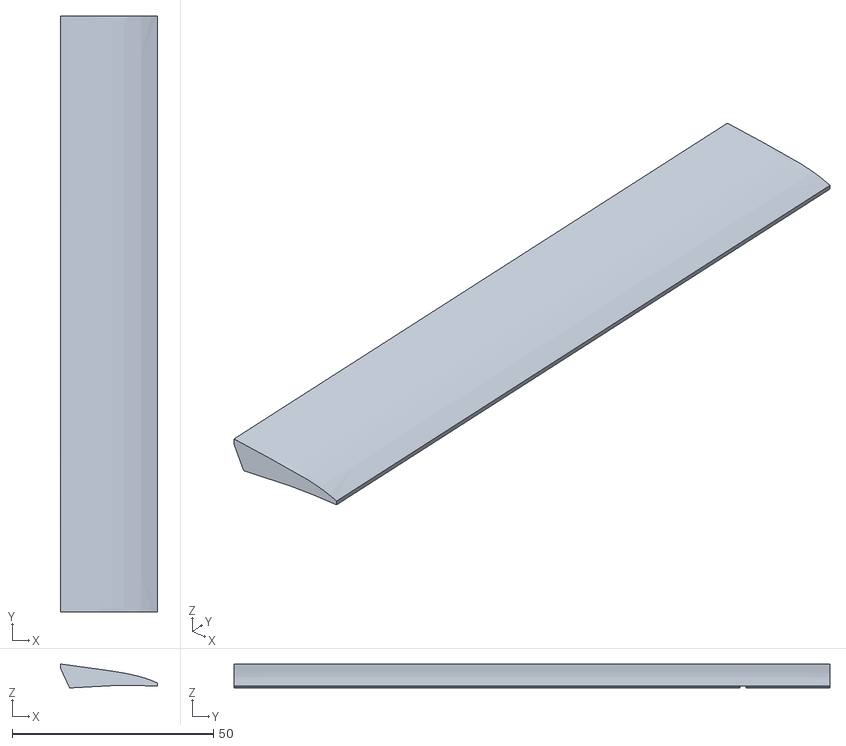
[picture p127: CAD file, 2026-10-25]
airframe/variants/optimized/stl/aileron_L.stl
24.1 x 148.1 x 5.96
