henriharmaala1-source/Assembly-grapher/airframe/variants/single-boom-mini/cad/mini.step

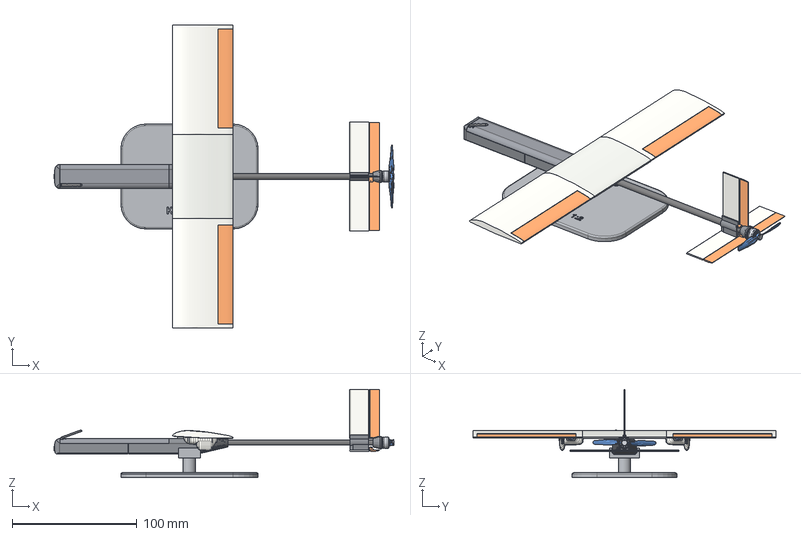
[picture p128: CAD file, 2026-10-25]
airframe/variants/single-boom-mini/cad/mini.step
272.3 x 242.5 x 70.8 mm
wing_centre
wing_R
wing_L
aileron_R
aileron_L
tail_mount
stab
elevator
fin
rudder
motor_mount
fairing_ail_R
fairing_ail_L
fuselage_front
fuselage_rear
lid
dummy_servo_ail_R
dummy_servo_ail_L
dummy_servo_elev
dummy_servo_rud
dummy_motor
dummy_prop
dummy_camera
dummy_vtx
dummy_antenna
dummy_fc
dummy_receiver
dummy_esc
dummy_battery
rod_boom
rod_spar_main_R
rod_spar_main_L
rod_spar_rear_R
rod_spar_rear_L
stand
