henriharmaala1-source/Assembly-grapher/airframe/variants/single-boom/stl/tail_mount.stl

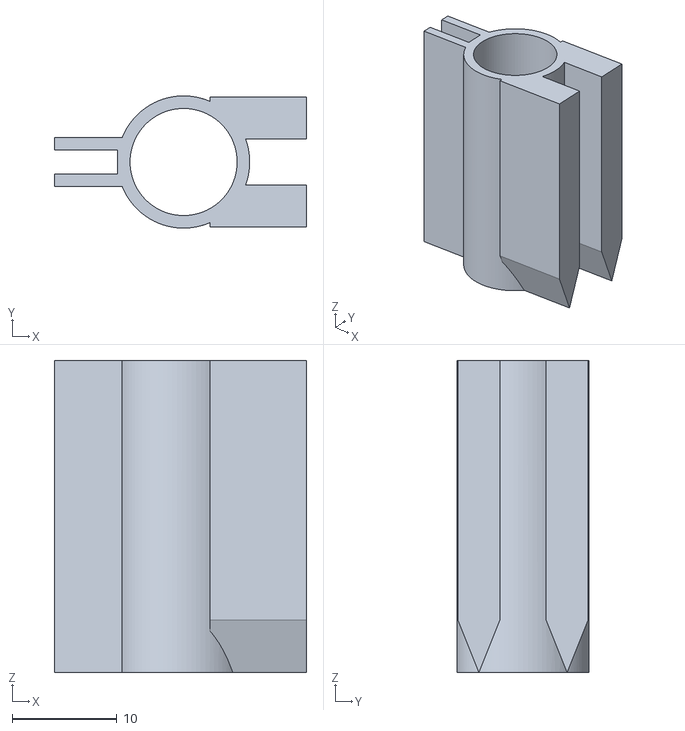
[picture p129: CAD file, 2026-10-25]
airframe/variants/single-boom/stl/tail_mount.stl
24.0 x 12.6 x 29.7
