henriharmaala1-source/Assembly-grapher/frames/mark4-v2-10/dxf/tail_plate.dxf

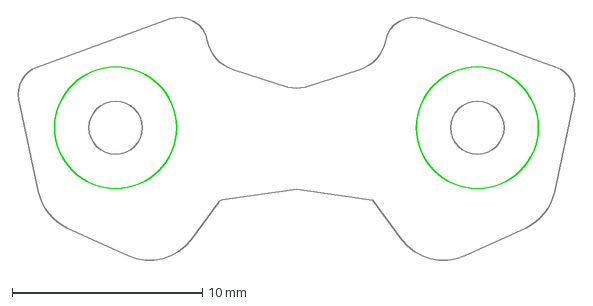
[picture p130: CAD file, 2026-10-09]
frames/mark4-v2-10/dxf/tail_plate.dxf
29.5 x 13.1 mm
