henriharmaala1-source/Assembly-grapher/frames/mark4-v2-10/hardware/standoff.step

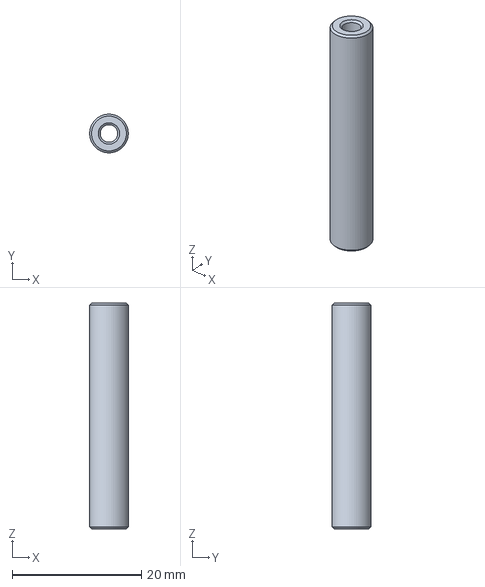
[picture p131: CAD file, 2026-10-09]
frames/mark4-v2-10/hardware/standoff.step
5.99 x 6.00 x 35.0 mm
