henriharmaala1-source/Assembly-grapher/frames/mark4-v2-10/sketch/modified_arm.dxf

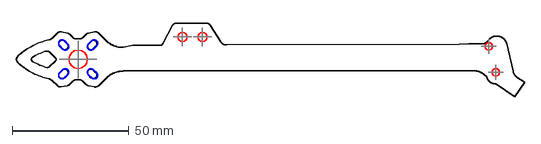
[picture p132: CAD file, 2026-11-02]
frames/mark4-v2-10/sketch/modified_arm.dxf
218.0 x 31.6 mm
