henriharmaala1-source/Assembly-grapher/frames/mark4-v2-10/source/mark4_v2_10in.step

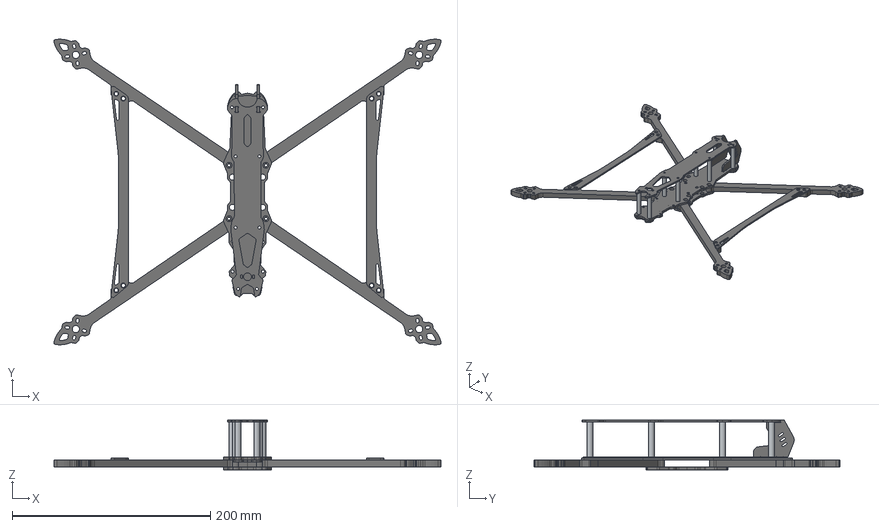
[picture p133: CAD file, 2026-10-08]
frames/mark4-v2-10/source/mark4_v2_10in.step
390.9 x 308.8 x 50.0 mm
Top Plate
Lower Plate
Tail Plate
Chin Plate
Belly Plate
10in Arm
10in Arm001
10in Arm002
10in Arm003
Arm Brace002
Arm Brace001
Cam plate
Cam plate001
M3 35mm Standoff001
M3 35mm Standoff002
M3 35mm Standoff003
M3 35mm Standoff004
M3 35mm Standoff005
M3 35mm Standoff006
M3 35mm Standoff007
M3 35mm Standoff008
