henriharmaala1-source/Assembly-grapher/airframe/stl/elevator.stl

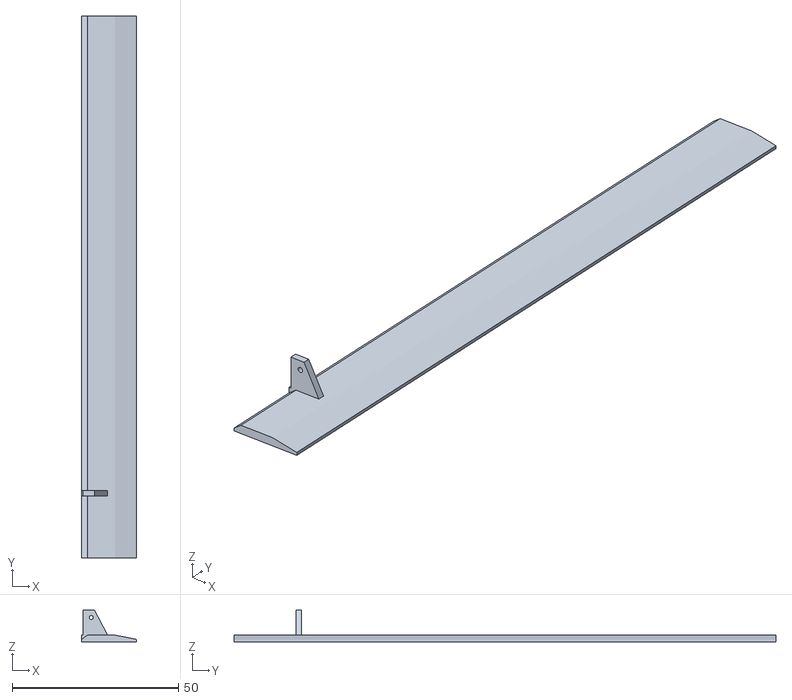
[picture p134: CAD file, 2026-09-29]
airframe/stl/elevator.stl
16.7 x 163.0 x 9.50
