henriharmaala1-source/Assembly-grapher/airframe/variants/optimized/stl/wing_R.stl

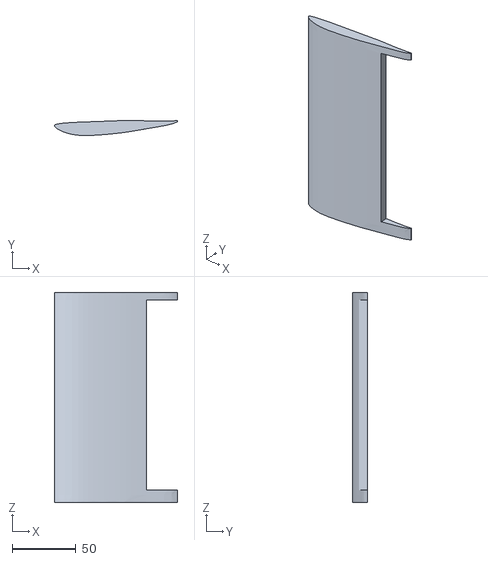
[picture p135: CAD file, 2026-10-25]
airframe/variants/optimized/stl/wing_R.stl
97.0 x 11.8 x 165.1
