henriharmaala1-source/Assembly-grapher/airframe/variants/single-boom-mini/stl/wing_R.stl

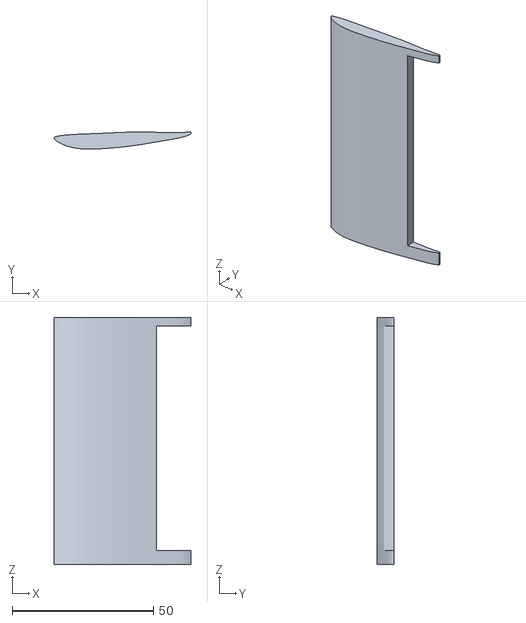
[picture p136: CAD file, 2026-10-25]
airframe/variants/single-boom-mini/stl/wing_R.stl
48.5 x 6.13 x 87.5
