henriharmaala1-source/Assembly-grapher/airframe/variants/single-boom/stl/aileron_L.stl

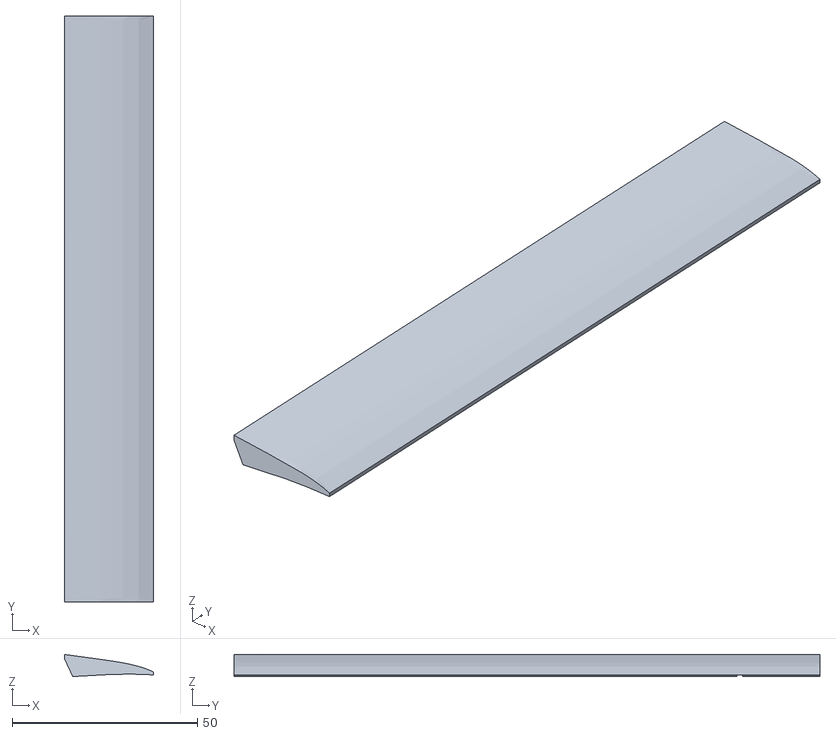
[picture p137: CAD file, 2026-10-25]
airframe/variants/single-boom/stl/aileron_L.stl
24.1 x 158.0 x 5.96
