henriharmaala1-source/Assembly-grapher/frames/mark4-v2-10/dxf/cam_plate.dxf

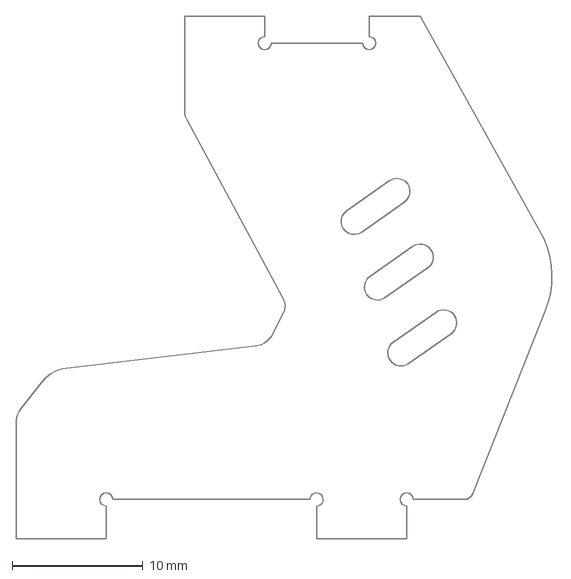
[picture p138: CAD file, 2026-10-09]
frames/mark4-v2-10/dxf/cam_plate.dxf
41.2 x 40.0 mm
