henriharmaala1-source/Assembly-grapher/airframe/stl/aileron_L.stl

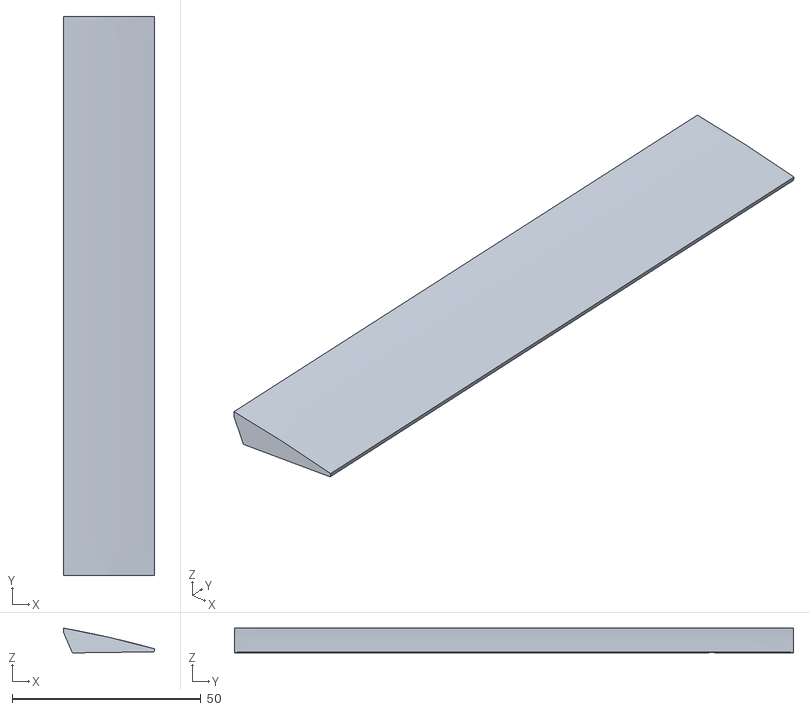
[picture p139: CAD file, 2026-09-29]
airframe/stl/aileron_L.stl
24.1 x 148.1 x 6.58
