henriharmaala1-source/Assembly-grapher/airframe/variants/extreme/stl/tail_mount.stl

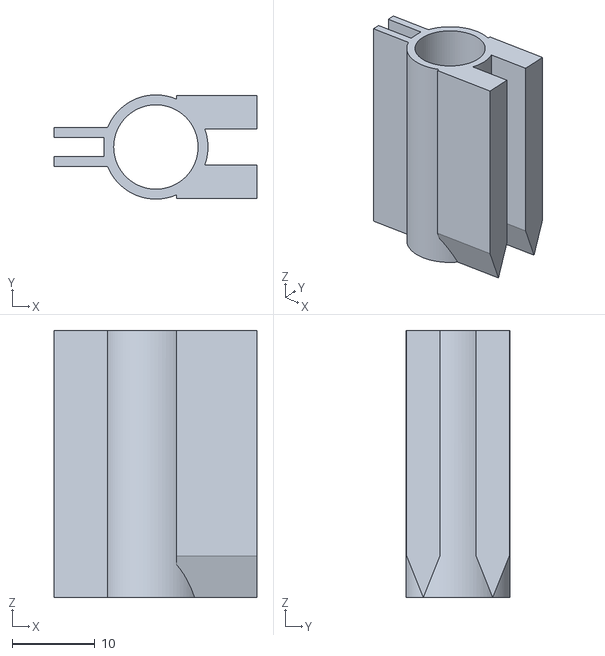
[picture p140: CAD file, 2026-10-25]
airframe/variants/extreme/stl/tail_mount.stl
24.5 x 12.6 x 32.3
