henriharmaala1-source/Assembly-grapher/airframe/variants/optimized/stl/fairing_rud.stl

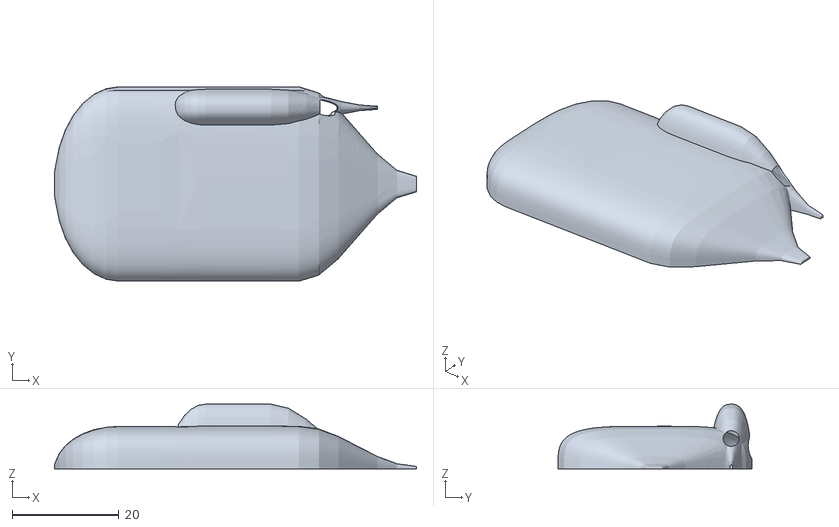
[picture p141: CAD file, 2026-10-25]
airframe/variants/optimized/stl/fairing_rud.stl
67.9 x 36.4 x 12.1
