henriharmaala1-source/Assembly-grapher/airframe/variants/single-boom-mini/stl/dummy_servo_elev.stl

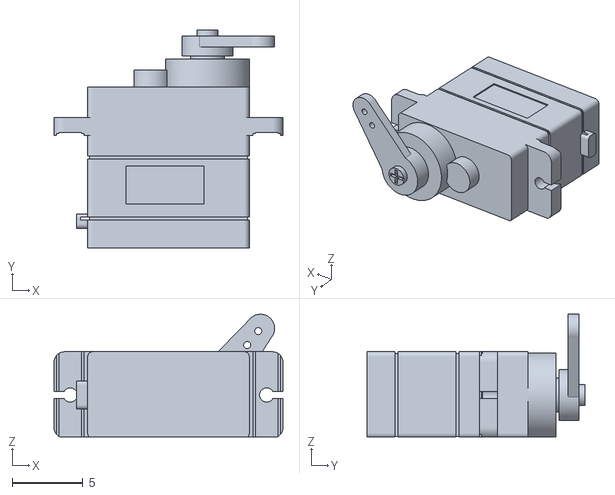
[picture p142: CAD file, 2026-10-25]
airframe/variants/single-boom-mini/stl/dummy_servo_elev.stl
16.1 x 15.4 x 8.65
