henriharmaala1-source/Assembly-grapher/airframe/variants/single-boom/stl/fuselage_rear.stl

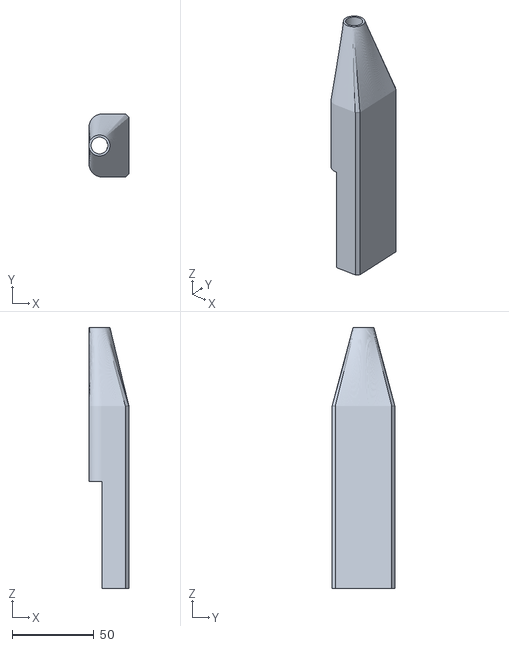
[picture p143: CAD file, 2026-10-25]
airframe/variants/single-boom/stl/fuselage_rear.stl
24.4 x 38.4 x 159.2
