henriharmaala1-source/Assembly-grapher/frames/mark4-v2-10/dxf/belly_plate.dxf

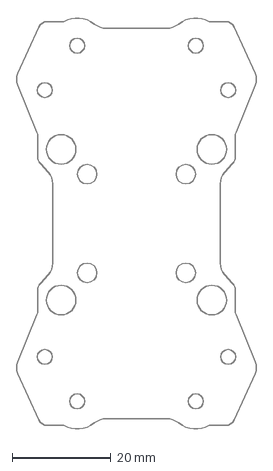
[picture p144: CAD file, 2026-10-09]
frames/mark4-v2-10/dxf/belly_plate.dxf
48.8 x 83.9 mm
