henriharmaala1-source/Assembly-grapher/airframe/stl/rudder_L.stl

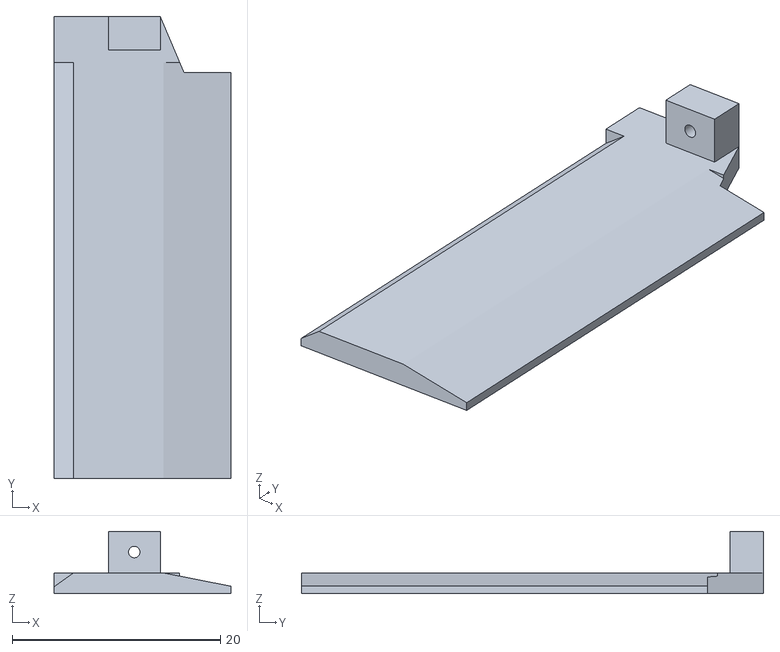
[picture p146: CAD file, 2026-09-29]
airframe/stl/rudder_L.stl
17.0 x 44.4 x 6.00
