henriharmaala1-source/Assembly-grapher/airframe/variants/extreme/stl/fairing_ail_R.stl

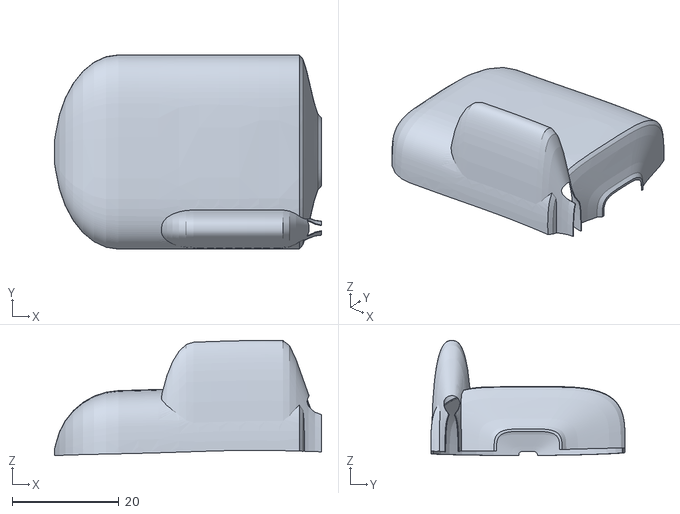
[picture p147: CAD file, 2026-10-25]
airframe/variants/extreme/stl/fairing_ail_R.stl
50.1 x 36.4 x 21.6
