henriharmaala1-source/Assembly-grapher/airframe/variants/optimized/stl/fairing_ail_R.stl

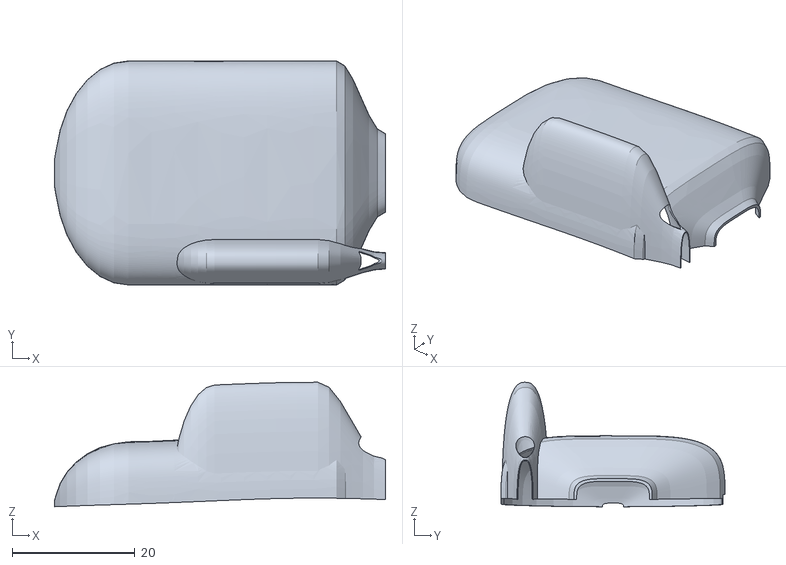
[picture p148: CAD file, 2026-10-25]
airframe/variants/optimized/stl/fairing_ail_R.stl
53.8 x 36.4 x 20.3
