henriharmaala1-source/Assembly-grapher/airframe/variants/single-boom-mini/stl/stand.stl

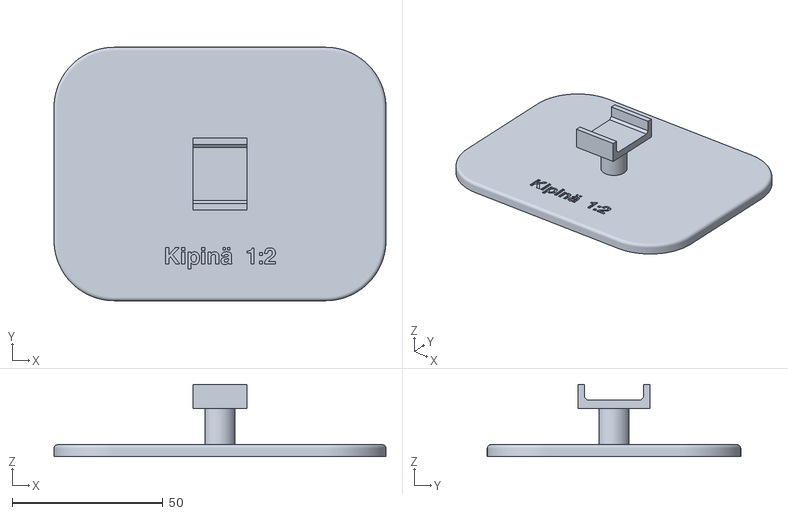
[picture p149: CAD file, 2026-10-25]
airframe/variants/single-boom-mini/stl/stand.stl
110.0 x 84.0 x 24.0
