henriharmaala1-source/Assembly-grapher/frames/mark4-v2-10/dxf/top_plate.dxf

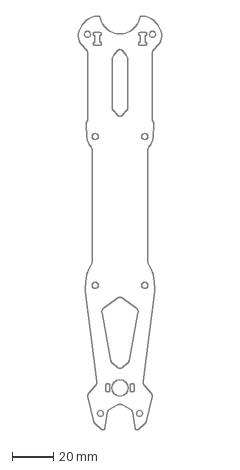
[picture p150: CAD file, 2026-10-09]
frames/mark4-v2-10/dxf/top_plate.dxf
40.9 x 200.3 mm
