henriharmaala1-source/Assembly-grapher/airframe/variants/single-boom-mini/stl/fuselage_rear.stl

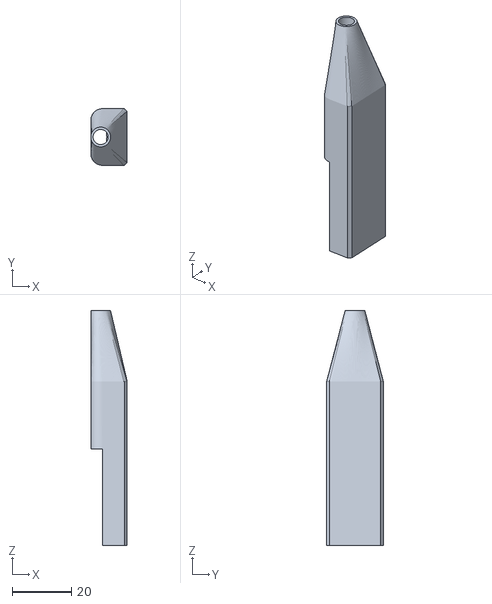
[picture p151: CAD file, 2026-10-25]
airframe/variants/single-boom-mini/stl/fuselage_rear.stl
12.4 x 19.2 x 79.6
