henriharmaala1-source/Assembly-grapher/airframe/variants/single-boom/stl/wing_L.stl

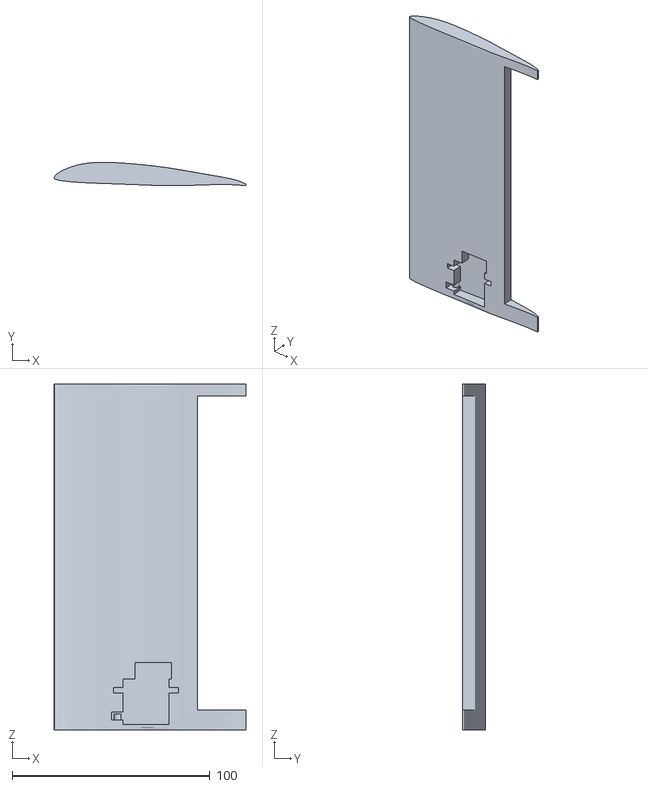
[picture p152: CAD file, 2026-10-25]
airframe/variants/single-boom/stl/wing_L.stl
97.0 x 11.8 x 175.0
