henriharmaala1-source/Assembly-grapher/frames/mark4-v2-10/dxf/lower_plate.dxf

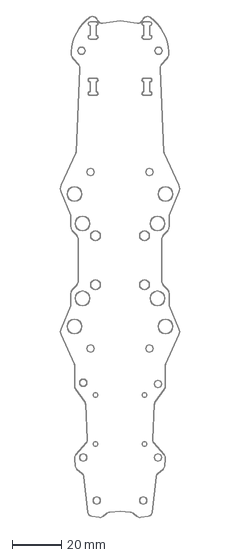
[picture p153: CAD file, 2026-10-09]
frames/mark4-v2-10/dxf/lower_plate.dxf
48.8 x 204.5 mm
