henriharmaala1-source/Assembly-grapher/airframe/stl/wing_L.stl

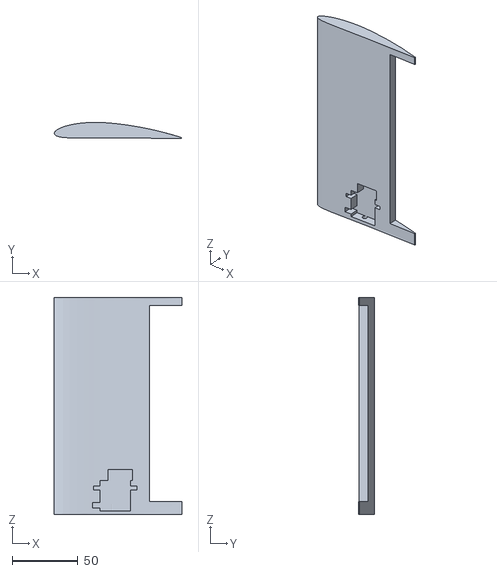
[picture p155: CAD file, 2026-09-29]
airframe/stl/wing_L.stl
97.0 x 12.4 x 165.1
