henriharmaala1-source/Assembly-grapher/airframe/variants/extreme/stl/aileron_R.stl

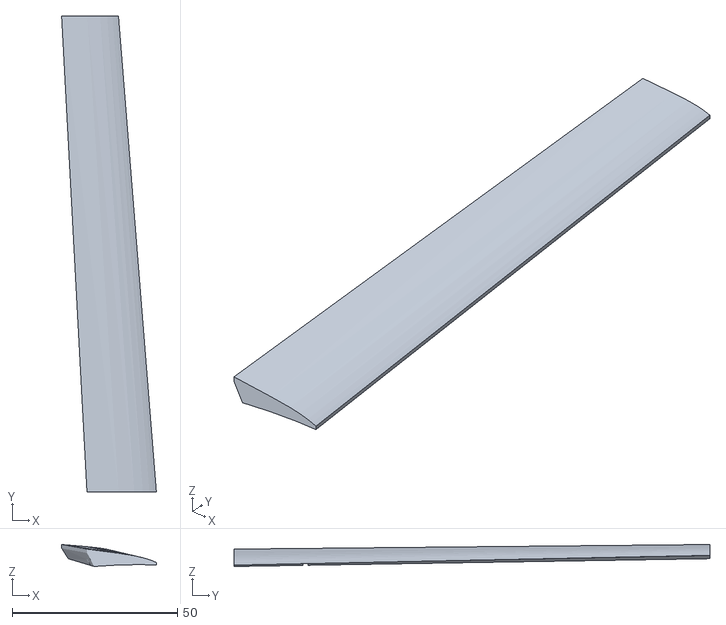
[picture p156: CAD file, 2026-10-25]
airframe/variants/extreme/stl/aileron_R.stl
28.7 x 144.0 x 6.66
