henriharmaala1-source/Assembly-grapher/airframe/variants/single-boom-mini/stl/dummy_prop.stl

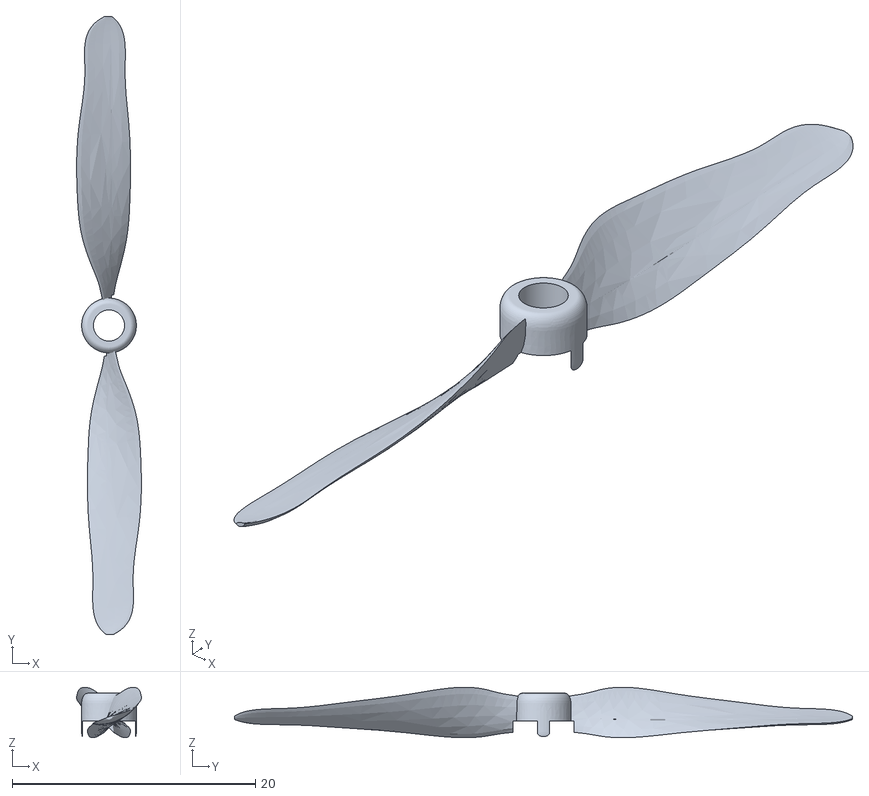
[picture p157: CAD file, 2026-10-25]
airframe/variants/single-boom-mini/stl/dummy_prop.stl
5.31 x 50.8 x 4.14
