henriharmaala1-source/Assembly-grapher/frames/mark4-v2-10/dxf/chin_plate.dxf

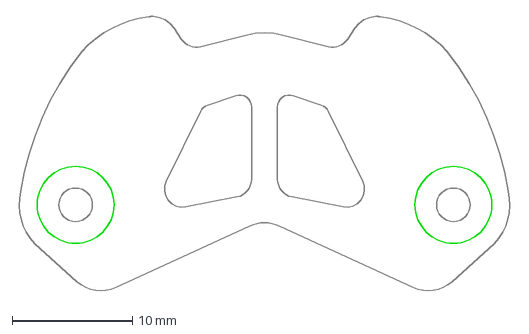
[picture p158: CAD file, 2026-10-09]
frames/mark4-v2-10/dxf/chin_plate.dxf
41.3 x 23.0 mm
