henriharmaala1-source/Assembly-grapher/frames/mark4-v2-10/hardware/pin_cap_m3x8.step

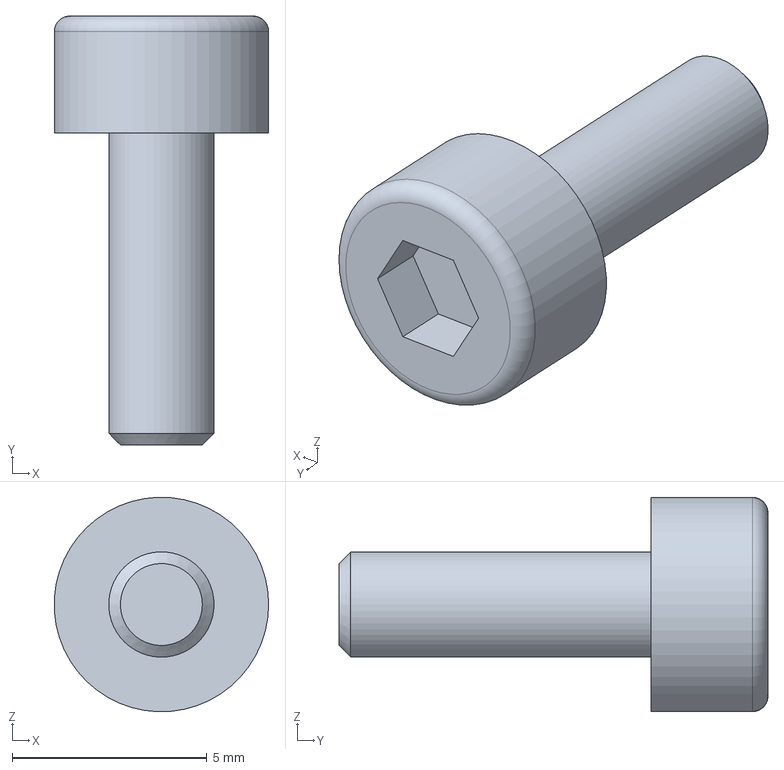
[picture p159: CAD file, 2026-10-09]
frames/mark4-v2-10/hardware/pin_cap_m3x8.step
5.49 x 11.0 x 5.50 mm
