henriharmaala1-source/Assembly-grapher/airframe/stl/pod_rear.stl

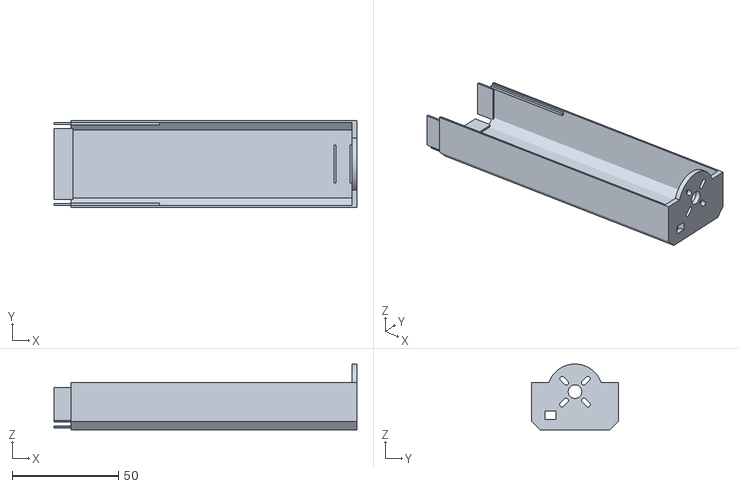
[picture p160: CAD file, 2026-09-29]
airframe/stl/pod_rear.stl
142.4 x 40.8 x 31.0
