henriharmaala1-source/Assembly-grapher/airframe/variants/extreme/stl/wing_centre.stl

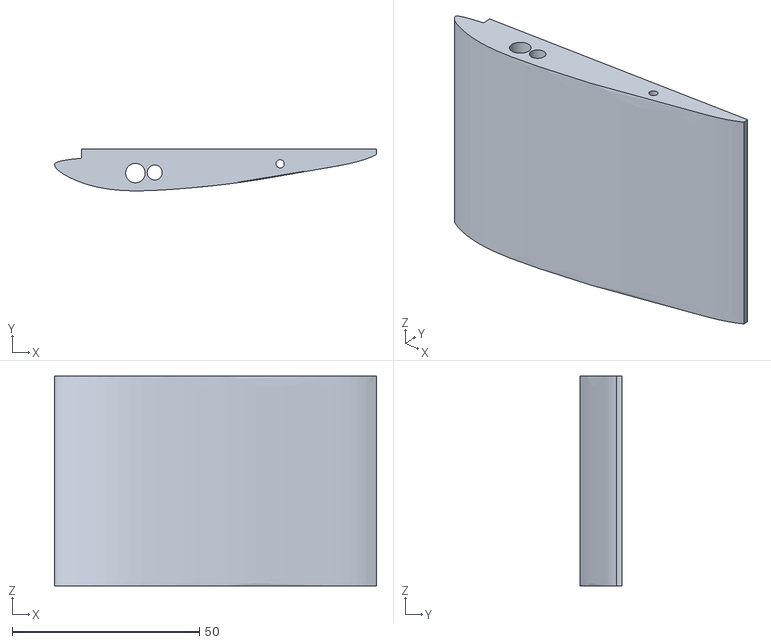
[picture p161: CAD file, 2026-10-25]
airframe/variants/extreme/stl/wing_centre.stl
86.0 x 11.1 x 56.0
