henriharmaala1-source/Assembly-grapher/airframe/variants/optimized/stl/pod_rear.stl

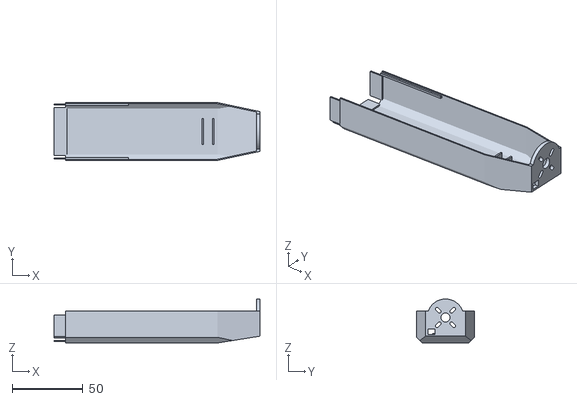
[picture p162: CAD file, 2026-10-25]
airframe/variants/optimized/stl/pod_rear.stl
145.3 x 40.8 x 31.0
