henriharmaala1-source/Assembly-grapher/airframe/variants/single-boom-mini/stl/rudder.stl

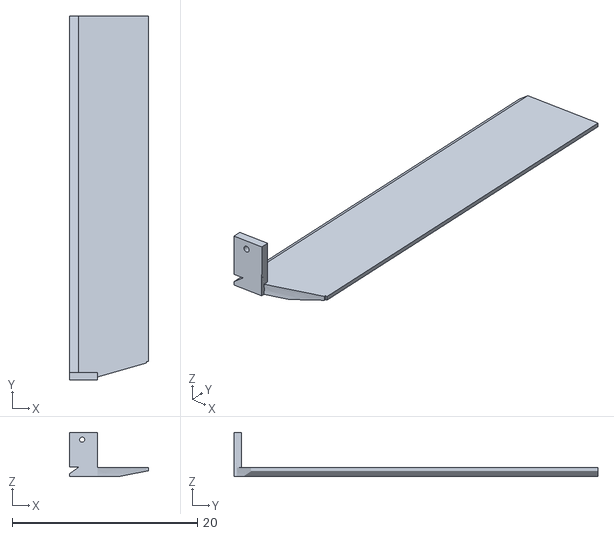
[picture p163: CAD file, 2026-10-25]
airframe/variants/single-boom-mini/stl/rudder.stl
8.49 x 39.3 x 4.80
