henriharmaala1-source/Assembly-grapher/airframe/variants/single-boom/stl/wing_centre.stl

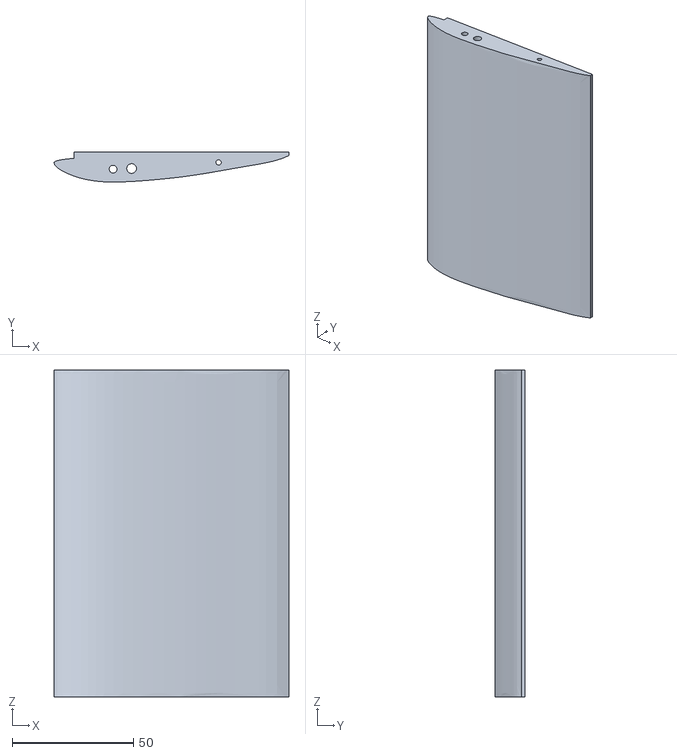
[picture p164: CAD file, 2026-10-25]
airframe/variants/single-boom/stl/wing_centre.stl
97.0 x 12.4 x 135.0
