henriharmaala1-source/Assembly-grapher/frames/mark4-v2-10/dxf/arm.dxf

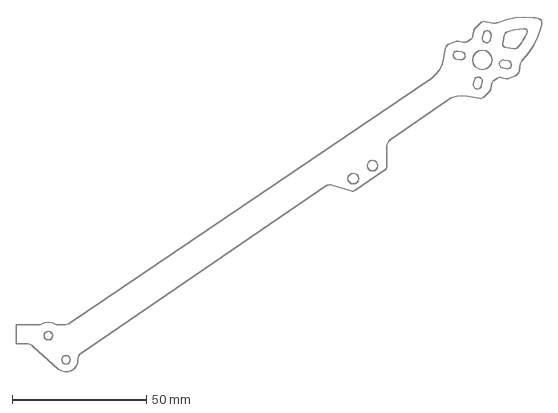
[picture p165: CAD file, 2026-10-09]
frames/mark4-v2-10/dxf/arm.dxf
195.5 x 132.4 mm
