henriharmaala1-source/Assembly-grapher/frames/mark4-v2-10/hardware/fit_gauge.step

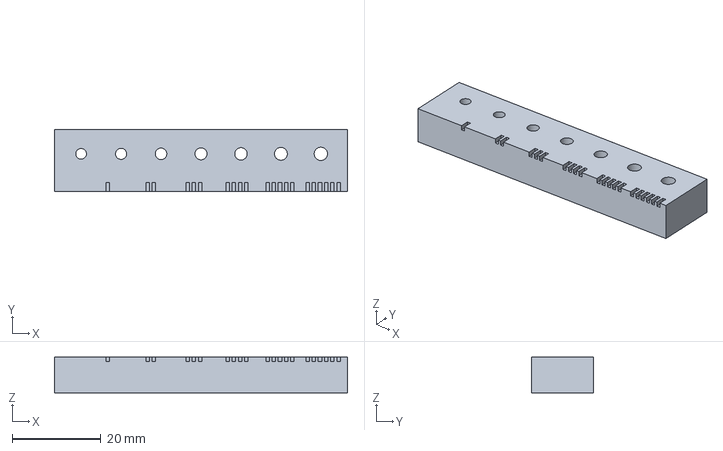
[picture p166: CAD file, 2026-10-09]
frames/mark4-v2-10/hardware/fit_gauge.step
66.0 x 14.0 x 8.00 mm
