henriharmaala1-source/Assembly-grapher/airframe/stl/pod_front.stl

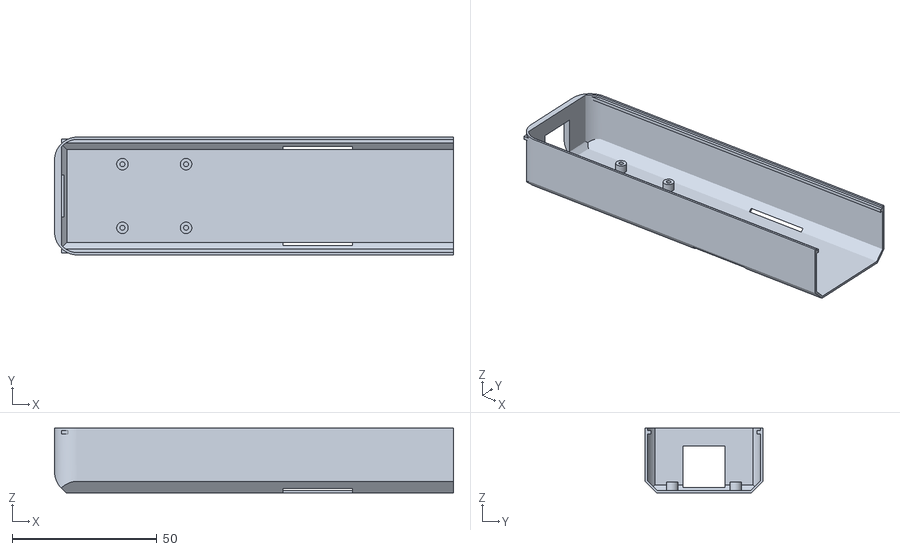
[picture p167: CAD file, 2026-09-29]
airframe/stl/pod_front.stl
138.0 x 40.8 x 22.4
