henriharmaala1-source/Assembly-grapher/airframe/variants/extreme/stl/rudder.stl

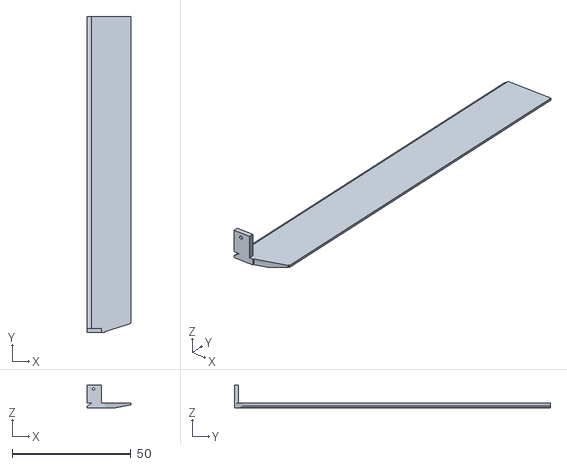
[picture p168: CAD file, 2026-10-25]
airframe/variants/extreme/stl/rudder.stl
18.4 x 133.3 x 9.60
