henriharmaala1-source/Assembly-grapher/airframe/variants/optimized/stl/lid.stl

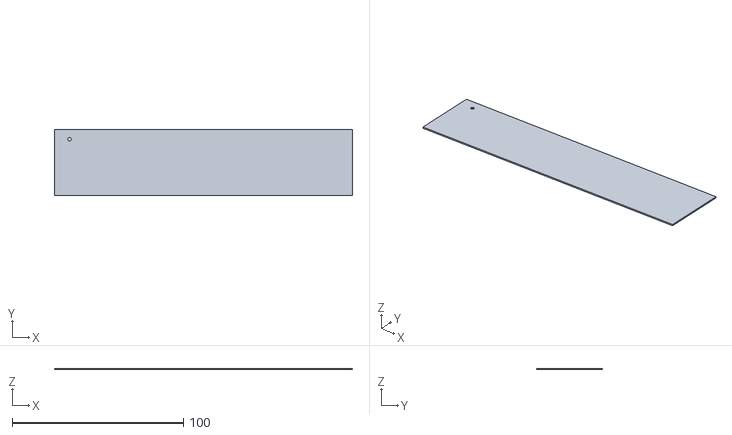
[picture p169: CAD file, 2026-10-25]
airframe/variants/optimized/stl/lid.stl
174.3 x 38.8 x 0.8
