henriharmaala1-source/Assembly-grapher/airframe/variants/single-boom-mini/stl/dummy_battery.stl

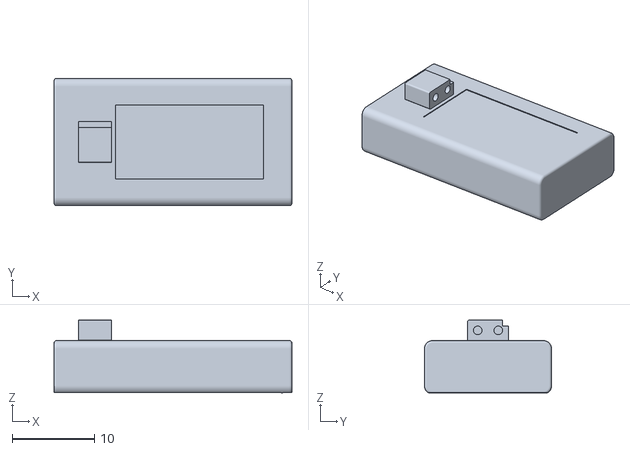
[picture p170: CAD file, 2026-10-25]
airframe/variants/single-boom-mini/stl/dummy_battery.stl
29.0 x 15.5 x 8.87
