henriharmaala1-source/Assembly-grapher/frames/mark4-v2-10/dxf/arm_brace.dxf

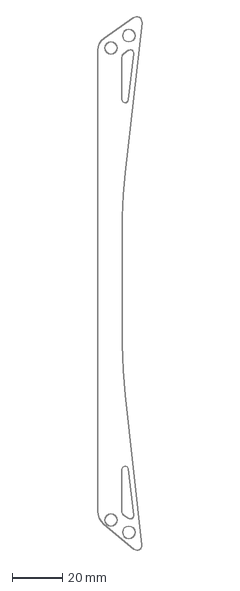
[picture p171: CAD file, 2026-10-09]
frames/mark4-v2-10/dxf/arm_brace.dxf
17.8 x 213.5 mm
