henriharmaala1-source/Assembly-grapher/frames/mark4-v2-10/hardware/pin_cap_m3x18.step

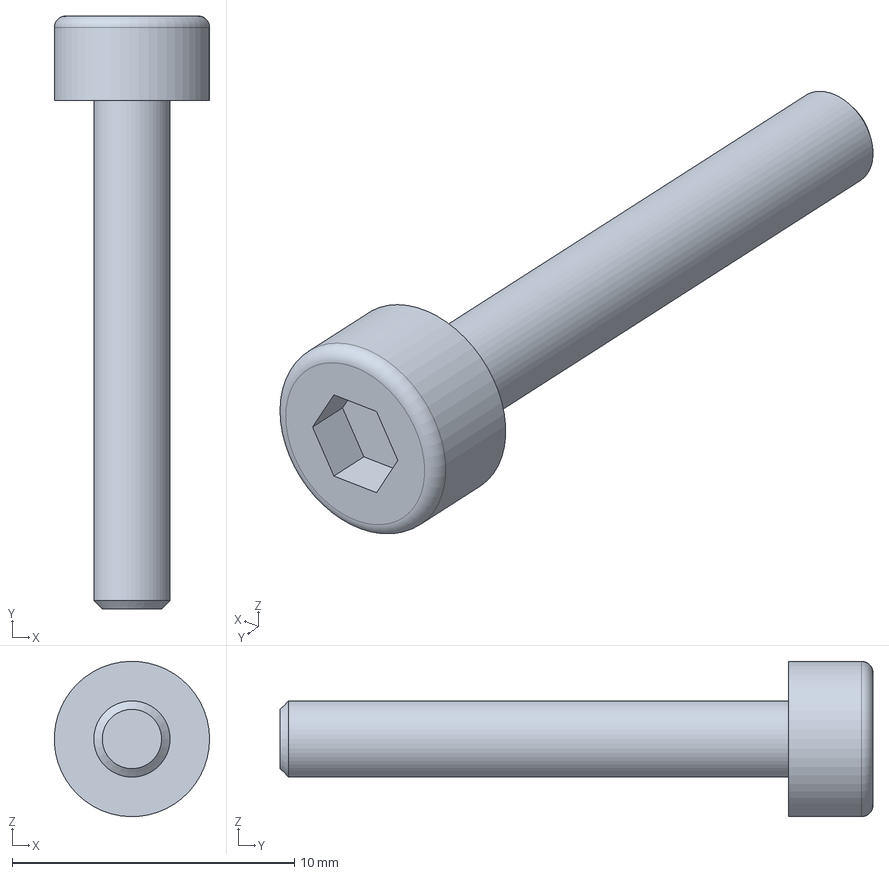
[picture p172: CAD file, 2026-10-09]
frames/mark4-v2-10/hardware/pin_cap_m3x18.step
5.49 x 21.0 x 5.50 mm
