henriharmaala1-source/Assembly-grapher/airframe/stl/wing_centre.stl

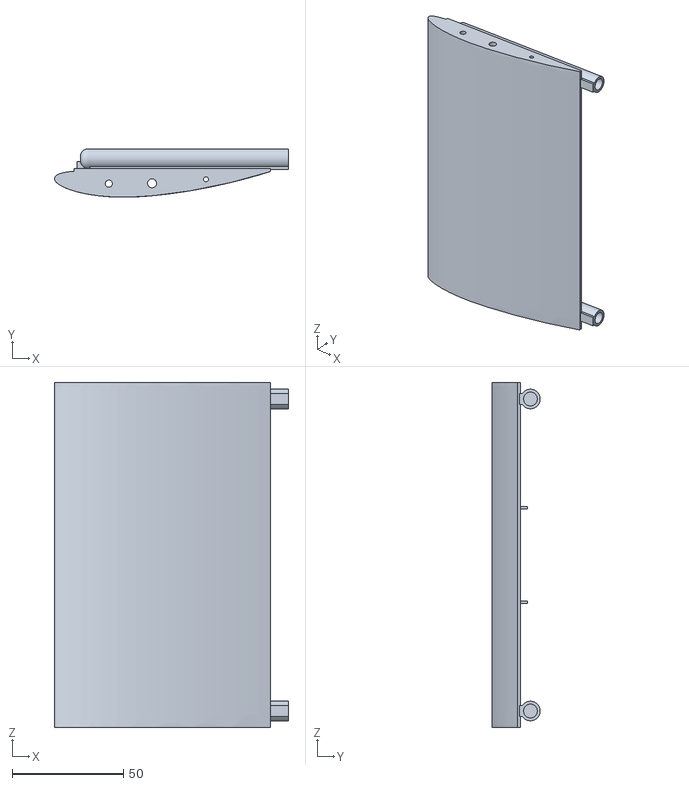
[picture p173: CAD file, 2026-09-29]
airframe/stl/wing_centre.stl
105.0 x 21.8 x 154.8
