henriharmaala1-source/Assembly-grapher/airframe/variants/extreme/stl/fuselage_rear.stl

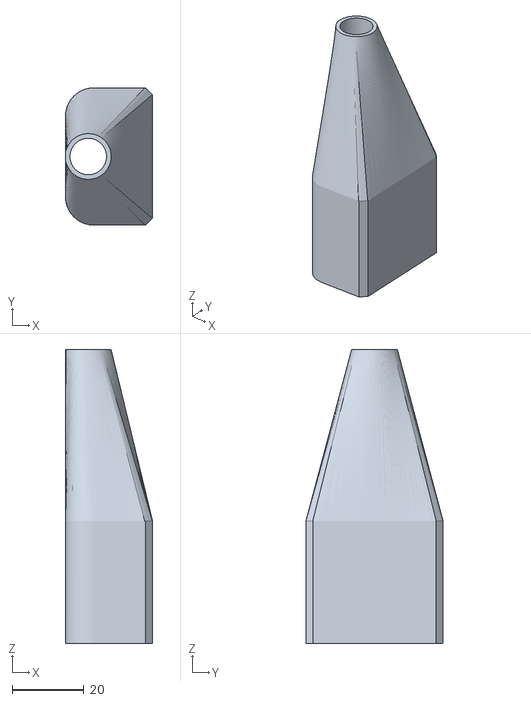
[picture p174: CAD file, 2026-10-25]
airframe/variants/extreme/stl/fuselage_rear.stl
24.4 x 38.4 x 82.2
