henriharmaala1-source/Assembly-grapher/airframe/variants/single-boom-mini/stl/fuselage_front.stl

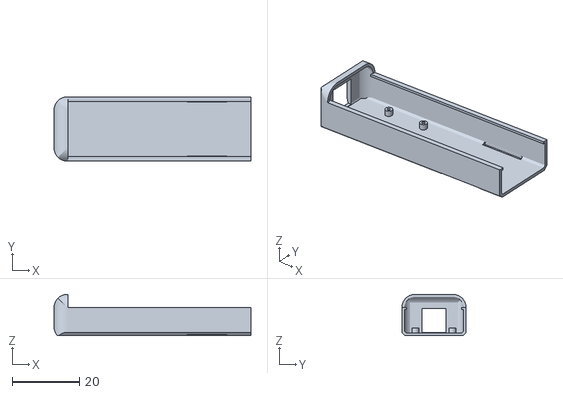
[picture p175: CAD file, 2026-10-25]
airframe/variants/single-boom-mini/stl/fuselage_front.stl
58.8 x 19.2 x 12.4
