henriharmaala1-source/Assembly-grapher/airframe/variants/single-boom/stl/rudder.stl

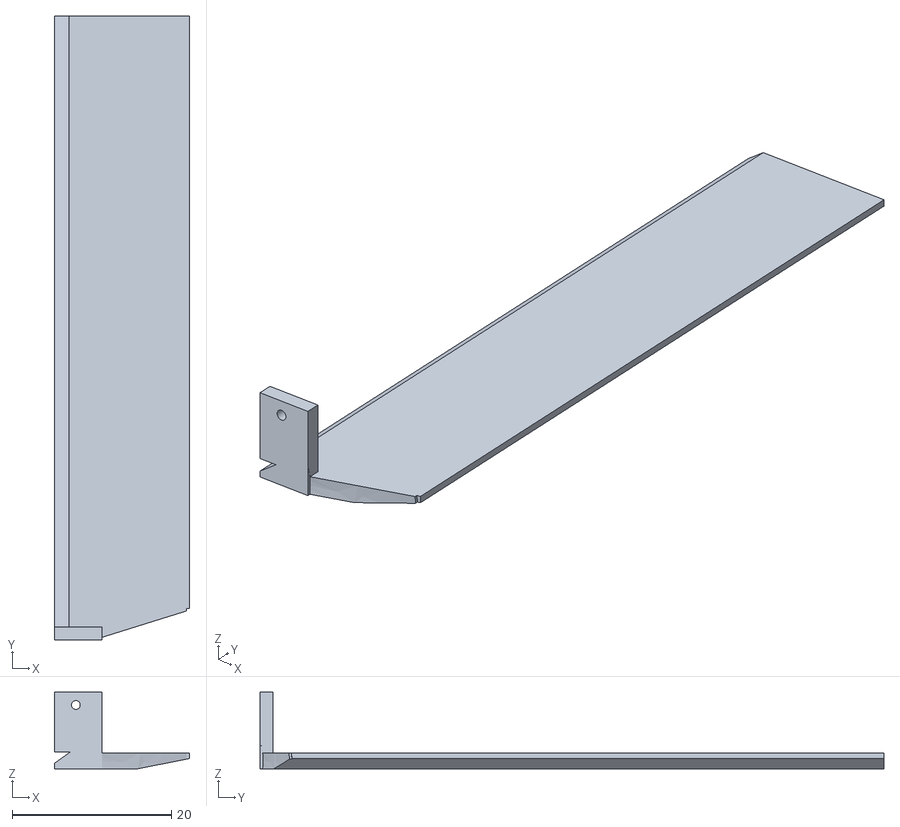
[picture p176: CAD file, 2026-10-25]
airframe/variants/single-boom/stl/rudder.stl
17.0 x 78.3 x 9.60
