henriharmaala1-source/Assembly-grapher/airframe/stl/tail_mount.stl

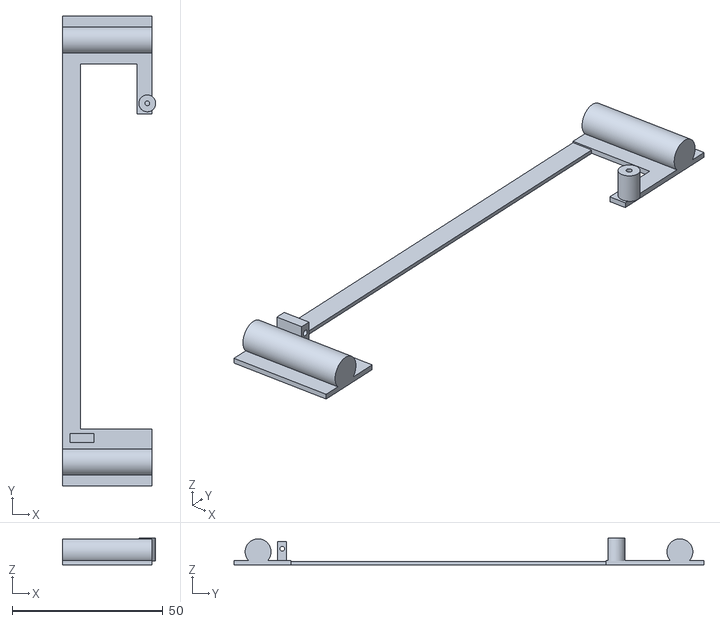
[picture p178: CAD file, 2026-09-29]
airframe/stl/tail_mount.stl
31.0 x 156.0 x 8.80
