henriharmaala1-source/Assembly-grapher/airframe/variants/extreme/stl/wing_outer_R.stl

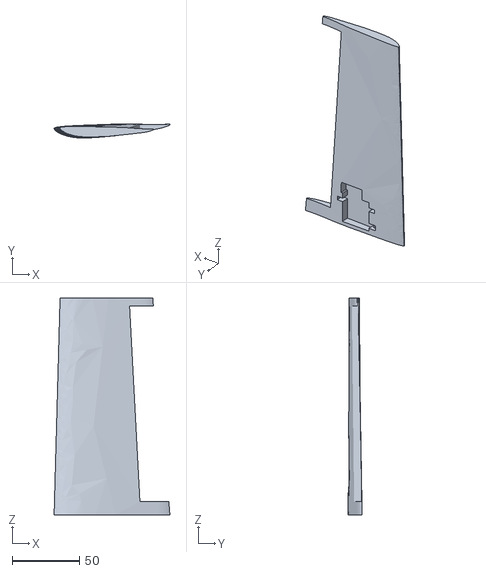
[picture p179: CAD file, 2026-10-25]
airframe/variants/extreme/stl/wing_outer_R.stl
86.0 x 10.5 x 161.0
