henriharmaala1-source/Assembly-grapher/airframe/variants/single-boom-mini/stl/dummy_motor.stl

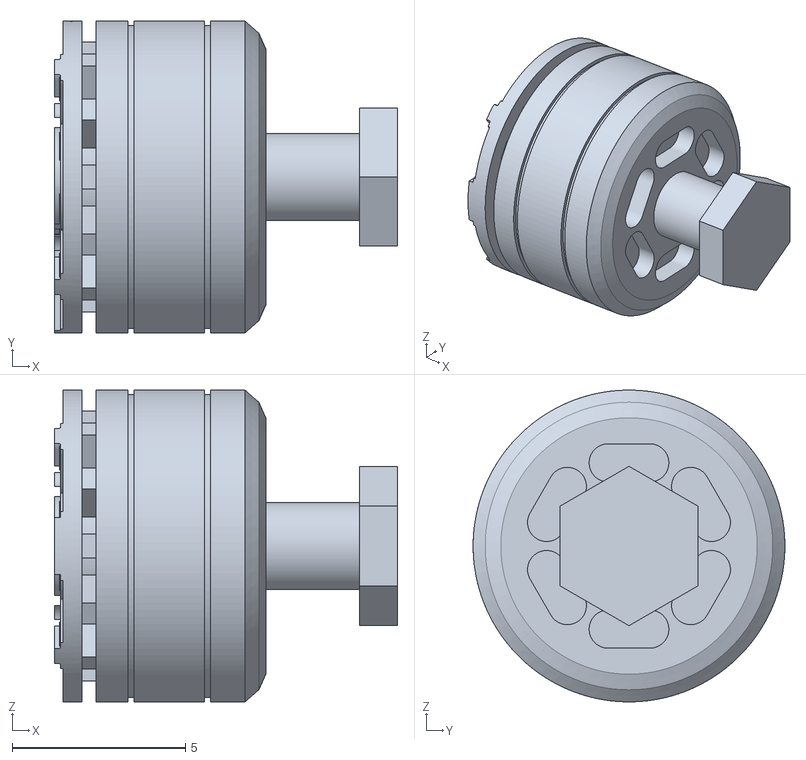
[picture p180: CAD file, 2026-10-25]
airframe/variants/single-boom-mini/stl/dummy_motor.stl
9.90 x 9.00 x 9.00
