henriharmaala1-source/Assembly-grapher/airframe/variants/extreme/stl/fuselage_front.stl

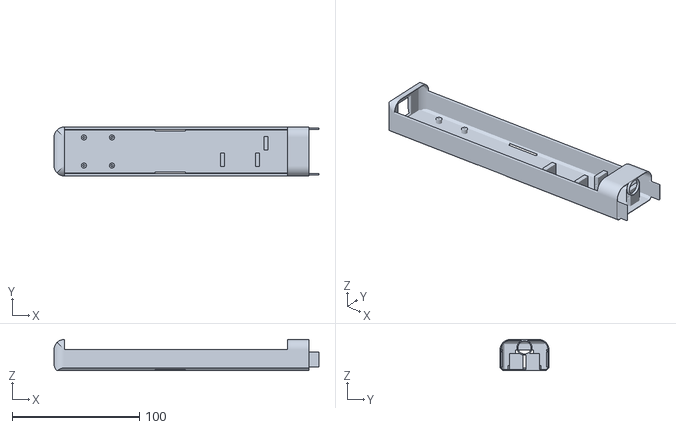
[picture p181: CAD file, 2026-10-25]
airframe/variants/extreme/stl/fuselage_front.stl
208.0 x 38.4 x 24.4
