henriharmaala1-source/Assembly-grapher/airframe/variants/single-boom-mini/stl/dummy_fc.stl

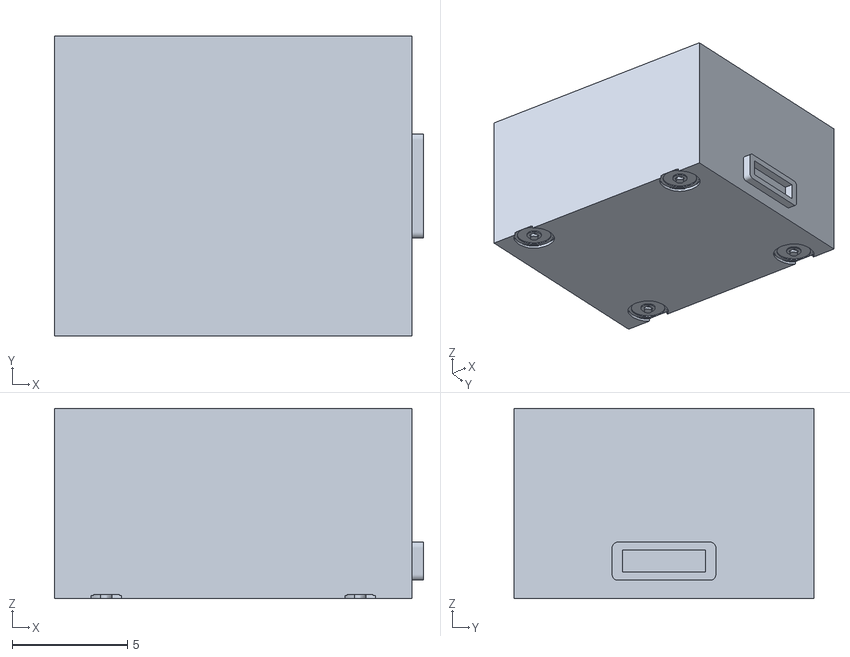
[picture p182: CAD file, 2026-10-25]
airframe/variants/single-boom-mini/stl/dummy_fc.stl
16.0 x 13.0 x 8.25
