henriharmaala1-source/Assembly-grapher/airframe/variants/single-boom/stl/fuselage_front.stl

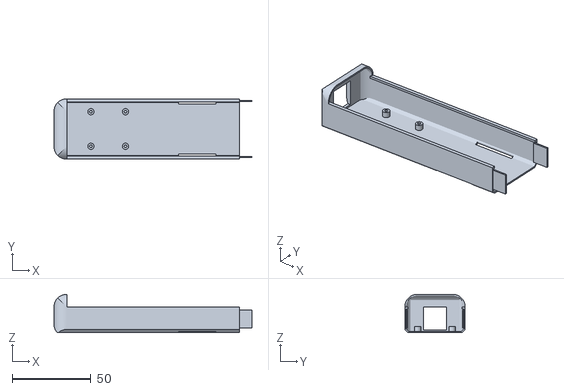
[picture p183: CAD file, 2026-10-25]
airframe/variants/single-boom/stl/fuselage_front.stl
126.0 x 38.4 x 24.4
