henriharmaala1-source/Assembly-grapher/airframe/variants/single-boom/stl/motor_mount.stl

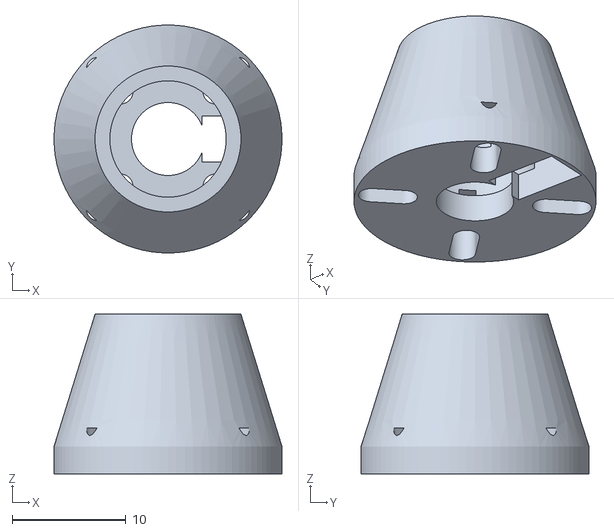
[picture p184: CAD file, 2026-10-11]
airframe/variants/single-boom/stl/motor_mount.stl
20.0 x 20.0 x 14.0
