henriharmaala1-source/Assembly-grapher/airframe/variants/optimized/stl/wing_centre.stl

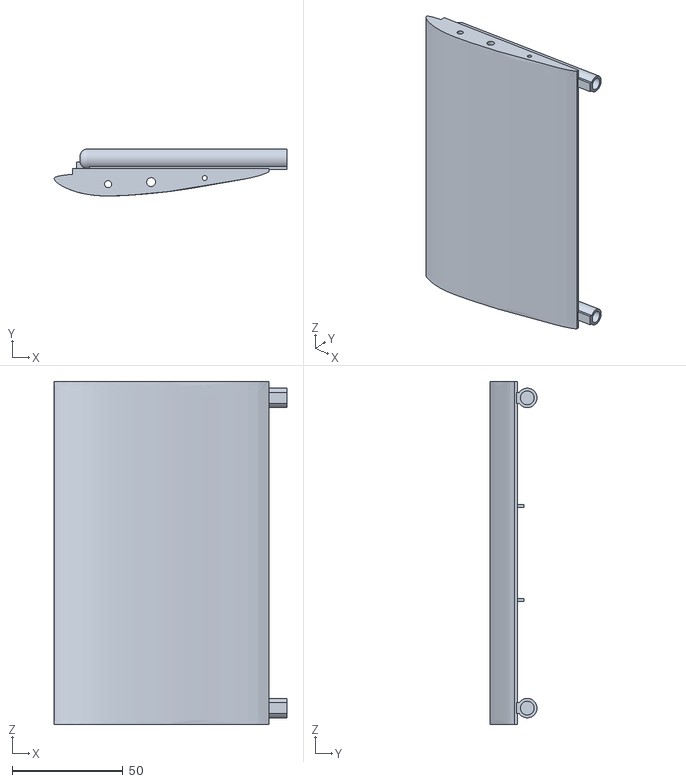
[picture p185: CAD file, 2026-10-25]
airframe/variants/optimized/stl/wing_centre.stl
105.0 x 21.2 x 154.8
