henriharmaala1-source/Assembly-grapher/airframe/variants/single-boom-mini/stl/lid.stl

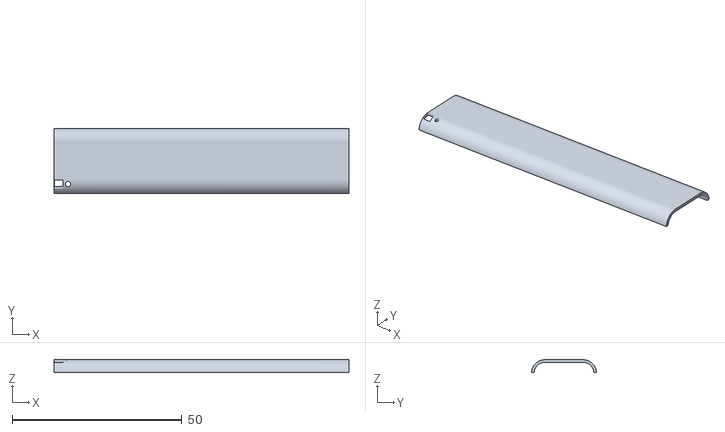
[picture p186: CAD file, 2026-10-25]
airframe/variants/single-boom-mini/stl/lid.stl
87.0 x 19.2 x 3.75
