henriharmaala1-source/Assembly-grapher/airframe/variants/single-boom/stl/stab.stl

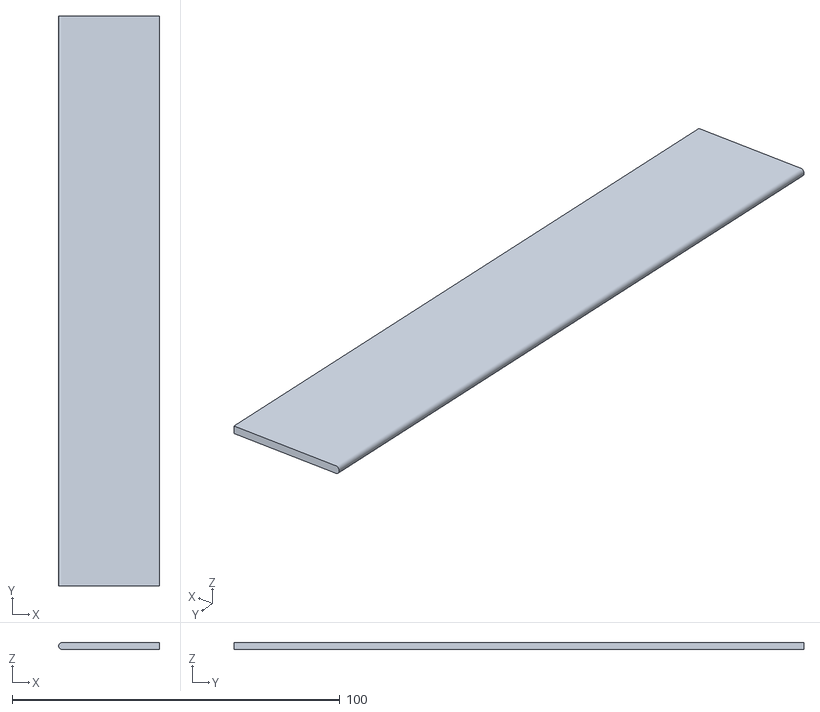
[picture p187: CAD file, 2026-10-06]
airframe/variants/single-boom/stl/stab.stl
30.7 x 174.0 x 2.00
