henriharmaala1-source/Assembly-grapher/airframe/variants/single-boom-mini/stl/rod_boom.stl

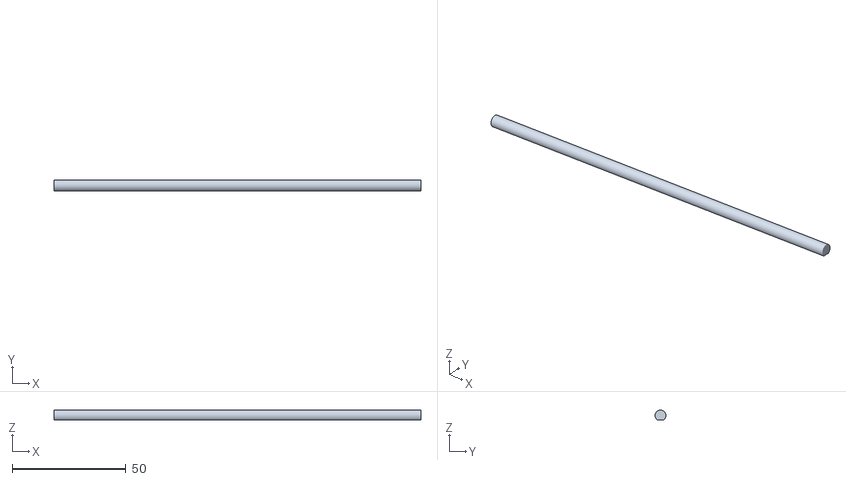
[picture p188: CAD file, 2026-10-25]
airframe/variants/single-boom-mini/stl/rod_boom.stl
161.4 x 4.80 x 4.32
