henriharmaala1-source/Assembly-grapher/airframe/variants/single-boom/stl/elevator.stl

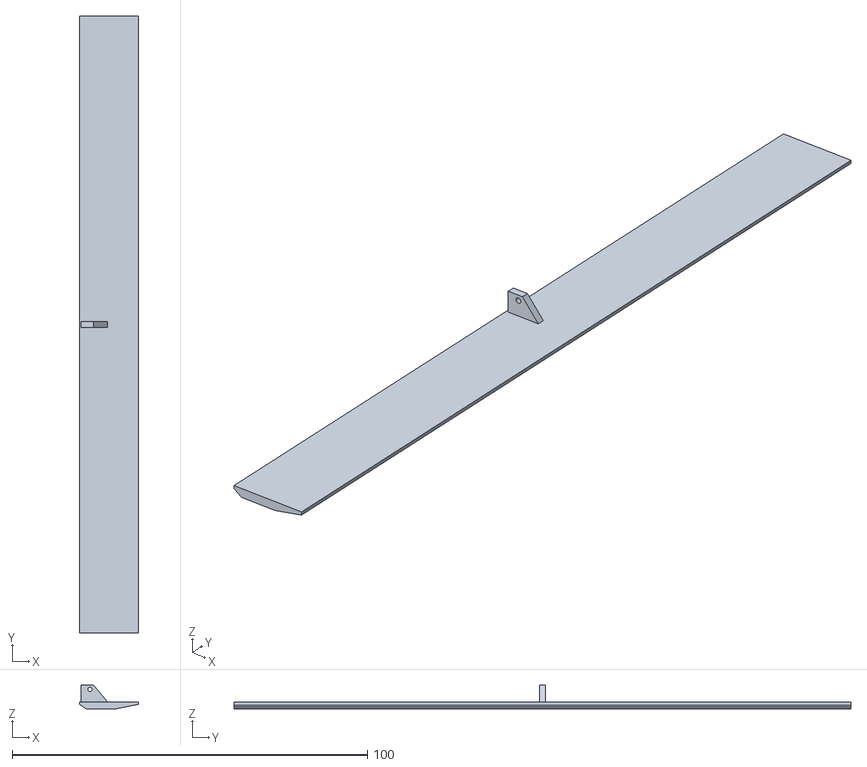
[picture p189: CAD file, 2026-10-06]
airframe/variants/single-boom/stl/elevator.stl
16.7 x 173.8 x 6.70
