henriharmaala1-source/Assembly-grapher/airframe/variants/extreme/stl/stab.stl

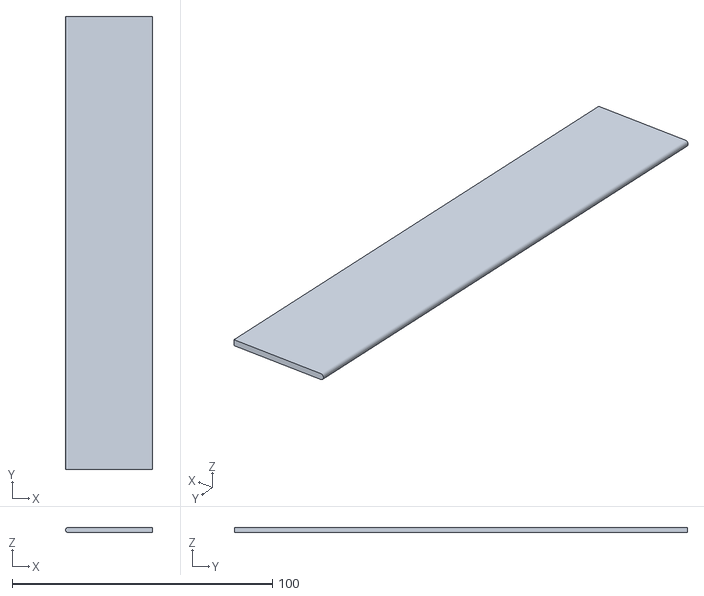
[picture p190: CAD file, 2026-10-11]
airframe/variants/extreme/stl/stab.stl
33.3 x 174.0 x 2.00
