henriharmaala1-source/Assembly-grapher/airframe/variants/optimized/stl/sleeve_R.stl

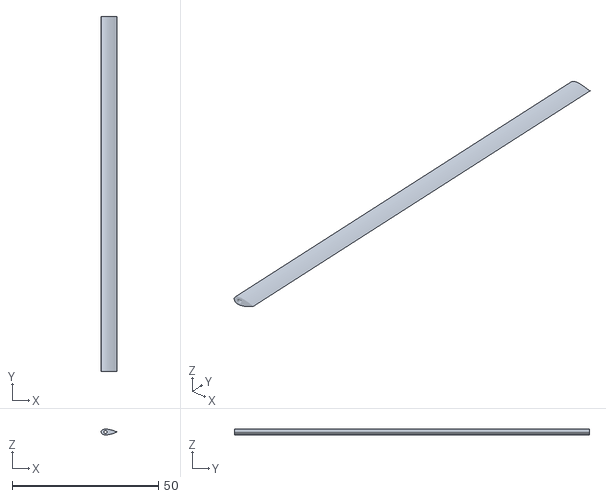
[picture p191: CAD file, 2026-09-30]
airframe/variants/optimized/stl/sleeve_R.stl
5.50 x 121.5 x 2.00
