henriharmaala1-source/Assembly-grapher/airframe/variants/single-boom-mini/stl/wing_centre.stl

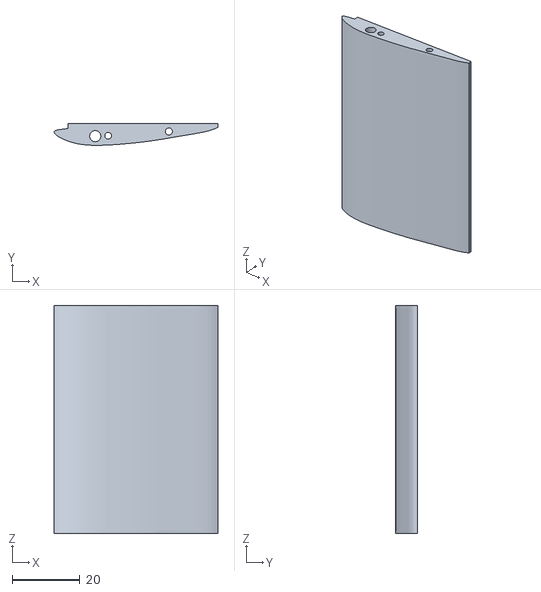
[picture p192: CAD file, 2026-10-25]
airframe/variants/single-boom-mini/stl/wing_centre.stl
48.5 x 6.43 x 67.5
