henriharmaala1-source/Assembly-grapher/airframe/variants/single-boom/stl/fin.stl

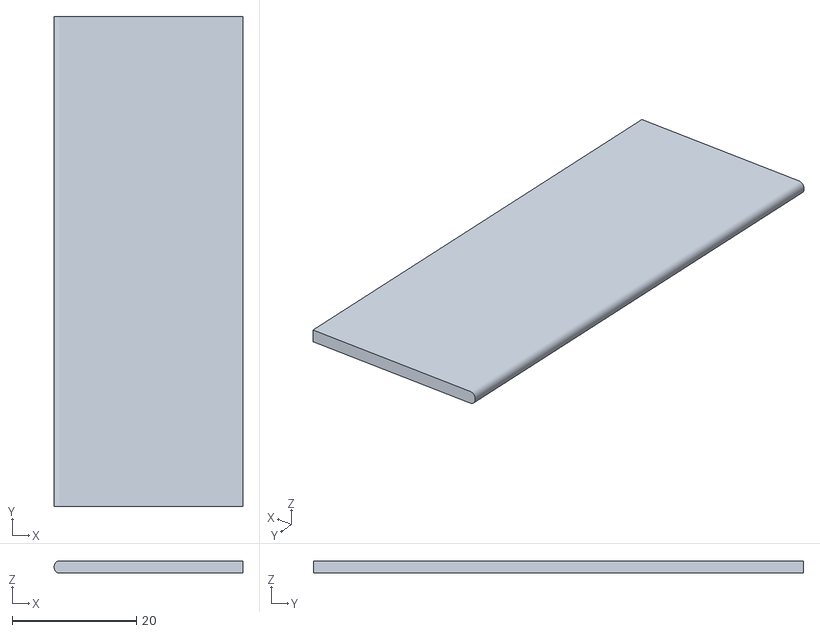
[picture p193: CAD file, 2026-10-06]
airframe/variants/single-boom/stl/fin.stl
30.4 x 79.0 x 2.00
