henriharmaala1-source/Assembly-grapher/airframe/variants/extreme/stl/fin.stl

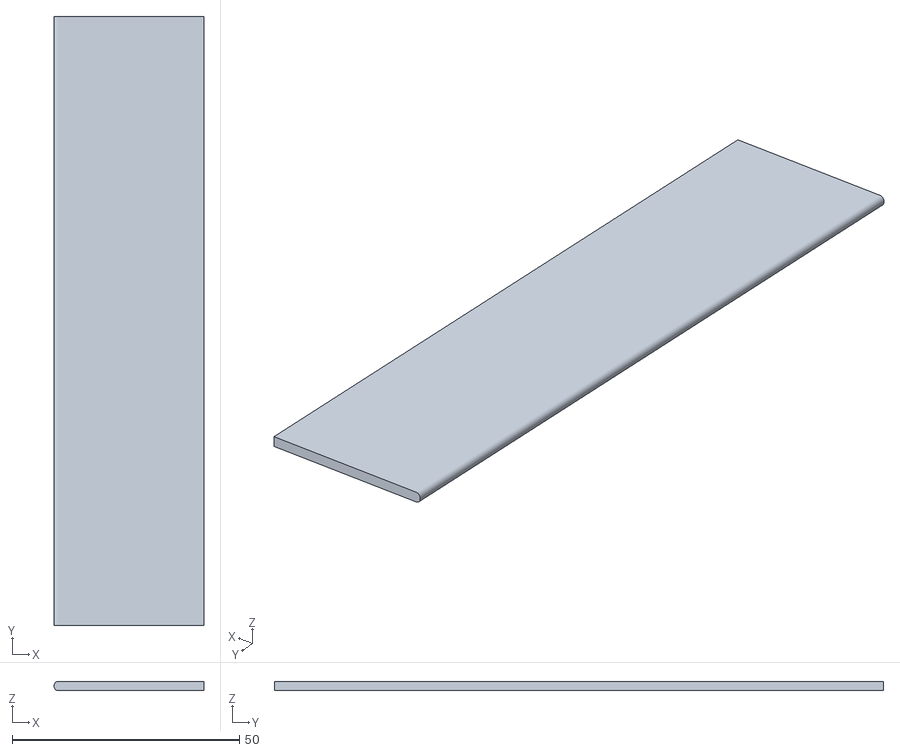
[picture p194: CAD file, 2026-10-11]
airframe/variants/extreme/stl/fin.stl
33.0 x 134.0 x 2.00
