henriharmaala1-source/Assembly-grapher/airframe/variants/single-boom-mini/stl/dummy_receiver.stl

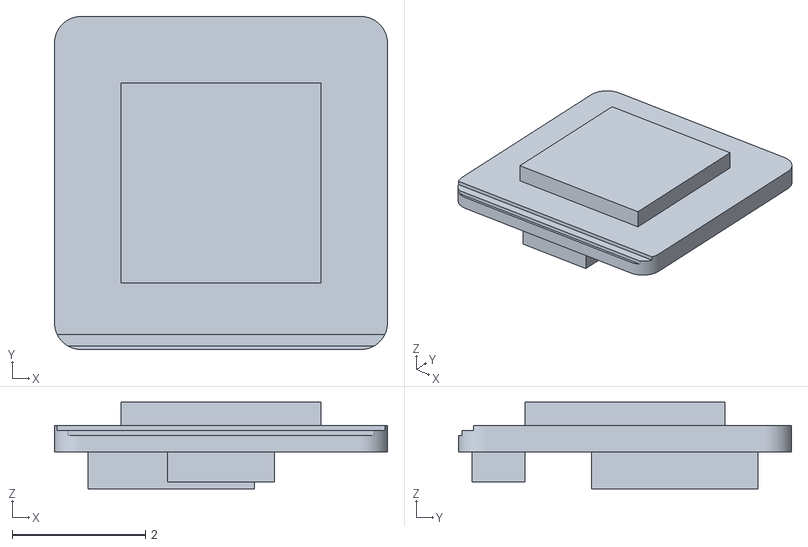
[picture p195: CAD file, 2026-10-25]
airframe/variants/single-boom-mini/stl/dummy_receiver.stl
5.00 x 5.00 x 1.30
