henriharmaala1-source/Assembly-grapher/airframe/variants/extreme/stl/elevator.stl

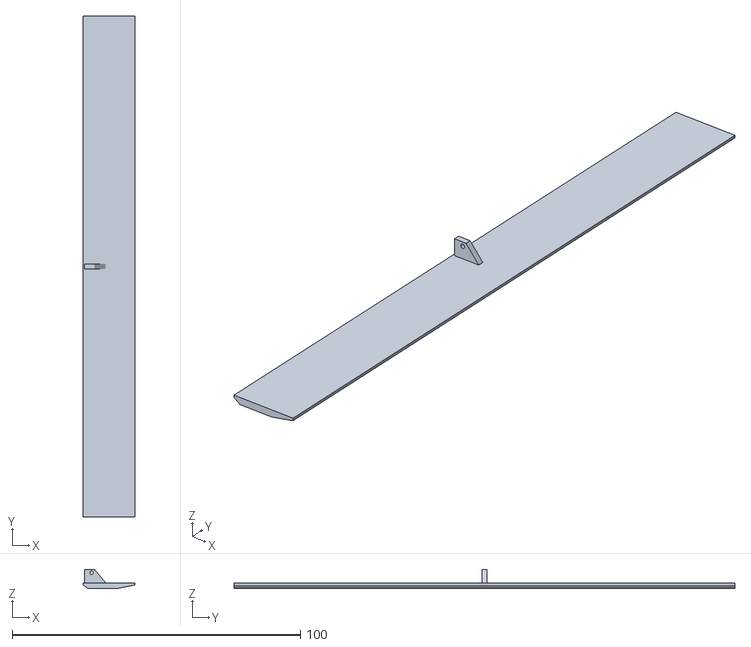
[picture p196: CAD file, 2026-10-11]
airframe/variants/extreme/stl/elevator.stl
18.1 x 173.8 x 6.70
