henriharmaala1-source/Assembly-grapher/airframe/variants/optimized/stl/sleeve_L.stl

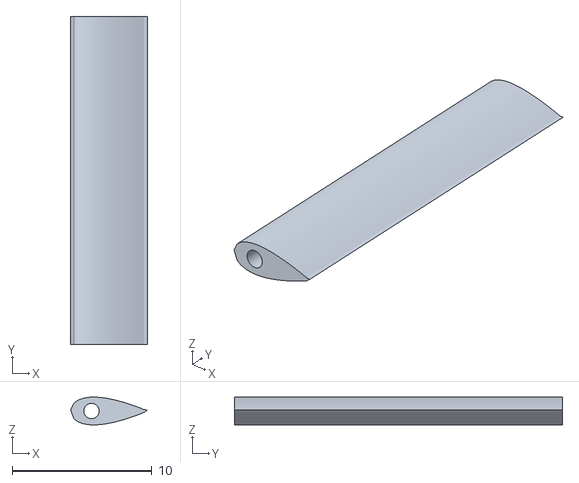
[picture p197: CAD file, 2026-09-30]
airframe/variants/optimized/stl/sleeve_L.stl
5.50 x 23.5 x 2.00
