henriharmaala1-source/Assembly-grapher/airframe/variants/single-boom-mini/stl/dummy_servo_ail_R.stl

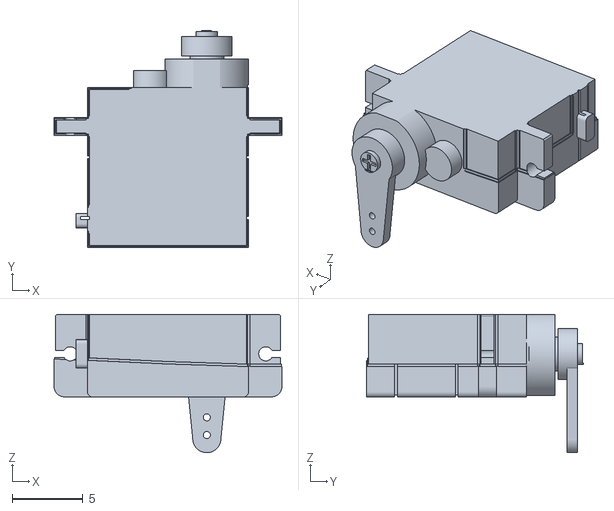
[picture p198: CAD file, 2026-10-25]
airframe/variants/single-boom-mini/stl/dummy_servo_ail_R.stl
16.2 x 15.4 x 9.80
