henriharmaala1-source/Assembly-grapher/airframe/variants/extreme/stl/lid.stl

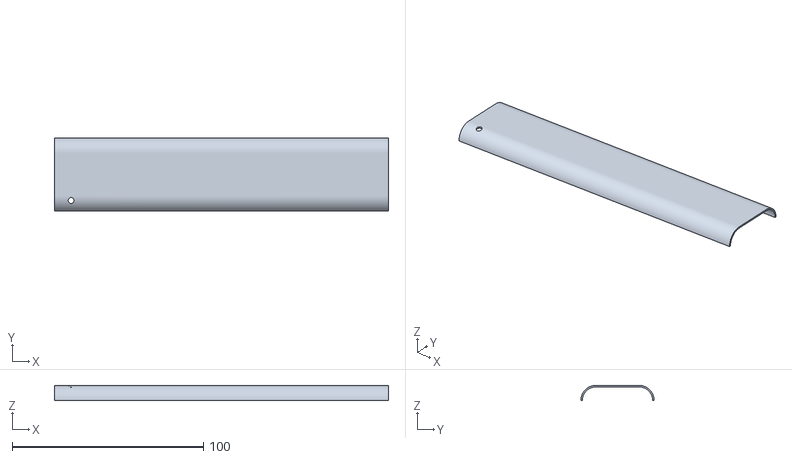
[picture p199: CAD file, 2026-10-06]
airframe/variants/extreme/stl/lid.stl
174.7 x 38.4 x 8.00
