henriharmaala1-source/Assembly-grapher/airframe/variants/single-boom-mini/stl/aileron_L.stl

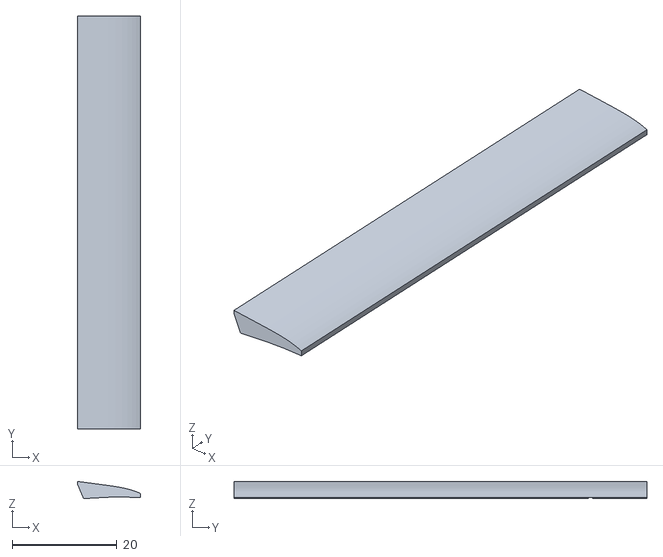
[picture p200: CAD file, 2026-10-25]
airframe/variants/single-boom-mini/stl/aileron_L.stl
12.0 x 79.0 x 3.29
