henriharmaala1-source/Assembly-grapher/airframe/variants/optimized/stl/bellcrank.stl

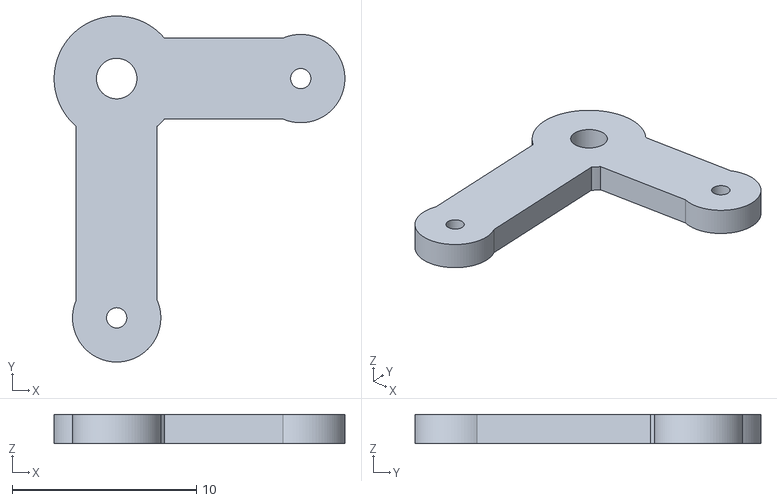
[picture p201: CAD file, 2026-09-29]
airframe/variants/optimized/stl/bellcrank.stl
15.8 x 18.8 x 1.60
