henriharmaala1-source/Assembly-grapher/airframe/variants/optimized/stl/fin_L.stl

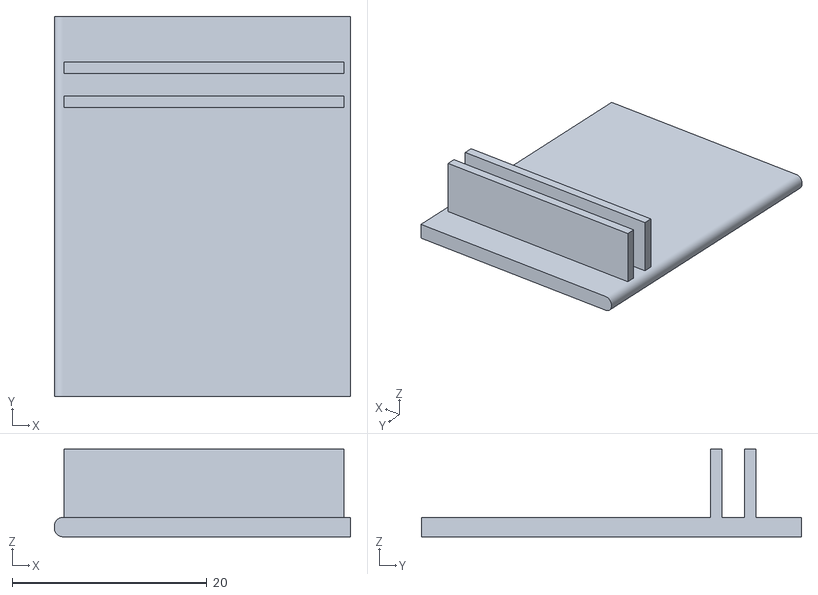
[picture p202: CAD file, 2026-09-29]
airframe/variants/optimized/stl/fin_L.stl
30.4 x 39.0 x 9.00
