henriharmaala1-source/Assembly-grapher/airframe/variants/single-boom-mini/stl/dummy_camera.stl

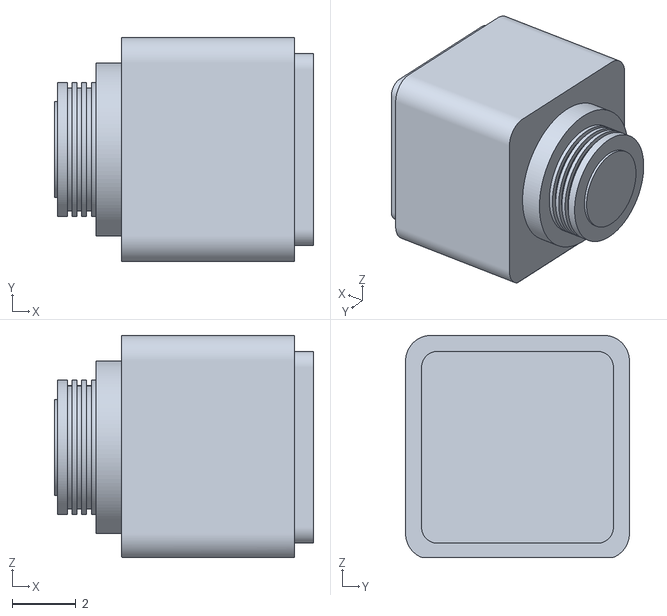
[picture p203: CAD file, 2026-10-25]
airframe/variants/single-boom-mini/stl/dummy_camera.stl
8.10 x 7.00 x 6.95
