henriharmaala1-source/Assembly-grapher/airframe/variants/single-boom-mini/stl/fin.stl

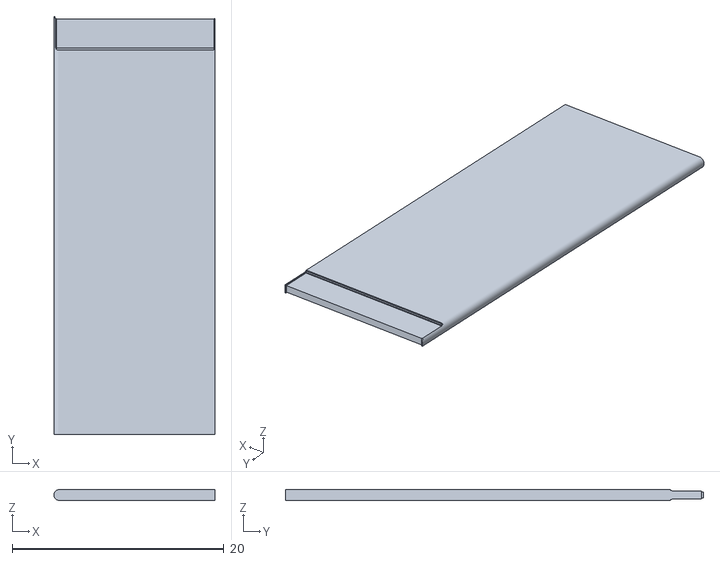
[picture p204: CAD file, 2026-10-25]
airframe/variants/single-boom-mini/stl/fin.stl
15.2 x 39.5 x 1.00
