henriharmaala1-source/Assembly-grapher/airframe/variants/single-boom-mini/stl/motor_mount.stl

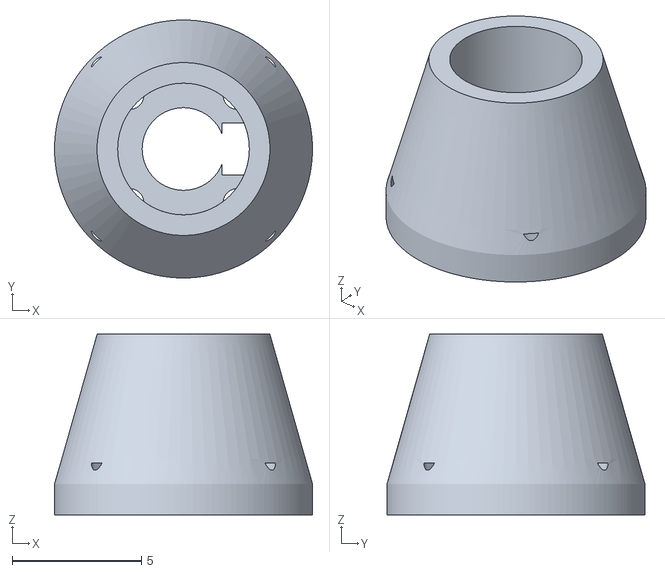
[picture p205: CAD file, 2026-10-25]
airframe/variants/single-boom-mini/stl/motor_mount.stl
10.0 x 10.00 x 7.00
