henriharmaala1-source/Assembly-grapher/airframe/variants/single-boom-mini/stl/fit_test.stl

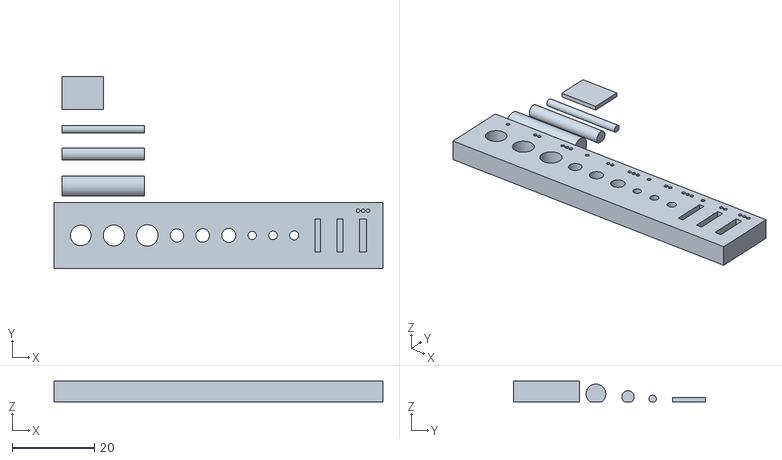
[picture p206: CAD file, 2026-10-25]
airframe/variants/single-boom-mini/stl/fit_test.stl
80.0 x 46.6 x 5.00
