henriharmaala1-source/Assembly-grapher/airframe/variants/single-boom-mini/stl/rod_spar_rear_L.stl

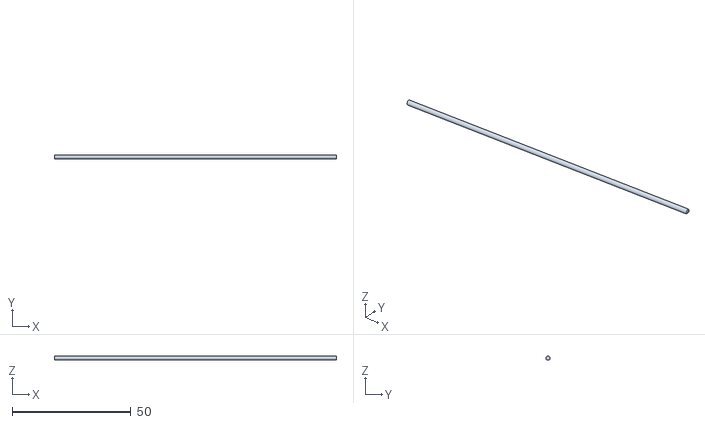
[picture p207: CAD file, 2026-10-25]
airframe/variants/single-boom-mini/stl/rod_spar_rear_L.stl
118.7 x 1.80 x 1.60
