henriharmaala1-source/Assembly-grapher/airframe/variants/single-boom-mini/stl/fairing_ail_L.stl

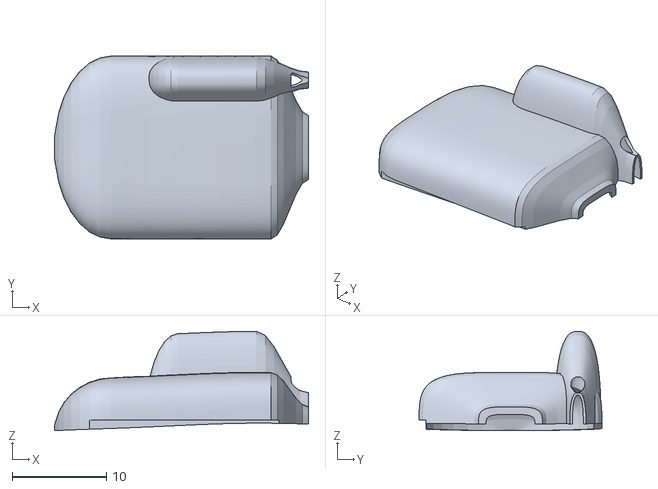
[picture p208: CAD file, 2026-10-25]
airframe/variants/single-boom-mini/stl/fairing_ail_L.stl
26.9 x 19.4 x 10.5
