henriharmaala1-source/Assembly-grapher/airframe/variants/single-boom-mini/stl/dummy_vtx.stl

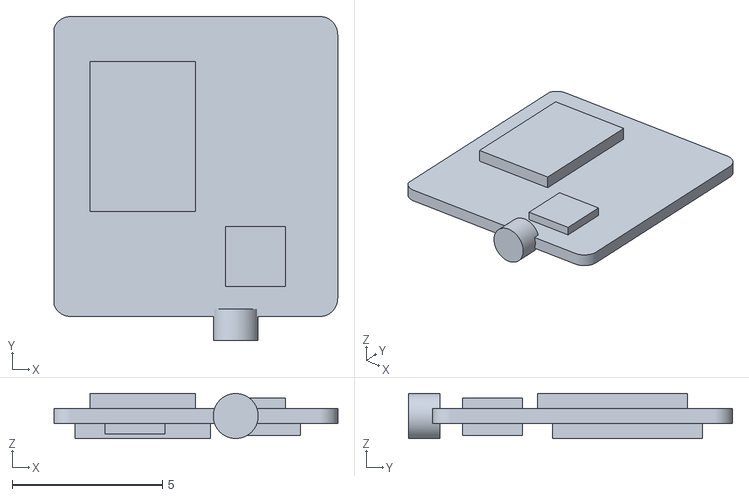
[picture p209: CAD file, 2026-10-25]
airframe/variants/single-boom-mini/stl/dummy_vtx.stl
9.45 x 10.8 x 1.50
