henriharmaala1-source/Assembly-grapher/airframe/variants/single-boom-mini/stl/dummy_esc.stl

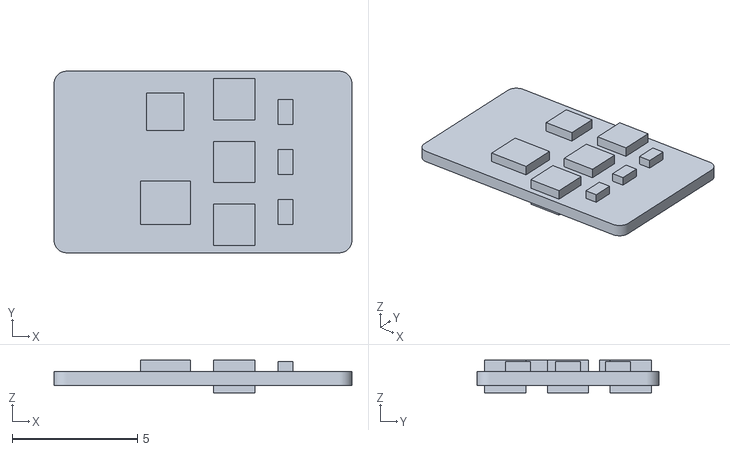
[picture p210: CAD file, 2026-10-25]
airframe/variants/single-boom-mini/stl/dummy_esc.stl
11.9 x 7.25 x 1.30
