henriharmaala1-source/Assembly-grapher/airframe/variants/single-boom-mini/stl/tail_mount.stl

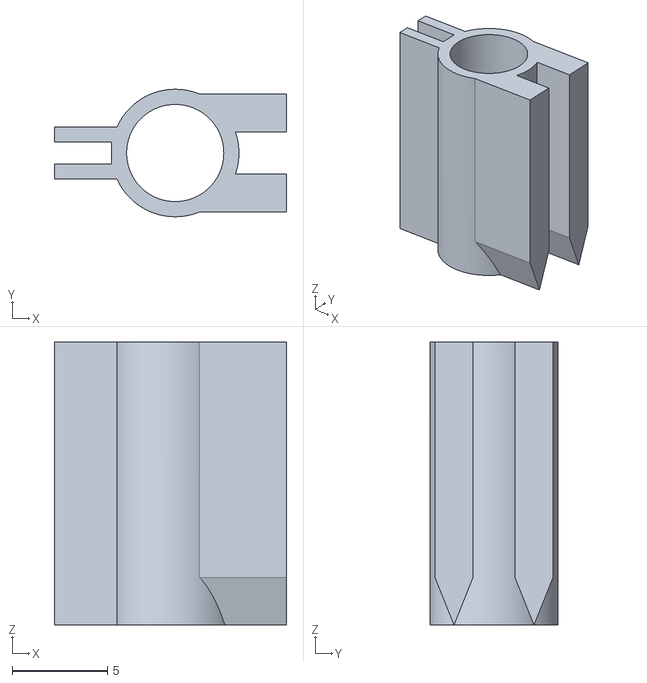
[picture p211: CAD file, 2026-10-25]
airframe/variants/single-boom-mini/stl/tail_mount.stl
12.2 x 6.70 x 14.9
