henriharmaala1-source/Assembly-grapher/airframe/variants/single-boom-mini/stl/dummy_antenna.stl

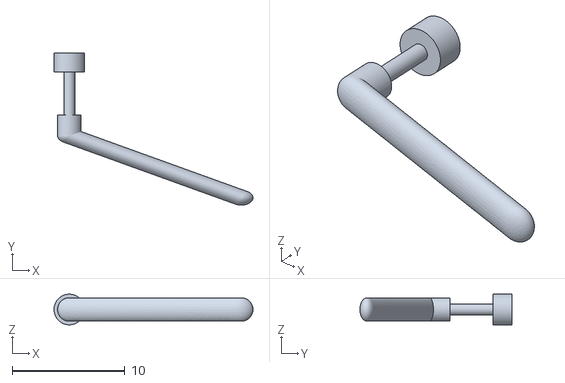
[picture p212: CAD file, 2026-10-23]
airframe/variants/single-boom-mini/stl/dummy_antenna.stl
17.6 x 13.5 x 2.72
