henriharmaala1-source/Assembly-grapher/airframe/variants/single-boom-mini/stl/stab.stl

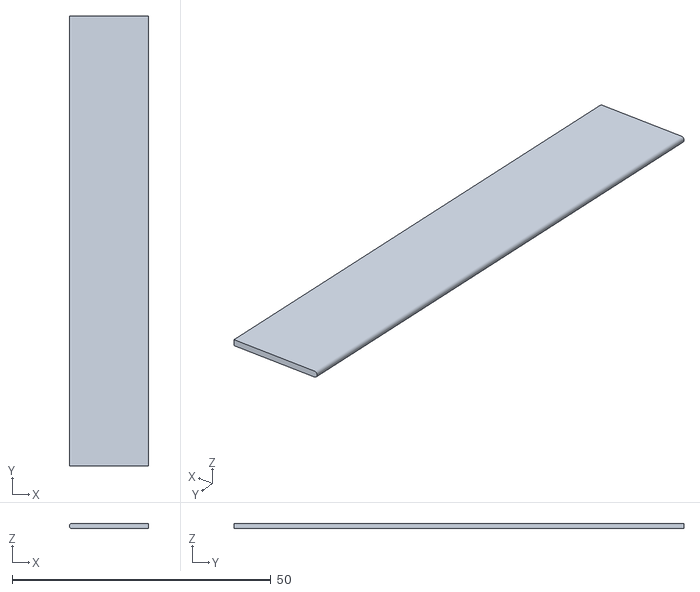
[picture p213: CAD file, 2026-10-23]
airframe/variants/single-boom-mini/stl/stab.stl
15.4 x 87.0 x 1.00
