henriharmaala1-source/Assembly-grapher/airframe/variants/single-boom-mini/stl/elevator.stl

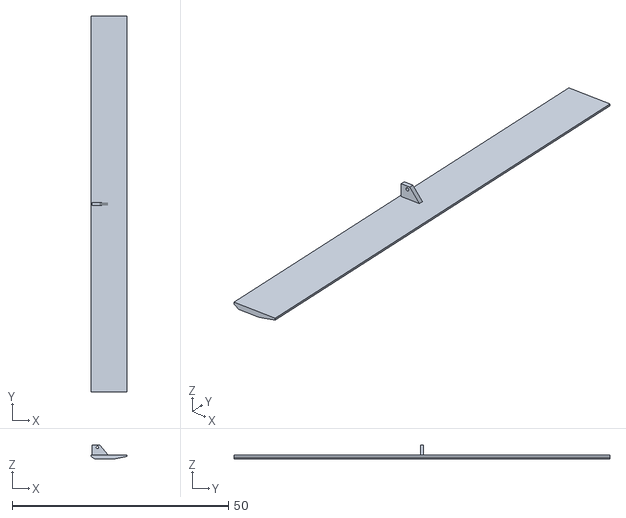
[picture p214: CAD file, 2026-10-23]
airframe/variants/single-boom-mini/stl/elevator.stl
8.34 x 86.9 x 3.35
