henriharmaala1-source/Assembly-grapher/(list of files, cad)

Other CAD files:
airframe/variants/single-boom-mini/stl/rod_spar_main_L.stl
airframe/variants/extreme/stl/wing_L.stl
airframe/variants/single-boom/stl/fairing_ail_R.stl
airframe/stl/aileron_R.stl
airframe/variants/extreme/stl/fairing_ail_L.stl
airframe/variants/optimized/stl/fairing_elev.stl
airframe/variants/optimized/stl/rudder_R.stl
airframe/variants/single-boom/stl/wing_R.stl
airframe/variants/single-boom/stl/aileron_R.stl
airframe/variants/optimized/stl/pod_front.stl
airframe/variants/optimized/stl/fairing_ail_L.stl
airframe/variants/single-boom/stl/fairing_ail_L.stl
airframe/stl/rudder_R.stl
airframe/variants/optimized/stl/aileron_R.stl
airframe/stl/wing_R.stl
airframe/variants/extreme/stl/aileron_L.stl
airframe/variants/optimized/stl/wing_L.stl
airframe/variants/extreme/stl/wing_outer_L.stl
airframe/variants/extreme/stl/motor_mount.stl
airframe/variants/optimized/stl/rudder_L.stl
airframe/variants/optimized/stl/elevator.stl
airframe/variants/optimized/stl/tail_mount.stl
airframe/variants/single-boom-mini/stl/wing_L.stl
airframe/variants/optimized/stl/stab.stl
airframe/variants/single-boom-mini/stl/dummy_servo_rud.stl
airframe/variants/optimized/stl/fin_R.stl
airframe/variants/single-boom-mini/stl/aileron_R.stl
airframe/variants/single-boom-mini/stl/dummy_servo_ail_L.stl
airframe/variants/single-boom-mini/stl/fairing_ail_R.stl
frames/mark4-v2-10/hardware/fit_gauge.stl
frames/mark4-v2-10/hardware/nut.step
frames/mark4-v2-10/hardware/nut.stl
frames/mark4-v2-10/hardware/pin_cap_m3x10.stl
frames/mark4-v2-10/hardware/pin_cap_m3x12.stl
frames/mark4-v2-10/hardware/pin_cap_m3x18.stl
frames/mark4-v2-10/hardware/pin_cap_m3x6.stl
frames/mark4-v2-10/hardware/pin_cap_m3x8.stl
frames/mark4-v2-10/hardware/standoff.stl
