henriharmaala1-source/Assembly-grapher/airframe/variants/extreme/preview/wiring.png

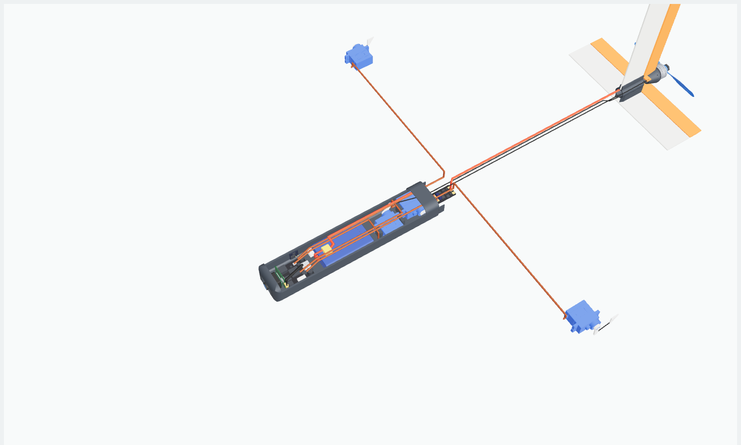
airframe/variants/extreme/preview/wiring.png
