henriharmaala1-source/Assembly-grapher/frames/mark4-v2-10/drawing.pdf

## Parts

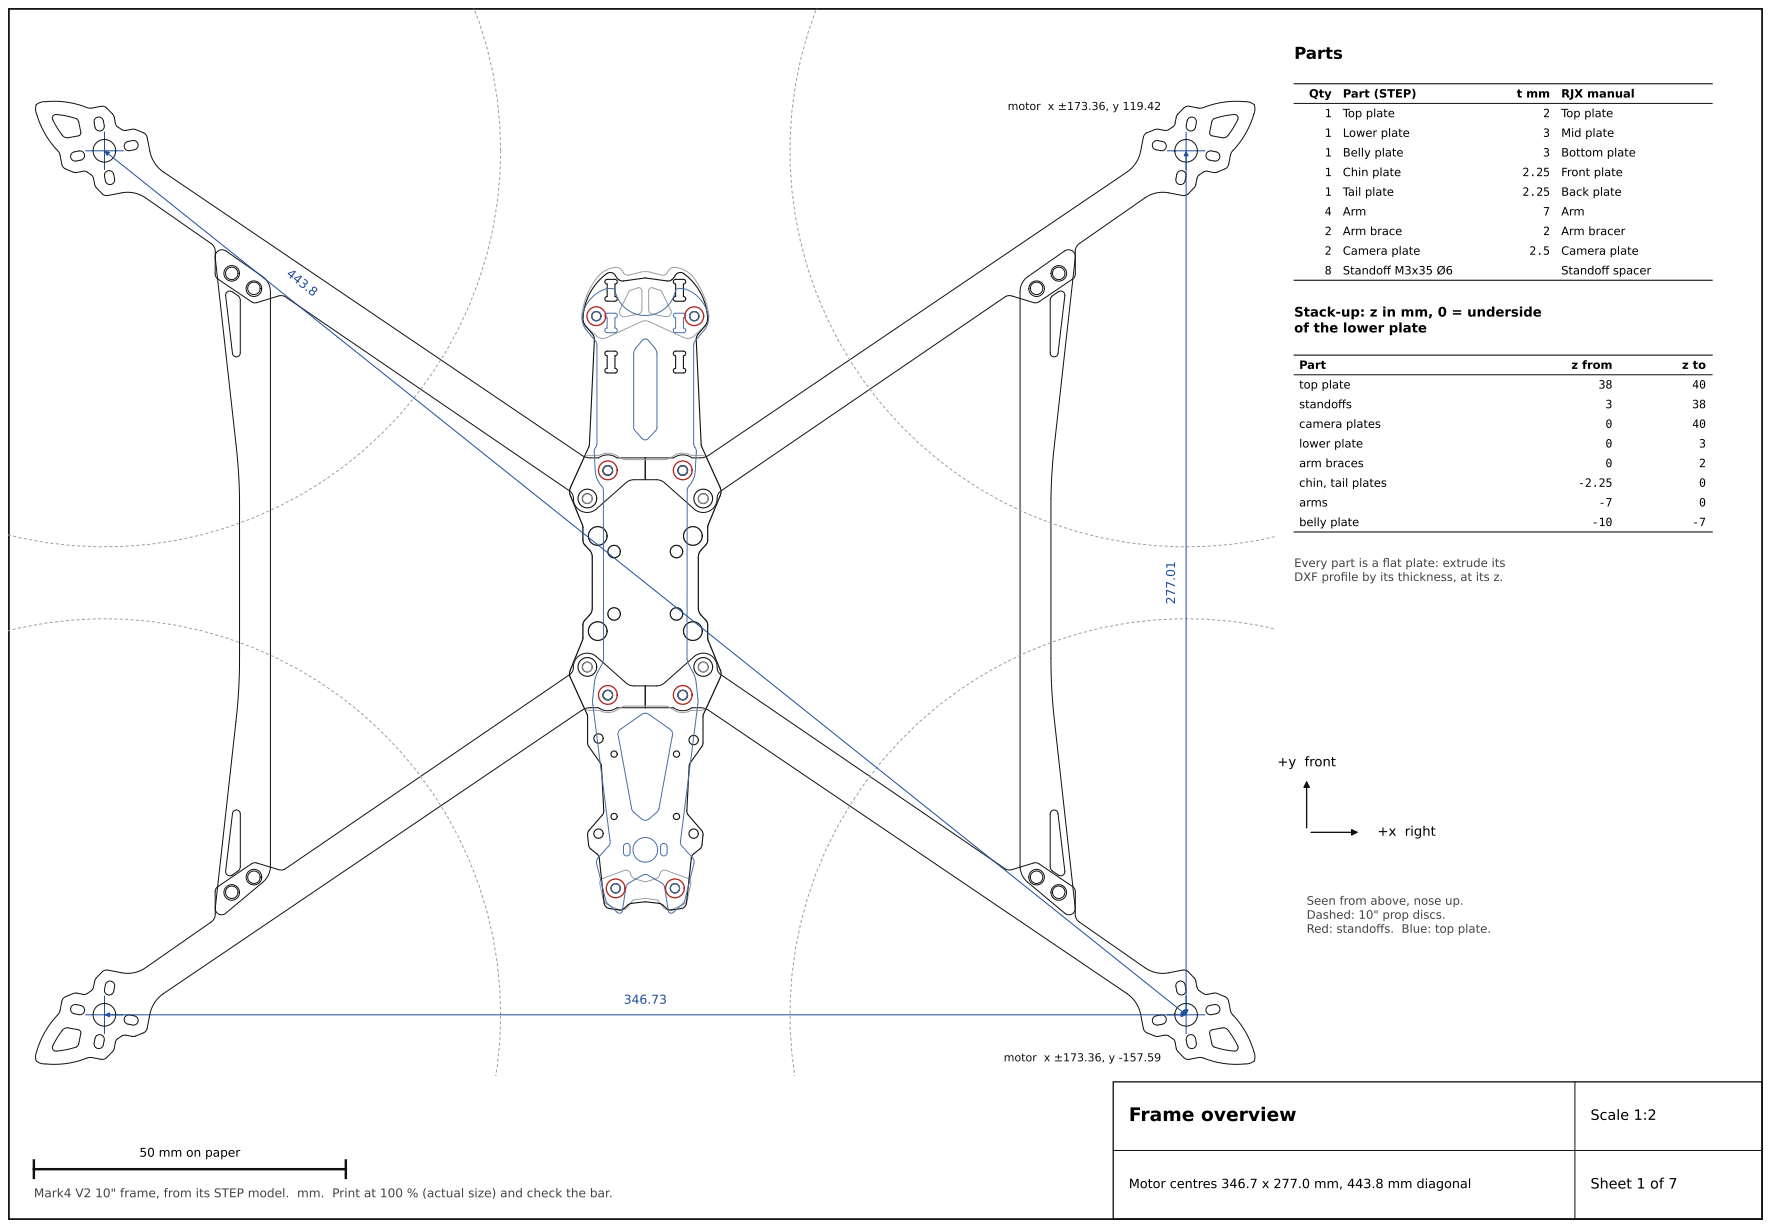
[picture p216: page 1]
Frame overview; Scale 1:2; +x right; +y front; Qty Part (STEP); t mm RJX manual; 1 Top plate; 2 Top plate; 1 Lower plate; 3 Mid plate; 1 Belly plate; 3 Bottom plate; 1 Chin plate; 2.25 Front plate; 1 Tail plate; 2.25 Back plate; 4 Arm; 7 Arm; 2 Arm brace; 2 Arm bracer; 2 Camera plate; 2.5 Camera plate; 8 Standoff M3x35 Ø6; Standoff spacer; Part; z from; top plate; standoffs; camera plates; lower plate; arm braces; chin, tail plates; arms; belly plate; motor x ±173.36, y 119.42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

Stack-up: z in mm, 0 = underside
of the lower plate

Every part is a flat plate: extrude its
DXF profile by its thickness, at its z.

Seen from above, nose up.
Dashed: 10" prop discs.
Red: standoffs. Blue: top plate.

50 mm on paper

Sheet 1 of 7 Mark4 V2 10" frame, from its STEP model. mm. Print at 100 % (actual size) and check the bar.

Motor centres 346.7 x 277.0 mm, 443.8 mm diagonal

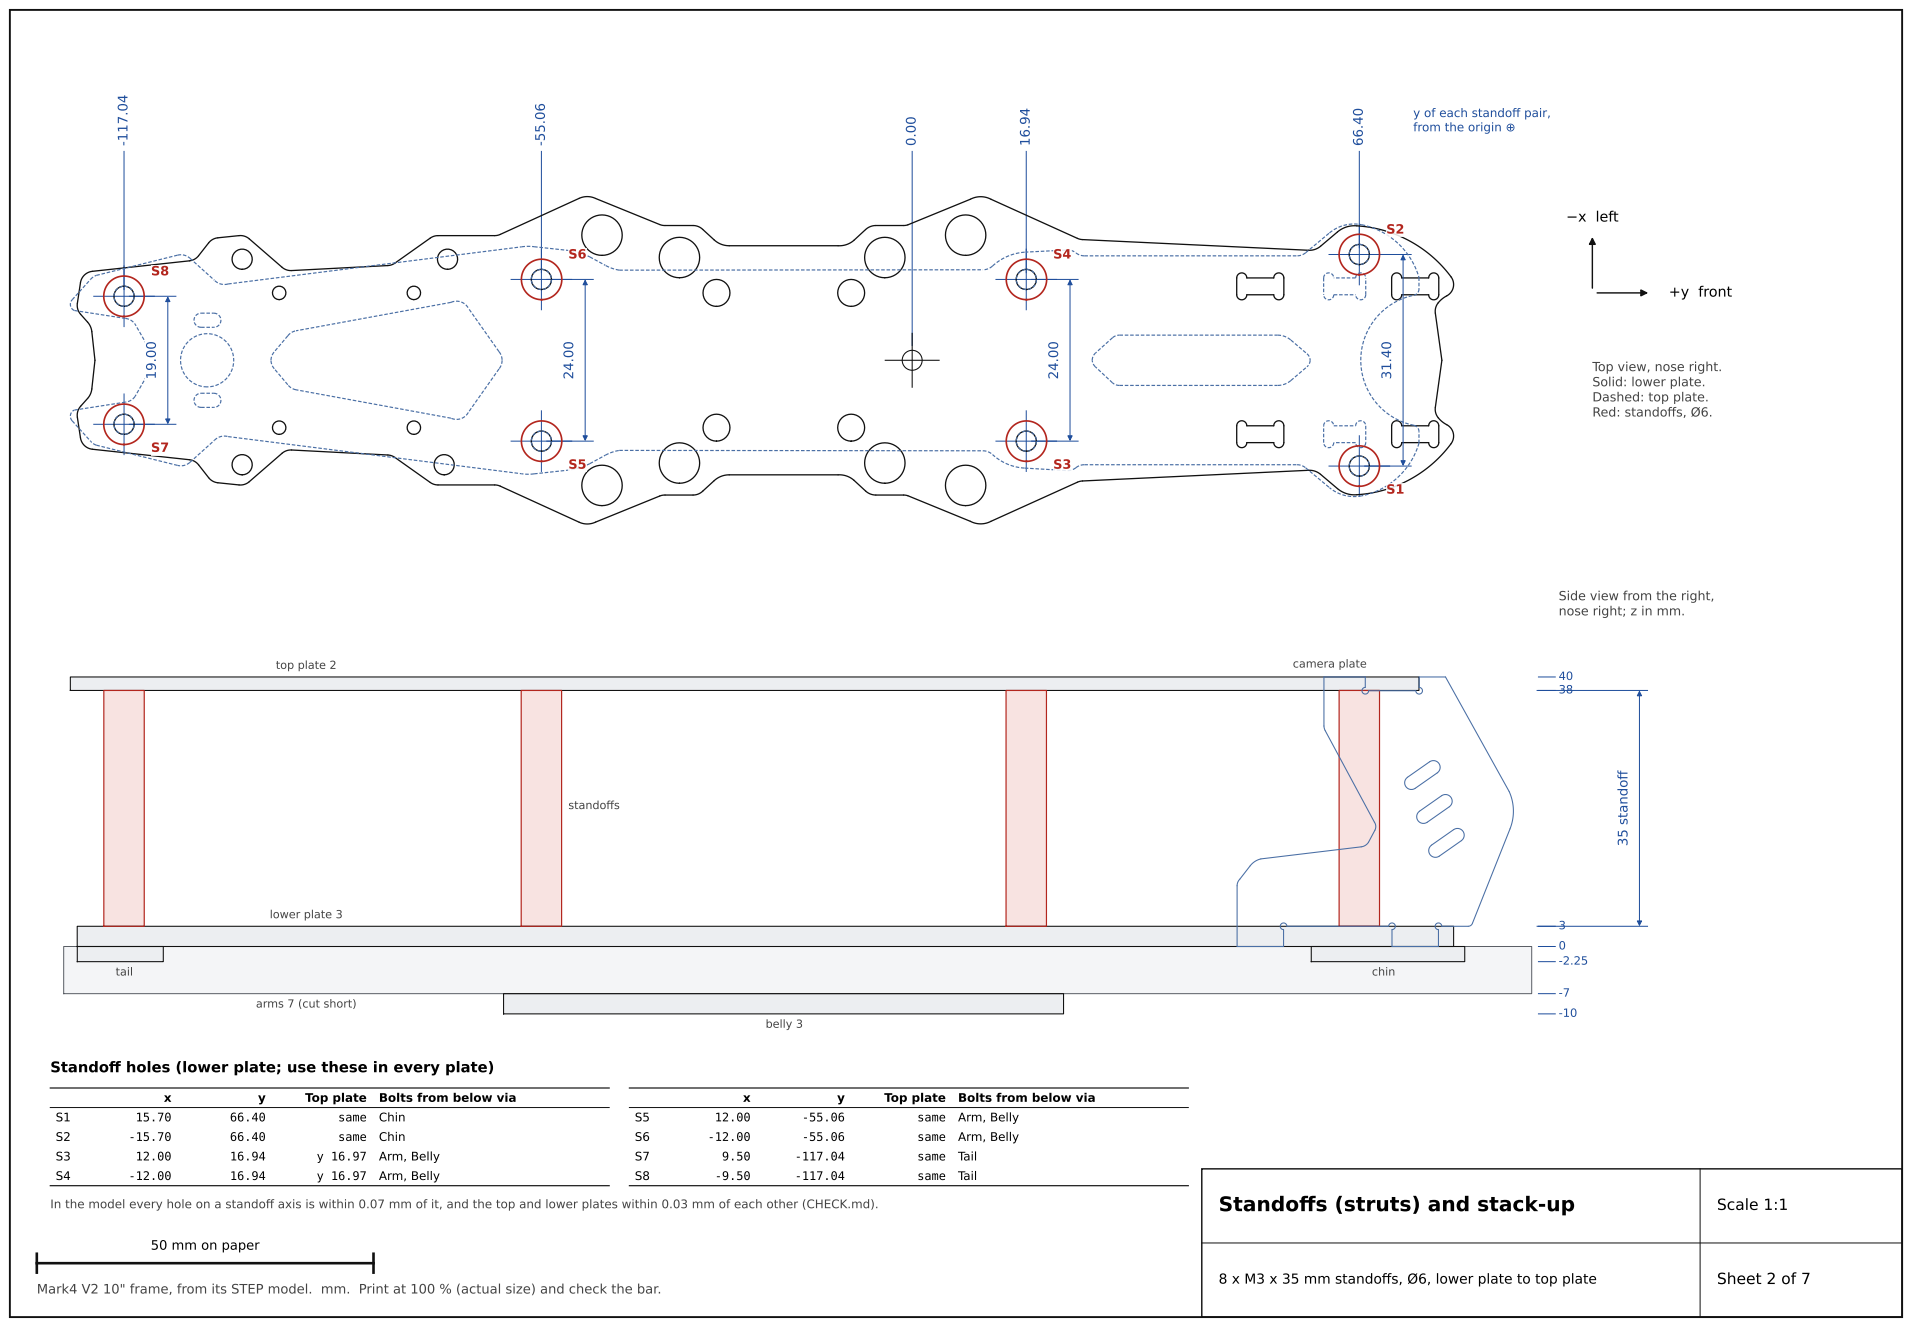
[picture p217: page 2]
Scale 1:1; +y front; −x left; 35 standoff; top plate 2; lower plate 3; standoffs; camera plate; belly 3; tail; chin; Top plate Bolts from below via; same Chin; y 16.97 Arm, Belly; same Arm, Belly; same Tail

y of each standoff pair,
from the origin ⊕

Top view, nose right.
Solid: lower plate.
Dashed: top plate.
Red: standoffs, Ø6.

Side view from the right,
nose right; z in mm.

arms 7 (cut short)

Standoff holes (lower plate; use these in every plate)

In the model every hole on a standoff axis is within 0.07 mm of it, and the top and lower plates within 0.03 mm of each other (CHECK.md).

Standoffs (struts) and stack-up

50 mm on paper

Sheet 2 of 7 Mark4 V2 10" frame, from its STEP model. mm. Print at 100 % (actual size) and check the bar.

8 x M3 x 35 mm standoffs, Ø6, lower plate to top plate

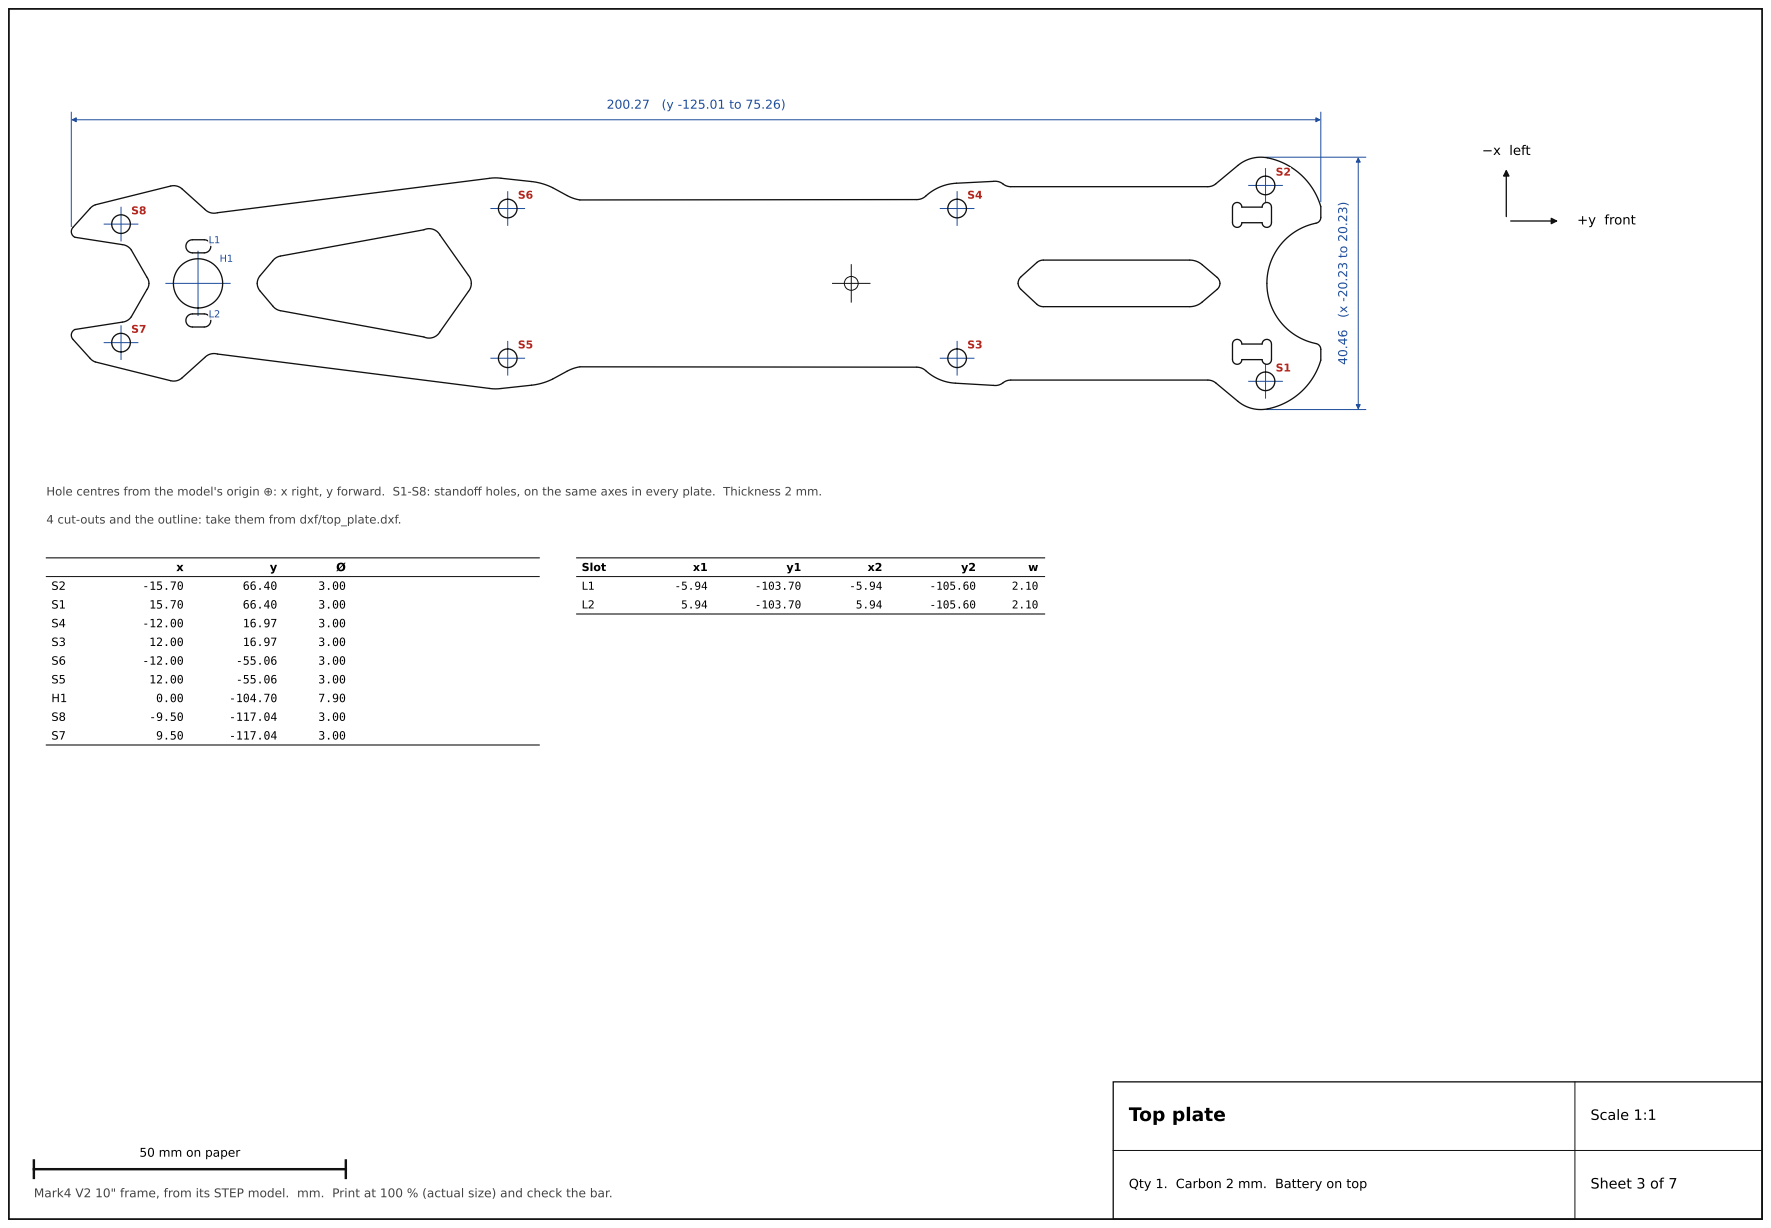
[picture p218: page 3]
Top plate; Scale 1:1; +y front; −x left; Slot

Hole centres from the model's origin ⊕: x right, y forward. S1-S8: standoff holes, on the same axes in every plate. Thickness 2 mm.

4 cut-outs and the outline: take them from dxf/top_plate.dxf.

50 mm on paper

Sheet 3 of 7 Mark4 V2 10" frame, from its STEP model. mm. Print at 100 % (actual size) and check the bar.

Qty 1. Carbon 2 mm. Battery on top

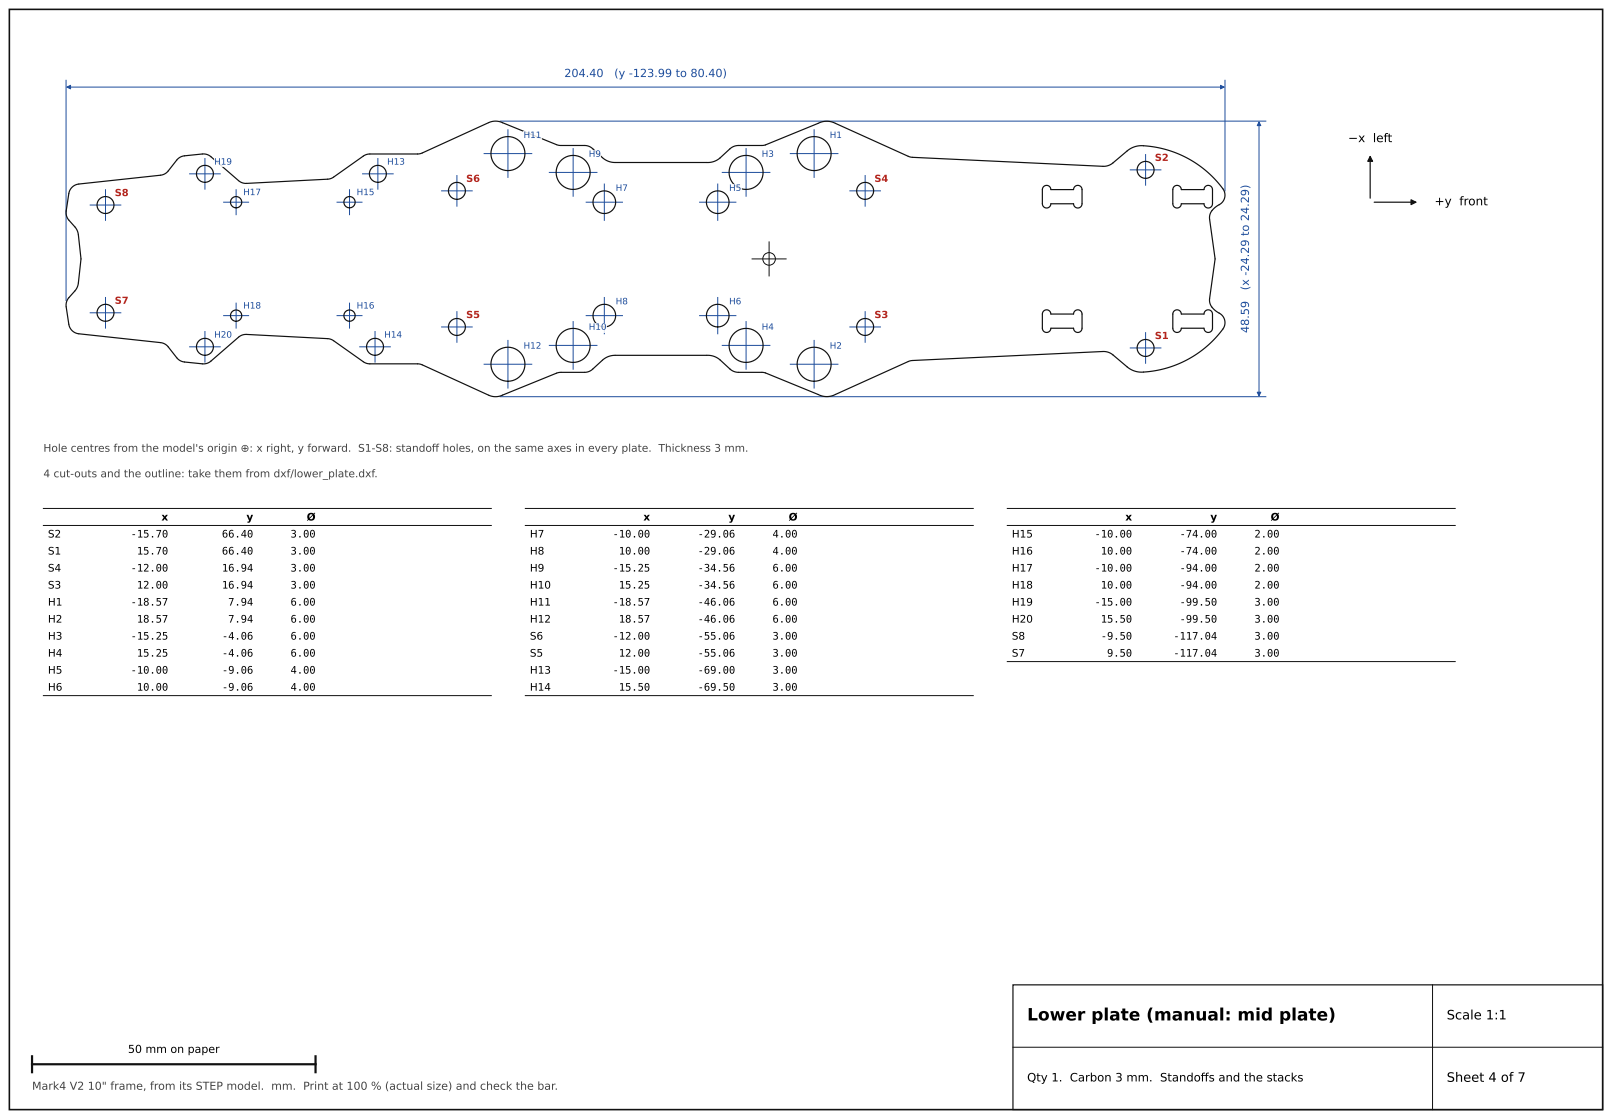
[picture p219: page 4]
Scale 1:1; +y front; −x left

Hole centres from the model's origin ⊕: x right, y forward. S1-S8: standoff holes, on the same axes in every plate. Thickness 3 mm.

4 cut-outs and the outline: take them from dxf/lower_plate.dxf.

Lower plate (manual: mid plate)

50 mm on paper

Sheet 4 of 7 Mark4 V2 10" frame, from its STEP model. mm. Print at 100 % (actual size) and check the bar.

Qty 1. Carbon 3 mm. Standoffs and the stacks

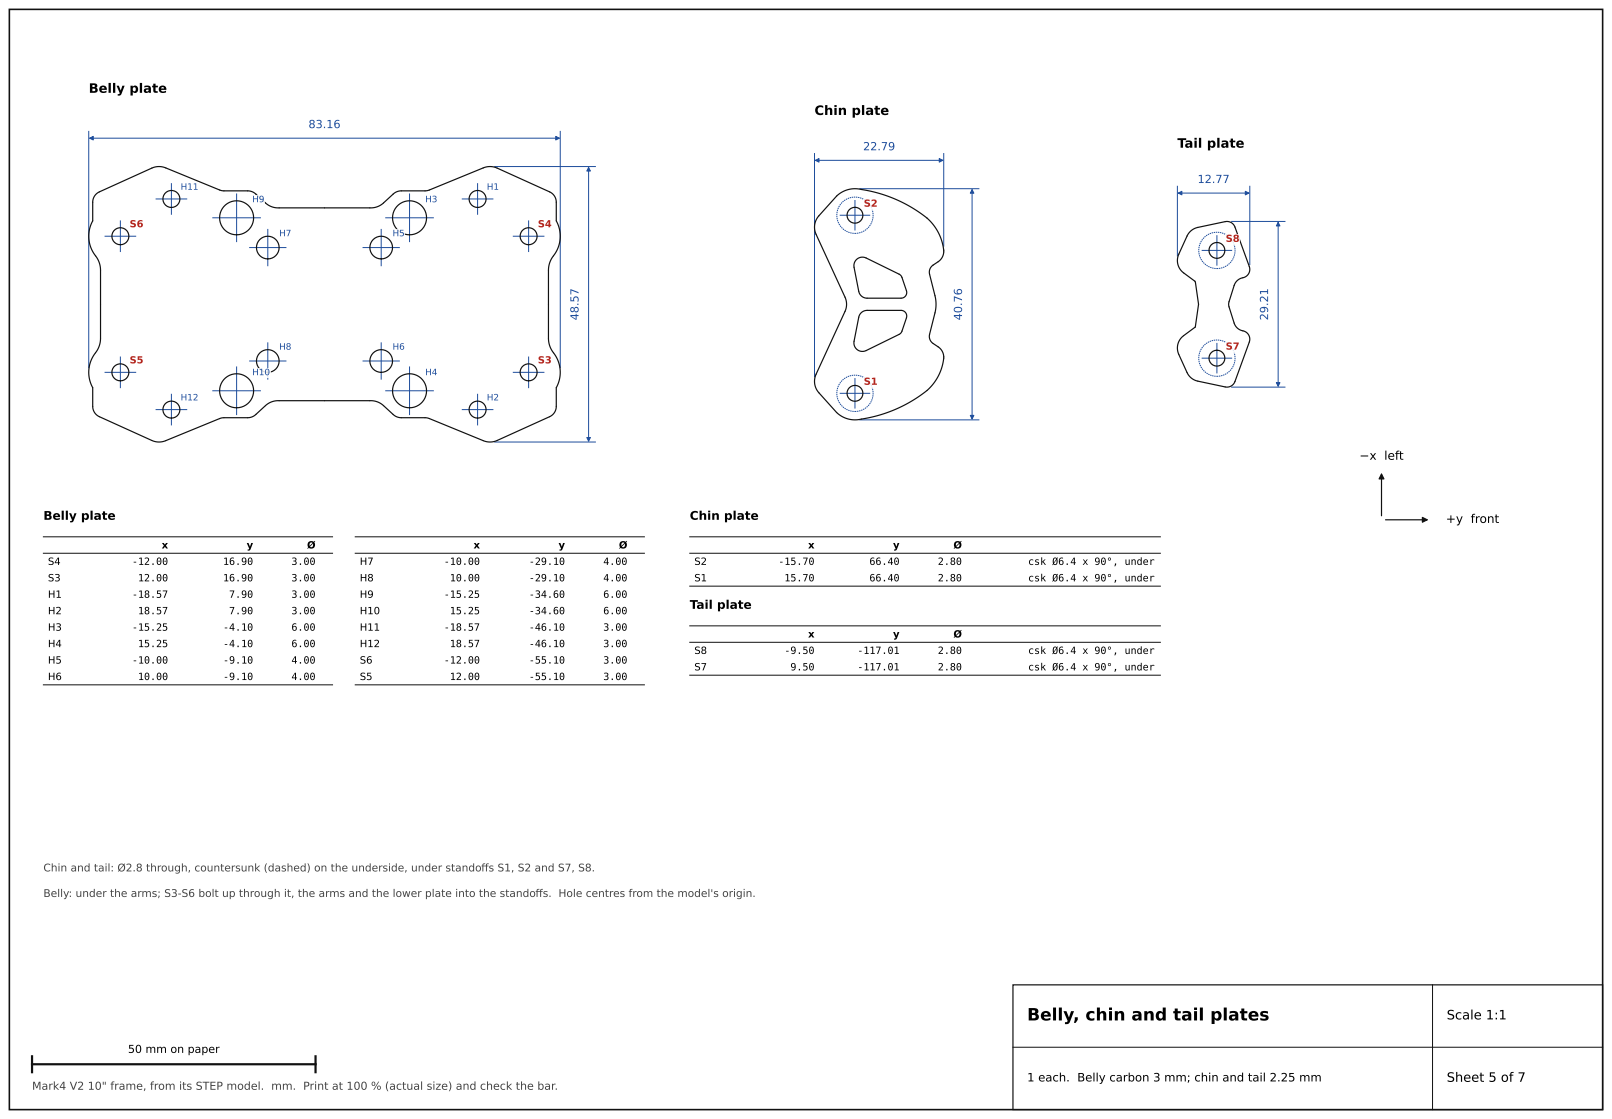
[picture p220: page 5]
Scale 1:1; Belly plate; Chin plate; Tail plate; +y front; −x left; csk Ø6.4 x 90°, under

Chin and tail: Ø2.8 through, countersunk (dashed) on the underside, under standoffs S1, S2 and S7, S8.

Belly: under the arms; S3-S6 bolt up through it, the arms and the lower plate into the standoffs. Hole centres from the model's origin.

Belly, chin and tail plates

50 mm on paper

Sheet 5 of 7 Mark4 V2 10" frame, from its STEP model. mm. Print at 100 % (actual size) and check the bar.

1 each. Belly carbon 3 mm; chin and tail 2.25 mm

H1 | 173.36 | 119.42 | 7.25
H2 | 132.53 | 80.13 | 4.00

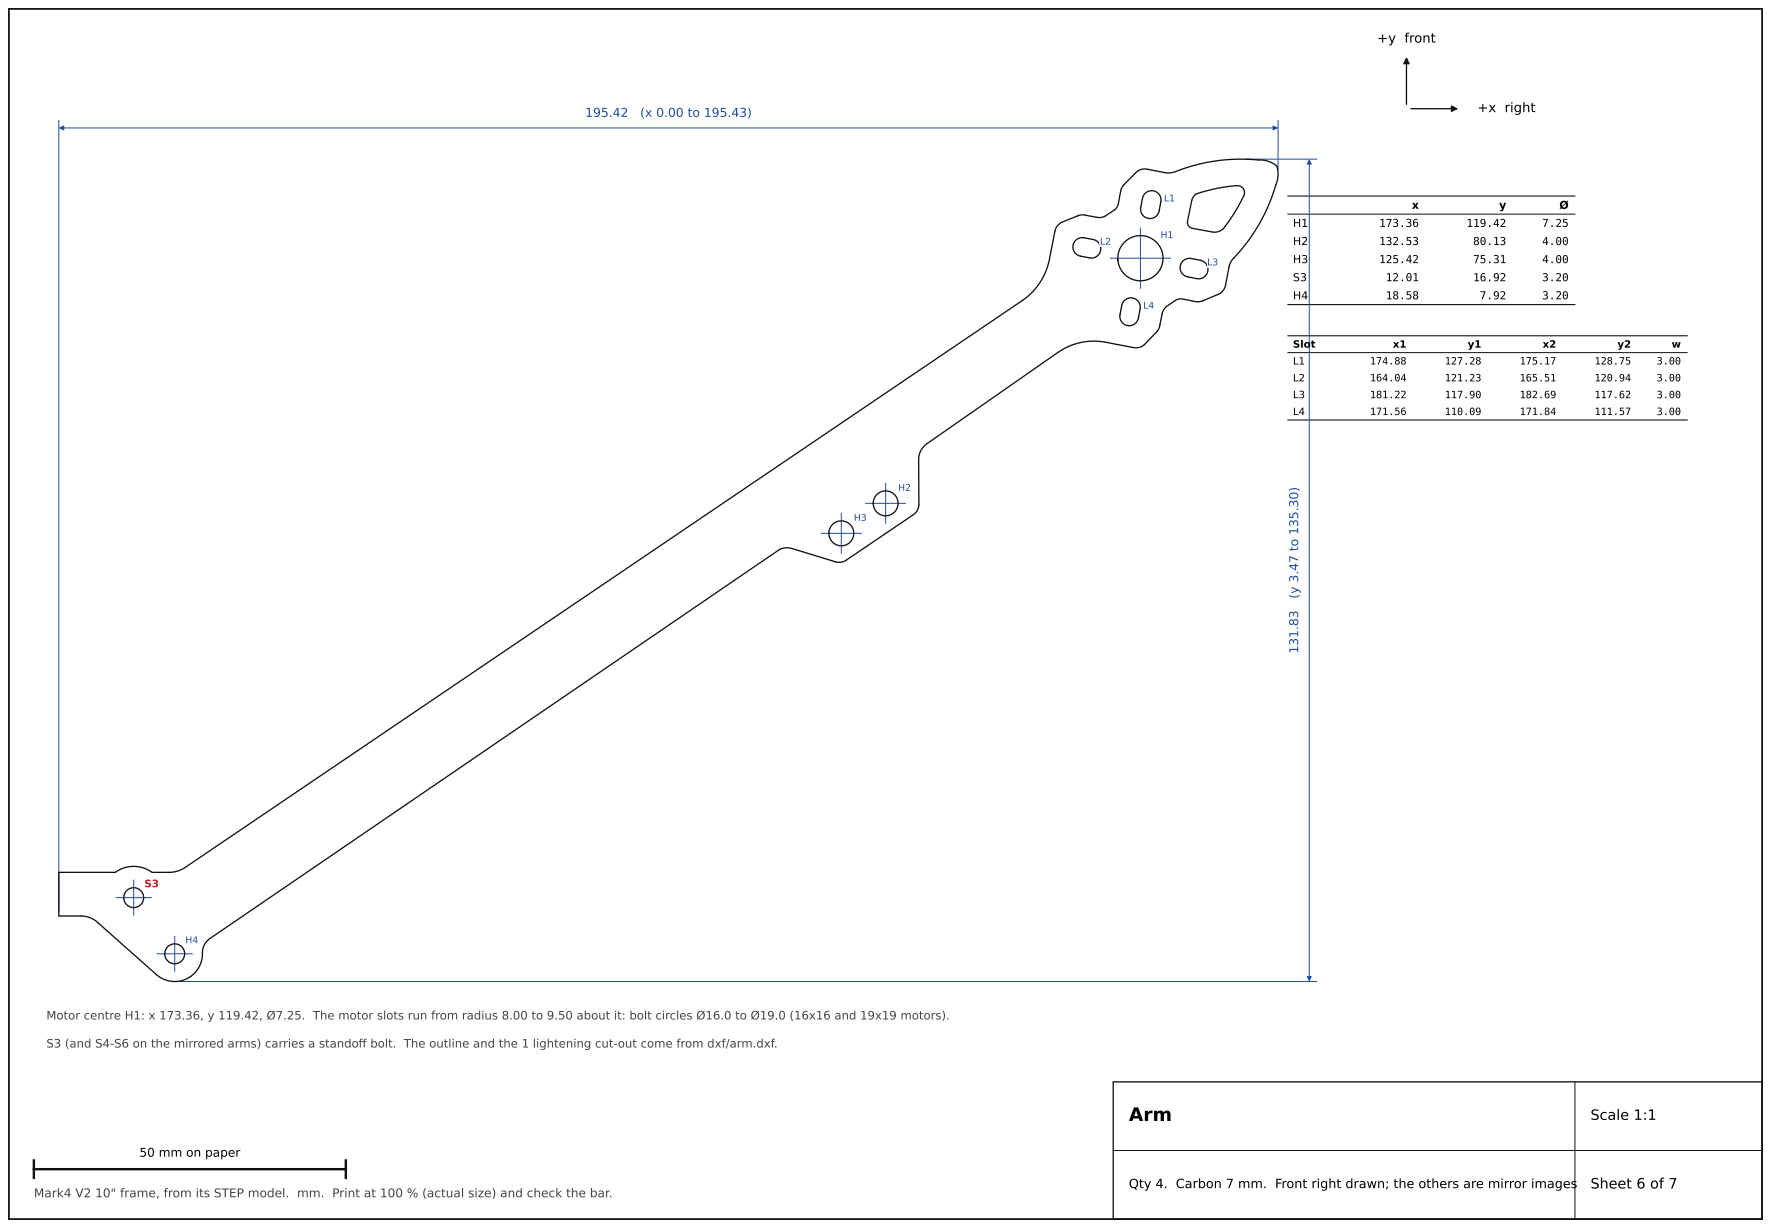
[picture p221: page 6]
Arm; Scale 1:1; +x right; +y front; Slot

Motor centre H1: x 173.36, y 119.42, Ø7.25. The motor slots run from radius 8.00 to 9.50 about it: bolt circles Ø16.0 to Ø19.0 (16x16 and 19x19 motors).

S3 (and S4-S6 on the mirrored arms) carries a standoff bolt. The outline and the 1 lightening cut-out come from dxf/arm.dxf.

50 mm on paper

Sheet 6 of 7 Mark4 V2 10" frame, from its STEP model. mm. Print at 100 % (actual size) and check the bar.

Qty 4. Carbon 7 mm. Front right drawn; the others are mirror images

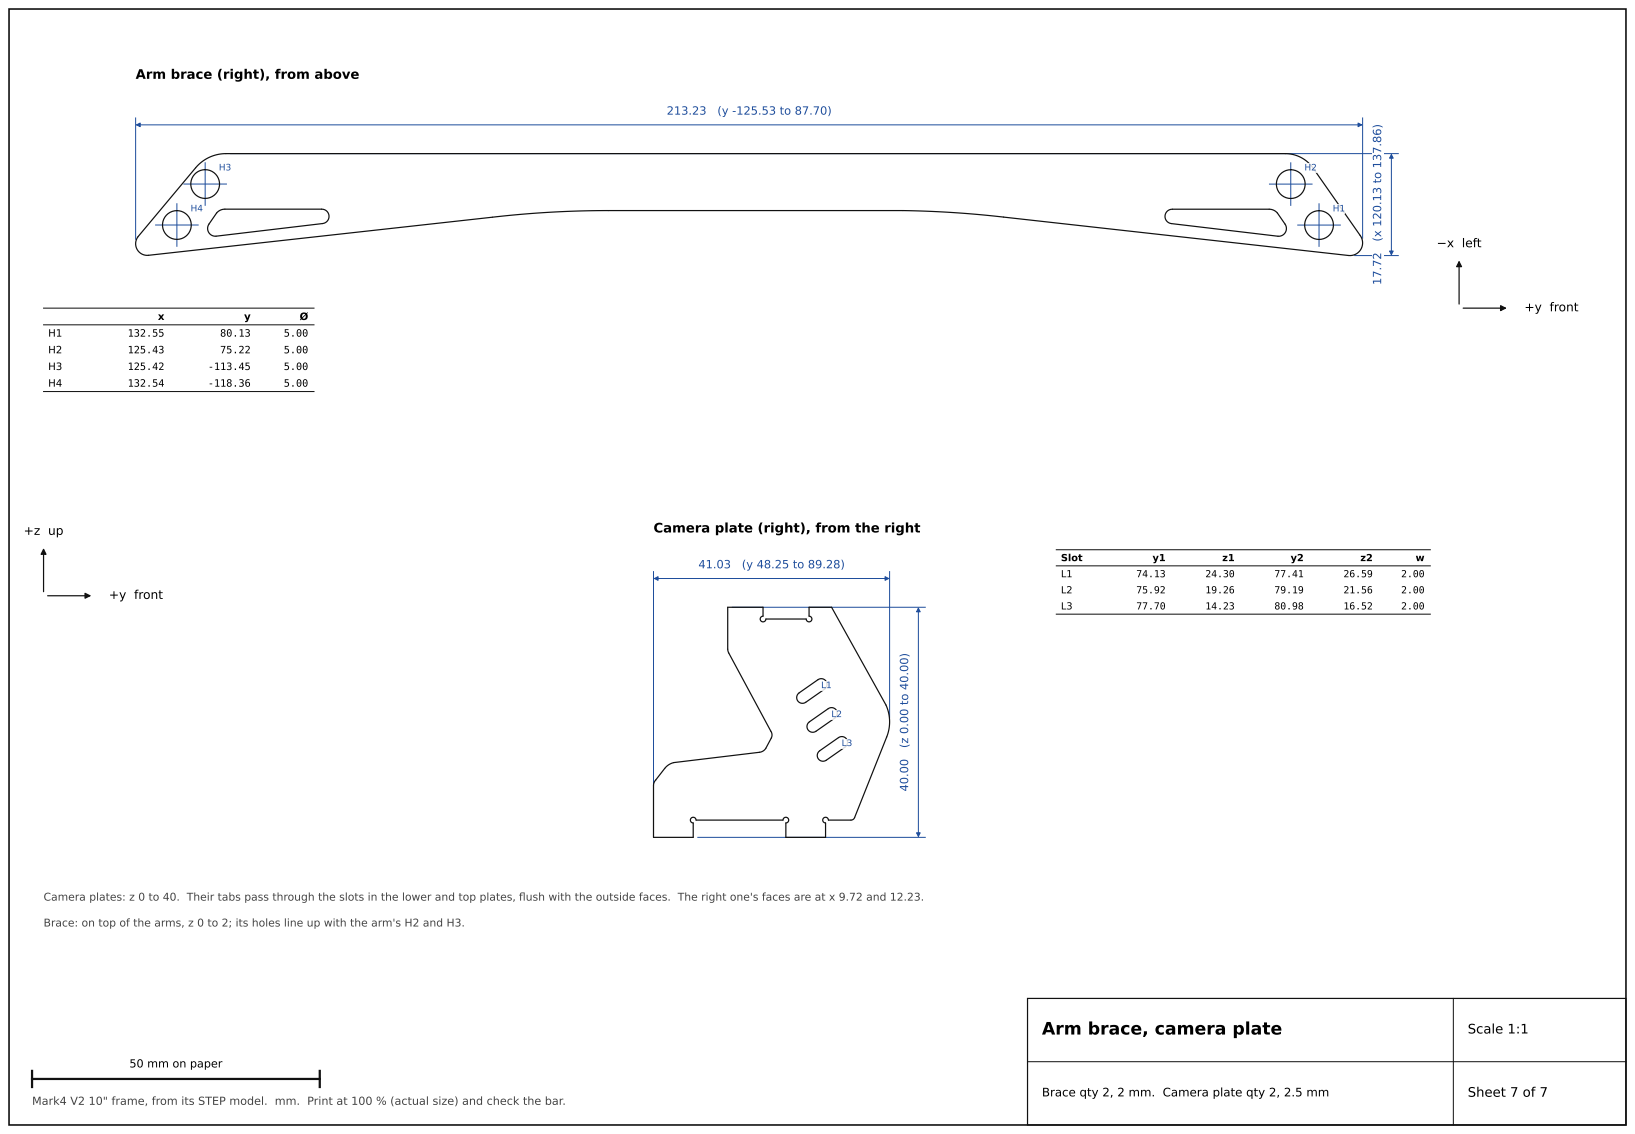
[picture p222: page 7]
Scale 1:1; +y front; −x left; Slot

Arm brace (right), from above

Camera plate (right), from the right

Camera plates: z 0 to 40. Their tabs pass through the slots in the lower and top plates, flush with the outside faces. The right one's faces are at x 9.72 and 12.23.

Brace: on top of the arms, z 0 to 2; its holes line up with the arm's H2 and H3.

Arm brace, camera plate

50 mm on paper

Sheet 7 of 7 Mark4 V2 10" frame, from its STEP model. mm. Print at 100 % (actual size) and check the bar.

Brace qty 2, 2 mm. Camera plate qty 2, 2.5 mm
