henriharmaala1-source/Assembly-grapher/aero/variants.py

#!/usr/bin/env python3
"""The four Kipinä CAD builds side by side: their weights, and what the
weight differences do to the way each flies.

    python3 airframe/build.py                         # as built (airframe/viewer/spec.json)
    python3 airframe/build.py --variant optimized     # optimized (airframe/variants/optimized/)
    python3 airframe/build.py --variant single-boom   # single boom (airframe/variants/single-boom/)
    python3 aero/extreme.py                           # the extreme-aero design study (aero/study/extreme.json)
    python3 airframe/build.py --variant extreme       # extreme aero (airframe/variants/extreme/)
    python3 aero/variants.py                          # airframe/variants/compare.json and COMPARE.md

The optimized plane has the efficiency study's airfoil and the drag optimizer's
detail changes; the single boom is the same plane rebuilt round one carbon boom
with the motor on its end; the extreme-aero plane is the single boom with the
longer, tapered and twisted wing and the tail aero/extreme.py picks.

Each variant flies at its own CAD weight with its own aerodynamics: the wing's
profile drag from NeuralFoil with its airfoil at the lift it needs, every other
part from the drag build-up (aero/models/airframe.py) with its details, and the
induced drag as in the efficiency study. The extreme-aero wing is not straight,
so it flies on aero/extreme.py's lifting line instead, with the profile drag
strip by strip along the span (on that model the single boom needs 0.8 % more
power at 13 m/s than here: the differences between the planes are much larger). The maximum lift follows each
airfoil's own section maximum. Both have the same motor and prop, so the
thrust is the as-built plane's (1:1 static, falling to zero at the pitch
speed) for both.

Each plane's aerodynamics are also flown at each other plane's weight. That
splits any pair's difference into what the aerodynamics give and what the
weight takes back. A weight sweep shows how each design's flight changes with
every gram.
"""
from __future__ import annotations

import json
import math
import sys
import time
from functools import lru_cache
from pathlib import Path

HERE = Path(__file__).resolve().parent
ROOT = HERE.parent
sys.path.insert(0, str(HERE))

import numpy as np  # noqa: E402

import airfoil as A  # noqa: E402
from models import airframe as AF  # noqa: E402

D = AF.D
OUT = ROOT / "airframe" / "variants"
RHO, G = 1.225, 9.81
V_CRUISE = AF.SPEED
SPEEDS = np.round(np.arange(7.5, 24.01, 0.25), 2)
MASSES = np.arange(195.0, 265.01, 5.0)
USABLE = 0.8                                  # of the battery's energy
VOLTS = 7.4


# key, label, the build's variant directory
BUILDS = (("baseline", "As built", None), ("optimized", "Optimized", "optimized"), ("single", "Single boom", "single-boom"),
          ("extreme", "Extreme aero", "extreme"))


def spec(variant: str) -> dict:
    path = ROOT / "airframe" / ("viewer" if variant is None else f"variants/{variant}/viewer") / "spec.json"
    return json.loads(path.read_text())


def kulfan(study: dict, key: str) -> dict:
    k = study["shapes"][key]["kulfan"]
    return {"upper_weights": np.array(k["upper_weights"]), "lower_weights": np.array(k["lower_weights"]),
            "leading_edge_weight": k["leading_edge_weight"], "TE_thickness": k["TE_thickness"]}


class Plane:
    """One configuration: aerodynamics (airfoil and details) and a weight."""

    def __init__(self, label: str, section: str, details: dict, mass_g: float, study: dict):
        self.label, self.section, self.details, self.mass = label, section, dict(details), mass_g
        self.kulfan = kulfan(study, section)
        self.n_crit = study["n_crit"]
        base = D.single_boom(AF.BASE) if details.get("single_boom") else AF.BASE
        L, _, _ = D.evaluate(base, AF.KIT)
        self.L = L
        self.s = L.area * 1e-6
        self.c = L.chord / 1000
        self.s_wet = self.s - 0.5 * 2 * L.half_w * L.chord * 1e-6     # the pod covers part of the centre
        self.ar = AF.BASE.aspect_ratio
        # 3D maximum lift: the design's 0.95, scaled by the section's own maximum
        self.clmax = AF.BASE.cl_max * study["sections"][section]["clmax"] / study["sections"]["baseline"]["clmax"]
        self.w = mass_g / 1000 * G
        k = AF.KIT
        self.v_pitch = k.motor_kv * k.v_loaded * k.rpm_frac / 60 * k.prop_pitch_in * 0.0254

    def at_mass(self, mass_g: float) -> "Plane":
        p = object.__new__(type(self))
        p.__dict__.update(self.__dict__)
        p.mass, p.w = mass_g, mass_g / 1000 * G
        return p

    def parasite(self, v: float) -> tuple[float, list]:
        """Drag area of everything but the wing and the junctions (m^2), and the items."""
        return _parasite(tuple(sorted(self.details.items())), round(v, 3))

    def drag(self, v: float, n: float = 1.0) -> dict:
        """Level (n = 1) or turning (load factor n) drag at speed v."""
        q = 0.5 * RHO * v * v
        cl = n * self.w / (q * self.s)
        re = v * self.c / 1.46e-5
        cd = _section_cd(self.section, round(min(cl, 1.25), 4), round(re, -2), self.n_crit, self)
        other, items = self.parasite(v)
        wing = cd * self.s_wet
        fp = other["fp"] + wing
        induced = q * self.s * cl * cl / (math.pi * AF.E_OSWALD * self.ar)
        total = q * (wing + other["all"] + 0.10 * fp) + induced
        return {"drag": total, "induced": induced, "wing": q * wing, "cl": cl, "cd_wing": cd,
                "items": [("wing profile", q * wing)] + [(nm, q * a) for nm, a in items]
                + [("junctions", q * 0.10 * fp), ("induced", induced)]}

    def thrust(self, v: float, t0: float) -> float:
        return max(0.0, t0 * (1 - v / self.v_pitch))


class ExtremePlane(Plane):
    """The extreme-aero build: its tapered, twisted wing on aero/extreme.py's
    lifting line and strip profile drag, the rest from its own layout."""

    def __init__(self, label: str, mass_g: float, study: dict):
        import extreme as X
        o = json.loads((HERE / "study" / "extreme.json").read_text())["chosen"]["design"]
        fields = X.Design.__dataclass_fields__
        self.d = X.Design(**{k: (tuple(v) if isinstance(v, list) else v) for k, v in o.items() if k in fields})
        self.X = X
        self.label, self.section, self.mass = label, "optimized", mass_g
        self.details = {k: float(v) for k, v in study["details"].items()}
        self.details.update(single_boom=1.0, boattail=0.0, joiners_hidden=0.0)
        self.kulfan = kulfan(study, "optimized")
        self.n_crit = study["n_crit"]
        self.L = X.layout(self.d)
        self.s, self.c, self.ar = self.d.area * 1e-6, self.d.mac / 1000, self.d.ar
        self.xp = X.Plane(self.d, mass_g)
        self.clmax = self.xp.clmax
        self.w = mass_g / 1000 * G
        k = AF.KIT
        self.v_pitch = k.motor_kv * k.v_loaded * k.rpm_frac / 60 * k.prop_pitch_in * 0.0254

    def at_mass(self, mass_g: float) -> "ExtremePlane":
        p = super().at_mass(mass_g)
        p.xp = self.X.Plane(self.d, mass_g)
        return p

    def drag(self, v: float, n: float = 1.0) -> dict:
        r = self.xp.drag(v, n)
        q = 0.5 * RHO * v * v
        return {"drag": r["drag"], "induced": r["induced"], "wing": r["wing"], "cl": r["CL"],
                "cd_wing": r["wing"] / (q * self.s), "items": r["items"]}


@lru_cache(maxsize=None)
def _parasite(details: tuple, v: float):
    x = {p.name: p.value for p in AF.params()}
    x.update(dict(details))
    items = [i for i in AF.evaluate(x, v).items if not i.name.startswith(("wing", "junctions"))]
    fp = sum(i.cda for i in items if i.group in ("friction", "pressure"))
    return {"all": sum(i.cda for i in items), "fp": fp}, [(i.name, i.cda) for i in items]


_CD = {}


def _section_cd(section: str, cl: float, re: float, n_crit: float, plane: Plane) -> float:
    key = (section, cl, re, n_crit)
    if key not in _CD:
        alpha = A.alpha_for(plane.kulfan, cl, re, n_crit)
        _CD[key] = float(np.squeeze(A.aero(plane.kulfan, alpha, re, n_crit)["CD"]))
    return _CD[key]


def fly(p: Plane, t0: float, curves: bool = True) -> dict:
    """Everything about how one configuration flies."""
    w, s = p.w, p.s
    stall = math.sqrt(2 * w / (RHO * s * p.clmax))
    rows = []
    for v in SPEEDS:
        if v < stall * 1.02:
            continue
        d = p.drag(v)
        power = d["drag"] * v / AF.ETA_PROP + AF.AVIONICS_W
        t = p.thrust(v, t0)
        rows.append({"v": float(v), "drag": d["drag"], "power": power, "ld": w / d["drag"],
                     "sink": d["drag"] * v / w, "climb": (t - d["drag"]) * v / w, "thrust": t,
                     "endurance": USABLE * AF.KIT.batt_wh / power * 60,
                     "range": USABLE * AF.KIT.batt_wh / power * 3600 * v / 1000})
    cruise = min(rows, key=lambda r: abs(r["v"] - V_CRUISE))
    dc = p.drag(cruise["v"])
    pmin = min(rows, key=lambda r: r["power"])
    ld = max(rows, key=lambda r: r["ld"])
    sink = min(rows, key=lambda r: r["sink"])
    rng = max(rows, key=lambda r: r["range"])
    climb = max(rows, key=lambda r: r["climb"])
    top = None                                        # where the climb rate crosses zero, between grid speeds
    for r0, r1 in zip(rows, rows[1:]):
        if r0["climb"] >= 0 > r1["climb"]:
            top = round(r0["v"] + (r1["v"] - r0["v"]) * r0["climb"] / (r0["climb"] - r1["climb"]), 2)
    if top is None and rows and rows[-1]["climb"] >= 0:
        top = rows[-1]["v"]
    # turns at the cruise speed: stall-limited, and the tightest the thrust can hold
    q = 0.5 * RHO * V_CRUISE ** 2
    n_stall = q * s * p.clmax / w
    n_sus, t_c = 1.0, p.thrust(V_CRUISE, t0)
    for n in np.arange(1.0, n_stall, 0.01):
        if p.drag(V_CRUISE, n)["drag"] > t_c:
            break
        n_sus = float(n)
    radius = lambda n: V_CRUISE ** 2 / (G * math.sqrt(n * n - 1)) if n > 1.0005 else None  # noqa: E731
    out = {
        "label": p.label, "mass": round(p.mass, 1), "loading": round(p.mass / (p.L.area / 1e4), 1),
        "clmax": round(p.clmax, 3), "stall": round(stall, 2),
        "cruise_v": cruise["v"], "drag_cruise": round(cruise["drag"], 4), "power_cruise": round(cruise["power"], 2),
        "current_cruise": round(cruise["power"] / VOLTS, 2), "endurance_cruise": round(cruise["endurance"], 1),
        "range_cruise": round(cruise["range"], 2), "cl_cruise": round(dc["cl"], 3),
        "induced_cruise": round(dc["induced"], 4),
        "v_power_min": pmin["v"], "power_min": round(pmin["power"], 2), "endurance_max": round(pmin["endurance"], 1),
        "v_ld_max": ld["v"], "ld_max": round(ld["ld"], 2),
        "v_range_max": rng["v"], "range_max": round(rng["range"], 2),
        "v_sink_min": sink["v"], "sink_min": round(sink["sink"], 3), "glide_max": round(ld["ld"], 2),
        "v_climb_max": climb["v"], "climb_max": round(climb["climb"], 2),
        "climb_angle": round(math.degrees(math.asin(max(-1.0, min(1.0, climb["climb"] / climb["v"])))), 1),
        "top": top,
        "turn_n_stall": round(n_stall, 2),
        "turn_bank_stall": round(math.degrees(math.acos(1 / n_stall)), 1) if n_stall > 1 else None,
        "turn_radius_stall": round(radius(n_stall), 1) if radius(n_stall) else None,
        "turn_n_sustained": round(n_sus, 2),
        "turn_bank_sustained": round(math.degrees(math.acos(1 / n_sus)), 1) if n_sus >= 1 else None,
        "turn_radius_sustained": round(radius(n_sus), 1) if radius(n_sus) else None,
        "items_cruise": [(nm, round(val, 4)) for nm, val in dc["items"]],
    }
    if curves:
        out["curves"] = {k: [round(r[k], 4) for r in rows] for k in ("drag", "power", "ld", "sink", "climb", "endurance")}
        out["curves"]["v"] = [r["v"] for r in rows]
    return out


def main():
    t0_clock = time.time()
    study = json.loads((ROOT / "aero" / "study" / "study.json").read_text())
    specs = {k: spec(d) for k, _, d in BUILDS}
    mass = {k: specs[k].get("auw_g", specs[k]["auw"]) for k in specs}
    details = {k: float(v) for k, v in study["details"].items()}
    dets = {"baseline": {k: 0.0 for k in details}, "optimized": details,
            "single": dict(details, single_boom=1.0, boattail=0.0, joiners_hidden=0.0)}
    sections = {"baseline": "baseline", "optimized": "optimized", "single": "optimized"}
    planes = {k: ExtremePlane(label, mass[k], study) if k == "extreme" else Plane(label, sections[k], dets[k], mass[k], study)
              for k, label, _ in BUILDS}
    t0 = mass["baseline"] / 1000 * G                      # the same motor and prop: 1:1 static for the as-built plane
    print("  ".join(f"{p.label} {p.mass:.1f} g" for p in planes.values()), flush=True)
    cases = {k: fly(p, t0) for k, p in planes.items()}
    for k, c in cases.items():
        print(f"  {c['label']:14s} stall {c['stall']:.2f}  cruise {c['drag_cruise']:.4f} N {c['power_cruise']:.2f} W "
              f"{c['endurance_cruise']:.1f} min  climb {c['climb_max']:.2f} m/s  L/D {c['ld_max']:.2f}", flush=True)
    # each plane's aerodynamics at each other plane's weight: "single@optimized"
    cross = {}
    for r in planes:
        for l in planes:
            if r != l:
                q = planes[r].at_mass(mass[l])
                q.label = f"{planes[r].label} aerodynamics at the {planes[l].label.lower()} weight"
                cross[f"{r}@{l}"] = fly(q, t0)

    sweep, per10 = {}, {}
    for key, plane in planes.items():
        rows = []
        for m in MASSES:
            r = fly(plane.at_mass(float(m)), t0, curves=False)
            rows.append({k: r[k] for k in ("mass", "stall", "power_cruise", "endurance_cruise", "endurance_max",
                                           "climb_max", "ld_max", "sink_min", "turn_radius_sustained", "top",
                                           "range_max")})
        sweep[key] = rows
        fit = lambda k: np.polyfit([r["mass"] for r in rows], [r[k] for r in rows], 1)[0] * 10  # noqa: E731
        per10[key] = {k: round(float(fit(k)), 3) for k in ("stall", "power_cruise", "endurance_cruise",
                                                            "endurance_max", "climb_max", "ld_max", "sink_min")}
    # how heavy plane r could get before it needs plane l's cruise power: what its drag saving is worth in weight
    break_even = {}
    for r in planes:
        for l in planes:
            if r == l or cases[r]["power_cruise"] >= cases[l]["power_cruise"]:
                continue
            # no heavier than the weight that still flies 13 m/s with room above the stall
            lo = mass[r]
            hi = RHO * planes[r].s * planes[r].clmax * (V_CRUISE / 1.05) ** 2 / (2 * G) * 1000
            for _ in range(30):
                mid = (lo + hi) / 2
                if fly(planes[r].at_mass(mid), t0, curves=False)["power_cruise"] < cases[l]["power_cruise"]:
                    lo = mid
                else:
                    hi = mid
            break_even[f"{r}<{l}"] = round((lo + hi) / 2, 1)
    stall_limit = AF.BASE.stall_limit
    max_mass = {k: round(RHO * p.s * p.clmax * stall_limit ** 2 / (2 * G) * 1000, 1) for k, p in planes.items()}

    parts = {k: {m["name"]: m for m in specs[k]["mass"]} for k in planes}
    names = sorted(set().union(*parts.values()), key=lambda n: -max(parts[k].get(n, {}).get("g", 0) for k in planes))
    mass_rows = [{"name": n, "g": {k: parts[k].get(n, {}).get("g", 0.0) for k in planes},
                  "x": {k: parts[k].get(n, {}).get("x") for k in planes}} for n in names]
    keys = ("x_le", "cg_x", "battery_x", "np_x", "pod_len", "length", "x_stab", "printed", "stall", "loading",
            "airfoil", "details", "layout", "span", "chord", "c_tip", "mac", "aspect_ratio", "area_dm2", "taper",
            "washout", "panels", "spar", "boom_tube", "c_h", "b_h", "fin_h", "y_break", "tube_len")
    out = {
        "generated": time.strftime("%Y-%m-%d"), "n_crit": study["n_crit"], "cruise_v": V_CRUISE,
        "thrust_static_n": round(t0, 3), "v_pitch": round(planes["baseline"].v_pitch, 2), "stall_limit": stall_limit,
        "order": list(planes),
        "variants": {k: {**{kk: specs[k].get(kk) for kk in keys}, "auw": mass[k], "label": planes[k].label,
                         **({"tail_arm_mm": planes[k].d.tail_arm, "stretch": planes[k].d.stretch}
                            if k == "extreme" else {})}
                     for k in planes},
        "mass": mass_rows, "cases": cases, "cross": cross, "sweep": sweep, "per10g": per10,
        "break_even": break_even, "max_mass_for_stall": max_mass,
        "battery_wh": AF.KIT.batt_wh, "usable": USABLE,
    }
    OUT.mkdir(parents=True, exist_ok=True)
    (OUT / "compare.json").write_text(json.dumps(out, separators=(",", ":")))
    (OUT / "COMPARE.md").write_text(report(out))
    print(f"wrote airframe/variants/compare.json and COMPARE.md in {time.time() - t0_clock:.0f} s")


ROWS = [("Weight, g", "mass", "{:.1f}"), ("Wing loading, g/dm²", "loading", "{:.1f}"),
        ("Maximum lift (3D)", "clmax", "{:.3f}"), ("Stall, m/s", "stall", "{:.2f}"),
        ("Drag at 13 m/s, N", "drag_cruise", "{:.3f}"), ("Power at 13 m/s, W", "power_cruise", "{:.2f}"),
        ("Current at 13 m/s, A", "current_cruise", "{:.2f}"), ("Flight time at 13 m/s, min", "endurance_cruise", "{:.1f}"),
        ("Distance at 13 m/s, km", "range_cruise", "{:.1f}"), ("Longest flight, min", "endurance_max", "{:.1f}"),
        ("... at, m/s", "v_power_min", "{:.1f}"), ("Furthest flight, km", "range_max", "{:.1f}"),
        ("... at, m/s", "v_range_max", "{:.1f}"), ("Best glide ratio", "ld_max", "{:.2f}"),
        ("... at, m/s", "v_ld_max", "{:.1f}"), ("Least sink, motor off, m/s", "sink_min", "{:.3f}"),
        ("Best climb, m/s", "climb_max", "{:.2f}"), ("Top speed, m/s", "top", "{:.1f}"),
        ("Tightest level turn at 13 m/s, bank °", "turn_bank_stall", "{:.1f}"),
        ("... radius, m", "turn_radius_stall", "{:.2f}")]


def report(o: dict) -> str:
    v, c, order = o["variants"], o["cases"], o["order"]
    lab = {k: v[k]["label"] for k in order}
    L = ["# Kipinä: four CAD builds compared", "",
         "Generated by `aero/variants.py` from the four CAD builds (`airframe/viewer/spec.json` and "
         "`airframe/variants/{optimized,single-boom,extreme}/viewer/spec.json`). Do not edit by hand.", "",
         "## The designs", "",
         "| | " + " | ".join(lab[k] for k in order) + " |", "|---|" + "---|" * len(order),
         "| Layout | " + " | ".join("one carbon boom, motor behind the tail" if v[k].get("layout") == "single"
                                    else "twin booms, motor behind the pod" for k in order) + " |",
         "| Airfoil | " + " | ".join(str(v[k]["airfoil"]) for k in order) + " |",
         "| Wing | " + " | ".join(
             f"{v[k]['span']:.0f} mm span, {v[k]['chord']:.0f} mm chord" if (v[k].get("panels") or 1) == 1 else
             f"{v[k]['span']:.0f} mm span, {v[k]['chord']:.0f} mm root to {v[k]['c_tip']:.0f} mm tip, "
             f"{v[k]['washout']:g}° washout" for k in order) + " |",
         "| Wing area, aspect ratio | " + " | ".join(
             f"{v[k]['area_dm2']:.2f} dm², {(v[k].get('aspect_ratio') or v[k]['span'] / v[k]['chord']):.1f}"
             for k in order) + " |",
         "| Details | " + " | ".join(", ".join(f"{d} {x:g}" if not isinstance(x, bool) else d
                                              for d, x in (v[k]["details"] or {}).items() if x) or "none"
                                    for k in order) + " |",
         "| Weight (CAD) | " + " | ".join(f"{v[k]['auw']:.1f} g" for k in order) + " |",
         "| Printed parts | " + " | ".join(f"{v[k]['printed']} g" for k in order) + " |",
         "| Wing leading edge from the nose (balanced) | " + " | ".join(f"{v[k]['x_le']} mm" for k in order) + " |",
         "| CG | " + " | ".join(f"{v[k]['cg_x']} mm" for k in order) + " |", "",
         "## Where the weight changed", "",
         "Parts that differ between the builds, grams.", "",
         "| part | " + " | ".join(lab[k] for k in order) + " |", "|---|" + "---|" * len(order)]
    for m in o["mass"]:
        g = [m["g"][k] for k in order]
        if max(g) - min(g) >= 0.05:
            L.append(f"| {m['name']} | " + " | ".join(f"{x:.1f}" if x else "–" for x in g) + " |")
    L += ["", "## How they fly", "",
          f"Thrust: the same motor and prop, {o['thrust_static_n']:.2f} N static (1:1 for the as-built plane), "
          f"falling to zero at the {o['v_pitch']:.1f} m/s pitch speed.", "",
          "| | " + " | ".join(lab[k] for k in order) + " |", "|---|" + "---|" * len(order)]
    for label, k, f in ROWS:
        if any(c[x].get(k) is None for x in order):
            continue
        L.append(f"| {label} | " + " | ".join(f.format(c[x][k]) for x in order) + " |")
    for l, r in (("baseline", "optimized"), ("optimized", "single"), ("baseline", "single"), ("single", "extreme")):
        a, b, m = c[l], o["cross"][f"{r}@{l}"], c[r]
        L += ["", f"### {lab[r]} against {lab[l].lower()}: aerodynamics and weight", "",
              f"The middle column is the {lab[r].lower()} plane's aerodynamics at the {lab[l].lower()} weight "
              f"({v[l]['auw']:.1f} g against {v[r]['auw']:.1f} g).", "",
              f"| | {lab[l]} | {lab[r]}: its aerodynamics, {lab[l].lower()} weight | {lab[r]} | change | of which aerodynamics | of which weight |",
              "|---|---|---|---|---|---|---|"]
        for label, k, f in ROWS:
            if a.get(k) is None or m.get(k) is None or b.get(k) is None:
                continue
            L.append(f"| {label} | {f.format(a[k])} | {f.format(b[k])} | {f.format(m[k])} | {m[k] - a[k]:+.3g} | "
                     f"{b[k] - a[k]:+.3g} | {m[k] - b[k]:+.3g} |")
    p10 = o["per10g"]
    L += ["", "## Every 10 g", "", "| per +10 g | " + " | ".join(lab[k] for k in order) + " |", "|---|" + "---|" * len(order)]
    for k, name in (("stall", "stall, m/s"), ("power_cruise", "power at 13 m/s, W"), ("endurance_cruise", "flight time at 13 m/s, min"),
                    ("endurance_max", "longest flight, min"), ("climb_max", "best climb, m/s"), ("ld_max", "best glide ratio"),
                    ("sink_min", "least sink, m/s")):
        L.append(f"| {name} | " + " | ".join(f"{p10[x][k]:+.3f}" for x in order) + " |")
    L += [""]
    for key, m in o["break_even"].items():
        r, l = key.split("<")
        L.append(f"- The {lab[r].lower()} plane could weigh {m:.0f} g ({m - v[r]['auw']:+.0f} g on its CAD weight) before it "
                 f"needs as much power at 13 m/s as the {lab[l].lower()} one.")
    L += ["", f"The {o['stall_limit']} m/s stall limit allows " +
          ", ".join(f"{o['max_mass_for_stall'][k]:.0f} g {lab[k].lower()}" for k in order) + ".",
          "", "The tightest level turn at 13 m/s is set by the stall (the maximum lift), not by the motor, "
          "which has thrust to spare at that bank.", ""]
    return "\n".join(L)


if __name__ == "__main__":
    main()
