henriharmaala1-source/Assembly-grapher/airframe/tools/a1mini.ini

# Approximation of a Bambu Lab A1 mini for PrusaSlicer time estimates (not an official profile).
# Speeds and accelerations follow the Bambu "Standard 0.20 mm" process for PLA/PETG.
bed_shape = 0x0,180x0,180x180,0x180
max_print_height = 180
nozzle_diameter = 0.4
filament_diameter = 1.75
layer_height = 0.2
first_layer_height = 0.2
gcode_flavor = marlin2
machine_limits_usage = time_estimate_only
machine_max_acceleration_extruding = 10000
machine_max_acceleration_travel = 10000
machine_max_acceleration_x = 10000
machine_max_acceleration_y = 10000
machine_max_feedrate_x = 500
machine_max_feedrate_y = 500
machine_max_feedrate_z = 30
machine_max_jerk_x = 9
machine_max_jerk_y = 9
perimeter_speed = 300
external_perimeter_speed = 200
infill_speed = 270
solid_infill_speed = 250
top_solid_infill_speed = 200
travel_speed = 500
first_layer_speed = 50
bridge_speed = 50
gap_fill_speed = 250
perimeter_acceleration = 5000
external_perimeter_acceleration = 5000
infill_acceleration = 10000
default_acceleration = 10000
travel_acceleration = 10000
first_layer_acceleration = 500
