henriharmaala1-source/Assembly-grapher/(commit log)

2026-06-12 Cleanup: remove Assembly-grapher refs, trim BOM, fix pipeline and power diagram
2026-09-28 Add Kipinä 400: parametric 3D-printed twin-tube FPV fixed wing
    Molniya-style layout for hobby FPV: two plain 6 mm tubes carry the pod,
    a straight 400 mm NACA 4412 wing and an H-tail. No payload bay.
    - design.py: parameters, NACA section, tail sizing from volume
    coefficients, mass/CG model and a span sweep that picks the smallest
    span stalling under 9 m/s (390 mm; built at 400 mm)
    - build.py: CadQuery model of all 12 printed parts, CAD-volume masses,
    battery station for the CG, print-oriented STLs, STEP assembly, GLB
    and REPORT.md
    - viewer/: three.js viewer with specs, sizing chart and balance strip
    - tools/render.mjs: preview PNGs via headless Chromium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
    [aileron_L.stl, aileron_R.stl, airframe.step, elevator.stl, fin_L.stl, fin_R.stl, lid.stl, pod.stl]
2026-09-28 Kipinä 430: SG90 servos and full electronics in the assembly
    - Model SG90 servos (tabs, gear boss, spline, horns), 1404 motor, 4x2.5
    prop, nano camera, VTX + whip, 20x20 FC, ELRS receiver, ESC, 2S pack
    with XT30, control horns and pushrods (components.py)
    - Aileron SG90s lie in pockets under the panels with the tabs between
    the spars (rear spar moved to 70 % chord); elevator SG90 lies in a
    rear pod bay with its horn up
    - Re-size for 27 g of servos: smallest span passing the 9 m/s stall
    and servo-fit checks is 420 mm, built at 430 mm (~175 g)
    - Balance the wing station on CAD masses; interference check on
    every build (no overlaps)
    - STEP grouped into printed / hardware / electron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
    [aileron_L.stl, aileron_R.stl, airframe.step, elevator.stl, fin_L.stl, fin_R.stl, lid.stl, pod.stl]
2026-09-28 Fit every part on a Bambu Lab A1 mini; document electronics specs
    - Params.bed (default 180x180x180, A1 mini): the wing centre widens to
    80 mm so the panels stand 175 mm tall; the build checks every part
    against the build volume and REPORT.md lists the result
    - Report cruise / full-throttle current and the 1:1 thrust target
    - README: electronics spec table with requirements, A1 mini plate plan
    and LW-PLA starting settings
    Claude-Session: https://claude.ai/code/session_01VTcHBPQk54N4vWFkgkuVEf
    [aileron_L.stl, aileron_R.stl, airframe.step, elevator.stl, fin_L.stl, fin_R.stl, lid.stl, pod.stl]
2026-09-28 Kipinä 450: yaw control with twin rudders on a fourth SG90
    - Rudder on each fin, aft of the elevator hinge line, with a horn tab
    below it; elevator tips inset so the rudders can swing
    - Rudder SG90 lies in the wing centre, raised into a small fairing so its
    horn clears the elevator servo and pushrod in the pod
    - Pushrod to a printed 90 degree bellcrank on an M2 pivot under the tail
    mount; two wire joiners drive both rudders together
    - Re-size: analytic sweep minimum 440 mm, built at 450 mm; CAD weights
    confirm 8.96 m/s stall. Analytic model no longer double-counts the
    centre section and is calibrated to the CAD
    - Stabiliser span capped at the printer bed (chord widened instead);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
    [aileron_L.stl, aileron_R.stl, airframe.step, bellcrank.stl, elevator.stl, fin_L.stl, fin_R.stl, lid.stl]
2026-09-28 Bill of process, assembly animation and DFMA analysis
    - process.py: 31 operations (5 print jobs, 8 prep, 16 assembly, 2 setup)
    with precedence, tools, consumables and times; list-scheduled on one
    printer and one builder (lead time 8 h 51 min, prints on the critical
    path); writes BOP.md with a mermaid precedence graph
    - Print times from PrusaSlicer 2.7 on an A1-mini-like profile
    (tools/a1mini.ini, cached in tools/slice_cache.json): 7 h 22 min, 72 g
    - DFMA.md: Boothroyd-Dewhurst worksheet (53 parts, theoretical minimum
    26, 33 min, design efficiency 4 % / 19 % handling+insertion only),
    eight costed redesign suggestions, DFM of every print (overhang and
    bridge detection from the ST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
    [a1mini.ini, process.py]
2026-09-28 Add the assembly animation video (66 s, 14 steps, from the viewer)
    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
2026-09-28 Clarify material cost: filament per airframe vs first-build spools
    The printed airframe, wing sections included, uses 72 g of filament
    (about 3 EUR). Report that separately from the spools a first build has
    to buy (about 65 EUR, 209 EUR first-build outlay), and add a cut through
    the printed wing STLs showing the NACA 4412 shells.
    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
2026-09-28 Add a top-speed estimate from a drag build-up
    design.py: parasite drag area built from the geometry (wing, tail plates,
    blunt pod front, skin friction, servo bumps; +15 % interference) plus
    induced drag, against prop thrust falling from the 1:1 static target to
    zero at the loaded pitch speed (1404 3800 KV, 4x2.5, 2S). Result: about
    18 m/s (66 km/h) level; pitch speed 86 km/h. Shown in REPORT.md, the
    viewer and the README.
    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
    [airframe.step]
2026-09-28 Round the pod's front edges to cut drag
    The flat, sharp-edged pod front was the largest single drag item (~35 %).
    Params.nose_r (8 mm) now rounds the two vertical front edges and blends
    the 45 deg belly chamfer into the front face with the same radius, so
    the pod still prints upright without supports. The front tube sleeves
    get domed noses and the motor plate 1.5 mm edge fillets; nose_r = 0
    restores the square front.
    The drag build-up ties the pod front Cd to the edge radius (0.5 sharp,
    0.25 at r/d >= 0.2): CdA 20.3 -> 17.3 cm^2, estimated top speed 66 -> 68
    km/h. Interference check and stall sizing still pass. Pod slices 3 min
    longer and 0.5 g lighter; overhang area unchanged.
    Also adds a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
    [aileron_L.stl, aileron_R.stl, airframe.step, bellcrank.stl, elevator.stl, lid.stl, pod.stl, rudder_L.stl]
2026-09-29 Detailed part models; Matek F405-WMN and Hobbywing XRotor Micro 30A
    components.py: every bought part is now a detailed solid. SG90 with case
    seams, label recess, rounded tabs, lead grommet, wires and a horn with a
    rounded tip and screw; 1404 motor with base holes, copper stator, vented
    bell and hex nut; a twisted, cambered 4x2.5 prop lofted through ten
    stations; threaded nano camera with PCB; VTX card with MMCX socket; ELRS
    receiver; whip with plug and coax; battery with label recess, keyed XT30
    and JST-XH plug. New: Matek F405-WMN (31 x 26 mm, 22 mm holes; F405, IMU,
    baro, OSD, flash, inductors, capacitors, USB-C, DFU, JST-SH, underside
    pads) and Hobbywing XRotor Micro 30A (23.8 x 14.5 x 5.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
    [aileron_L.stl, aileron_R.stl, airframe.step, bellcrank.stl, elevator.stl, fin_L.stl, fin_R.stl, lid.stl]
2026-09-29 Document the camera-through-prop issue and the nose-pylon fallback
    The FPV camera is 18 mm from the prop axis, inside the disc. Record the
    estimated blockage, why a pusher does not fit this layout, and the pylon
    option with its cost, resonance and trim implications.
    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
2026-09-29 Add an exterior 3D model of the Patria TRACKX
    trackx/build.py builds the tracked carrier at full scale in CadQuery from
    its published dimensions and layout: about 7.2 x 2.95 x 2.0 m, 56 cm
    tracks, 55 cm belly clearance, front sprocket, rear idler, six dual road
    wheels and two return rollers a side, cab forward behind a raked
    windscreen, two crew doors, a rear door hinged left, commander's roof
    hatch. Exterior only; the weapon station and interior are left off.
    Details the sources do not give (windscreen rake, bonnet height, door and
    hatch sizes, wheel diameters) are estimates and the README says so.
    Outputs: 21-body STEP assembly, GLB, full-size and 1:43 STL, previews,
    and an interactive th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
    [trackx.step, trackx_1to1.stl, trackx_1to43.stl]
2026-09-29 Rebuild the TRACKX model from reference photos
    The first pass came from published dimensions only and looked wrong next to
    the real vehicle. Using three photos (front on snow, rear at DSEI, front in
    a forest) the hull is now a narrow bonnet and cab between the tracks with a
    much wider troop box behind it, sloped upper sides, chamfered corners with
    the crew doors and rear lights, a low wide windscreen with three wipers, a
    louvred bonnet with a centre hatch, black bumper with wing plates,
    headlights, tow shackles, mirrors on outrigger frames, armour bolt rows,
    track guards, rear mud flaps, and dual road wheels with dished rims.
    Weapon station, jammer, antennas and interior stay off. README and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
    [trackx.step, trackx_1to1.stl, trackx_1to43.stl]
2026-09-29 Make the TRACKX track loop level, like in the photos
    The track top run sloped because the sprocket sat higher than the idler on
    smaller radii. In the photos the loop is level: a flat top run just under
    the hull, tall rounded ends, and smaller road wheels between. The front and
    rear wheels are now the same 470 mm inner radius on one axis height, the six
    dual road wheels are 330 mm, and the sprocket is a dual wheel with a toothed
    ring in the centre gap. Guards and mud flaps re-fitted; length is 7.16 m.
    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
    [trackx.step, trackx_1to1.stl, trackx_1to43.stl]
2026-09-29 Check the TRACKX against the reference photos and fix what differed
    Rendered the model from each photo's camera angle and compared side by side
    (new ?dir/fov/zoom/tx viewer parameters and match-* renders). Fixes:
    - upper hull full width over the tracks to the bumper; windscreen in its
    front face between long angled corners carrying the door windows; wider
    windscreen; outer front corners recede behind the bumper ends
    - wide glacis with louvres and latches, headlights in angular housings at its
    outer corners, lower black bumper whose ends drop and sweep back
    - rear corner blocks with big sloped tops, light clusters with the red lamp
    on the left, recessed rear door, curved rubber flaps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
    [trackx.step, trackx_1to1.stl, trackx_1to43.stl]
2026-09-29 Turn the airframe into a twin-boom pusher so the camera sees past the prop
    The two tubes are now tail booms, 140 mm apart, plugged into sockets under
    the wing centre. The motor is turned round on the pod's back wall and the
    4" prop turns between the booms, 16 mm inside each one, so the nose camera
    no longer looks through the prop disc.
    - Pod: camera in the nose, FC and battery ahead of the wing, ESC by the
    back wall. At about 272 mm it is too long for the A1 mini, so it prints
    in two halves joined by an 8 mm tongue. The lid runs from the nose to
    under the wing's leading edge.
    - Elevator and rudder servos move into the wing centre, one each side of
    the pod. Their pushrods run along t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
    [aileron_L.stl, aileron_R.stl, airframe.step, bellcrank.stl, elevator.stl, fin_L.stl, fin_R.stl, lid.stl]
2026-09-29 Refresh the airframe previews and assembly video for the pusher
    Re-rendered stills (the ESC view now looks in from the front, past the
    open pod top) and the assembly video; report text for the lid and tail
    mount print notes.
    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
    [airframe.step]
2026-09-29 Update the airframe viewer's static span text to 485 mm
    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
2026-09-29 Add a simple air-resistance optimizer for the airframe and the TRACKX
    aero/ holds a handbook drag build-up (dragkit.py: skin friction and form
    factors, rounded-edge forebody drag, base drag, wires and strips across
    the flow), one model per project and a small optimizer. The optimizer
    ranks single design changes, then runs a coordinate search over all free
    parameters within each design's limits, and writes REPORT_<model>.md.
    - airframe: sizes through design.py, so span, aspect ratio and tail arm
    re-size and re-balance the plane. Its limits are the stall margin the
    build keeps, SG90 tab room, and the lid and rear pod half fitting the
    bed. The sizing is already optimal; the details give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
    [dragkit.py, model.py, optimize.py]
2026-09-29 Remove the TRACKX model from the project
    It was a test. The trackx/ folder (CAD code, STEP/GLB/STL, previews,
    viewer) and its drag model and report in aero/ are gone. The drag
    optimizer now serves the airframe only; asking for an unknown model gives
    a short error with the models that exist.
    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
    [trackx.step, trackx_1to1.stl, trackx_1to43.stl]
2026-09-29 Add a flight-time model for a typical 5-inch FPV quad to the optimizer
    aero/models/quad.py starts from an ordinary 6S freestyle build and builds
    it from parts. It works out the weight, the body drag at the cruise tilt,
    forward-flight rotor power (momentum theory with Glauert's inflow and
    profile power), motor, ESC and battery losses, and full-throttle thrust
    and currents from a motor model with pack sag.
    It rewards flight time at a relaxed cruise and nothing else: no speed,
    acceleration or payload objective, no top-speed estimate. Thrust-to-weight
    is held between 5 and 12 and all-up weight at or under 700 g, so the
    result stays an ordinary FPV quad. The optimum is a long-range 5-inch
    cruise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
    [model.py, optimize.py]
2026-09-29 Make the quad model an aerodynamic optimization
    The quad model now keeps the stock propulsion (2306 1750 KV, 5.1x4.3x3,
    6S 1100 mAh) and optimizes the airframe's aerodynamics:
    - body: open frame, canopy, or a full fairing;
    - battery on top or underneath;
    - arm width and thickness, within 80 % of the stock stiffness;
    - streamlined arm sleeves;
    - forward-tilted motor mounts;
    - the VTX antenna.
    It scores each version by the power needed for a steady 60 km/h cruise.
    That power covers body drag at the pitch the drag sets, the prop wash on
    the arms, and the weight of printed parts.
    At 60 km/h: 10 deg of motor tilt (body level), arm sleeves, 13 mm arms and
    a stubby antenna halve the drag area (9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
    [optimize.py]
2026-09-29 Add a 7-inch long-range quad at 100 km/h to the aero optimizer
    The quad model is now a class built from a Build (the stock parts,
    airframe dimensions and class limits). quad.py is the 5-inch freestyle
    quad at 60 km/h, as before. quad7.py is a typical 7-inch long-range quad
    at 100 km/h: 2806.5 1300 KV, 7x4x3 props, 6S 3000 mAh, a GPS on a mast,
    980 g.
    At 100 km/h the stock 7-inch pitches 47 deg nose down, with a drag area of
    217 cm2 and 648 W. A full fairing, sleeved arms, 15 mm arms, 15 deg of
    motor tilt and a stubby antenna let it fly about level: 57 cm2, 301 W,
    and 4.9 -> 10.6 min at that speed. At 60 km/h the same approach gives
    -10 %.
    Propulsion stays stock and only cruise power is sco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
2026-09-30 Add a NeuralFoil efficiency study with baseline-versus-optimized charts
    aero/efficiency.py optimizes the Kipinä wing section with NeuralFoil, an
    XFOIL-trained model. The shape is a Kulfan airfoil, optimized with SLSQP
    for three operating points at the plane's own lift coefficients and
    Reynolds numbers. The limits come from the build:
    - spar depth and aileron hinge depth;
    - the SG90 servo bump below the wing;
    - the 0.8 mm printable trailing edge;
    - maximum lift and a gentle stall;
    - pitching moment;
    - NeuralFoil's confidence.
    Started from four airfoils, it converges on the same shape: 18-25 % less
    profile drag than the NACA 4412, with the same maximum lift and a milder
    pitching moment.
    It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
    [airfoil.py, efficiency.py]
2026-09-30 Add cross-checks of the efficiency study against XFOIL, OpenFOAM and AeroSandbox
    aero/crosscheck.py runs the baseline and optimized wing sections through
    NeuralFoil's largest network and XFOIL 6.99 (aero/xfoil.py), and with --cfd
    through 2D OpenFOAM RANS with Langtry-Menter transition on a structured
    C-grid (aero/cfd.py). The whole plane goes through AeroSandbox AeroBuildup
    and a vortex lattice with Trefftz-plane induced drag. The study page gets a
    cross-check section with the results side by side.
    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
2026-09-30 Average the CFD forces over snapshots and let the CFD resume
    Laminar bubbles and the blunt trailing edge keep the steady solution moving,
    so each run now writes a snapshot every 50 iterations and averages the forces
    and surface pressure over the last 1000. --resume carries on with the cases
    already in --work.
    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
2026-09-30 Run XFOIL's probe runs in a temporary folder
    They left a stray :00.bl file wherever the cross-check was started.
    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
2026-09-30 Give the CFD a point-vortex far field
    A uniform free stream 20 chords out cuts off the wing's own upwash, turns the
    flow at the wing about 0.2 degrees and adds about cl x 0.0035 of drag. The
    far field now carries the velocity and pressure of a vortex at the quarter
    chord for the current lift, updated every 500 iterations.
    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
2026-09-30 Handle CFD angle pairs whose lift slope is lost in the flow's own swing
    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
2026-09-30 Compare the CFD sections at a common lift and show every CFD run against the polars
    The NACA 4412's trailing-edge flow keeps the CFD's lift swinging at these
    Reynolds numbers, so each point now compares the two sections at the same
    lift inside the range both runs reached, and the page plots every run, with
    its swing, against the NeuralFoil and XFOIL polars at that Reynolds number.
    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
2026-09-30 Build the optimized Kipinä in CAD and compare its weight and flight
    build.py --variant optimized draws the efficiency study's airfoil and every
    detail change the drag optimizer picks as printable parts: an 8 mm hood on
    the pod's top front edge, a 30 mm tapered pod tail (ESC moved forward),
    the VTX whip laid back 60°, four servo fairings and two joiner sleeves.
    It writes variants/optimized/ (STLs, GLB, REPORT.md); the STEP is optional
    with --step. The as-built plane is unchanged.
    aero/variants.py flies both CAD builds at their own weights (223.2 g and
    225.8 g), plus the optimized aerodynamics at the as-built weight, to split
    each change into aerodynamics and weight. It also sweeps the weig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
    [aileron_L.stl, aileron_R.stl, bellcrank.stl, elevator.stl, fairing_ail_L.stl, fairing_ail_R.stl, fairing_elev.stl, fairing_rud.stl]
2026-10-06 Add a single-boom Kipinä in CAD, with the fuselage section and boom sized
    build.py --variant single-boom rebuilds the optimized plane round one carbon
    tube. It writes variants/single-boom/:
    - a 10 x 9 mm roll-wrapped boom from a socket behind the servo bay to a coned
    motor mount behind the tail;
    - the elevator and rudder servos inside the fuselage, their pushrods in PTFE
    sleeves inside the boom;
    - one fin in a socket on the tail mount, and the stabiliser hung on
    wedge-nosed pylons so the elevator swings past the boom;
    - a narrower wing centre with no sockets.
    The interference check passes and every part fits the A1 mini.
    aero/section.py finds the fuselage section that holds the con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
    [aileron_L.stl, aileron_R.stl, elevator.stl, fairing_ail_L.stl, fairing_ail_R.stl, fin.stl, fuselage_front.stl, fuselage_rear.stl]
2026-10-08 Add Mark4 V2 10" frame drawings taken from its STEP model
    frames/mark4-v2-10/build.py reads the frame's STEP assembly, cuts each flat
    part through its thickness and writes the profile exactly as modelled: one
    DXF per part in the assembly's coordinates, dimensioned A4 sheets with hole
    tables, and holes.csv. Countersunk parts are cut on their plain face so the
    holes come out at their through size.
    CHECK.md checks the eight M3 x 35 mm standoffs against the hole on each axis
    in every plate and arm copy. All line up within 0.07 mm, and the top and lower
    plates within 0.03 mm. It also lists model quirks: a 443.8 mm wheelbase
    against RJX's 427, an off-centre rear 30.5 mm pattern, and Ø2.8 counter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
    [arm.dxf, arm_brace.dxf, assembly_top.dxf, belly_plate.dxf, cam_plate.dxf, chin_plate.dxf, holes.csv, lower_plate.dxf]
2026-10-08 Mark4 V2 10: plain trace images of every part with two scaling dimensions
    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
2026-10-09 Mark4 V2 10: start overall-dimension extension lines at each part's farthest points
    The lines ran from the bounding box's corners, so on plates whose ends are
    pointed or rounded they stopped short of the part and looked like they
    measured something shorter. The values are unchanged.
    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
    [arm.dxf, arm_brace.dxf, assembly_top.dxf, belly_plate.dxf, cam_plate.dxf, chin_plate.dxf, lower_plate.dxf, tail_plate.dxf]
2026-10-09 Mark4 V2 10: printable stand-ins for the standoffs, screws and press nuts
    Plain parts, no threads: Ø6 x 35 standoff tubes, Ø2.7 pins with the real
    screws' heads and lengths, flanged rings for the press nuts, and a fit gauge
    for tuning the press fit. hardware/assembly.step places all 46 in the frame;
    none cuts into a frame part.
    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
    [assembly.step, fit_gauge.step, fit_gauge.stl, nut.step, nut.stl, pin_cap_m3x12.step, pin_cap_m3x12.stl, pin_cap_m3x18.step]
2026-10-09 Mark4 V2 10 hardware: cap-head pins at the chin and tail plates by default
    The DXFs and trace images carry only the Ø2.8 through-hole there, so plates
    drawn from them have no countersink. --countersunk restores the countersunk
    pins for plates countersunk as in the STEP.
    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
    [assembly.step, fit_gauge.step, nut.step, pin_cap_m3x10.step, pin_cap_m3x10.stl, pin_cap_m3x18.step, pin_cap_m3x6.step, pin_cap_m3x8.step]
2026-10-10 Single-boom Kipinä: bill of process, DFMA, viewer and previews
    process.py --variant single-boom slices the single boom's parts and writes
    its BOP.md, DFMA.md and viewer/process.json. The operations live in
    process_single.py: tail servos into the fuselage, tail glued up behind the
    plane and slid onto the prepared boom, motor cap on the boom's end, boom
    into the fuselage socket, wing onto the flat top. The twin's outputs
    regenerate unchanged.
    tools/make_single_viewer.py derives the variant's viewer, with the Assemble
    animation, from the twin's page. render.mjs takes --variant and renders the
    previews.
    Claude-Session: https://claude.ai/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
2026-10-10 Single-boom Kipinä: assembly video
    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
2026-10-11 Single boom: fix the wiring paths and model the harness
    - Wing centre: spanwise channel at the aileron lead slot plus drops at
    y +-9 so the aileron leads clear the tail cone and boom.
    - Fuselage and boom: motor-wire entry hole behind the ESC.
    - Harness modelled as wire runs (aileron, elevator, rudder, motor, power);
    interference check passes with them; REPORT.md gains a wiring table.
    - Bill of process: new F4 (extend aileron leads ~55 mm), A11/A16 split
    the soldering, BOUGHT adds extension wire. DFMA and viewer regenerated.
    - Viewer: wiring view and button; previews re-rendered (wiring.png).
    Claude-Session: https://claude.ai/code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
2026-10-11 Single boom: re-record the assembly video with the wiring steps
    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
2026-10-11 Kipinä extreme aero: a 700 mm tapered, twisted wing for the best glide
    - aero/extreme.py: design study over span, root chord, taper and tail arm.
    Lifting line (checked against an AeroSandbox vortex lattice), NeuralFoil
    strip profile drag, the single boom's drag build-up on each layout, CAD-
    calibrated weights, spar and boom stiffness, balance with a fuselage
    stretch, printability. Picks 700 mm, 86 -> 69 mm, 3 deg washout, 260 mm
    tail arm, 5x4 spar tube (aero/study/EXTREME.md).
    - design.py: tapered two-panel wings (root_chord, taper, washout, panels),
    mean-chord tail sizing and CG, spar tubes, fuselage bay stretch.
    - build.py --variant extreme: lofted, twisted outer panels about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
2026-10-11 Extreme aero: remaining preview renders (tail, motor, wiring, wing)
    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
2026-10-23 Kipinä 1:2 desk model: mini.py and its viewer page
    mini.py builds the single boom with its walls, trailing edges, boom sleeve
    and fairing shells thickened for half scale (wing and battery where the
    full-size plane has them), scales it, re-drills the boom and spar holes for
    stock rods, turns the bought parts into printed dummies trimmed to clear
    their pockets, and adds a display stand. build_at can now take a fixed
    battery station.
    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
2026-10-25 Fix printed-part overlaps; desk model with printed rods and real fits
    Full size:
    - build.py now checks printed parts against each other, not only bought parts.
    - That found three overlaps, now fixed:
    - the single-boom rudder ran 16 mm3 into the motor cap's cone (notched round it);
    - the aileron servo fairings ran 12.6 mm3 into the wing centre's flat underside (cut clear of it);
    - the twin's lid corners ran 3.3 mm3 into the pod's rounded nose (rounded to match).
    - The tail mount's collar wall is a parameter (collar_wall), unchanged at 1.2 mm.
    Desk model (mini.py):
    - The boom and spars are printed: the spars as thick as the wing allows and in two halves for the bed, the boom filling its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
2026-10-25 Rebuild all four variants after the overlap fixes
    Every report's interference check now covers printed parts against each other:
    no overlaps in any variant. The wing moves 0.1 mm on the optimized and
    single-boom planes (the notched rudder and trimmed fairings weigh less).
    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
2026-10-25 Desk model: slice the printed rods solid (rectilinear), fit test's real time
    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
2026-10-25 Desk model: regenerated with printed rods, re-cut fits and the fit test
    36 files on the A1 mini, 10 h 35 min and 116 g of PLA. No overlaps between
    any two bodies, printed parts against each other included; the thinnest wall
    round a rod hole is 0.80 mm; every part fills at least 98 % of its volume
    sliced solid.
    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
2026-10-27 Research notes: Mark4-style 10-inch frames with 8 mm arms (in progress)
    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
2026-10-27 Research notes: other 10-inch frames with 8 mm arms
    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
2026-10-27 Research notes: MK4 Knight 10-inch frame (in progress)
    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
2026-10-27 Report: MK4 Knight 10-inch frame (CADDX Knight 10 V2)
    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
2026-10-27 Remove the MK4 frame research reports and notes
    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
2026-11-02 Modified Mark4 arm: dimensioned sketch and DXF from measured distances
    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
2026-11-02 Modified arm sketch: motor bolt slots 5 mm end to end
    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
2026-11-02 Modified arm sketch: inner-end tab, 18 mm past the straight edge, 7.5 mm tip
    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
2026-11-02 Modified arm sketch: keep the stock Mark4 profile, arm shortened 11 mm, widths 11 and 11.5
    The stock tip, bump and inner end (with its notch) are kept; the straight
    section is shortened so the notch tip lands 18 mm past the bump-side straight
    edge. End holes sit where measured; one leaves 0.35 mm of material on the
    stock outline, flagged on the sketch.
    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
2026-11-02 Modified arm sketch: notch rebuilt from its edges (10 / 7.5 / 4), bump 20.5 across
    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
2026-11-02 Remove the modified arm sketch from the repo
    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
